acappon/DIY-MiniAirboat/IdeasForOrganization/00_PitchDeck.pptx

MISSION OVERVIEW

•

High-Performance Everglades Workboat

JON-AIR rev8: Built for Everglades Night Hunting

3.5s Hole Shot & Water-Level Eye Line

Low engine placement unlocks visibility under overhanging sawgrass banks where pythons nest.

165 HP ROTAX 850 E-TEC

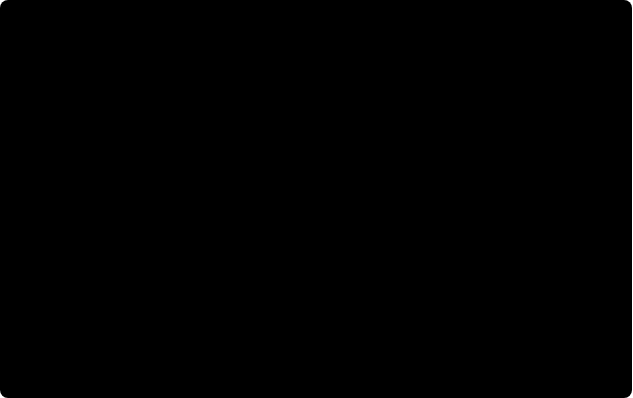
[picture p5: figure]
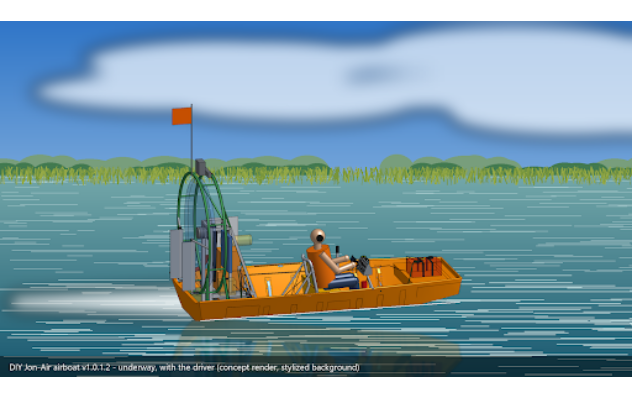
[picture p6: figure]

Full Armor UHMW Plastic Bottom for Zero-Stick Sliding

Ergonomic Helm Control Box

Integrated lanyard kill switch, searchlight joystick, USB charging, and dual temperature/gas gauges.

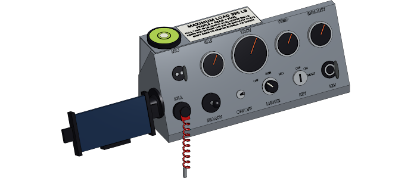
[picture p7: figure]

## Slide 2

The Collaborative Build Model & Economics

By pooling sweat equity and buying materials directly, builders acquire military-grade workboats at half retail cost.

COOPERATIVE MODEL

~$16K

MATERIAL COST / HULL

~200 hrs

DIY BUILD LABOR

GoFundMe

OVERHEAD SUBSIDIES

$35K+

COMMERCIAL VALUE

Equity Through Efficiency

Volunteers and founders combine baseline hardware purchasing with ~200 DIY build hours. No commercial manufacturer markups or corporate margins.

Pooled Overhead Protection

GoFundMe proceeds absorb legal entity formation, D&O governance protection, and workshop Commercial General Liability (CGL) insurance policies.

## Slide 3

Build Origin: Starting with a Used 1448 Jonboat Hull

Baseline Aluminum Shell

Purchased used to keep initial capital low before stripping for stringer and armor integration.

STEP 01 FABRICATION

Target Outcome: rev8 Airboat

Adding 6061 aluminum stringers, Rotax 850 engine stand, stick steering, and UHMW armor bottom.

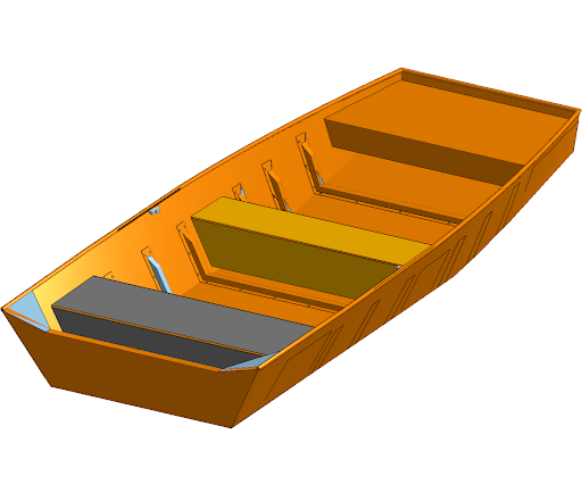
[picture p8: figure]
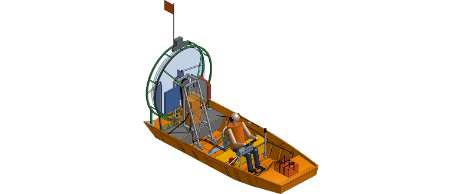
[picture p9: figure]

## Slide 4

Tracking Labor & Money: Guaranteed Returns

Fixed-estimate task valuations guarantee fair title allocation or Batch 2 credit rollover.

MASTER LEDGER SYSTEM

Top-Down Layout Blueprint

Internal stringer grid & tank placement driving task estimates.

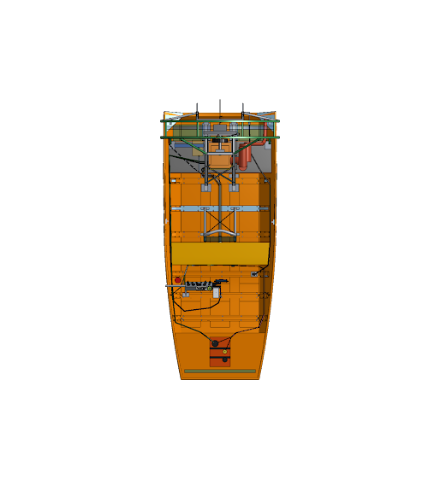
[picture p10: figure]

1. Fixed-Estimate Task Valuation

Build hours are pre-set by task complexity (e.g., 50 hrs for stringer welding). Fast completion is rewarded; slow work yields zero extra credit.

2. Full Vessel Ownership vs. Rollover

Anchor builders (~200 DIY hrs + material deposit) receive refined production hulls (#2, #3, #4). Micro-contributors roll credits into Batch 2 or gear/fleet days.

3. Outsource Option

Participants may satisfy any task module by submitting receipts for approved professional vendor work.

## Slide 5

JOIN THE INITIATIVE

Help Build the Everglades Fleet

Sign the Operating Agreement, claim a shop build slot, or back the GoFundMe campaign to fund baseline hardware.

Join Build Crew

Back GoFundMe

## Slide 6

Questions?

Jon-Air rev8 Enterprise LLC

Everglades Invasive Species Management & Python Hunting Cooperative Build Program
