acappon/DIY-MiniAirboat/IdeasForOrganization/02_PilotOrganizationProspectus.pdf

# JON-AIR (REV8) COST & UTILITY PROSPECTUS

## Investment Analysis, Workboat Performance, and Sweat-Equity Return

## EQUITY THROUGH EFFICIENCY

By shifting from commercial turn-key manufacturing to a self-assembled cooperative build, participants unlock a

high-performance, purpose-built Everglades workboat at direct cost—combining ~200 fixed DIY labor hours with

baseline material funding.

### 1. INDIVIDUAL & SHARED UNIT ECONOMICS

COST / RESOURCE
COMPONENT

PER-BOAT
ESTIMATE

DESCRIPTION & ALLOCATIONS

### Raw Materials & Hardware

~$16,000

1448 aluminum Jonboat hull, Rotax 850 E-TEC powerplant, UHMW bottom plating, rigging, controls, and aluminum stringers.

### DIY Labor Commitment

~200 Hours

Fixed-estimate hours allocated across structural welding, hull plating, engine rigging, and electrical wiring.

### Fixed LLC Overhead

Pooled
Overhead

Shared legal formation, D&O entity protection, shop Commercial General Liability (CGL) insurance, and state filings.

### Turn-Key Market Equivalent

$35,000+

Commercial custom airboats of equal power and plating carry heavy markup and lack python-specific low-CG ergonomics.

### 2. WHAT YOUR INVESTMENT DELIVERS: PERFORMANCE & UTILITY

Low⁻Center⁻of-Gravity Line⁻of-Sight

Mounting the Rotax 850 engine low and utilizing a

straddle bench places the hunter’s eye line near water

level. This delivers unmatched visibility under bank

overhangs and dense sawgrass canopy where pythons

hide.

UHMW Armor & 117° Hard Chine

Continuous plastic bottom plating slides effortlessly

over sawgrass, mud flats, and cypress knees without

sticking. The 117-degree hard chine delivers razor-

sharp tracking through tight marsh tracks.

3.5s Hole Shot & High Speed

The 165 HP-class Rotax 850 E-TEC provides an

immediate ~3.5-second hole shot to get on plane

instantly in shallow water, with top speeds exceeding

30 mph for fast transit between priority search zones.

Silent Drift & Oar Ergonomics

Equipped with integrated heavy-duty oar locks,

allowing hunters to shut down the engine and silently

drift stealth corridors without spooking skittish

wildlife along riverbanks.

### 3. RETURN ON SWEAT EQUITY

Every logged build hour converts into direct equity credit based on pre-established task values. Builders earn

ownership of a military-grade, purpose-built Everglades workboat at roughly half the retail market cost, backed by

a clear cooperative framework.

Jon-Air rev8 — Cost, Utility & Pilot Prospectus | Page 1 of 2

# THE PILOT BATCH & FOUNDER LOGIC

## GoFundMe Defrayment Model, Prototype Allocation, and Intellectual Credit

### 4. THE PILOT PROJECT & GOFUNDME FUNDING STRATEGY

To launch the initial Pilot Batch, the LLC initiates a public GoFundMe drive alongside volunteer recruitment. The

GoFundMe campaign serves a critical financial role for the founding cohort:

Defraying Cohort Material Costs

Crowdfunded capital directly offsets the baseline

~$16K material cost for the pilot cohort, lowering the

out-of-pocket cash threshold required from early

builders and volunteers.

Funding Fixed Overhead & Insurance

GoFundMe proceeds absorb necessary entity setup

costs, legal review expenses, and workshop liability

insurance policies, keeping individual contributions

focused on hardware.

### 5. FOUNDER EQUITY & PROTOTYPE ALLOCATION RULES

The original founder supplies the core intellectual property, vessel design, operational methodology, and fundraising

leadership. The LLC Operating Agreement recognizes these contributions through explicit structural rules:

PARTICIPANT ROLE | CONTRIBUTION FOCUS | VESSEL & CREDIT ALLOCATION TERMS

### Original Founder & Campaign Runner

| Concept, CAD design, LLC
| architecture, GoFundMe
| fundraising effort | Receives credit for IP, organization, and capital raised (even
| | with reduced cash or zero DIY labor hours). Allocated Boat
#1 (The Prototype) upon batch completion.

### Anchor Builders (Pilot Cohort)

| Material funding balance + 200
| DIY task hours per hull | Receive fully refined production hulls (#2, #3, #4) coming
| | off the finalized batch line once all prototype testing gates
| | pass.

### Micro-Contributors

| Partial labor hours or small cash
| donations | Earn Batch 2 queue deposits, gear payouts, or fleet time-
| | share credits (no direct title to pilot hulls).

### 6. THE PROTOTYPE ALLOCATION RATIONALE

## WHY THE FOUNDER TAKES THE PROTOTYPE (BOAT #1)

The first boat built serves as the testbed—enduring stress trials, modifications, bracket tweaks, and initial field

testing. Although it absorbs signficant design iteration (making it the "janky prototype"), the original founder takes

full ownership of Boat #1 upon final batch distribution. This ensures that the volunteer builders who perform the

200 DIY hours receive the fully refined, production-perfect hulls coming off the line afterward.

### 7. SUMMARY OF PILOT RIGHTS & PROTECTIONS

Fairness to Builders

Builders are protected: their labor produces polished,

proven production models while their financial entry

point is subsidized by GoFundMe campaign proceeds.

Fairness to Founder

The founder's vision, legal setup, design IP, and

fundraising drive earn full vessel equity without

requiring equal shop wrenching time.

Jon-Air rev8 — Cost, Utility & Pilot Prospectus | Page 2 of 2
