acappon/DIY-MiniAirboat/rev8_JonAirBoat/renderedImages/Minimal_800R_layout_v1.0.1.3.png

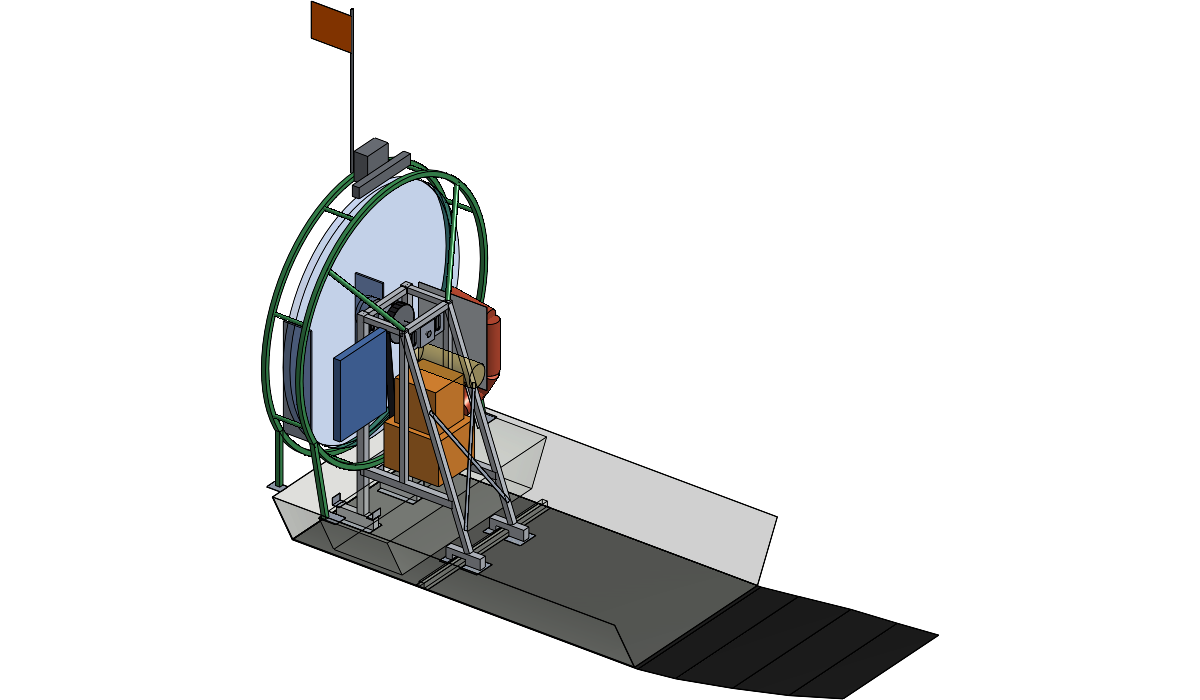
rev8_JonAirBoat/renderedImages/Minimal_800R_layout_v1.0.1.3.png
