acappon/DIY-MiniAirboat/rev8_JonAirBoat/renderedImages/Minimal_cockpit_v1.0.1.3.png

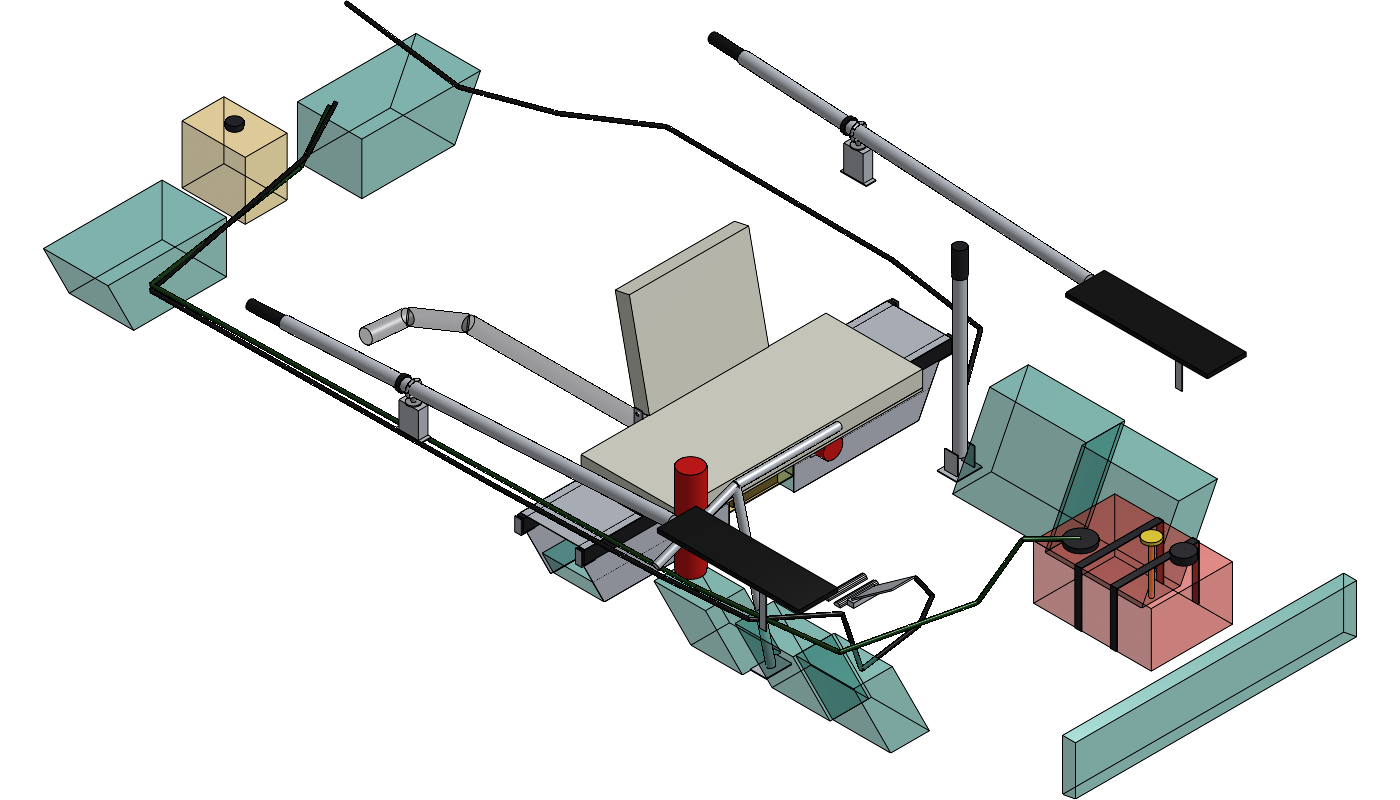
rev8_JonAirBoat/renderedImages/Minimal_cockpit_v1.0.1.3.png
