acappon/DIY-MiniAirboat/rev8_JonAirBoat/renderedImages/scenes/dock_rowing.png

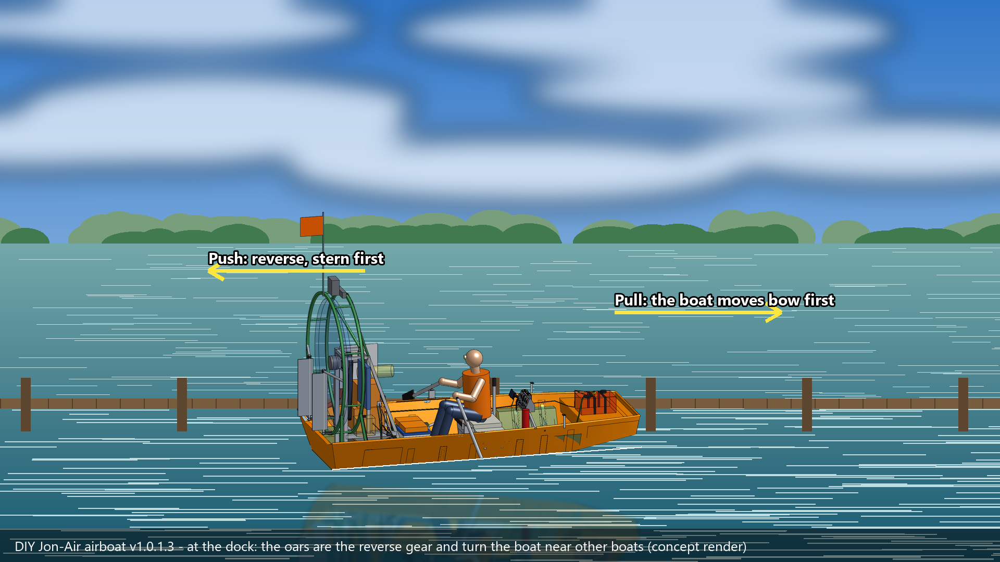
rev8_JonAirBoat/renderedImages/scenes/dock_rowing.png
