acappon/DIY-MiniAirboat/rev8_JonAirBoat/renderedImages/scenes/snake-hunt_rowing.png

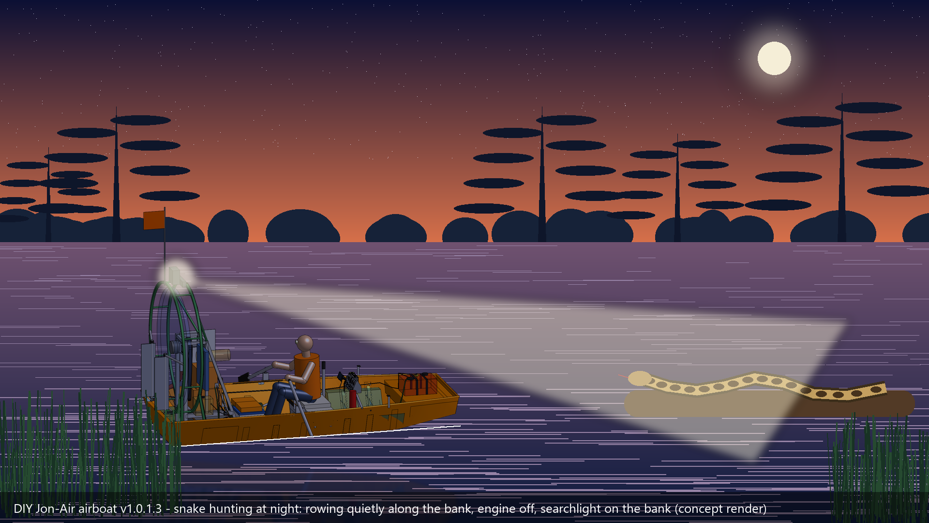
rev8_JonAirBoat/renderedImages/scenes/snake-hunt_rowing.png
