acappon/DIY-MiniAirboat/rev8_JonAirBoat/renderedImages/scenes/top-speed_solo.png

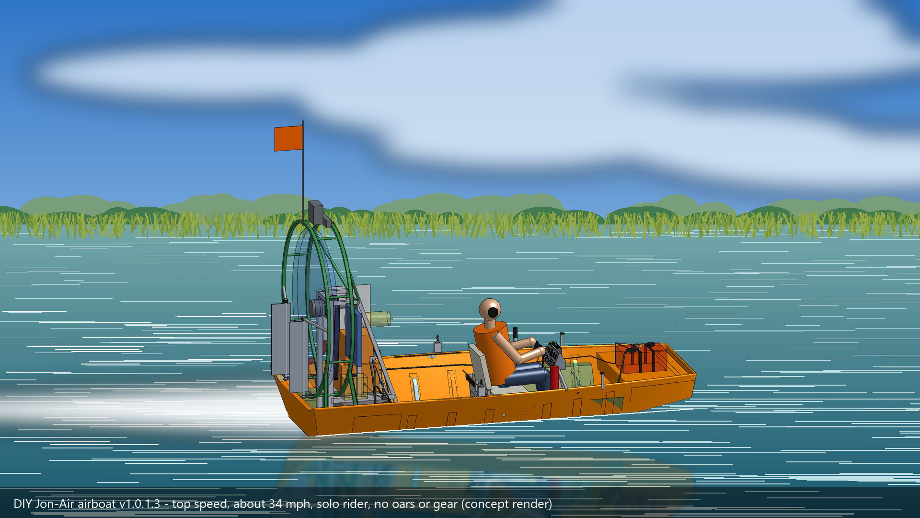
rev8_JonAirBoat/renderedImages/scenes/top-speed_solo.png
