acappon/DIY-MiniAirboat/rev8_JonAirBoat/renderedImages/scenes/underway-25mph_gear.png

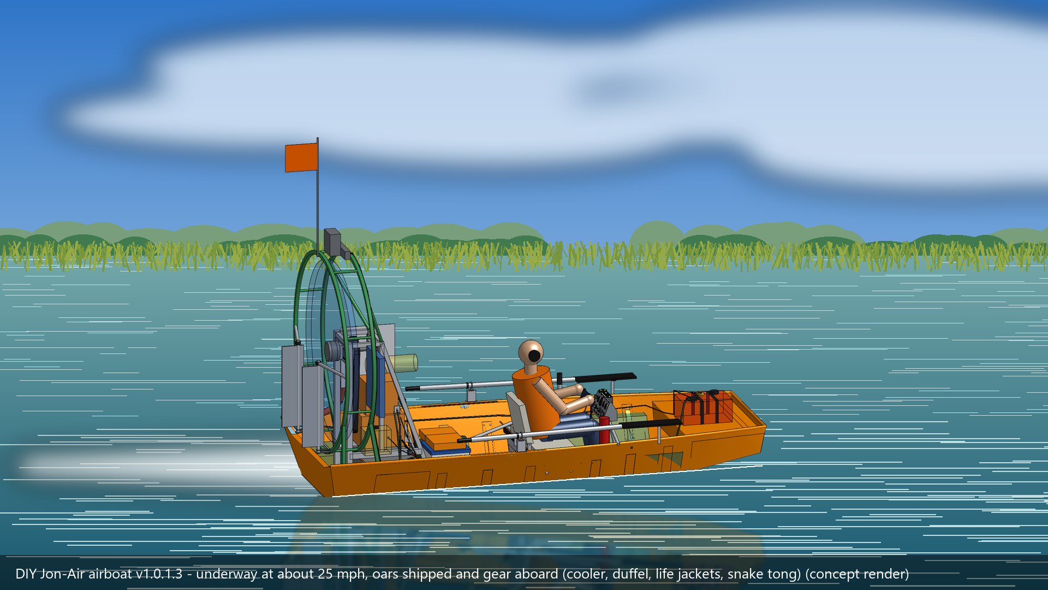
rev8_JonAirBoat/renderedImages/scenes/underway-25mph_gear.png
