acappon/DIY-MiniAirboat/rev8_JonAirBoat/renderedImages/studio/v1_front-starboard-3-4-view_no-crew.png

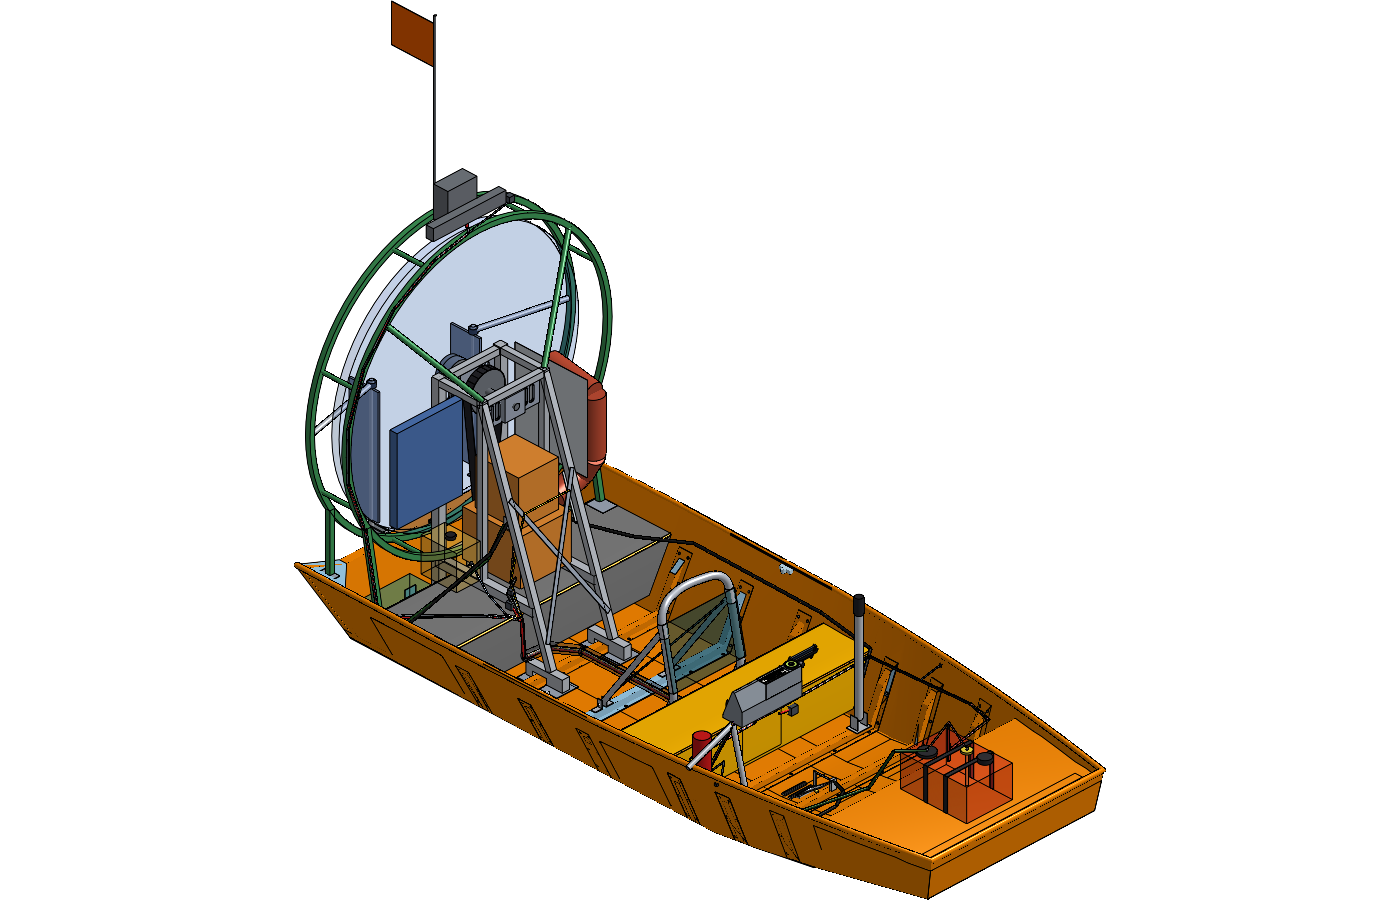
rev8_JonAirBoat/renderedImages/studio/v1_front-starboard-3-4-view_no-crew.png
