acappon/DIY-MiniAirboat/rev8_JonAirBoat/renderedImages/studio/v2_rear-port-3-4-view_no-crew.png

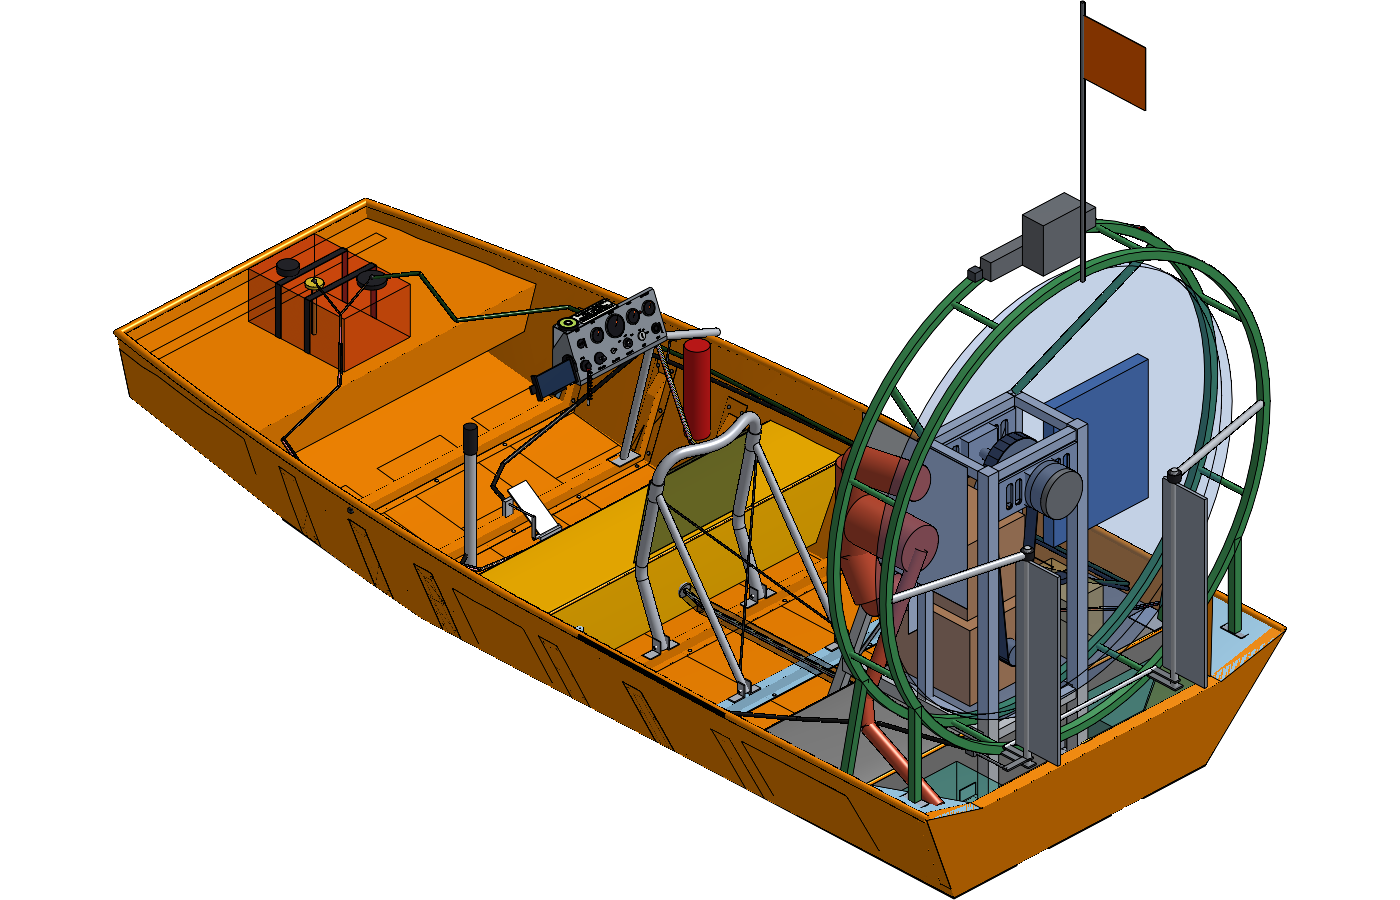
rev8_JonAirBoat/renderedImages/studio/v2_rear-port-3-4-view_no-crew.png
