acappon/DIY-MiniAirboat/rev8_JonAirBoat/renderedImages/studio/v3_starboard-profile_no-crew.png

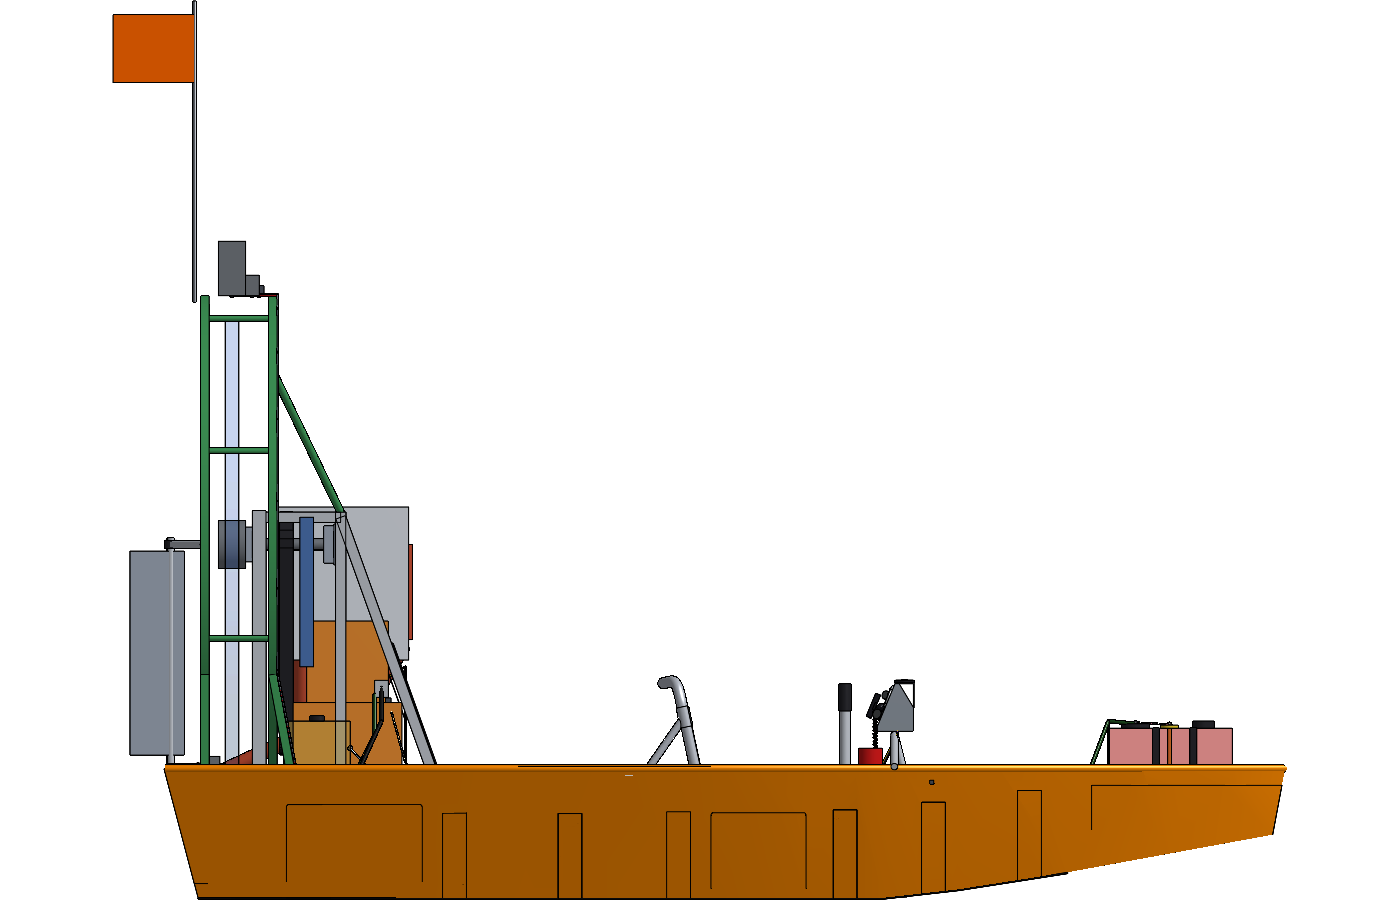
rev8_JonAirBoat/renderedImages/studio/v3_starboard-profile_no-crew.png
