acappon/DIY-MiniAirboat/rev8_JonAirBoat/renderedImages/studio/v4_top-view_no-crew.png

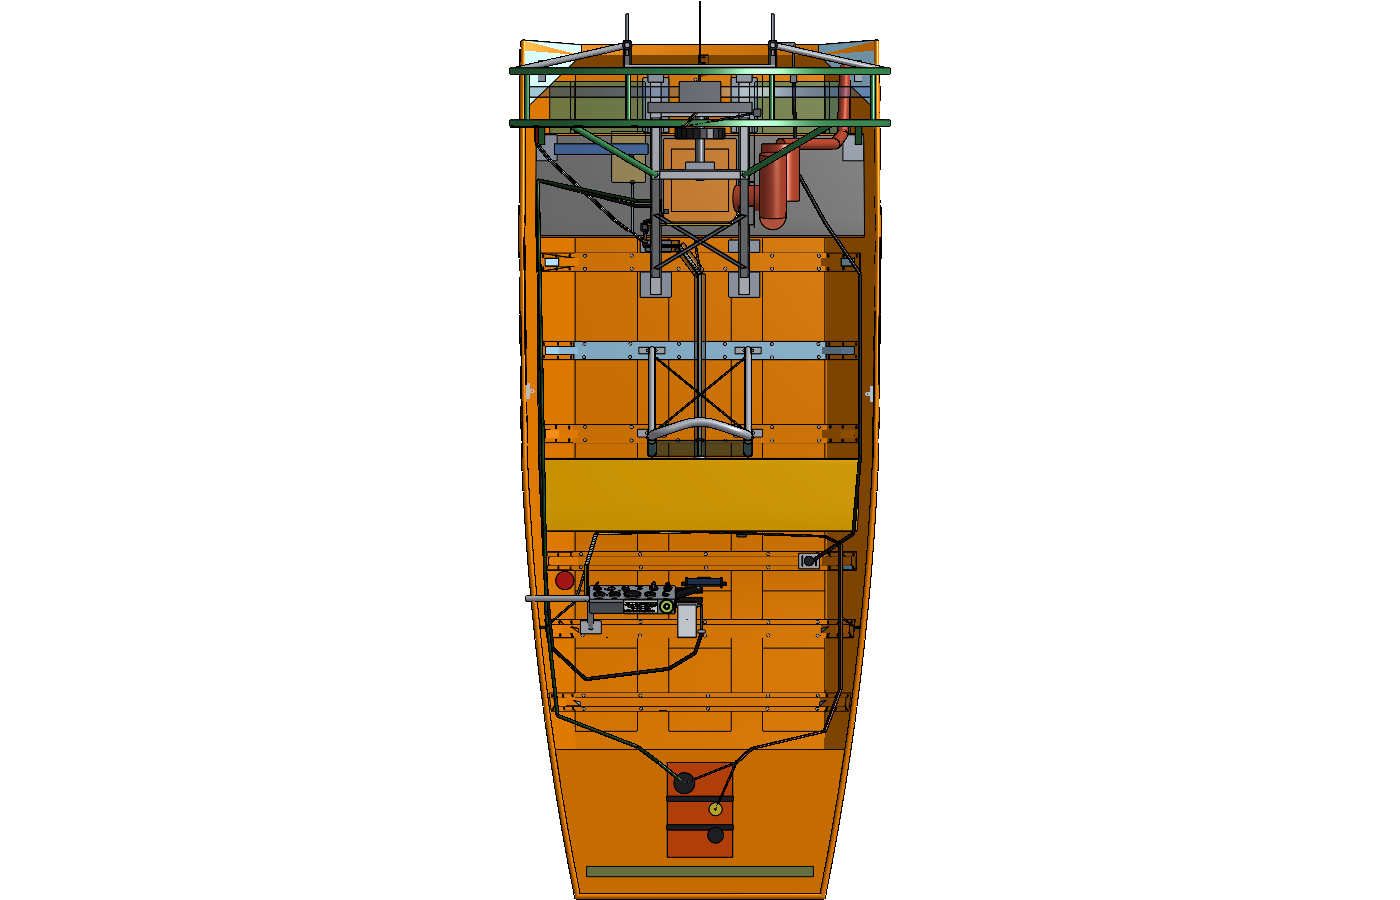
rev8_JonAirBoat/renderedImages/studio/v4_top-view_no-crew.png
