acappon/DIY-MiniAirboat/rev8_JonAirBoat/renderedImages/studio/v5_low-front-starboard-view_no-crew.png

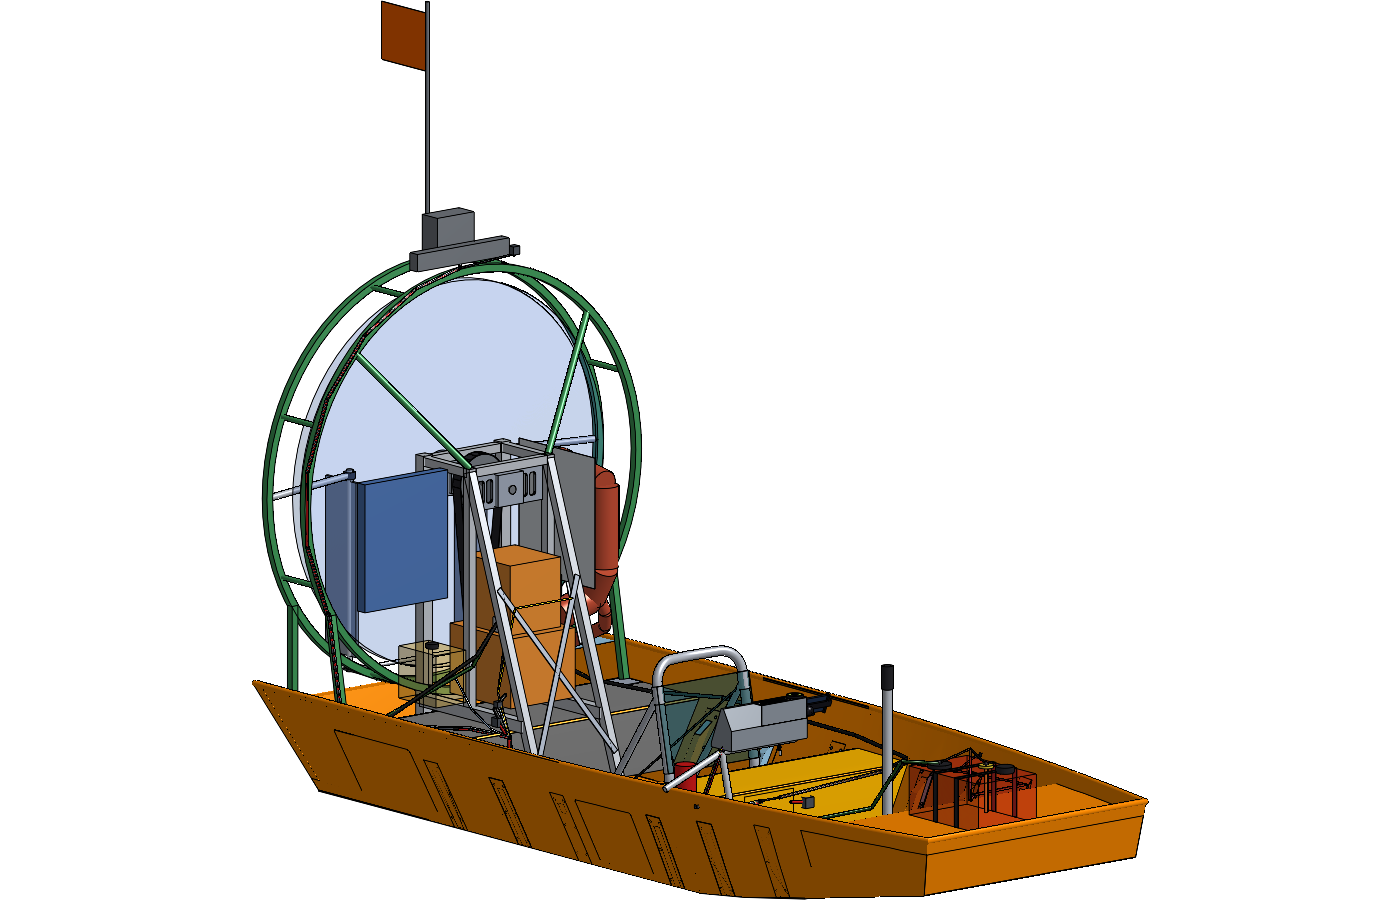
rev8_JonAirBoat/renderedImages/studio/v5_low-front-starboard-view_no-crew.png
