acappon/DIY-MiniAirboat/rev8_JonAirBoat/renderedImages/studio/v8_dash_driver-pov.png

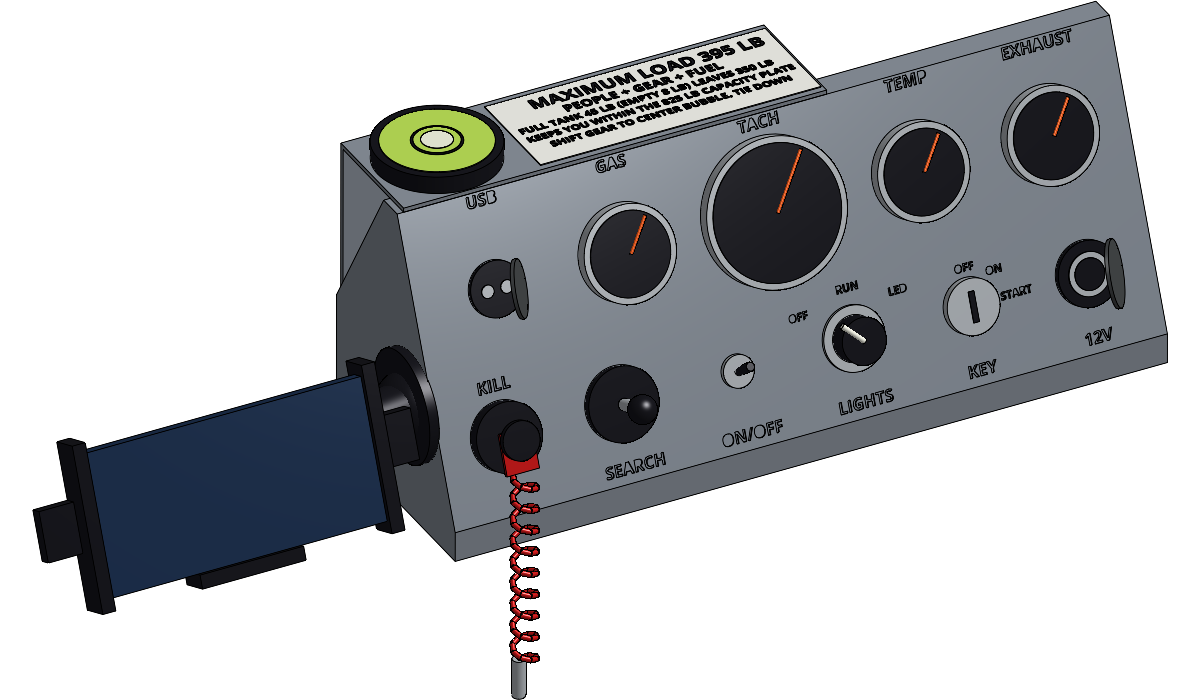
rev8_JonAirBoat/renderedImages/studio/v8_dash_driver-pov.png
