acappon/DIY-MiniAirboat/StraddleDart_rev7/Marketing/img/01.webp

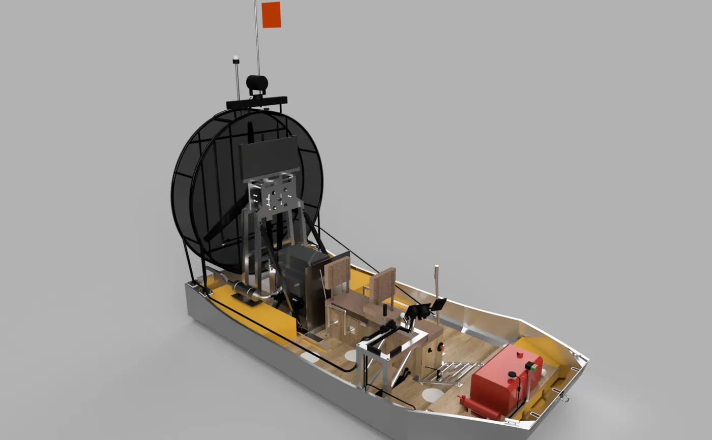
StraddleDart_rev7/Marketing/img/01.webp
