acappon/DIY-MiniAirboat/StraddleDart_rev7/Marketing/img/01_cutout.webp

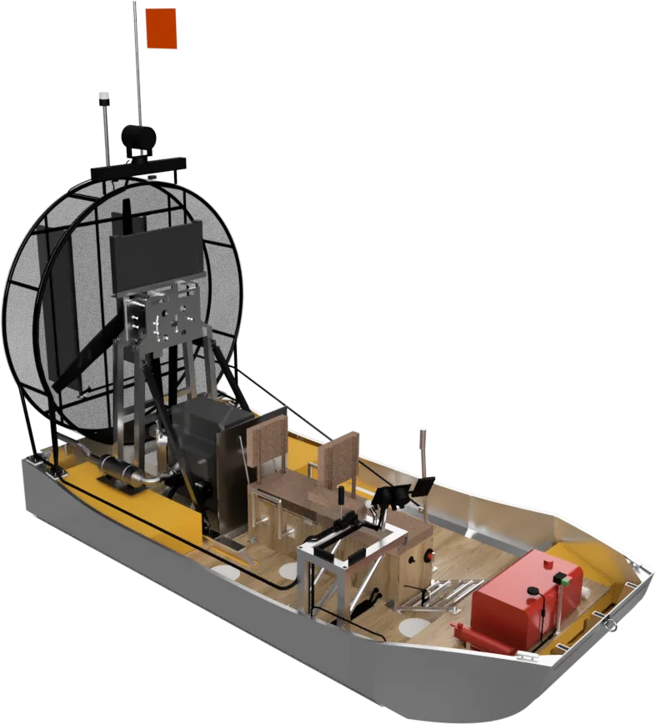
StraddleDart_rev7/Marketing/img/01_cutout.webp
