acappon/DIY-MiniAirboat/StraddleDart_rev7/Marketing/img/02.webp

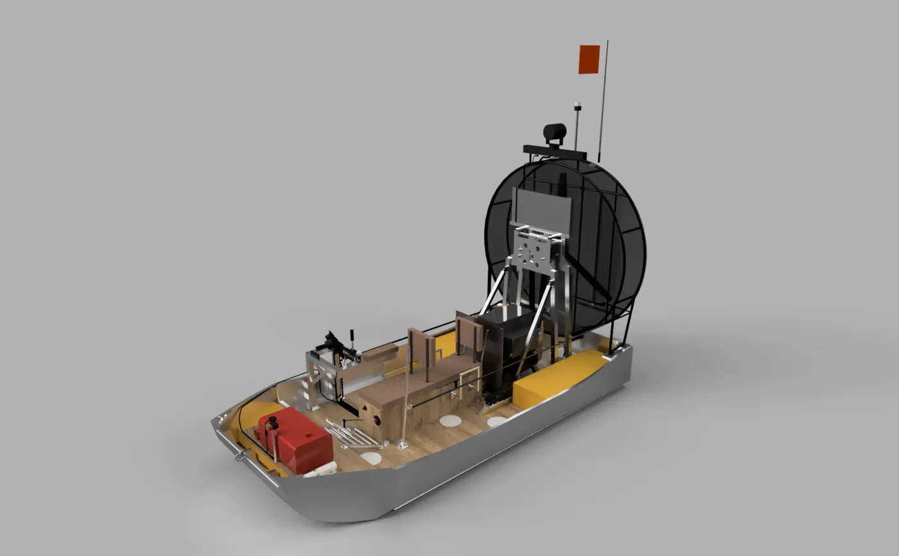
StraddleDart_rev7/Marketing/img/02.webp
