acappon/DIY-MiniAirboat/StraddleDart_rev7/Marketing/img/03.webp

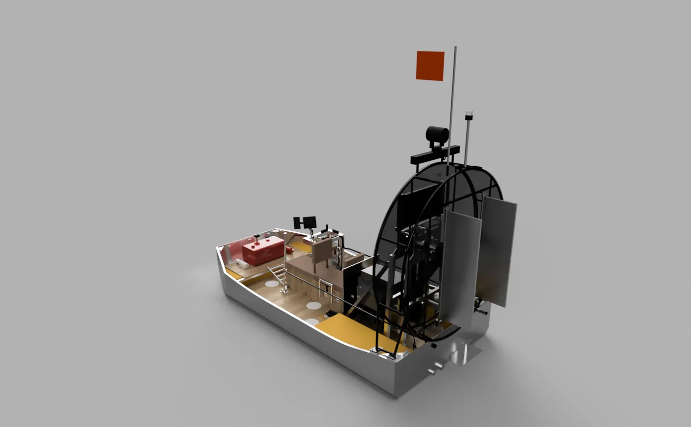
StraddleDart_rev7/Marketing/img/03.webp
