acappon/DIY-MiniAirboat/StraddleDart_rev7/Marketing/img/04.webp

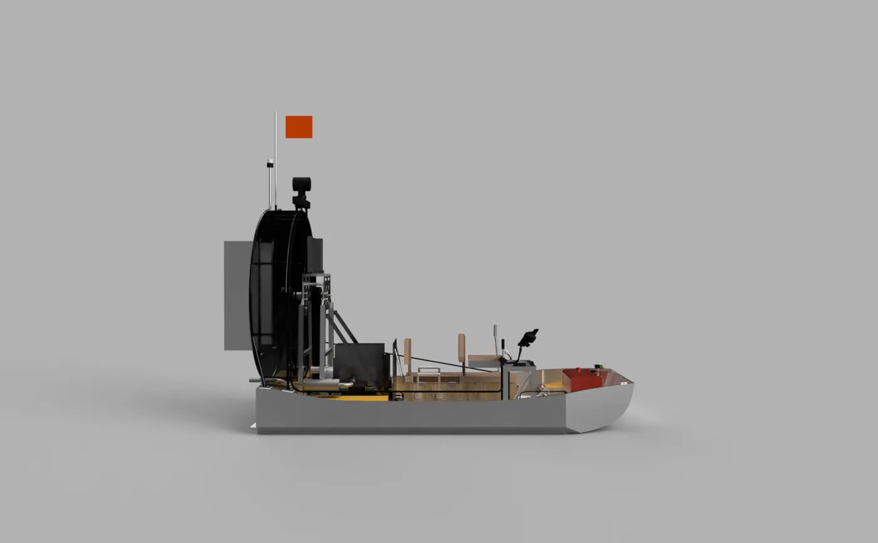
StraddleDart_rev7/Marketing/img/04.webp
