acappon/DIY-MiniAirboat/StraddleDart_rev7/Marketing/img/05.webp

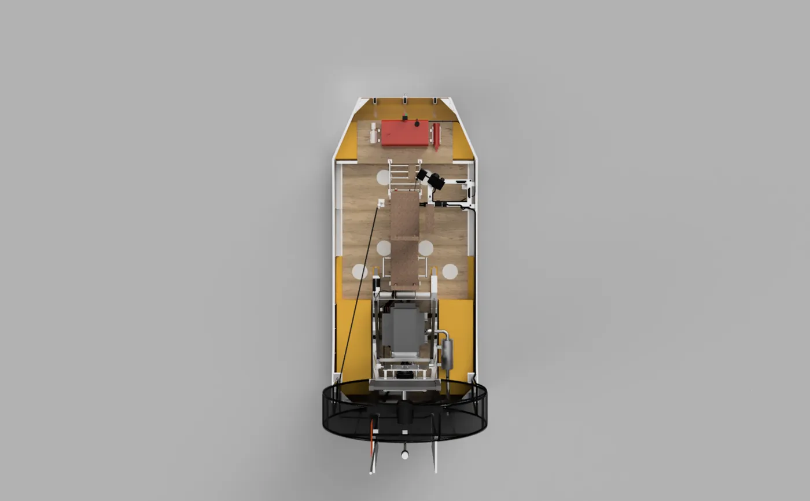
StraddleDart_rev7/Marketing/img/05.webp
