acappon/DIY-MiniAirboat/StraddleDart_rev7/Marketing/img/07.webp

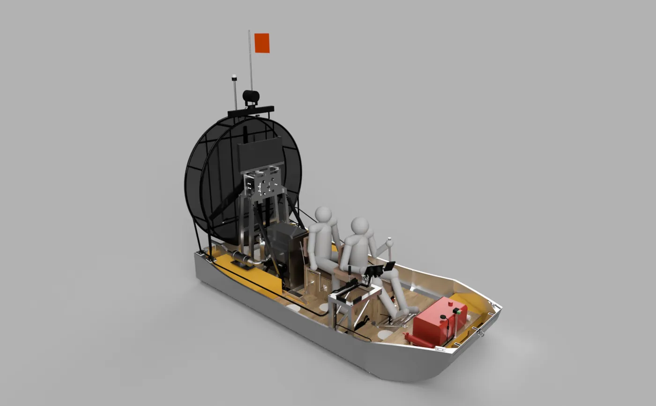
StraddleDart_rev7/Marketing/img/07.webp
