acappon/DIY-MiniAirboat/StraddleDart_rev7/Marketing/img/08.webp

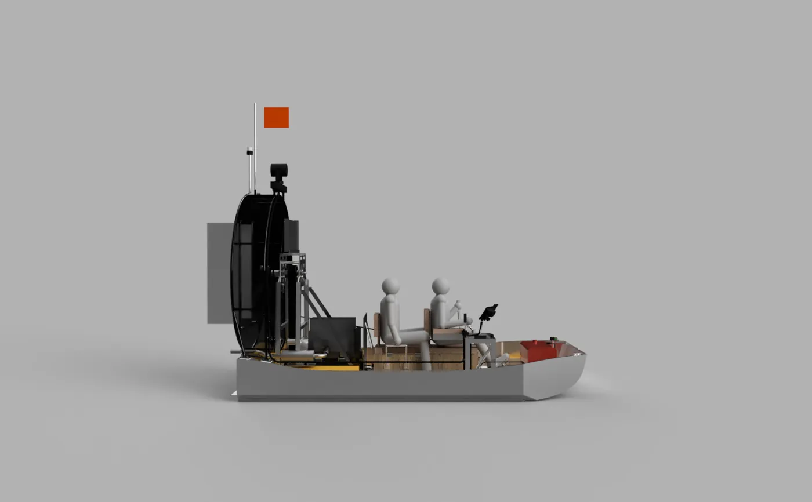
StraddleDart_rev7/Marketing/img/08.webp
