acappon/DIY-MiniAirboat/StraddleDart_rev7/Marketing/img/09.webp

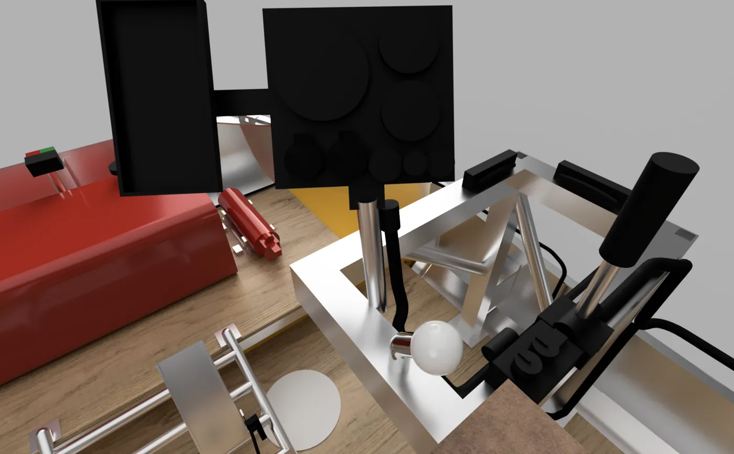
StraddleDart_rev7/Marketing/img/09.webp
