acappon/DIY-MiniAirboat/StraddleDart_rev7/Marketing/img/10.webp

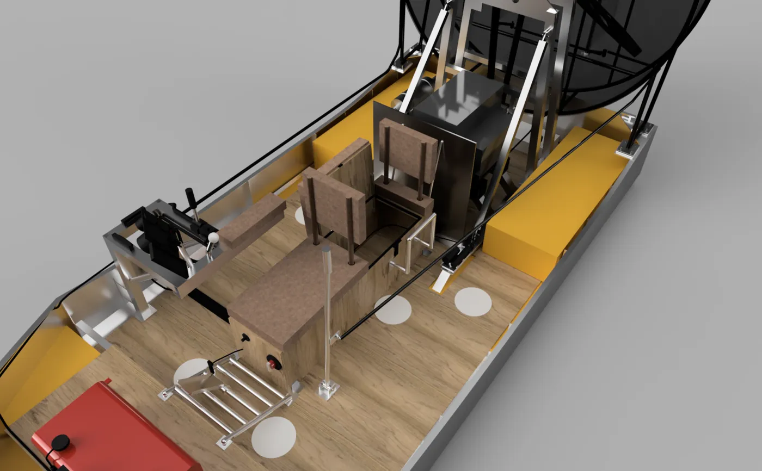
StraddleDart_rev7/Marketing/img/10.webp
