acappon/DIY-MiniAirboat/StraddleDart_rev7/Marketing/img/11.webp

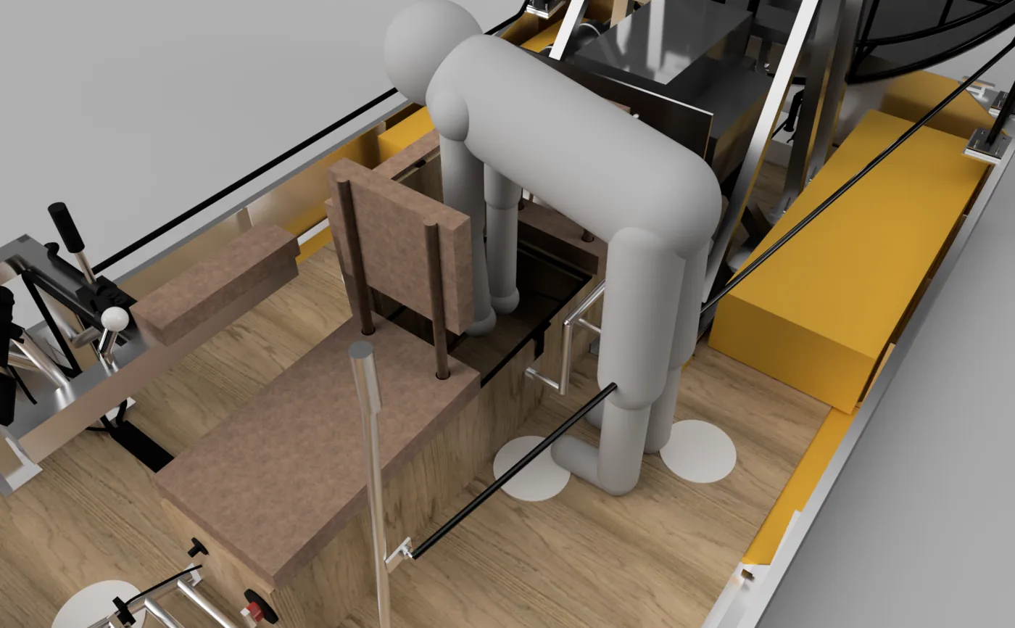
StraddleDart_rev7/Marketing/img/11.webp
