acappon/DIY-MiniAirboat/StraddleDart_rev7/Renders/photo/09_Driver_eye_view_grip_and_dash.png

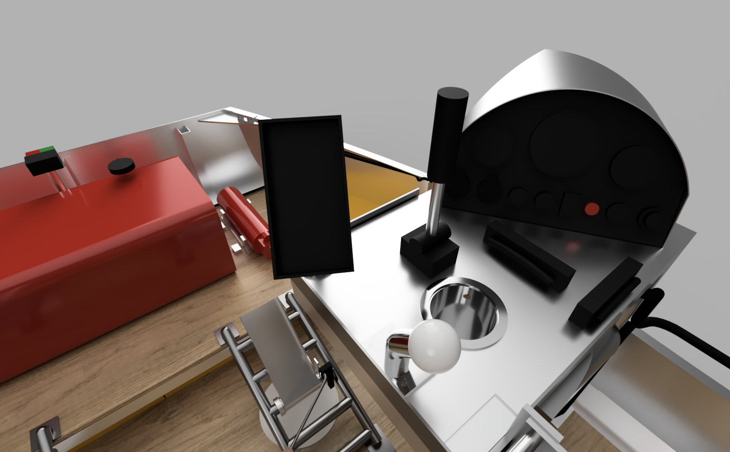
StraddleDart_rev7/Renders/photo/09_Driver_eye_view_grip_and_dash.png
