acappon/DIY-MiniAirboat/StraddleDart_rev7/Renders/photo/11_Cooler_open_reaching_in.png

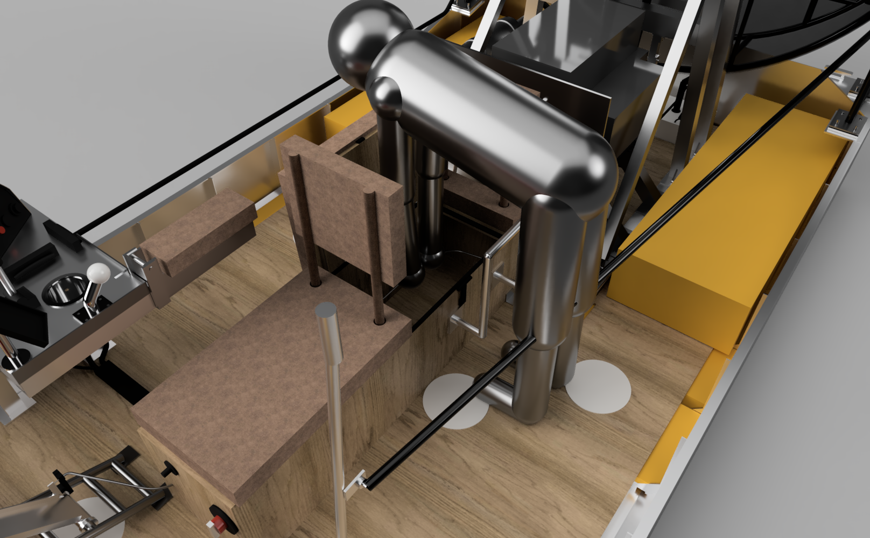
StraddleDart_rev7/Renders/photo/11_Cooler_open_reaching_in.png
