acappon/DIY-MiniAirboat/StraddleDart_rev7/Renders/previews/01_Front_34_starboard.png

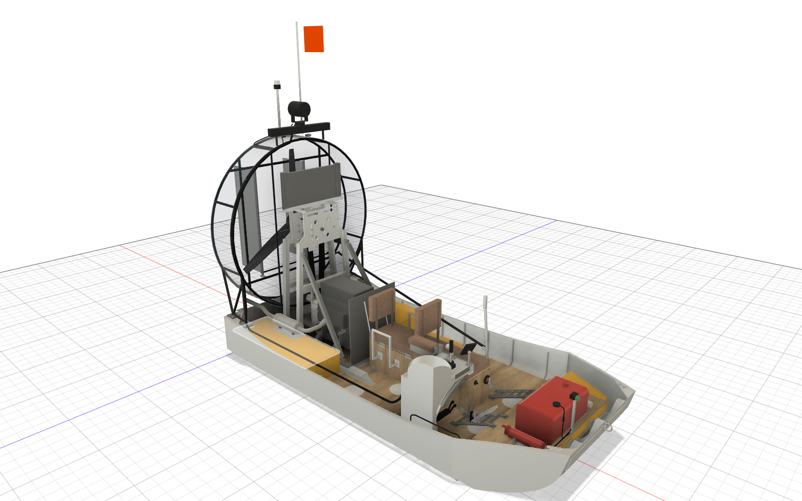
StraddleDart_rev7/Renders/previews/01_Front_34_starboard.png
