acappon/DIY-MiniAirboat/StraddleDart_rev7/Renders/previews/02_Front_34_port.png

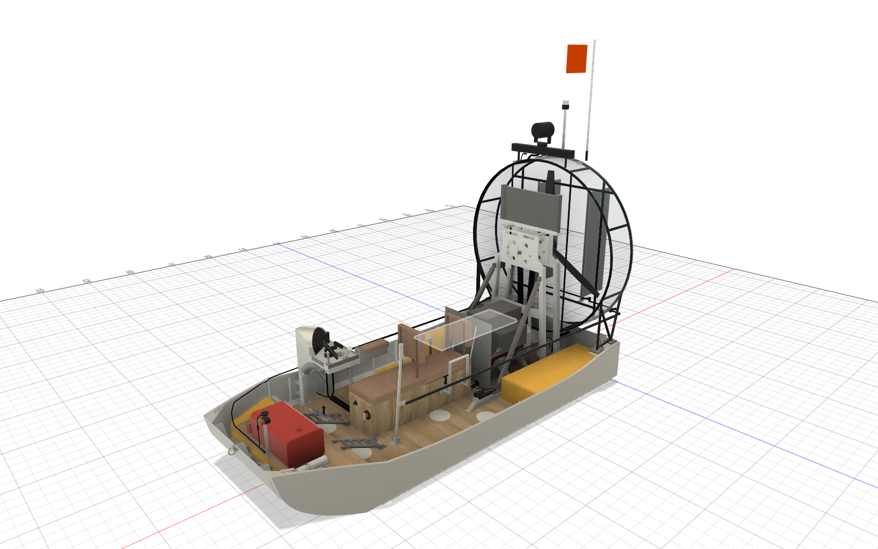
StraddleDart_rev7/Renders/previews/02_Front_34_port.png
