acappon/DIY-MiniAirboat/StraddleDart_rev7/Renders/previews/03_Aft_34_port.png

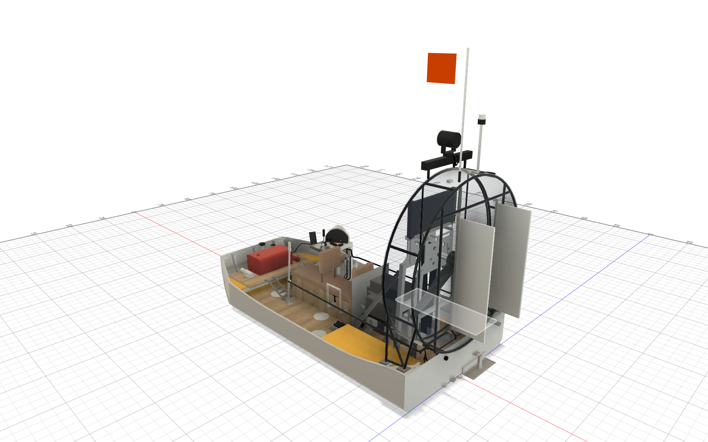
StraddleDart_rev7/Renders/previews/03_Aft_34_port.png
