acappon/DIY-MiniAirboat/StraddleDart_rev7/Renders/previews/04_Starboard_profile.png

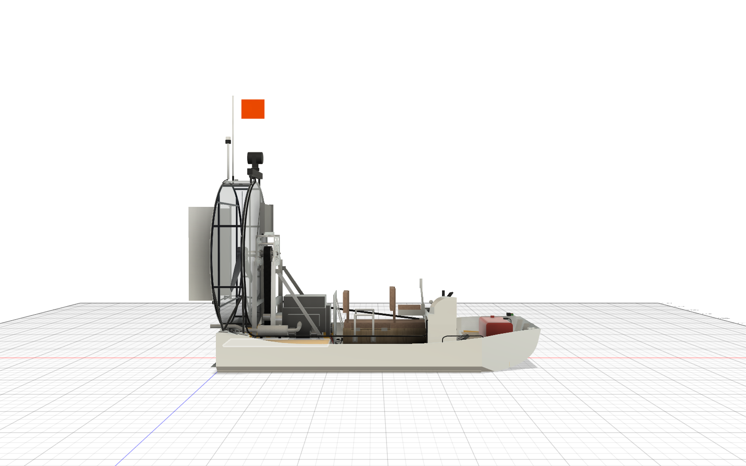
StraddleDart_rev7/Renders/previews/04_Starboard_profile.png
