acappon/DIY-MiniAirboat/StraddleDart_rev7/Renders/previews/05_Top.png

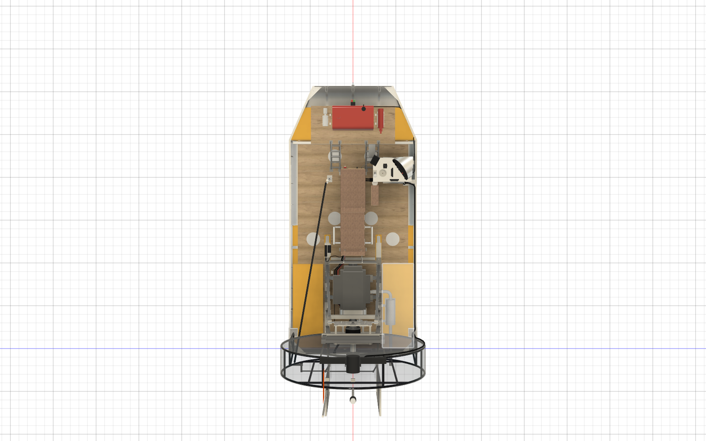
StraddleDart_rev7/Renders/previews/05_Top.png
