acappon/DIY-MiniAirboat/StraddleDart_rev7/Renders/previews/06_Front_34_with_driver.png

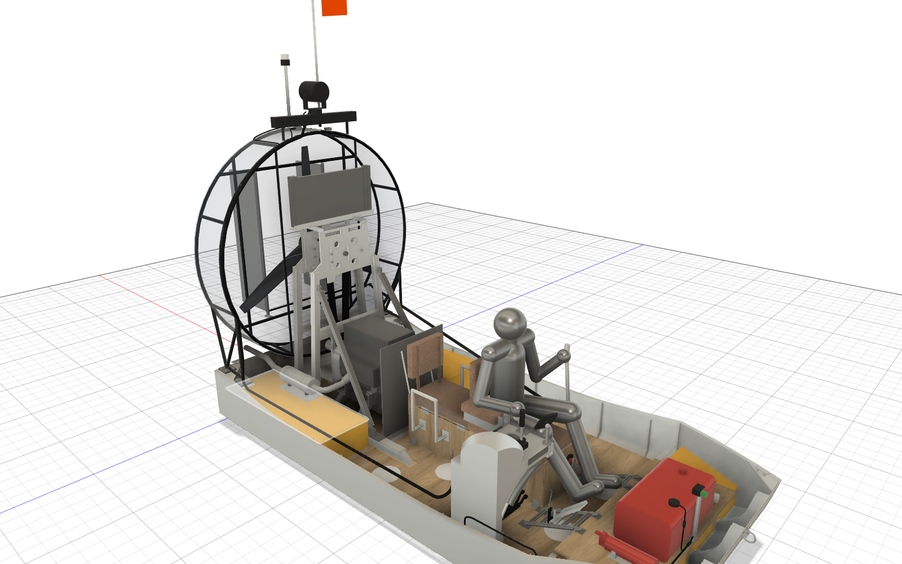
StraddleDart_rev7/Renders/previews/06_Front_34_with_driver.png
