acappon/DIY-MiniAirboat/StraddleDart_rev7/Renders/previews/08_Profile_driver_and_passenger.png

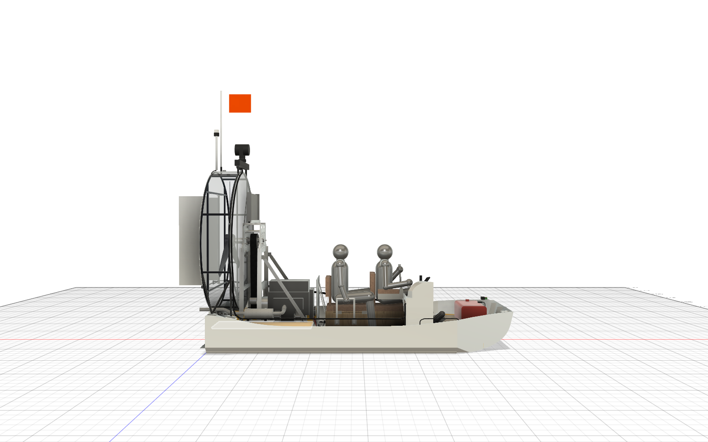
StraddleDart_rev7/Renders/previews/08_Profile_driver_and_passenger.png
