acappon/DIY-MiniAirboat/StraddleDart_rev7/Renders/previews/10_Cooler_open.png

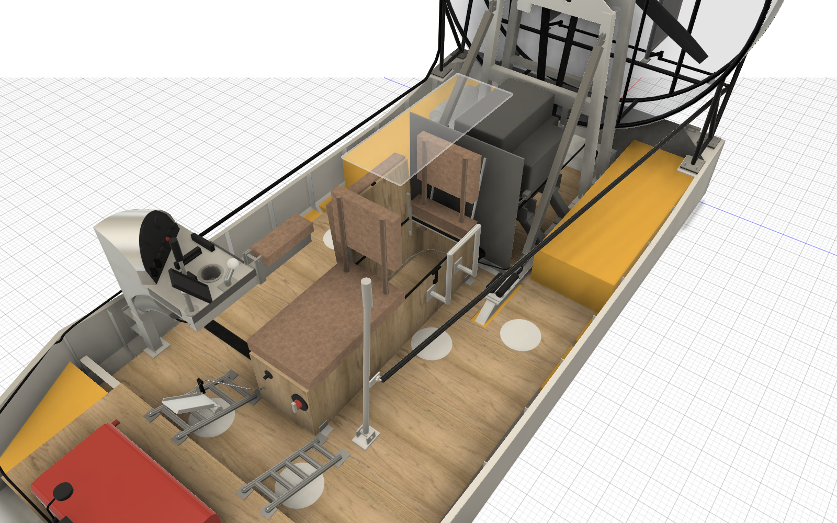
StraddleDart_rev7/Renders/previews/10_Cooler_open.png
