acappon/DIY-MiniAirboat/StraddleDart_rev7/BOM_rev7.xlsx

Sheet: Summary
Straddle Dart — BOM summary, rev 7 (riveted aluminum hull)
Totals pull from the three BOM tabs. Change quantities, prices or weights there; change the contingency in B11.
Group | Est. cost ($) | Weight (lb) | Weight in CAD (lb) | Weight not in CAD (lb)
Hull
Drivetrain
Everything else
Subtotal
Contingency (shipping, tax, mistakes, extras)
Contingency rate | 15% | Assumption: 15% of materials; edit as needed
Estimated materials total
Weight check
Empty boat, CAD model (no fuel or crew) | 1160.0 | lb, rev 7 estimate: rev 6 trim analysis (1,038.8) plus the rev 7 changes in this workbook
BOM weight in CAD (should match)
Difference
Empty boat incl. items not in CAD
Labor and the fab shop shear/brake service are not included here; see DIY-Mini-Airboat_Build-Guide_Aluminum.xlsx.
Supplier links appear only where a supplier was discussed during design.

Sheet: Hull
Straddle Dart — Hull BOM (riveted aluminum) (rev 7)
Costs are 2026 USD estimates. Blue cells are inputs you can change; Est. cost = Qty x Unit cost. Weight is the installed line weight in lb.
Item | Use / spec | Qty | Unit | Unit cost ($) | Est. cost ($) | Weight (lb) | In CAD weight? | Supplier link | Notes
5052-H32 aluminum sheet 0.125 in, 60 x 144 in | Bottom halves with the 3 in chine bent in, bow rocker pieces, bow face | 3 | sheet | $625 |  | 135.6 | Y |  | Was 0.090: ISO 12215-5 check (Structural Checks 8c). Centerline seam over the center stringer; transverse butt seam with doubler at frame 120
5052-H32 aluminum sheet 0.063 in, 48 x 144 in | Side panels | 2 | sheet | $230 |  | 22.0 | Y
5052-H32 aluminum sheet 0.125 in, 24 x 72 in | Transom | 1 | sheet | $180 |  | 14.5 | Y
5052 strip 0.080 and 0.063 in, brake-formed into hat sections | 5 stringers, 2.5 in tall (0.080 for the two engine-bed stringers); 1 in cross-drain slot in each at x 3.5-4.5 | 1 | lot | $350 |  | 39.4 | Y |  | Bend to the rocker before riveting
6061 angle 1-1/2 x 1-1/2 x 1/8 in, 12 ft | 10 frames (x 12, 24, 36, 48, 60, 72, 84, 96, 111.5, 120 in) + transom frame | 7 | stick | $42 |  | 38.9 | Y |  | Frames at 60, 84 and 111.5 in added for the 0.125 bottom (ISO 12215-5). 1 x 3/4 in limber notch at the skin in every bay of every frame; deburr and prime the cut edges
6061 rectangular tube 2 x 3 x 1/8 in, 12 ft | Engine-bed box beams on the bed stringers | 1 | stick | $95 |  | 12.9 | Y
6061 angle 1 x 1 x 1/8 in, 12 ft | Rub rails / sheer clamps | 3 | stick | $25 |  | 6.4 | Y
6061 plate 1/4 in | Quarter knees and frame-12 gussets under the cage plates | 1 | lot | $40 |  | 3.6 | Y
6061 aluminum 1/4 in flat bar and plate | Engine bed plates 48 x 3 in (2), cage mount plates 4 x 4 in (4) | 1 | lot | $130 |  | 8.4 | Y |  | Drill beds 16 x 13/32 in at 3 in spacing
HDPE sheet 1/8 in, 12 x 24 in | Isolator strips under all aluminum plates | 1 | sheet | $25 |  | 1.5 | Y
5052-H32 sheet 1/8 in: two chine guards brake-formed to 135 deg (12.5 ft) + bent nose cap | Chine guard angles opened to 135 deg; bent nose cap | 1 | lot | $90 |  | 15.9 | Y |  | Guards brake-formed at the shop with the chine bends (were 6061 angles opened to 135 deg by hand)
UHMW 1/4 in sheet, 48 x 120 in | 4 bottom strips (splice over a frame) | 3 | sheet | $290 |  | 82.8 | Y |  | 3/16 in saves about 21 lb
Closed-end aluminum blind rivets 3/16 in (5052/5056, aluminum mandrel) | All skin laps and framing; double rows at about 3/4 in | 2400 | ea | $0.15 |  | 4.8 | N |  | Double rows: 3/4 in pitch on the bottom seams and chine laps, 1 in on laps above the waterline. Never open-end or steel-mandrel rivets
Seam sealant (Sikaflex 291 or 3M 4200), 10 oz tubes | Wet in every lap before riveting | 10 | tube | $15 |  | 4.0 | N
SS 1/4 in through-bolts, nylock nuts, sealing washers | UHMW strips through the bottom into the stringers | 200 | set | $0.80 |  | 3.0 | N |  | Bed in sealant; Tef-Gel on threads
Clecos 3/16 in (100) + pliers, drill bits, deburr tools | Tooling | 1 | lot | $150 |  | 0.0 | N
Self-etching primer | Faying surfaces and cut edges only; the hull stays bare 5052 (topcoat optional later) | 1 | lot | $60 |  | 1.0 | N
Rev 6 joint details
Bed plates lengthened to 52 in, new 10-hole pattern; knees/gussets drilled for cage-foot bolts | Net change from the detailed hull model | 1 | lot | $40 |  | 0.7 | Y |  | Hole positions in the fab workbook
Total
Weight included in the CAD model
Weight not in the CAD model (fasteners, paint, wiring)
CAD model weight for this group (reference) |  |  |  |  |  | 330.5 |  |  | From the CAD weight reports (hull r4.2, drivetrain r5, layout r6 + cage r2 + flotation r5)

Sheet: Drivetrain
Straddle Dart — Drivetrain BOM (rev 7)
Costs are 2026 USD estimates. Blue cells are inputs you can change; Est. cost = Qty x Unit cost. Weight is the installed line weight in lb.
Item | Use / spec | Qty | Unit | Unit cost ($) | Est. cost ($) | Weight (lb) | In CAD weight? | Supplier link | Notes
Suzuki G13B 1.3 L DOHC 16-valve engine, dressed | 1989-94 Suzuki Swift GT/GTi (US) or a JDM Cultus GT-i import; with flywheel, starter, alternator, intake, ECU and harness | 1 | ea | $1200 |  | 194.0 | Y | https://www.car-part.com | About 100 hp at 6,500 rpm, about 83 lb-ft. Weight is the CAD placeholder + 15 lb for the twin-cam head: verify weight and head clearances on the engine bought
Engine refresh kit | Gaskets, timing belt + tensioner, water pump, plugs, thermostat, oil and filter | 1 | kit | $320 |  | 0.0 | N
Fuel delivery | Electric pump, filter, fuel line, primer bulb, clamps | 1 | lot | $140 |  | 3.0 | N
Bellhousing adapter | 3/8 in 6061 plate + shroud, machined to the G13-family pattern (G13B), starter boss | 1 | ea | $160 |  | 11.0 | Y |  | Material + DIY machining; pattern from the real block
Flex coupling (jaw or donut type) | Torsional damper, flywheel to jackshaft; rated 150 lb-ft or more | 1 | ea | $130 |  | 1.3 | Y
Jackshaft 1-1/4 in 4140 + 2 bearings + housing | Takes belt pull off the crankshaft | 1 | lot | $170 |  | 4.4 | Y
HTD 8M pulley, 30 teeth, 85 mm, taper-lock + bushing | Drive pulley on jackshaft | 1 | ea | $140 |  | 5.7 | Y
HTD 8M pulley, 75 teeth, 85 mm, aluminum, taper-lock + bushing | Prop pulley between the bearings | 1 | ea | $330 |  | 7.5 | Y
HTD belt 2320-8M-85 (290 teeth) | Gates PowerGrip HTD or equal; 2.5 : 1 | 1 | ea | $190 |  | 3.0 | Y |  | Confirm width with Gates design data for the G13B (83 lb-ft, 6,500 rpm); may need a wider HTD belt or Poly Chain GT Carbon
Backside idler 3.5 in + bearing + pad bracket (optional) | Slack-side idler bolted to adapter | 1 | ea | $70 |  | 3.2 | Y |  | Fit only if ground runs show belt flap
Prop shaft 1-1/2 in 4140 pre-hardened (28-32 HRC), 20 in, keyed | Supported fore and aft | 1 | ea | $140 |  | 9.8 | Y |  | Pre-hardened for gyroscopic bending in hard turns; carry thrust on a shoulder or clamped collar, not set screws alone
Flange bearing 1-1/2 in, 4-bolt | One in each yoke plate | 2 | ea | $55 |  | 9.0 | Y
Prop flange / hub adapter | Machined to the Warp Drive HPL hub pattern | 1 | ea | $140 |  | 3.8 | Y
Tension yoke: 3/8 in 6061 plates + 1 in tie tubes | Carries both bearings; pivots as one piece | 1 | lot | $170 |  | 13.3 | Y
1/2 in grade 8 bolts + lock nuts; 1/2-13 jack screw + block | Pivot (2), arc slot (4), jack screw | 1 | lot | $45 |  | 2.0 | Y
6061 square tube 2 x 2 x 1/8 in | A-frame legs and aft crossbar | 17 | ft | $9.00 |  | 16.1 | Y
6061 plate 3/8 in, 24 x 30 in | Two gusset-shaped peak plates with lightening holes | 1 | ea | $210 |  | 20.0 | Y
6061 plate 1/4 in | A-frame and brace feet (6) | 1 | lot | $40 |  | 2.6 | Y
6061 tube 1-1/2 x 1-1/2 x 1/8 and 1 x 1 in | Diagonal braces (2) and adapter tie struts (2) | 16 | ft | $8.00 |  | 7.1 | Y
Engine mount: steel bracket + polyurethane bushing | Bolted to engine-bed plates at x = 30 and 42 in | 4 | ea | $35 |  | 15.3 | Y
Warp Drive 64R-TX-HPL3 propeller | 64 in, 3 carbon blades, HPL hub, ground-adjustable, R rotation | 1 | ea | $1395 |  | 18.0 | Y | https://warpdriveinc.com/product/3-bld-prop-hpl-hub/ | Price from Warp Drive page; confirm rotation, hub pattern and weight before ordering. G13B: pitch for 6,000-6,300 rpm at full throttle standing still
Leading-edge protection tape (stoneguard) | Blade leading edges | 1 | kit | $60 |  | 0.0 | N |  | Warp Drive's nickel edge is the $390 alternative
Honda Civic radiator (junkyard) + hoses, clamps, coolant, overflow bottle | Above the hub, in front of the prop | 1 | lot | $140 |  | 20.0 | Y |  | Civic radiator suits engines of about 100 hp; watch coolant temperature on a long static run
Radiator cradle rails + straps | On the peak plates | 1 | lot | $35 |  | 0.8 | Y
Exhaust: mandrel bends, flex section, muffler, wrap, heat shields | Low starboard; tailpipe over transom below the prop disk | 1 | lot | $280 |  | 16.0 | Y
Throttle cable + return spring | Pedal to throttle body | 1 | lot | $60 |  | 1.0 | N
Rev 6 joint details
A-frame details: slotted leg tops, 1/8 caps, foot gussets, mitred crossbars | 6061 drops; TIG | 1 | lot | $60 |  | 0.0 | Y |  | Weight included in the A-frame line below
Brace clevises: 1/4 tongues and tab pairs, 3/8 grade 8 bolts + nylocks (4) | Removable braces | 1 | lot | $45 |  | 0.0 | Y
Tie-strut tabs + 5/16 bolts (4) | Adapter to crossbar | 1 | lot | $20 |  | 0.0 | Y
Engine mounts: 6061 cradles (4), steel engine-side brackets (4), DOM sleeves, poly bushings 1.75 OD x 1/2 ID (4), 1/2 grade 8 through-bolts (4) | Engine-side holes to suit the real block | 1 | lot | $160 |  | 0.0 | Y |  | Measure the G13B mount bosses before drilling the engine-side brackets
Radiator: lower angle, 2 rubber grommets, 2 x 3/8 top stays with rubber bushings |  | 1 | lot | $45 |  | 0.0 | Y
Exhaust: flex section, 2 rubber isolators, 2 SS band clamps, 6061 hanger brackets, tailpipe saddle + pad |  | 1 | lot | $95 |  | 0.0 | Y
Bed-plate bolts 3/8 SS + nylocks + Tef-Gel (20) | All feet and pads | 20 | ea | $1.50 |  | 0.0 | Y
Net weight of the rev 6 drivetrain details (CAD) | Reconciles to the detailed drivetrain model | 1 | lot | $0.00 |  | 14.8 | Y
Total
Weight included in the CAD model
Weight not in the CAD model (fasteners, paint, wiring)
CAD model weight for this group (reference) |  |  |  |  |  | 385.4 |  |  | From the CAD weight reports (hull r4.2, drivetrain r5, layout r6 + cage r2 + flotation r5)

Sheet: Everything else
Straddle Dart — Everything else BOM: cage, rudders, steering, seating, controls, flotation, electrical, safety (rev 7)
Costs are 2026 USD estimates. Blue cells are inputs you can change; Est. cost = Qty x Unit cost. Weight is the installed line weight in lb.
Item | Use / spec | Qty | Unit | Unit cost ($) | Est. cost ($) | Weight (lb) | In CAD weight? | Supplier link | Notes
Prop cage
Steel DOM tube 1 in x 0.083 in (yield 50 ksi or better) | Two cage hoops, 72.4 in dia (about 19 ft each) | 40 | ft | $6.00 |  | 30.9 | Y |  | Was 1 x .049: the hoops carry rudder, steering and screen loads in bending (Structural Checks)
Tube rolling service | Roll two 72.4 in DOM hoops | 1 | job | $150 |  | 0.0 | Y |  | Muffler or fab shop
Steel DOM tube 1 in x 0.065 in (yield 50 ksi or better) | Cage legs, base rails, rudder rails, 8 longitudinals, aft screen bars, 2 side-bay diagonals | 46 | ft | $5.00 |  | 29.8 | Y |  | Longitudinals and aft bars were EMT; diagonals added (Structural Checks)
EMT conduit 1/2 in, 10 ft sticks | Front screen bars (2) | 2 | stick | $10 |  | 3.3 | Y |  | Grind off zinc before welding; ventilate
Hardware cloth 1/2 in, 19 ga galvanized, 36 in x 50 ft | Front, aft and side screens | 1 | roll | $120 |  | 17.3 | Y |  | Keep 4.7 in or more from any moving part
Shaft guard sleeve | Fixed sleeve where the shaft passes the front screen | 1 | ea | $15 |  | 0.2 | Y
Welding wire, gas, paint for cage |  | 1 | lot | $120 |  | 0.0 | N
Rudders and steering
Aluminum honeycomb panel 20 mm, 4 x 8 ft | Two rudders 14 x 44 in | 1 | sheet | $380 |  | 11.9 | Y | https://www.chalcoaluminum.com/knowledge/sandwich-panel/#Honeycomb | Price is an estimate; request a quote
Aluminum U-channel 3/4 in, hinge tube 1 in x 0.083 in, horns | Rudder edges and hinges; seal all edges | 1 | lot | $90 |  | 5.6 | Y
Hinge brackets and bushings | On the 1 in rudder rails | 4 | ea | $10 |  | 0.0 | N
Steering linkage: 2 aft horns, tie bar and drive link (5/8 x .065 steel, 4 rod ends), bellcrank (1/4 steel, 3.5 / 4 in arms) on a 3/8 x 1.5 steel bracket welded to the aft hoop, 1 x .065 DOM long rod (8.5 ft) with 2 rod ends, 3/8 SS pins | Rudders to the left-hand steering lever; every link straight and pinned at both ends | 1 | lot | $190 |  | 8.8 | Y |  | Replaces the dog-legged pushrod, which would have bent (Structural Checks, finding 1); notch the aft screen mesh round the bracket
Seating, controls, fuel, battery
Marine plywood 3/8 in, 4x8 | Floor, transom to x = 121 in, 64 in wide | 5 | sheet | $110 |  | 61.7 | Y |  | Bolt-down panels resting on the stringer tops (aft panel included); 6.5 in cutouts for deck plates
Marine plywood 1/2 in, 4x8 | Straddle bench box and bow shelf | 1 | sheet | $150 |  | 33.3 | Y
Bench lids and seals: Al ledge ring + EPDM gasket + 6 SS bolts into clip nuts (battery bay); 2 SS hinges, 2 locking lid stays, rubber T-latch, 1 in drain plug (cooler) | Sealed battery bay forward; gasketed dry storage / cooler aft | 1 | lot | $160 |  | 4.0 | Y |  | Cooler lid hinges on the starboard top corner, opens about 95 deg
Seat foam + marine vinyl | Three cushions: driver (removable, over the battery lid), passenger (on the cooler lid), aft fixed | 1 | lot | $170 |  | 4.0 | Y
Removable backrests | Driver and passenger | 2 | ea | $55 |  | 10.0 | Y
Passenger grab handles | Both sides of the bench; loop 10.5 in off centre, top bar 20 in up (clears the cooler lid) | 2 | ea | $22 |  | 3.0 | Y
Expanded-metal engine guard | Between passenger and engine front | 1 | ea | $60 |  | 5.0 | Y
Footrest, two foot ladders (6061 solid 1 in rod, welded) | Left rails 7.5 and 12.5 in to port, right rails 7.5 and 14.5 in to starboard; 5 rungs each at x 105.5-117.5 in, rising 22.7 deg to the bow shelf; 8 foot plates 3/16 | 1 | ea | $70 |  | 6.5 | Y |  | A landing for each foot like motorcycle pegs; the throttle pedal clamps to any right-ladder rung
Throttle pedal assembly, rung-mounted | Clamps to any rung of the right foot ladder (centred 10.75 in to starboard); cable arm, torsion return spring, rest stop | 1 | ea | $75 |  | 2.2 | Y |  | Rung 3 suits an average adult
Steering lever + pivot | Port side, left hand; 1.5 in outboard of the original position (clear of the left knee) | 1 | ea | $70 |  | 7.0 | Y
Padded grab bar | Starboard, right hand at 42 in | 0 | ea | $55 |  | 0.0 | Y |  | Replaced by the rev 7 driver station (see below)
Portable fuel tank 6.6 gal + fuel line and primer bulb | Strapped on the bow shelf | 1 | lot | $120 |  | 4.5 | Y |  | Fuel itself (40 lb full) not counted
Battery, Group 31 AGM about 100 Ah, dual purpose + tray and strap | Battery bay at the front of the bench, under the driver | 1 | ea | $300 |  | 68.0 | Y |  | Sealed AGM; reserve for the 12 V outlet with the engine off
Adjustable trim tab (DIY aluminum) | 18 x 6 in, starboard half of transom | 1 | ea | $60 |  | 4.0 | Y
Flotation, sump, pump
Two-part pour foam, 2 lb/cu ft closed-cell urethane, about 8 cu ft per kit | 24 removable blocks: thin blocks under the floor aft of x = 72 in (5.1 cu ft) and under the bow shelf (4.4 cu ft), poured in molds or in each bay on a release-lined tray | 2 | kit | $115 |  | 19.0 | Y |  | Urethane only (gasoline resistant); nothing bonded to the aluminum
Coroplast 4 mm 4 x 8 sheets + polyurea or epoxy seal coat | Bottom tray and sealed skin on every block | 1 | lot | $100 |  | 3.7 | Y |  | Sealed skin slows water uptake
HDPE sheet 1/2 in, 12 x 24 in | 54 spacer pads 1.5 x 1.5 in, glued to block bottoms (1/2 in drained channel) | 1 | sheet | $35 |  | 2.1 | Y
Two-part pour foam kit + covers and straps | Removable side blocks (6.4 cu ft), molded to fit; they give the swamped boat its stability | 1 | lot | $215 |  | 12.8 | Y |  | Must be strapped in whenever the boat is used
Screw-out deck plates, 6 in | Inspection ports in the floor (8) | 8 | ea | $14 |  | 3.6 | Y |  | Plastic, gasketed
FRP grating panel, 1 in, made into a raised box | Removable grate box over the open sump (pump is taller than the low floor) | 1 | ea | $60 |  | 2.5 | Y
Automatic bilge pump about 1,100 gph + float switch | In the open transom sump | 1 | ea | $90 |  | 2.5 | Y
Through-hull, discharge hose, clamps | Discharge at 14 in on the transom | 1 | lot | $35 |  | 1.0 | Y
Transom self-bailer with check valve, 1.5 in | Bottom of sump | 1 | ea | $45 |  | 0.5 | Y |  | Must have a working check valve
Transom drain plug, 1 in (plastic or aluminum) | Lowest point of the sump; pull on the trailer after every trip | 1 | ea | $12 |  | 0.2 | Y |  | Not brass (galvanic)
Pump cycle counter or hour meter on the float-switch circuit | Leak early warning | 1 | ea | $25 |  | 0.0 | N
Waterproof bilge switch (auto / off / manual), fused | On the transom top, reachable from the water when the boat is swamped | 1 | ea | $35 |  | 0.0 | N |  | Pump runs from the battery inside the sealed bench
Floor fasteners: SS screws into rivnuts + closed-cell gasket tape | Bolt-down floor panels (hold the blocks down when swamped) | 1 | lot | $60 |  | 0.0 | N
Electrical and safety
Terminals, adhesive heat shrink, cushion clamps, zip ties |  | 1 | lot | $80 |  | 5.0 | N |  | Wire itself is itemised in the rev 7 electrical lines
Dash instruments: electric tach 3-3/8 in, water temp and fuel gauges 2-1/16 in, key switch, red trouble light, lanyard kill switch |  | 1 | lot | $250 |  | 3.3 | Y
Navigation lights (sidelights + all-round white) | Needed for night running | 1 | set | $90 |  | 2.0 | N
Safety gear: 2 PFDs, throwable cushion | Carried gear | 1 | lot | $160 |  | 0.0 | N |  | Not counted in boat weight; extinguisher and horn are listed in rev 7
Registration and title fees |  | 1 | lot | $75 |  | 0.0 | N |  | Estimate; check your state's rules
Rev 6 joint details
Cage feet: 1/4 steel pads drilled, HDPE isolators, 3/8 SS bolts (16) | Bolted through the hull plates and knees | 1 | lot | $70 |  | 0.0 | Y
Rudder pivots: 1/2 bolts (4), tapped plugs (4), UHMW thrust washers (4); 3/8 rod ends (3) + bolts |  | 1 | lot | $85 |  | 0.0 | Y
Backrest sockets 1-1/4 x .065 (4) + straps; handle flanges and backing plates |  | 1 | lot | $60 |  | 0.0 | Y
Bench clips (4), battery tray + strap, steering pivot base + bushings, engine-guard angle + stays (ladder foot plates: see the footrest line) |  | 1 | lot | $120 |  | 0.0 | Y
Bow shelf: aft angle at frame 120, front angle + 3 stringer clips, 4 padeyes + 2 cam straps | Shelf enlarged to x 118.5-140.2 | 1 | lot | $70 |  | 0.0 | Y
Net weight of the rev 6 cage and layout details (CAD) | Reconciles to the detailed models | 1 | lot | $0.00 |  | 10.3 | Y
Rev 7: driver station, lights and searchlight, bench, electrical system, deck hardware, safety gear
Driver side frame weldment, 6061 | 2 x 2 x 3/16 sq tube posts, top rail and cross arms (14 ft); 2 x 3 x 3/16 inner rail (3 ft); 1-1/2 x .188 round tube knee braces (rolled to about 19 in radius) and diagonal (8 ft); 3/8 clips; 1/4 base and backing plates | 1 | lot | $340 |  | 23.1 | Y |  | Bolts to frame x96 and backing plates on the hull side; braces bowed 2.5 in outboard for a large leg; 3/16 walls for the 600 lb hand-hold (Structural Checks)
Console top, skins and dash hood, 5052 | 1/8 in top (13 x 21 in); 0.063 in front and outboard skins; 0.063 in hood (visor, cheeks, arched top) folded and riveted; grommets for the dash loom and bow loom | 1 | lot | $180 |  | 7.0 | Y |  | Hood and top screwed with tamper-proof Torx; gauge and switch backs sealed inside
Console fiddle rail, 6061 flat bar 1/8 x 1-1/2 | Raised 1/2 in edge on the aft, inboard and forward edges of the console top (about 29 in); riveted to the cross arms and inner rail; top edges rounded | 1 | lot | $15 |  | 0.5 | Y |  | Keeps small things from rolling or sliding off, like a galley table
Knee brace pads | 1 in closed-cell foam (minicell) on both braces, UV-treated PU-coated 1000D Cordura or marine vinyl cover, Velcro or laced seam | 2 | ea | $30 |  | 0.3 | Y |  | Replaceable covers; plain nylon Cordura fades in Florida sun
Life-jacket hook, 316 stainless | J-hook riveted inside the outboard skin, 22 in up, 2.4 in reach | 1 | ea | $12 |  | 0.2 | Y |  | Keeps a PFD in the sheltered cabinet, clear of the side diagonal
Swamped-boat warning labels | 6 x 4 in UV-laminated marine vinyl, printed from Labels/Swamped_Warning_Label.svg | 3 | ea | $8 |  | 0.1 | N |  | Helm (console top, by the capacity label) and inside each side of the bench; stability report Finding 1
Cup holder, drop-in, drained | Stainless or nylon, 3.4 in bore, 2.75 in deep (shallow over the thigh) | 1 | ea | $20 |  | 0.3 | Y |  | Just forward of the grip
Armrest, hinged | Aft 13 in of the 2 x 3 inner rail on a 1/2 in 316 pin through 1/4 in lugs and a U-bracket on the aft cross arm; pad 1/2 in ply, 2 in foam, marine vinyl; detent pin for the up position | 1 | lot | $85 |  | 4.5 | Y |  | Swings up and aft 95 deg so the driver can get into the seat; rests on the bracket end plate when down
Grip (hand-hold), Hurst T-handle | 1-1/8 in 316 SS rod, cold-drawn (A276 Condition B), bent, welded to a 3 x 2 x 1/4 in 316 base plate; 4 x 1/4 in 316 bolts through the console top and both rail walls with crush tubes, Tef-Gel and a gasket; Hurst 1530040 universal T-handle, polished cast aluminium (new about $62-68, or used on eBay), bar across the boat, threaded straight onto an M16 x 1.5 stud turned on the stick end (no adapter), 316 M16 x 1.5 nylon-insert lock nut under the neck, 1/4 in 316 cross pin | 1 | ea | $140 |  | 2.0 | Y |  | Stainless cannot be welded to the 6061 rail; stick and plate sized for 600 lbf; the Hurst handle on its pinned M16 stud is rated 450 lb (Structural_Checks); T-handle position from drv_reach. The Hurst handle is a shift knob: the pin stops a hard sideways pull from unscrewing it. Pull-test the finished grip before use
Transom stiffener, 6061 flat bar 3/8 x 2 in | Vertical, riveted to the transom inside face behind the trim-tab bracket, bottom frame angle to rub rail (15.3 in) | 1 | ea | $15 |  | 1.1 | Y |  | Carries the tab adjuster pull (about 270 lb) that the bare 1/8 transom cannot
6061 rectangular tube 2 x 3 x 1/8 in | Forward A-frame crossbar, 3 in deep (24.5 in); bottom on the tie-strut tabs | 1 | ea | $30 |  | 2.8 | Y |  | Replaces the 1-1/2 in crossbar: fatigue margin for the belt-pull pulses through the tie struts
Dash panel | 1/8 in aluminium, 13.5 in wide, arched 8.5 in top; folds up 66 deg from the console top, faces the driver | 1 | ea | $40 |  | 1.0 | Y |  | Tach centre, temp and fuel either side, everything else in the bottom row
12 V socket and USB-A 5 V / 3 A charger, marine | With hinged rubber flaps; dash bottom row | 1 | set | $40 |  | 0.3 | Y |  | Both on the hub 20 A outlet circuit
Phone holder, swivel | Ball stalk at the console front-inboard corner, faces the driver; portrait or landscape (con_phone_rot) | 1 | ea | $45 |  | 0.8 | Y
Dash switches | 2 sealed OFF-LO-MED-HI rotary switches (light bar 2-pole, its second pole lights the gauges; searchlight) + sealed NAV-OFF-ANCHOR rocker; DT12 connector | 1 | set | $95 |  | 0.5 | Y |  | Dash bottom row; the rotaries set the dimmers in the battery bay
Bubble inclinometers | Fore/aft and port/starboard, both on the console top | 2 | ea | $25 |  | 0.6 | Y |  | For trimming loads
LED light bar 30 in, 180 W, marine | On clamp brackets above the front cage hoop | 1 | ea | $170 |  | 10.0 | Y |  | About 13 A
Searchlight 6 in LED + turret, yoke and trunnions | Yaw +-180 deg, pitch +-45 deg; DIY mount | 1 | lot | $200 |  | 9.0 | Y |  | About 4 A
Searchlight remote control | Housing, swing handle (pitch), twist grip (yaw) | 1 | lot | $60 |  | 1.0 | Y |  | On the console top, forward of the cup holder
Push-pull (choke) cables, 20 ft | Yaw and pitch; zip-tied pair along the hull side and front hoop | 2 | ea | $35 |  | 2.0 | Y |  | About 17 ft each installed
Power distribution hub | 12-way sealed blade fuse block with negative bus | 1 | ea | $70 |  | 1.0 | Y |  | 9 circuits used, 3 spare; see the wiring schematic
Main battery switch, 1/0-rated (300 A), sealed panel mount | Bench front between the knees, rubber gasket; studs inside the battery bay | 1 | ea | $45 |  | 0.8 | Y |  | Key for daily use; main switch for battery changes and emergencies
Starter fusible link + MRBF fuses | 4 AWG fusible link at battery +; 60 A MRBF (hub feed) on the switch OUT stud; 10 A MRBF (bilge) at battery + | 1 | lot | $75 |  | 0.4 | Y
Battery cable 1/0 AWG tinned marine | Red 14 ft (battery -> switch -> starter), black 12 ft (battery - -> engine ground); tinned lugs, boots | 1 | lot | $175 |  | 7.0 | Y |  | Through the conduit and the 3-hole guard grommet
Cable 6 AWG tinned marine | Red hub feed, black hub return, 4 ft total with lugs | 1 | lot | $25 |  | 0.5 | Y
Duplex 12 AWG red/black tinned marine | Outlet, EFI, start, light bar, searchlight, nav lights; 100 ft | 1 | roll | $165 |  | 6.0 | Y |  | No chassis-ground returns
Primary 18 AWG tinned marine, 13 colours | Key, kill, gauges, sensors (tach dark gray, temp tan, fuel pink, trouble brown-white, gauge lights blue-yellow), dimmer and relay signals, bilge, pump; 25 ft spools | 13 | spool | $12 |  | 0.4 | Y |  | ABYC E-11 colours
Deutsch DT/DTP connector kit | DT12 x3, DT2 x4, DTP2 x7 with pins, seals and wedges; crimp tool | 1 | kit | $240 |  | 0.8 | Y |  | Every break outside the battery bay
Looms, conduit, glands, grommets | Split loom 5/8 in and 3/8 in; 1-1/2 in sch 40 PVC conduit 3 ft with 3-hole gland caps; 2 PG13 glands; 3-hole guard grommet; aluminium deck cable cover | 1 | lot | $95 |  | 2.5 | Y
Relays and dimmers, sealed | 5 x 12 V 40 A relays (start, EFI main, fuel pump, nav, anchor) + 4 x 1N5408 diodes (2 anchor coil, 2 gauge lights); 2 x IP67 20 A PWM dimmers with 3-wire remote input | 1 | lot | $140 |  | 1.4 | Y |  | Inside the battery bay
Bilge float switch + AUTO-OFF-MAN switch | Float in the sump; sealed toggle on the bench front | 1 | set | $60 |  | 0.7 | Y |  | Always on through its own 10 A fuse
Fuel pump and filter, EFI inline | On a bracket on the port engine-bed plate, outside the guard | 1 | set | $170 |  | 2.5 | Y |  | Delete if the drivetrain list already carries them
Fuel sender, electric 240-33 ohm | In the portable tank, DT2 at the tank front | 1 | ea | $60 |  | 0.4 | Y |  | The tank must accept a sender
Nav lights | Bow red/green combination on a 12 in stanchion; all-round white on an 18 in mast with U-bolt saddle on the aft hoop | 1 | set | $140 |  | 2.5 | Y |  | USCG Rule 23 for power vessels under 12 m
Marine plywood 1/2 in, 4x8 | Bench bottom panel, bay bulkhead, both lids | 1 | sheet | $150 |  | 7.5 | Y |  | Epoxy-coat inside the cooler
Deck hardware | 4 in aluminium cleats (4), 1/4 in bow knees (2), 316 bow-eye strap and 2 in ring | 1 | lot | $110 |  | 4.0 | Y |  | Bow cleats on the knees, stern cleats on the transom corners
Fire extinguisher, USCG B-1 (5-B:C) marine | With quick-release bracket | 1 | ea | $40 |  | 4.5 | Y |  | Bow shelf, starboard of the tank
Air horn, 8 oz can | With bracket | 1 | ea | $25 |  | 0.8 | Y |  | Bow shelf, port of the tank
Flag staff and international-orange flag | 3/4 in 6061 tube removable staff in a 7/8 in socket on a U-bolt saddle on the aft hoop, 12 in port of the stern light; 12 x 10 in nylon flag, bottom edge 122 in above the hull bottom | 1 | lot | $45 |  | 1.0 | Y |  | Florida Statute 327.391: flag at least 10 x 12 in, at least 10 ft above the lowest part of the boat; pull the staff to trailer
Rev 7 fasteners | SS bolts, rivnuts, U-bolts and clamps for the items above | 1 | lot | $60 |  | 2.0 | N
Total
Weight included in the CAD model
Weight not in the CAD model (fasteners, paint, wiring)
CAD model weight for this group (reference) |  |  |  |  |  | 322.9 |  |  | Rev 6 CAD weight reports; rev 7 lines above are model volumes or catalog weights
