acappon/DIY-MiniAirboat/rev0_StitchAndGlue/DIY-Mini-Airboat_BOM_Aluminum.xlsx

Sheet: Summary
DIY Mini-Airboat — BOM summary (riveted aluminum hull)
Totals pull from the three BOM tabs. Change quantities, prices or weights there; change the contingency in B11.
Group | Est. cost ($) | Weight (lb) | Weight in CAD (lb) | Weight not in CAD (lb)
Hull | $5040 | 347.5 | 330.5 | 17.0
Drivetrain | $6038 | 389.4 | 385.4 | 4.0
Everything else | $5154 | 331.9 | 322.9 | 9.0
Subtotal | $16232 | 1068.8 | 1038.8 | 30.0
Contingency (shipping, tax, mistakes, extras) | $2434.8
Contingency rate | 15% | Assumption: 15% of materials; edit as needed
Estimated materials total | $18666.8
Weight check
Empty boat, CAD model (no fuel or crew) | 1038.8 | lb, from the final trim analysis
BOM weight in CAD (should match) | 1038.8
Difference | 0.0
Empty boat incl. items not in CAD | 1068.8
Labor and the fab shop shear/brake service are not included here; see DIY-Mini-Airboat_Build-Guide_Aluminum.xlsx.
Supplier links appear only where a supplier was discussed during design.

Sheet: Hull
DIY Mini-Airboat — Hull BOM (riveted aluminum)
Costs are 2026 USD estimates. Blue cells are inputs you can change; Est. cost = Qty x Unit cost. Weight is the installed line weight in lb.
Item | Use / spec | Qty | Unit | Unit cost ($) | Est. cost ($) | Weight (lb) | In CAD weight? | Supplier link | Notes
5052-H32 aluminum sheet 0.090 in, 60 x 144 in | Bottom halves with the 3 in chine bent in, bow rocker pieces, bow face | 3 | sheet | $450 | $1350 | 97.6 | Y |  | Centerline seam over the center stringer; transverse butt seam with doubler at frame 120
5052-H32 aluminum sheet 0.063 in, 48 x 144 in | Side panels | 2 | sheet | $230 | $460 | 22.0 | Y
5052-H32 aluminum sheet 0.125 in, 24 x 72 in | Transom | 1 | sheet | $180 | $180 | 14.5 | Y
5052 strip 0.080 and 0.063 in, brake-formed into hat sections | 5 stringers, 2.5 in tall (0.080 for the two engine-bed stringers); 1 in cross-drain slot in each at x 3.5-4.5 | 1 | lot | $350 | $350 | 39.4 | Y |  | Bend to the rocker before riveting
6061 angle 1-1/2 x 1-1/2 x 1/8 in, 12 ft | 7 frames + transom frame | 5 | stick | $42 | $210 | 24.8 | Y |  | 1 x 3/4 in limber notch at the skin in every bay of every frame; deburr and prime the cut edges
6061 rectangular tube 2 x 3 x 1/8 in, 12 ft | Engine-bed box beams on the bed stringers | 1 | stick | $95 | $95 | 12.9 | Y
6061 angle 1 x 1 x 1/8 in, 12 ft | Rub rails / sheer clamps | 3 | stick | $25 | $75 | 6.4 | Y
6061 plate 1/4 in | Quarter knees and frame-12 gussets under the cage plates | 1 | lot | $40 | $40 | 3.6 | Y
6061 aluminum 1/4 in flat bar and plate | Engine bed plates 48 x 3 in (2), cage mount plates 4 x 4 in (4) | 1 | lot | $130 | $130 | 8.4 | Y |  | Drill beds 16 x 13/32 in at 3 in spacing
HDPE sheet 1/8 in, 12 x 24 in | Isolator strips under all aluminum plates | 1 | sheet | $25 | $25 | 1.5 | Y
6061 angle 1-1/2 x 1-1/2 x 1/8 in (2) + 5052 sheet 1/8 in for nose cap | Chine guard angles opened to 135 deg; bent nose cap | 1 | lot | $120 | $120 | 15.9 | Y
UHMW 1/4 in sheet, 48 x 120 in | 4 bottom strips (splice over a frame) | 3 | sheet | $290 | $870 | 82.8 | Y |  | 3/16 in saves about 21 lb
Closed-end aluminum blind rivets 3/16 in (5052/5056, aluminum mandrel) | All skin laps and framing; double rows at about 3/4 in | 2500 | ea | $0.15 | $375 | 5.0 | N |  | Never open-end or steel-mandrel rivets
Seam sealant (Sikaflex 291 or 3M 4200), 10 oz tubes | Wet in every lap before riveting | 10 | tube | $15 | $150 | 4.0 | N
SS 1/4 in through-bolts, nylock nuts, sealing washers | UHMW strips through the bottom into the stringers | 200 | set | $0.80 | $160 | 3.0 | N |  | Bed in sealant; Tef-Gel on threads
Clecos 3/16 in (100) + pliers, drill bits, deburr tools | Tooling | 1 | lot | $150 | $150 | 0.0 | N
Self-etching primer + marine topcoat (olive drab) | Inside and out | 1 | lot | $260 | $260 | 5.0 | N
Rev 6 joint details
Bed plates lengthened to 52 in, new 10-hole pattern; knees/gussets drilled for cage-foot bolts | Net change from the detailed hull model | 1 | lot | $40 | $40 | 0.7 | Y |  | Hole positions in the fab workbook
Total |  |  |  |  | $5040 | 347.5
Weight included in the CAD model |  |  |  |  |  | 330.5
Weight not in the CAD model (fasteners, paint, wiring) |  |  |  |  |  | 17.0
CAD model weight for this group (reference) |  |  |  |  |  | 330.5 |  |  | From the CAD weight reports (hull r4.2, drivetrain r5, layout r6 + cage r2 + flotation r5)

Sheet: Drivetrain
DIY Mini-Airboat — Drivetrain BOM
Costs are 2026 USD estimates. Blue cells are inputs you can change; Est. cost = Qty x Unit cost. Weight is the installed line weight in lb.
Item | Use / spec | Qty | Unit | Unit cost ($) | Est. cost ($) | Weight (lb) | In CAD weight? | Supplier link | Notes
Suzuki G13 1.3 L engine (junkyard), dressed | 1995-2001 Geo/Chevy Metro 1.3 or Suzuki Swift; with flywheel, starter, alternator, intake, ECU/harness | 1 | ea | $600 | $600 | 179.0 | Y | https://www.car-part.com | Weight is the CAD placeholder: verify on a scale
Engine refresh kit | Gaskets, timing belt + tensioner, water pump, plugs, thermostat, oil and filter | 1 | kit | $320 | $320 | 0.0 | N
Fuel delivery | Electric pump, filter, fuel line, primer bulb, clamps | 1 | lot | $140 | $140 | 3.0 | N
Bellhousing adapter | 3/8 in 6061 plate + shroud, machined to the G13 pattern, starter boss | 1 | ea | $160 | $160 | 11.0 | Y |  | Material + DIY machining; pattern from the real block
Flex coupling (jaw or donut type) | Torsional damper, flywheel to jackshaft; rated 150 lb-ft or more | 1 | ea | $130 | $130 | 1.3 | Y
Jackshaft 1-1/4 in 4140 + 2 bearings + housing | Takes belt pull off the crankshaft | 1 | lot | $170 | $170 | 4.4 | Y
HTD 8M pulley, 30 teeth, 85 mm, taper-lock + bushing | Drive pulley on jackshaft | 1 | ea | $140 | $140 | 5.7 | Y
HTD 8M pulley, 75 teeth, 85 mm, aluminum, taper-lock + bushing | Prop pulley between the bearings | 1 | ea | $330 | $330 | 7.5 | Y
HTD belt 2320-8M-85 (290 teeth) | Gates PowerGrip HTD or equal; 2.5 : 1 | 1 | ea | $190 | $190 | 3.0 | Y |  | Confirm width with Gates design data for 74 lb-ft
Backside idler 3.5 in + bearing + pad bracket (optional) | Slack-side idler bolted to adapter | 1 | ea | $70 | $70 | 3.2 | Y |  | Fit only if ground runs show belt flap
Prop shaft 1-1/2 in 4140, 20 in, keyed | Supported fore and aft | 1 | ea | $110 | $110 | 9.8 | Y
Flange bearing 1-1/2 in, 4-bolt | One in each yoke plate | 2 | ea | $55 | $110 | 9.0 | Y
Prop flange / hub adapter | Machined to the Warp Drive HPL hub pattern | 1 | ea | $140 | $140 | 3.8 | Y
Tension yoke: 3/8 in 6061 plates + 1 in tie tubes | Carries both bearings; pivots as one piece | 1 | lot | $170 | $170 | 13.3 | Y
1/2 in grade 8 bolts + lock nuts; 1/2-13 jack screw + block | Pivot (2), arc slot (4), jack screw | 1 | lot | $45 | $45 | 2.0 | Y
6061 square tube 2 x 2 x 1/8 in | A-frame legs and crossbars | 30 | ft | $9.00 | $270 | 17.8 | Y
6061 plate 3/8 in, 24 x 30 in | Two gusset-shaped peak plates with lightening holes | 1 | ea | $210 | $210 | 20.0 | Y
6061 plate 1/4 in | A-frame and brace feet (6) | 1 | lot | $40 | $40 | 2.6 | Y
6061 tube 1-1/2 x 1-1/2 x 1/8 and 1 x 1 in | Diagonal braces (2) and adapter tie struts (2) | 16 | ft | $8.00 | $128 | 7.1 | Y
Engine mount: steel bracket + polyurethane bushing | Bolted to engine-bed plates at x = 30 and 42 in | 4 | ea | $35 | $140 | 15.3 | Y
Warp Drive 64R-TX-HPL3 propeller | 64 in, 3 carbon blades, HPL hub, ground-adjustable, R rotation | 1 | ea | $1395 | $1395 | 18.0 | Y | https://warpdriveinc.com/product/3-bld-prop-hpl-hub/ | Price from Warp Drive page; confirm rotation, hub pattern and weight before ordering
Leading-edge protection tape (stoneguard) | Blade leading edges | 1 | kit | $60 | $60 | 0.0 | N |  | Warp Drive's nickel edge is the $390 alternative
Honda Civic radiator (junkyard) + hoses, clamps, coolant, overflow bottle | Above the hub, in front of the prop | 1 | lot | $140 | $140 | 20.0 | Y
Radiator cradle rails + straps | On the peak plates | 1 | lot | $35 | $35 | 0.8 | Y
Exhaust: mandrel bends, flex section, muffler, wrap, heat shields | Low starboard; tailpipe over transom below the prop disk | 1 | lot | $280 | $280 | 16.0 | Y
Throttle cable + return spring | Pedal to throttle body | 1 | lot | $60 | $60 | 1.0 | N
Rev 6 joint details
A-frame details: slotted leg tops, 1/8 caps, foot gussets, mitred crossbars | 6061 drops; TIG | 1 | lot | $60 | $60 | 0.0 | Y |  | Weight included in the A-frame line below
Brace clevises: 1/4 tongues and tab pairs, 3/8 grade 8 bolts + nylocks (4) | Removable braces | 1 | lot | $45 | $45 | 0.0 | Y
Tie-strut tabs + 5/16 bolts (4) | Adapter to crossbar | 1 | lot | $20 | $20 | 0.0 | Y
Engine mounts: 6061 cradles (4), steel engine-side brackets (4), DOM sleeves, poly bushings 1.75 OD x 1/2 ID (4), 1/2 grade 8 through-bolts (4) | Engine-side holes to suit the real block | 1 | lot | $160 | $160 | 0.0 | Y |  | Measure the G13 mount bosses first
Radiator: lower angle, 2 rubber grommets, 2 x 3/8 top stays with rubber bushings |  | 1 | lot | $45 | $45 | 0.0 | Y
Exhaust: flex section, 2 rubber isolators, 2 SS band clamps, 6061 hanger brackets, tailpipe saddle + pad |  | 1 | lot | $95 | $95 | 0.0 | Y
Bed-plate bolts 3/8 SS + nylocks + Tef-Gel (20) | All feet and pads | 20 | ea | $1.50 | $30 | 0.0 | Y
Net weight of the rev 6 drivetrain details (CAD) | Reconciles to the detailed drivetrain model | 1 | lot | $0.00 | $0 | 14.8 | Y
Total |  |  |  |  | $6038 | 389.4
Weight included in the CAD model |  |  |  |  |  | 385.4
Weight not in the CAD model (fasteners, paint, wiring) |  |  |  |  |  | 4.0
CAD model weight for this group (reference) |  |  |  |  |  | 385.4 |  |  | From the CAD weight reports (hull r4.2, drivetrain r5, layout r6 + cage r2 + flotation r5)

Sheet: Everything else
DIY Mini-Airboat — Everything else BOM: cage, rudders, steering, seating, controls, flotation, electrical, safety
Costs are 2026 USD estimates. Blue cells are inputs you can change; Est. cost = Qty x Unit cost. Weight is the installed line weight in lb.
Item | Use / spec | Qty | Unit | Unit cost ($) | Est. cost ($) | Weight (lb) | In CAD weight? | Supplier link | Notes
Prop cage
Steel tube 1 in x 0.049 in | Two cage hoops, 72.4 in dia (about 19 ft each) | 40 | ft | $3.50 | $140 | 18.8 | Y
Tube rolling service | Roll two 72.4 in hoops | 1 | job | $150 | $150 | 0.0 | Y |  | Muffler or fab shop
Steel tube 1 in x 0.065 in | Cage legs, base rails, rudder rails | 24 | ft | $4.00 | $96 | 15.5 | Y
EMT conduit 3/4 in and 1/2 in, 10 ft sticks | Longitudinals (8) and face bars (4) | 5 | stick | $10 | $50 | 10.3 | Y |  | Grind off zinc before welding; ventilate
Hardware cloth 1/2 in, 19 ga galvanized, 36 in x 50 ft | Front, aft and side screens | 1 | roll | $120 | $120 | 17.3 | Y |  | Keep 4.7 in or more from any moving part
Shaft guard sleeve | Fixed sleeve where the shaft passes the front screen | 1 | ea | $15 | $15 | 0.2 | Y
Welding wire, gas, paint for cage |  | 1 | lot | $120 | $120 | 0.0 | N
Rudders and steering
Aluminum honeycomb panel 20 mm, 4 x 8 ft | Two rudders 14 x 44 in | 1 | sheet | $380 | $380 | 11.9 | Y | https://www.chalcoaluminum.com/knowledge/sandwich-panel/#Honeycomb | Price is an estimate; request a quote
Aluminum U-channel 3/4 in, hinge tube 1 in x 0.083 in, horns | Rudder edges and hinges; seal all edges | 1 | lot | $90 | $90 | 5.6 | Y
Hinge brackets and bushings | On the 1 in rudder rails | 4 | ea | $10 | $40 | 0.0 | N
Tie bar, pushrod, 4 rod ends, lever pivot | Horns to the left-hand steering lever | 1 | lot | $130 | $130 | 4.6 | Y
Seating, controls, fuel, battery
Marine plywood 3/8 in, 4x8 | Floor, transom to x = 121 in, 64 in wide | 5 | sheet | $110 | $550 | 61.7 | Y |  | Bolt-down panels resting on the stringer tops (aft panel included); 6.5 in cutouts for deck plates
Marine plywood 1/2 in, 4x8 | Straddle bench box and bow shelf | 1 | sheet | $150 | $150 | 33.3 | Y
Bench lid hinge, gasket, latches | Watertight battery compartment | 1 | lot | $70 | $70 | 0.0 | N
Seat foam + marine vinyl | Bench cushion | 1 | lot | $130 | $130 | 4.0 | Y
Removable backrests | Driver and passenger | 2 | ea | $55 | $110 | 10.0 | Y
Passenger grab handles | Both sides of the bench | 2 | ea | $22 | $44 | 3.0 | Y
Expanded-metal engine guard | Between passenger and engine front | 1 | ea | $60 | $60 | 5.0 | Y
Footrest ladder | 5 rungs, x = 104.5-123 in | 1 | ea | $45 | $45 | 4.0 | Y
Throttle pedal, clamp-on | Moves to any ladder rung | 1 | ea | $45 | $45 | 2.0 | Y
Steering lever + pivot | Port side, left hand | 1 | ea | $70 | $70 | 7.0 | Y
Padded grab bar | Starboard, right hand at 42 in | 1 | ea | $55 | $55 | 4.0 | Y
Portable fuel tank 6.6 gal + fuel line and primer bulb | Strapped on the bow shelf | 1 | lot | $120 | $120 | 4.5 | Y |  | Fuel itself (40 lb full) not counted
Battery, Group 26 + hold-down | Inside the sealed bench | 1 | ea | $150 | $150 | 38.0 | Y |  | Lithium option saves about 25 lb
Adjustable trim tab (DIY aluminum) | 18 x 6 in, starboard half of transom | 1 | ea | $60 | $60 | 4.0 | Y
Flotation, sump, pump
Two-part pour foam, 2 lb/cu ft closed-cell urethane, about 8 cu ft per kit | 24 removable blocks: thin blocks under the floor aft of x = 72 in (5.1 cu ft) and under the bow shelf (4.4 cu ft), poured in molds or in each bay on a release-lined tray | 2 | kit | $115 | $230 | 19.0 | Y |  | Urethane only (gasoline resistant); nothing bonded to the aluminum
Coroplast 4 mm 4 x 8 sheets + polyurea or epoxy seal coat | Bottom tray and sealed skin on every block | 1 | lot | $100 | $100 | 3.7 | Y |  | Sealed skin slows water uptake
HDPE sheet 1/2 in, 12 x 24 in | 54 spacer pads 1.5 x 1.5 in, glued to block bottoms (1/2 in drained channel) | 1 | sheet | $35 | $35 | 2.1 | Y
Two-part pour foam kit + covers and straps | Removable side blocks (6.4 cu ft), molded to fit; they give the swamped boat its stability | 1 | lot | $215 | $215 | 12.8 | Y |  | Must be strapped in whenever the boat is used
Screw-out deck plates, 6 in | Inspection ports in the floor (8) | 8 | ea | $14 | $112 | 3.6 | Y |  | Plastic, gasketed
FRP grating panel, 1 in, made into a raised box | Removable grate box over the open sump (pump is taller than the low floor) | 1 | ea | $60 | $60 | 2.5 | Y
Automatic bilge pump about 1,100 gph + float switch | In the open transom sump | 1 | ea | $90 | $90 | 2.5 | Y
Through-hull, discharge hose, clamps | Discharge at 14 in on the transom | 1 | lot | $35 | $35 | 1.0 | Y
Transom self-bailer with check valve, 1.5 in | Bottom of sump | 1 | ea | $45 | $45 | 0.5 | Y |  | Must have a working check valve
Transom drain plug, 1 in (plastic or aluminum) | Lowest point of the sump; pull on the trailer after every trip | 1 | ea | $12 | $12 | 0.2 | Y |  | Not brass (galvanic)
Pump cycle counter or hour meter on the float-switch circuit | Leak early warning | 1 | ea | $25 | $25 | 0.0 | N
Waterproof bilge switch (auto / off / manual), fused | On the transom top, reachable from the water when the boat is swamped | 1 | ea | $35 | $35 | 0.0 | N |  | Pump runs from the battery inside the sealed bench
Floor fasteners: SS screws into rivnuts + closed-cell gasket tape | Bolt-down floor panels (hold the blocks down when swamped) | 1 | lot | $60 | $60 | 0.0 | N
Electrical and safety
Wire, fuse block, battery switch, kill-switch lanyard, terminals |  | 1 | lot | $180 | $180 | 5.0 | N
Gauges: tach, coolant temp, oil pressure, hour meter |  | 1 | lot | $160 | $160 | 2.0 | N
Navigation lights (sidelights + all-round white) | Needed for night running | 1 | set | $90 | $90 | 2.0 | N
Safety gear: fire extinguisher, 2 PFDs, horn, throwable | Carried gear | 1 | lot | $200 | $200 | 0.0 | N |  | Not counted in boat weight
Registration and title fees |  | 1 | lot | $75 | $75 | 0.0 | N |  | Estimate; check your state's rules
Rev 6 joint details
Cage feet: 1/4 steel pads drilled, HDPE isolators, 3/8 SS bolts (16) | Bolted through the hull plates and knees | 1 | lot | $70 | $70 | 0.0 | Y
Rudder pivots: 1/2 bolts (4), tapped plugs (4), UHMW thrust washers (4); 3/8 rod ends (3) + bolts |  | 1 | lot | $85 | $85 | 0.0 | Y
Backrest sockets 1-1/4 x .065 (4) + straps; handle flanges and backing plates |  | 1 | lot | $60 | $60 | 0.0 | Y
Bench clips (4), battery tray + strap, steering pivot base + bushings, ladder foot plates (4), engine-guard angle + stays |  | 1 | lot | $120 | $120 | 0.0 | Y
Bow shelf: aft angle at frame 120, front angle + 3 stringer clips, 4 padeyes + 2 cam straps | Shelf enlarged to x 118.5-140.2 | 1 | lot | $70 | $70 | 0.0 | Y
Net weight of the rev 6 cage and layout details (CAD) | Reconciles to the detailed models | 1 | lot | $0.00 | $0 | 10.3 | Y
Total |  |  |  |  | $5154 | 331.9
Weight included in the CAD model |  |  |  |  |  | 322.9
Weight not in the CAD model (fasteners, paint, wiring) |  |  |  |  |  | 9.0
CAD model weight for this group (reference) |  |  |  |  |  | 322.9 |  |  | From the CAD weight reports (hull r4.2, drivetrain r5, layout r6 + cage r2 + flotation r5)
