acappon/DIY-MiniAirboat/rev8_JonAirBoat/Airboat Build Tracker v1.0.1.3.xlsx

Sheet: Read Me
Airboat Build Tracker - v1.0.1.3 (in development: seating redesign; not yet built or tested)
Project | DIY airboat built on a used 14 ft x 48 in (1448) aluminum jonboat. Branch main (third beta, v1.0.1.2): a minimal, solo-first build with a Rotax 800R E-TEC snowmobile two-stroke on a belt reduction (reports/archive/Engine_Selection_1448.md, reports/Drivetrain_800R_ETEC.md). CAD: Onshape document "DIY Jon-Air boat" (still the v1.0.0.2 G13 drivetrain).
Design rule | Everything must be buildable with DIY backyard-mechanic skills.
How to use
Yellow cells | Inputs you fill in or edit: quantities, prices, hours, pledges, completions, and the pro labor rate below.
Blue text | Hard-coded estimates (prices, hours). Each one is explained in the row's last column.
Black text | Formulas. Do not overwrite: extended cost, step material cost, pro labor cost and the totals recalculate automatically.
Pledged / paid by | Material: names of people who pledged or paid. Use the BOM tab for one part, or the Build Guide tab for all the materials in a step. Example: "Sam - pledged", "Alex - paid".
Labor pledged / done by | Labor, on the Build Guide tab: names of people who pledged to do the step or pay a pro, or who did it. Example: "Alex - do it", "Sam - pay a pro", "Alex 60%, Sam 40% - done".
Links | Amazon links are search links, not a specific product: pick a listing that matches the spec. Marketplace/Craigslist ads expire.
Assumptions
Pro labor rate ($/hr) | $85
Rate basis | Typical 2026 shop rate for a marine aluminum fabricator / boat shop in Southern California; adjust to a quote you actually get.
Prices | Estimates as of 2026-11-01, before tax and shipping. Freight on full 4x8 plastic sheets can add $100+ per sheet.

Sheet: BOM
Line | Item | Specification | Category | Build step | Qty | Unit | Est. unit cost ($) | Est. cost ($) | Pledged / paid by | Status | Where to find / links / basis for estimate
1 | Used 1448 aluminum jonboat | 14 ft x 48 in bottom riveted aluminum jonboat (Lowe, Tracker, Alumacraft, etc.). Hull must be leak-free or have only a few weeping rivets. | Hull | 1.1 | 1 | ea | $4000.00 |  |  | Searching | https://www.craigslist.org/view/d/thousand-oaks-2006-tracker-1448-fb/3s4MJgxrcb3H5QovNdoBCE Example ad (Craigslist Ventura/Thousand Oaks, seen 2026-11-01): 2006 Tracker 1448 FB, $4,000 OBO, includes trailer and 7.5 hp outboard (motor could be resold). Bare hulls without motor/trailer usually list for much less; also check Facebook Marketplace and OfferUp.
2 | UHMW polyethylene sheet, 1/8 in | 1/8 in x 48 in x 96 in, black, UV-stabilized if available. Whole bottom, transom to bow, 924 in3, about 31 lb of plastic and about 36 lb with fasteners (Build Guide 1.2). Leftover makes spares and rudder pads. | Hull armor | 1.2 | 2 | sheet | $307.00 |  |  | Not ordered | https://www.zoro.com/i/G3680187/ PRICE TO CHECK for 1/8 in: Zoro black UHMW 96x48x1/4 listed ~$307 (Nov 2026); 1/8 in should be less; other listings $235-$640 plus $100-110 freight surcharge per sheet. A local plastics distributor may avoid freight.
3 | Flat head machine screw #10-24 x 1 in | 100 deg flat head, Phillips, 18-8 stainless. About 80 used + spares. | Hardware | 1.2 | 1 | 100-pk | $8.49 |  |  | Not ordered | https://www.zoro.com/zoro-select-10-24-x-1-in-phillips-flat-machine-screw-plain-18-8-stainless-steel-100-pk-u513000190100/i/G1034756 Zoro Select U51300.019.0100, $8.49 / 100 (Nov 2026). This listing is the common 82 deg head: find the 100 deg version, because an 82 deg head is about as deep as the 1/8 in sheet. Also: https://www.amazon.com/s
4 | Nylon-insert lock nut #10-24 | 18-8 stainless nylock. About 80 used + spares. | Hardware | 1.2 | 1 | 100-pk | $12.00 |  |  | Not ordered | https://www.amazon.com/s?k=10-24%20nylon%20insert%20lock%20nut%2018-8%20stainless%20100%20pack Estimate: stainless #10-24 nylocks typically $10-15 per 100 on Amazon.
5 | Fender washer #10 x 1 in OD | 3/16 in ID x 1 in OD, 18-8 stainless. Spreads load on the rib flange inside the hull. | Hardware | 1.2 | 1 | 100-pk | $12.00 |  |  | Not ordered | https://www.amazon.com/s?k=%2310%20fender%20washer%203%2F16%20x%201%20stainless%20100%20pack Estimate: typically $9-15 per 100 on Amazon.
6 | Marine sealant | 3M Marine Adhesive Sealant 4000UV (or butyl tape). Removable later, unlike 5200. Bed every hole through the hull. | Consumable | 1.2 | 2 | 3 oz tube | $22.00 |  |  | Not ordered | https://www.amazon.com/s?k=3M%204000UV%20marine%20adhesive%20sealant%203%20oz Estimate: about $20-25 per 3 oz tube. 80 fasteners use roughly 2 tubes.
7 | 100 deg countersink bit | 1/2 in, 100 deg, single-flute or zero-flute (cuts UHMW cleanly). | Tool | 1.2 | 1 | ea | $15.00 |  |  | Not ordered | https://www.amazon.com/s?k=100%20degree%20countersink%20bit%201%2F2%20zero%20flute Estimate. Make sure it is 100 deg to match the screws, not the more common 82 deg.
8 | Drill bits: 3/16 in and #7 (or 13/64 in) | 3/16 pilot; #7 / 13/64 clearance for #10 screws through UHMW and hull. | Tool | 1.2 | 1 | set | $10.00 |  |  | Not ordered | https://www.amazon.com/s?k=13%2F64%20cobalt%20drill%20bit%203%2F16%20drill%20bit Estimate; cobalt bits last longer in aluminum.
9 | Chine angle, formed aluminum | 5052-H32, 1/8 in thick, 3 in wide x 12 ft strip, brake-formed lengthwise into a 1-1/2 x 1-1/2 in angle opened to 117 deg (matches the hull side flare). One per side; trimmed to ~132 in. | Hull armor | 1.3 | 0 | 12 ft pc | $60.00 |  |  | Not in the minimal build | https://www.onlinemetals.com/en/buy/aluminum/aluminum-sheet-5052-h32 Estimate: ~$35-45 of 1/8 in 5052 strip plus ~$15-25 per piece for shearing and one brake bend at a local metal supplier or sheet-metal shop (ask for a 117 deg bend, not 90). Stock 90 deg 6061 angle is NOT recommended: it is hard to open evenly and cracks when bent.
10 | Bow skin sheet, aluminum | 5052-H32, 0.063 in, 48 x 48 in. Wraps from inside the bow lip, over the gunwale rail, down the bow face and ~27 in aft along the bow rise (3 in past the UHMW front edge). | Hull armor | 1.4 | 0 | sheet | $95.00 |  |  | Not in the minimal build | https://alcobrametals.com/aluminum/sheet-plate/5052-h32-plate/ Alcobra lists .063 5052-H32 at $37-$118 depending on size (Nov 2026); 48x48 estimated ~$95. Developed length of the wrap is ~41 in, so a 48x48 sheet leaves trimming margin.
11 | Truss head machine screw #10-24 x 5/8 in | Phillips truss (low, wide) head, 18-8 stainless. Through chine-angle side legs (~44, every 6 in) and bow skin (~40, every 3-4 in) into the hull. Too thin to countersink, so a low truss head sits on the outside. | Hardware | 1.3, 1.4 | 0 | 100-pk | $12.00 |  |  | Not in the minimal build | https://boltdepot.com/Machine_screws_Phillips_truss_head_Stainless_steel_18-8_10-24 Estimate ~$10-15 per 100. Bolt Depot sells by the piece; 100-packs of other #10-24 x 5/8 18-8 heads list $6.69-$12.19 (Zoro, Nov 2026). Replaces the closed-end rivets.
12 | Nylon-insert lock nut #10-24 (trim) | 18-8 stainless nylock, inside the hull for the chine angles and bow skin. ~84 used + spares. Separate from BOM line 4 (UHMW bolts). | Hardware | 1.3, 1.4 | 0 | 100-pk | $12.00 |  |  | Not in the minimal build | https://www.amazon.com/s?k=10-24%20nylon%20insert%20lock%20nut%2018-8%20stainless%20100%20pack Estimate: stainless #10-24 nylocks typically $10-15 per 100. Replaces the rivet gun line.
13 | Clecos 3/16 in (25 pk with pliers) | Hold the angle / skin in place while drilling. Drill #11 (0.191 in) first for a snug Cleco, then open each hole to #7 (13/64 in) for the #10 screw at final assembly. | Tool | 1.3, 1.4 | 0 | kit | $25.00 |  |  | Not in the minimal build | https://www.amazon.com/s?k=3%2F16%20cleco%20kit%20with%20pliers Estimate: Cleco kits ~$20-30. #7 bit is in BOM line 8; add a #11 bit (~$3).
14 | Marine sealant (trim) | 3M 4000UV, 3 oz. Bead under chine angle side leg and under the bow skin; dab on every rivet. | Consumable | 1.3, 1.4 | 0 | 3 oz tube | $22.00 |  |  | Not in the minimal build | https://www.amazon.com/s?k=3M%204000UV%20marine%20adhesive%20sealant%203%20oz Estimate: about $20-25 per tube. Separate from BOM line 6 (UHMW bolts).
15 | Flat washer #10, stainless | 18-8 stainless, #10 (3/16 in ID, ~7/16 in OD). Under the nylocks inside the hull for chine angles and bow skin. | Hardware | 1.3, 1.4 | 0 | 100-pk | $8.00 |  |  | Not in the minimal build | https://www.amazon.com/s?k=%2310%20flat%20washer%2018-8%20stainless%20100%20pack Estimate: typically $6-10 per 100.
16 | Deck inspection port, 6 in | Screw-out marine inspection/deck plate, 6 in opening. Cut into the front deck to reach the bow-skin nuts and to inspect the bow for leaks later. | Hull | 1.4 | 0 | ea | $18.00 |  |  | Not in the minimal build | https://www.amazon.com/s?k=6%20inch%20marine%20inspection%20port%20deck%20plate Estimate: 6 in screw-out deck plates ~$12-25 each. Needed because bolts (not blind rivets) need a hand on the nut inside the bow.
17 | Stand shoe tube, 2 x 3 x 1/8 in 6061-T6 rectangular | Four shoes standing on the 2 in face: two aft of 10.75 in (X 2-12.75) and two forward of 10 in (X 34-44), notched over the rib. No bed runs under the rear bench. | Drivetrain structure | 2.2 | 1 | 6 ft pc | $54.00 |  |  | Not ordered | Price estimate, about $9/ft. Check with a local metal supplier. About 3.5 ft used; a 6 ft piece is the usual stock length. Weight and load check: CAD/analysis/stand_800r.js. (https://www.google.com/search?q=2x6x1%2F8%206061%20aluminum%20rectangular%20tube%2012%20ft)
18 | Clip angle, 2 x 2 x 1/8 in 6061 | Four clips, 3 in wide: two from the aft shoes to the transom, two to the rear bench aft panel. Open the transom clip to about 105 deg or shim it to match the transom rake. | Drivetrain structure | 2.6 | 1 | 2 ft pc | $14.00 |  |  | Not ordered | Price estimate. See reports/Drivetrain_800R_ETEC.md Section 9b. (https://www.google.com/search)
19 | Gusset plate, 1/4 in 6061 | 12 x 24 in plate for the stand gussets. | Drivetrain structure | 2.3, 2.4 | 1 | plate | $65.00 |  |  | Not ordered | https://www.google.com/search?q=1%2F4%206061%20aluminum%20plate%2012x24 Estimate.
20 | 3/8-16 stainless nuts for welding | Not used: no welded captive nuts in the minimal build. | Hardware | 2.3, 2.4 | 0 | 25-pk | $15.00 |  |  | Not ordered | https://www.amazon.com/s?k=3%2F8-16%20stainless%20hex%20nut%2025%20pack Estimate.
21 | Doublers and cage foot pads, 1/8 in 5052 | 12 x 72 in sheet: bottom doublers under the four shoes (5 x 10.5 in aft, 6 in wide forward, cut around the rib) and the eight cage foot pads and backing plates (4 x 5 in at the bench, 3 x 4 in at the corner caps). | Drivetrain structure | 2.6, 2.7 | 1 | sheet | $70.00 |  |  | Not ordered | https://www.google.com/search?q=1%2F8%205052%20aluminum%20sheet%2012x72 Estimate.
22 | Cage support post angle, 2 x 2 x 1/4 in 6061 | Not used: the cage legs stand on the bench top and the transom corner caps. | Drivetrain structure | 2.4 | 0 | 8 ft pc | $75.00 |  |  | Not ordered | https://www.google.com/search?q=2x2x1%2F4%206061%20aluminum%20angle%208%20ft Estimate.
23 | 1/4-20 stainless bolts, nylocks, washers and crush sleeves | 56 sets: 24 through the shoes and the bottom, truss head outside, with a crush sleeve in the tube; 16 at the clips; 16 at the cage feet. | Hardware | 2.6, 2.7 | 1 | 60 sets | $60.00 |  |  | Not ordered | https://www.amazon.com/s?k=1%2F4-20%20stainless%20truss%20head%20bolt Estimate for bolts, nylocks, washers and sleeves.
24 | 3/8-16 grade 8 bolts and washers | A-frame, brace and cage feet into captive nuts. ~30. | Hardware | 2.7, 2.10 | 1 | 30 sets | $35.00 |  |  | Not ordered | https://www.amazon.com/s?k=3%2F8-16%20x%201-1%2F2%20grade%208%20bolts Estimate.
25 | Rubber edge trim (U-channel) | Edges of the bench leg holes. | Drivetrain structure | 2.5 | 1 | 10 ft | $20.00 |  |  | Not ordered | https://www.amazon.com/s?k=rubber%20edge%20trim%20u%20channel%2010%20ft Estimate.
26 | Closed-cell pour foam kit, 2 lb density | Replaces flotation removed from the rear bench. | Hull | 2.5 | 1 | kit | $60.00 |  |  | Not ordered | https://www.amazon.com/s?k=2%20lb%20closed%20cell%20pour%20foam%20marine%20flotation Estimate.
27 | Engine hoist rental (2-ton) | Trial lift and lowering the module. | Tool | 2.9, 2.10 | 1 | day | $50.00 |  |  | Not ordered | https://www.google.com/search?q=engine%20hoist%20rental Estimate; purchase is ~$250.
28 | Lifting slings and shackles | Rated for at least 2x module weight. | Tool | 2.9, 2.10 | 1 | set | $45.00 |  |  | Not ordered | https://www.amazon.com/s?k=lifting%20sling%20shackle%20set%202%20ton Estimate.
29 | 3/4 in plywood sheet | Footprint boards (2.1) and the 64 in prop template (2.12). | Tool | 2.1, 2.12 | 1 | sheet | $60.00 |  |  | Not ordered | https://www.google.com/search?q=3%2F4%20plywood%204x8%20price Estimate.
30 | Engine: Rotax 800R E-TEC snowmobile two-stroke, used, running, with ECU, harness, DESS key, oil pump and tank, tuned pipe and silencer | Complete take-out engine, or a whole running sled (resell the rest). 799.5 cc twin, 7,900 rpm maximum; run at about 7,600 rpm, about 120 hp at the prop. About 79 lb bare (unverified: weigh it). Prefer electric or SHOT start. Get a run video and the hours. See reports/Drivetrain_800R_ETEC.md. | Drivetrain | 2.8 | 1 | ea | $2000.00 |  |  | Not ordered | https://www.ebay.com/shop/skidoo-800-etec-engine?_nkw=skidoo+800+etec+engine Asking prices (Nov 2026): complete used 800R E-TEC engines about $1,100-2,500; a running 2013 MXZ TNT 800R about $2,900 (Snowmobile Trader). (https://www.ebay.com/sch/i.html?_nkw=gsxr+1000+engine+complete)
31 | Belt reduction: crank PTO to prop shaft (8MGT belt and pulleys, PTO taper hub, 1-1/2 in 4140 shaft, bearings, collars, bearing plates) | One stage, 2.94:1: 8MGT 32T on the crank PTO (hub machined to the PTO taper, stock bolt) to 94T on the prop shaft; belt Poly Chain GT Carbon 8MGT-2000-36, 36 mm wide, 29.28 in centers; both pulleys flanged and dynamically balanced. Confirm the rating in Gates DesignFlex. Bearing plates CNC or waterjet cut with petal cutouts, about $160 of this line: 3/8 in 6061 aft, 1/2 in forward. 1-1/2 in 4140 pre-hardened prop shaft; forward thrust bearing: 4-bolt tapered-roller flange unit, 1-1/2 in bore (Dodge F4B-E-108R class); aft: UCF208-24 ball flange unit; two heavy-duty two-piece clamp collars; 1/2 in 6061 bearing plates with vertical slots and jack bolts. Open item: an outboard bearing for the PTO pulley (about $60) if the crank side load is not confirmed. See reports/Drivetrain_800R_ETEC.md. | Drivetrain | 2.8 | 1 | ea | $1160.00 |  |  | Not ordered | https://www.google.com/search?q=8MGT+Poly+Chain+GT+Carbon+pulley PLACEHOLDER ESTIMATE: belt and pulleys about $300, PTO taper hub machining about $150, thrust bearing about $300, aft bearing $40, collars $50, shaft and plates about $150. (https://www.google.com/search?q=Dodge+F4B-E-108R)
32 | Propeller: Warp Drive 3-blade airboat prop with HP blades, cut to 66 in, SAE #2 face plate and bolts, keyed steel prop flange | Ground-adjustable carbon blades; runs at about 2,600 rpm. Maker limits: 3,200 prop rpm, 160 hp, 62 to 72 in. BEFORE ORDERING: get Warp Drive to approve the 800R and belt combination (it is not on their list), confirm the SAE #2 bolt circle and the rotation (one belt stage: the prop turns the same way as the crank; turn the engine by hand). The standard-blade version is only for engines under 120 hp; this engine sits at that line, so use the HP blades. Flange machined to suit the 1-1/2 in prop shaft. Alternative: Whirlwind CarbonMax 68 (max 3,150 rpm published). See reports/Drivetrain_800R_ETEC.md, Section 5. | Drivetrain | 2.15 | 1 | ea | $1625.00 |  |  | Not ordered | https://warpdriveprops.com/warpdrivepropsairboats/ Price: $1,275 for the 3-blade with HP blades (up to 72 in), without face plate and bolts (Warp Drive airboat page). PLACEHOLDER ESTIMATE: about $100 face plate and bolts, about $250 flange.
33 | Radiator and hoses for continuous full load | A sled cools through tunnel heat exchangers, so the boat needs a radiator. 18 x 22 x 2 in aluminum, 16.5 lb with hoses and coolant, on the starboard side just ahead of the prop (X 15-17). Engine thermostat and sled hoses. Estimated at about 81 kW underway; check on the static test. | Drivetrain | 2.8, 2.11 | 1 | set | $180.00 |  |  | Not ordered | https://www.google.com/search?q=aluminum+radiator+atv+utv+universal PLACEHOLDER ESTIMATE.
34 | Exhaust: tailpipe, flex joint, springs and isolators, heat shields and pipe guard for the stock tuned pipe and silencer | The pipe and silencer come with the engine (BOM line 30): keep them stock. Tailpipe (about 1-3/4 in, about 4-6 ft) from the silencer down the side of the stand and out over an aft transom corner, pointing aft and slightly outboard, never into the prop; outlet at the transom top or higher. Flex joint between engine-mounted and stand-mounted parts; sheet-aluminum shields between the pipe and the belt and bearings; a guard where people could touch it. About 5 lb. Second muffler only if the static-test sound readings need it. See reports/Drivetrain_800R_ETEC.md, Section 6a. | Drivetrain | 2.8 | 1 | set | $150.00 |  |  | Not ordered | https://www.google.com/search?q=snowmobile+exhaust+springs+flex+joint+1.75+stainless+tubing PLACEHOLDER ESTIMATE: tubing and bends about $50, flex joint $30, springs and isolators $30, shields and guard $40. (https://www.google.com/search?q=gsxr+1000+header+muffler)
35 | Fuel system: 6 gal tank, line, filter, the sled fuel pump module (or one of the same pressure), clamps | Fit the sled in-tank pump module in the boat tank. Tank strapped to the front deck step, X 134-152. Burn estimate about 10.8 gal/h at full power, 5.4 gal/h at a 60 hp cruise. | Drivetrain | 2.11 | 1 | set | $200.00 |  |  | Not ordered | https://www.google.com/search?q=inline+EFI+fuel+pump+43+psi+motorcycle PLACEHOLDER ESTIMATE.
36 | Battery: small lithium (motorcycle size) | 12 V lithium starting battery, at least 300 CCA and about 12 Ah, with a built-in BMS. About 4.5 lb, in the dry box. Confirm against the 800R starter draw. Cables are in lines 65 and 66. | Drivetrain | 2.11 | 1 | set | $150.00 |  |  | Not ordered | https://www.google.com/search?q=lithium+motorcycle+battery+high+CCA PLACEHOLDER ESTIMATE.
37 | Key switch and lanyard kill switch | On the dash, bottom row. A lanyard switch with a coiled lanyard, and a three-position key switch (off at 12 o'clock, on at 1:30, start at 3:00, spring back to on). Check how the sled DESS key and ECU connect. | Drivetrain | 2.11 | 1 | set | $40.00 |  |  | Not ordered | https://www.amazon.com/s?k=lanyard%20kill%20switch%20marine Estimate.
38 | Throttle pedal and push-pull cable | Hinged 3/16 in foot pedal at Y -2.5 with a crank between the driver's feet, return spring, and about 16 ft of push-pull cable: ahead of the toes, along the starboard side, to the sled throttle. Adapt the cable end to the throttle body. The rib at X 108 is the full-throttle stop. | Drivetrain | 2.11 | 1 | set | $120.00 |  |  | Not ordered | https://www.amazon.com/s?k=universal%20throttle%20cable%20lever%20kit Estimate.
39 | Fire extinguisher, marine, USCG B-I / UL 5-B (for example Kidde Mariner 5), with bracket | About 3-4 lb with bracket. Mounted near the fuel tank but within reach of the driver, not directly over the tank, so a fuel fire does not block it. Also needed for the static test. | Safety | 2.11, 3.1 | 1 | ea | $35.00 |  |  | Not ordered | https://www.amazon.com/s?k=marine%20fire%20extinguisher%205-B%3AC Estimate.
40 | Static test instruments: digital crane scale (1,000 lb), optical tachometer, IR thermometer, sound level meter | Thrust, prop RPM, temperatures, and sound at 50 ft and at the driver seat (decides the second muffler). | Tool | 3.1 | 1 | set | $140.00 |  |  | Not ordered | https://www.amazon.com/s?k=digital%20crane%20scale%201000%20lb Estimate. Sound level meter (A-weighted) about $30.
41 | Test restraint: rated strap/chain and anchor, >= 2,000 lb | Ties the boat/trailer to a fixed anchor through the crane scale. | Tool | 3.1 | 1 | set | $60.00 |  |  | Not ordered | https://www.amazon.com/s?k=2000%20lb%20tie%20down%20chain%20ratchet Estimate.
42 | PPE: ear plugs + muffs, safety glasses / face shields (4 people) | See the static test plan safety section. | Safety | 3.1 | 1 | set | $80.00 |  |  | Not ordered | https://www.amazon.com/s?k=ear%20muffs%20NRR%2030%20safety%20glasses%20kit Estimate.
43 | Prop cage: thin-wall aluminum tube and mesh guard | Two 36 in radius hoops at X 1 and X 11, four legs and eight stringers, with mesh on the front and rim only, none in the prop wake. Bolted to the hull at the leg pads and to the top of the stand by the cage struts (BOM line 56). Provisional design, see reports/Drivetrain_800R_ETEC.md Section 9a; mesh not yet chosen. | Drivetrain structure | 2.12 | 1 | set | $600.00 |  |  | Not ordered | https://www.google.com/search?q=6061+aluminum+tube+1.25+x+0.065+airboat+cage+mesh PLACEHOLDER ESTIMATE.
44 | Twin rudders, horns, hinges and stick linkage | Rudders 8 x 30 in, aluminum honeycomb blades (0.020 in 5052 skins bonded over 1/2 in aluminum hex core, closed edges, solid hard points at the shaft and horn bolts; about 2.8 lb the pair), on 1 x 0.125 in 6061 shafts, hinged at 25% chord. Lower brackets and upper 1 x 0.065 in arms to the aft hoop, horns, tie bar, and about 14 ft of push-pull cable from the stick (rated for at least 30 lbf, 2 in travel or more). Stick forward turns left. | Drivetrain structure | 2.13 | 1 | set | $330.00 |  |  | Not ordered | https://www.google.com/search?q=aluminum+honeycomb+panel+1%2F2+inch Estimate: was $250 with sheet-and-rib blades; honeycomb panel about $80 more.
45 | Raised driver seat and seat frame | Not used: replaced by the seat module (BOM lines 84-87, step 2.17). | Hull | 2.11 | 0 | set | $150.00 |  |  | Not ordered | https://www.google.com/search?q=marine+boat+seat+low+back PLACEHOLDER ESTIMATE.
46 | Navigation lights: Attwood LightArmor NV4012SSR-7 (port), NV4012SSG-7 (starboard), and an all-round white LED | Sidelights on the hull sides at X 108, about 3 ft from the tank and fuel fittings (E-11 ignition protection, no bow light). The hull side leans out about 27 degrees, so fit a wedge to hold each light vertical. Check the USCG certificate for these part numbers. All-round white on the cage. | Safety | 2.11 | 1 | set | $210.00 |  |  | Not ordered | https://www.google.com/search?q=LED+boat+navigation+lights+portable PLACEHOLDER ESTIMATE.
47 | Clutch lever on the steering stick, with parking lock and clutch switch; long clutch cable (about 5-6 ft) | Not needed: the 800R E-TEC drives the belt straight off the crank (no gearbox or clutch). Motorcycle or ATV clutch lever clamped to the stick grip; the lock holds the clutch in for starting and idling with the prop stopped; the switch keeps the bike start interlock. Custom-length cable from the stick to the engine clutch arm, with a slack loop at the stick pivot. | Drivetrain | 2.11 | 0 | set | $90.00 |  |  | Not in the 800R build | https://www.google.com/search?q=ATV+clutch+lever+parking+lock+switch+custom+clutch+cable PLACEHOLDER ESTIMATE: lever about $30-50, custom cable about $40-60.
48 | LED light bar, 20 in single row, marine | About 100 W, 7.2 A at 13.8 V, about 5 lb; mounted on top of the prop cage with a bracket (about 6 lb total). Aim it forward, clear of the cage mesh and prop. Check the engine charging output (see release notes). | Lights | 2.11 | 1 | ea | $180.00 |  |  | Not ordered | https://blackoakled.com/products/30-inch-marine-series PLACEHOLDER ESTIMATE: 30 in marine bars list about $200-450; Black Oak Pro 3.0 single row 30 in: 150 W, 10.3 A, 8.6 lb.
49 | Motorized remote searchlight (Golight Stryker LED class) with remote | LED, about 3.7 A at 13.8 V, about 6-7 lb; mounted on top of the prop cage (about 8 lb with mount). Remote at the dash or on the stick. | Lights | 2.11 | 1 | ea | $450.00 |  |  | Not ordered | https://nomadicsupply.com/golight-stryker-black-led-search-spot-light-w-wireless-remote-30515st/ PLACEHOLDER ESTIMATE: Golight Stryker LED with wireless remote; 3.7 A; listed weights 6-7 lb.
50 | Florida airboat flag: 10 x 12 in international orange, on a 10 ft fiberglass whip, with a fold-down mount | Florida requires the flag at least 10 ft above the lowest part of the boat (Fla. Stat. 327.391; check the current FWC rule). Mount it on the aft side of the prop cage so the prop blast blows it away from the blades, never forward of the prop. Fold-down mount for trailering, bridges and power lines. About 2 lb. | Safety | 2.11 | 1 | set | $75.00 |  |  | Not ordered | https://www.google.com/search?q=airboat+safety+flag+whip+10+ft+orange PLACEHOLDER ESTIMATE: whip, flag and mount about $50-100.
51 | Compact can air horn in a clip | Mounted at the driver (on the stick or the dash) within easy reach. USCG sound-producing device. About 0.5 lb. Keep a spare can. | Safety | 2.11 | 1 | ea | $20.00 |  |  | Not ordered | https://www.google.com/search?q=marine+air+horn+with+bracket PLACEHOLDER ESTIMATE: canned marine air horn and bracket; a 12 V electric horn is about $60.
52 | Inflatable life jackets (PFDs), USCG approved, 2 | One per person aboard. About 1.5 lb each. Inflatables count only when worn: wear them, and check the rating and the age limit on the label. | Safety | 2.11 | 2 | ea | $120.00 |  |  | Not ordered | https://www.google.com/search?q=USCG+approved+type+III+life+jacket PLACEHOLDER ESTIMATE.
53 | Stand tube, 2 x 2 x 1/8 in 6061-T6 square | Aft posts (2 x 54 in) and engine rails (2 x 27 in), about 162 in. Bolted, with 1/4 in gussets from BOM line 19. | Drivetrain structure | 2.8 | 16 | ft | $7.00 |  |  | Not ordered | Price estimate. Check with a local metal supplier.
54 | Stand tube, 1-1/2 x 1-1/2 x 1/8 in 6061-T6 square | Forward posts (2 x 43 in), diagonals (2 x 56 in), top rails (2 x 12 in), three ties (15 in), about 267 in. | Drivetrain structure | 2.8 | 24 | ft | $5.50 |  |  | Not ordered | Price estimate. Check with a local metal supplier.
55 | Stand cross-strap, 1 x 1/8 in 6061 flat bar | Two straps of about 35 in, an X on the forward face of the diagonals below the cylinders. Tension only. | Drivetrain structure | 2.8 | 6 | ft | $2.50 |  |  | Not ordered | Price estimate. See reports/Drivetrain_800R_ETEC.md Section 9a.
56 | Cage strut, 1 x 0.065 in 6061 round tube | Two struts of about 29 in from the forward hoop to the top of the stand, with end brackets. Add rubber isolators if vibration calls for them. | Drivetrain structure | 2.12 | 5 | ft | $4.00 |  |  | Not ordered | Price estimate. See reports/Drivetrain_800R_ETEC.md Section 9a.
57 | Electrical dry box, 0.063 in 5052, 8 x 10 x 7-1/4 in, with 0.080 in lid | Hung between the two seat struts (X 77.5-85.5, Y +/-5, Z 3.75-11): riveted, sealed corners, 3/4 in angle flange around the top with eight #10-24 rivnuts, closed-cell neoprene gasket, battery pad and strap, fuse block bracket over the battery so the fuses face the lid. Cable glands are in line 73. About 3.9 lb. Replaces the waterproof case set into the middle bench. | Hull | 2.17 | 1 | ea | $85.00 |  |  | Not ordered | Estimate: sheet and angle about $40, gasket, rivnuts and bolts about $45.
58 | Power hub: 12-way marine fuse block with negative bus | In the dry box. Fuses F1 to F6 and F8; F7 is inline at the battery (line 71). See electrical/Minimal_1448_Electrical_Schematic.pdf. | Electrical | 2.11 | 1 | ea | $60.00 |  |  | Not ordered | Estimate.
59 | Fuel gauge sender and gauge | Isolated two-wire top-mount sender in the plastic tank (match its ohm range to the gauge and the tank depth, about 8 in), 2 in gauge on the dash. | Drivetrain | 2.11 | 1 | set | $70.00 |  |  | Not ordered | Estimate.
60 | Console frame and dash pod | 1 x 0.095 in 6061 tube post and arm, on a foot on the rib at X 108 and a bracket on the starboard gunwale; 0.063 in sheet pod. Underside at Z 24. | Hull | 2.11 | 1 | set | $75.00 |  |  | Not ordered | Estimate. Reports/Drivetrain_800R_ETEC.md Section 9c.
61 | Steering stick and heel rests | 1-1/2 x 0.120 in 6061 stick with pivot cheeks on the rib at X 95, a stop on the cheeks, and a grip; two 1 in half-rounds, 6 in long, held by the UHMW screws. | Hull | 2.11 | 1 | set | $65.00 |  |  | Not ordered | Estimate.
62 | Analog tachometer, temperature gauge and exhaust temperature gauge | 3-3/8 in tach, 2-1/16 in coolant temperature gauge, and 2-1/16 in exhaust gas temperature gauge with its probe in the tuned pipe, top row of the dash. Match them to the 800R signals. The gas gauge is in line 59. | Electrical | 2.11 | 1 | set | $180.00 |  |  | Not ordered | Estimate.
63 | Dash switches and power ports | USB charging port and 12 V / 20 A outlet, each with a rubber weather flap, searchlight on/off switch, three-position rotary lights switch (off, running, LED bar). The searchlight joystick comes with line 49 or is added to it. | Electrical | 2.11 | 1 | set | $90.00 |  |  | Not ordered | Estimate.
64 | Adjustable marine phone or tablet holder | Light ball-and-arm mount with a sliding clamp cradle that takes a phone or a small tablet, through-bolted to the left side of the dash pod. About 0.8 lb without the device. | Hull | 2.11 | 1 | ea | $60.00 |  |  | Not ordered | Estimate. Reports/Drivetrain_800R_ETEC.md Section 9e.
65 | Battery cable, 2 AWG marine, red and black | W01, W02 and W57, about 16 ft in all, with ring terminals. | Electrical | 2.11 | 16 | ft | $4.00 |  |  | Not ordered | Estimate. See electrical/Wire_List.csv.
66 | Main feed, 6 AWG marine, red and black, with a 6 AWG fusible link for W57 | W03, W04 and the link at the battery, on W57. | Electrical | 2.11 | 1 | set | $25.00 |  |  | Not ordered | Estimate. See electrical/Wire_List.csv.
67 | Marine primary wire, 12 AWG tinned, red, black and brown | W05 to W08, W20, W21, W53, W55. | Electrical | 2.11 | 65 | ft | $1.00 |  |  | Not ordered | Estimate. See electrical/Wire_List.csv.
68 | Marine primary wire, 16 AWG tinned, all colors (18 AWG for W47 to W49) | Red, black, orange, purple, dark gray, brown, tan, pink, and striped yellow/red, brown/white, gray/blue, gray/red, white/blue. 18 AWG white and striped white to match the sled DESS harness. Colors follow ABYC E-11; see reports/ABYC_E11_Review_v1.0.0.5.md. | Electrical | 2.11 | 315 | ft | $0.60 |  |  | Not ordered | Estimate. See electrical/Wire_List.csv.
69 | Type K thermocouple extension and exhaust probe | W46, about 13 ft, and the probe in the tuned pipe. In place of the probe in line 62 if that gauge has none. | Electrical | 2.11 | 1 | set | $40.00 |  |  | Not ordered | Estimate. See electrical/Wire_List.csv.
70 | Relays, 12 V 30 A sealed, 5 | K1 to K5, in the dry box. | Electrical | 2.11 | 5 | ea | $8.00 |  |  | Not ordered | Estimate. See electrical/Wire_List.csv.
71 | Main fuse: MRBF holder and 60 A fuse; F7 inline fuse holder and 10 A fuse | MF1, on the battery switch output stud. F7, sealed inline holder within 7 in of the battery, for the bilge pump. | Electrical | 2.11 | 1 | set | $50.00 |  |  | Not ordered | Estimate. See electrical/Wire_List.csv.
72 | Connectors and terminals | Deutsch DT 2-pin sets, DT 12-pin for engine J1, sealed ring and spade terminals, adhesive heat shrink. | Electrical | 2.11 | 1 | set | $120.00 |  |  | Not ordered | Estimate. See electrical/Wire_List.csv.
73 | Dash bus strips, cable glands, loom and clips | TB1: 6-screw bar. TB2: 8-screw positive and negative bars. One ring terminal on each screw (E-11 limit: 4 on a stud). Three dry box glands, two sealed hull side glands for the sidelights. 2 in corrugated self-draining conduit, UL 94 V-2, about 5 ft for the floor run, on rib standoffs. Split V-2 loom on the side runs. The harness leaves the dry box through a gland in its aft wall (no bench sleeve). Clips every 18 in, lined metal clamps near the engine, belt and prop and along the cage. | Electrical | 2.11 | 1 | set | $105.00 |  |  | Not ordered | Estimate. See electrical/Wire_List.csv.
74 | Two-wire coolant temperature sender | Separate from the ECM sensor, for the dash gauge. | Electrical | 2.11 | 1 | ea | $25.00 |  |  | Not ordered | Estimate. See electrical/Wire_List.csv.
75 | Automatic bilge pump | About 2 A, near the transom. Fuse F7 is 5 A; use the maker's value if lower. It was in the weight model but had no BOM line. | Electrical | 2.11 | 1 | ea | $45.00 |  |  | Not ordered | Estimate. See electrical/Wire_List.csv.
76 | Battery switch, on/off, marine | On a 1/8 in 6061 plate bolted to the forward seat strut, port of the dry box, knob forward: it works without unbolting the seat. At least 300 A continuous and 600 A intermittent; confirm against the 800R starter. About 0.5 lb. | Electrical | 2.11 | 1 | ea | $45.00 |  |  | Not ordered | Estimate. See electrical/Wire_List.csv.
77 | Starter solenoid, Cole Hersee 24059-08-BP, UL listed | In place of the sled solenoid, for E-11 ignition protection. 12 V, 65 A continuous; 750 A make, 100 A break, 10 s on, 30 min off. Insulated, 5/16-24 power studs. Check the ignition-protected mark on the part, the starter draw, and whether the sled starter has its own solenoid. About 0.6 lb. | Electrical | 2.11 | 1 | ea | $50.00 |  |  | Not ordered | Estimate. Listings show about $37 to $60.
78 | Low oil indicator: red 12 V panel LED, about 1/4 in, sealed, with built-in resistor | On the dash between the temperature and exhaust gauges, driven by the stock sled oil level sensor (part 515176508 on 2008-2014 800R models; buy it if the tank comes without one). Wires W60 to W62. Confirm the sensor closes on low oil. | Electrical | 2.11 | 1 | ea | $10.00 |  |  | Not ordered | Estimate. See electrical/Wire_List.csv.
79 | Small trim tab and turnbuckle | Aluminum tab on the transom, to starboard, with a stainless turnbuckle to set it. Fasten through the transom with sealed bolts and a backing plate. About 3 lb, already in the weight model. | Hardware | 2.13 | 1 | set | $60.00 |  |  | Not ordered | Estimate.
80 | Flotation foam, closed-cell, 2 lb/ft3, about 4.4 ft3, with straps | Bow wedge, two aft corner blocks, two footwell side blocks (6 in thick, X 98-128) and the floors of the two seat storage compartments, added to the foam in the rear bench. About 9.4 lb. Polyethylene, or XPS with a fuel-proof skin. Includes the 0.040 in shield above the port block. The closed-cell seat pad (line 86) counts as flotation too. | Hardware | 2.16 | 1 | set | $170.00 |  |  | Not ordered | Estimate: about $35 per ft3 of polyethylene plank, straps and shield $15.
81 | Round bubble level, 2-3/4 in, and maximum load label | Two-axis bullseye level on a 0.063 in sheet shelf on top of the dash pod, reading to about 5 deg at the rim, UV-resistant. Printed outdoor vinyl label beside it, 6-1/2 x 2-1/2 in. Text in step 2.11. | Hardware | 2.11 | 1 | set | $45.00 |  |  | Not ordered | Estimate: level $30, label $15. Rieker C0007-A is one 2-3/4 in round level; check its range before buying.
82 | Bow backing bars for the UHMW, 2 | 1 x 1/8 in 6061 flat bar, about 44 in long, trimmed to fit. Inside the hull at about X 140 and X 155, where there is no rib. | Hardware | 1.2 | 1 | set | $20.00 |  |  | Not ordered | Estimate.
83 | Closed-end (sealed) aluminum rivets 3/16 in, and a temporary gunwale spreader | About 50 closed-end aluminum rivets to seal the holes the middle bench leaves in the hull sides (set in marine sealant, BOM line 6), plus a padded 2x4 spreader cut to the measured beam, kept in until the new struts are bolted in. | Hull | 2.5 | 1 | set | $25.00 |  |  | Not ordered | https://www.google.com/search?q=3%2F16+closed+end+aluminum+pop+rivets+sealed Estimate: rivets about $15, lumber about $10.
84 | Seat struts: 1 x 2 x 1/8 in roll-wrapped carbon rectangular tube, fiberglass cloth and epoxy, 6061 crush sleeves, G10 shims, 2 x 2 x 1/8 in 6061 angle end clips, 1/4-20 stainless bolts, Tef-Gel | Two struts, about 58.8 in, hull side to hull side at the old bench-top level (Z 9-11, X 76.5 and 85.5): the new thwart, and the support for the seat and the dry box. Carbon, isolated from every aluminum part by one ply of glass over the tube, G10 shims and sleeved stainless bolts in Tef-Gel (carbon touching aluminum corrodes the aluminum). Every fastener through the carbon has a crush sleeve. About 5.6 lb (6061 was 8.7). | Hull | 2.17 | 1 | set | $260.00 |  |  | Not ordered | https://www.google.com/search?q=carbon+fiber+rectangular+tube+1x2 Estimate: 10 ft of carbon tube about $220, glass and epoxy $15, sleeves, shims and Tef-Gel $25 (clips and bolts as before).
85 | Storage compartments: 0.032 and 0.063 in 5052 sheet, piano hinges, latches, gasket, rivets | Four 0.032 in walls under the struts, stopped 1-1/2 in above the floor, and two 0.063 in lids outboard of the seat, hinged on the aft edge, two latches each. About 4.6 lb. | Hull | 2.17 | 1 | set | $110.00 |  |  | Not ordered | https://www.google.com/search?q=stainless+piano+hinge+boat+compression+latch Estimate: sheet $45, hinges $25, latches $30, gasket and rivets $10.
86 | Seat: 3/8 in fiberglass/foam sandwich base (5/16 in PVC foam core, E-glass skins), 2-1/2 in closed-cell polyethylene foam, marine vinyl, adhesive, bolts | 15 x 38 in seat across all three boxes (room for a passenger beside the driver), bolted to the struts over the dry box lid through potted inserts. Strong enough for someone standing on the front edge. About 5.2 lb (with 3/8 plywood it was 7.2). The foam is flotation: closed-cell only. | Hull | 2.17 | 1 | set | $175.00 |  |  | Not ordered | https://www.google.com/search?q=divinycell+H80+5%2F16+foam+core+sheet Estimate: PVC foam core $45, glass cloth and epoxy $45, pad foam $45, vinyl and adhesive $40.
87 | Folding seatback: 1/4 in marine plywood, 1-1/2 and 1/2 in closed-cell foam, marine vinyl, 1/8 in 6061 brackets, 3/8 in stainless pivot and stop | 18 x 15 in, hinged just above the seat foam on two brackets bolted to the aft strut, 12 deg recline against a stop, folds flat forward; padded on its back for sitting facing aft. About 3 lb. | Hull | 2.17 | 1 | set | $70.00 |  |  | Not ordered | https://www.google.com/search?q=boat+seat+back+hinge+bracket+stainless Estimate.
88 | Oars, 7 ft, pair: aluminum shaft, plastic blade, rubber oar stops | For rowing facing aft on the folded seatback (engine off). 24 in inboard of the pin: set the rubber stops there. About 7.2 lb the pair. Operator gear, not boat equipment: bring them or leave them ashore; when aboard they count against the people and gear load on the label. Carbon oars (about 4.5 lb the pair) are the operator's choice. Shipped in the locks along inside each rail, blades forward, strapped to the rests (line 89). | Hull | 2.18 | 1 | pair | $110.00 |  |  | Not ordered | https://www.google.com/search?q=7+ft+aluminum+boat+oars+pair Estimate.
89 | Oarlocks: closed-ring oarlocks and top-mount sockets, 4 in 6061 risers, 1/8 in doublers, 5/16-18 bolts, two oar rests with rubber straps | Risers 1-1/2 x 3 x 4 in 6061, pocketed, on the rails at X 66 (10-1/2 in aft of the seat edge), each with two 5/16-18 stainless through bolts and a 1/8 x 1-1/2 x 4 in doubler under the rail. Closed rings hold the oars when shipped. Rests: 1/8 in 6061 clip on the rail at X 118 with a padded cradle and rubber strap. About 4 lb. | Hull | 2.18 | 1 | set | $95.00 |  |  | Not ordered | https://www.google.com/search?q=closed+ring+oarlock+top+mount+socket Estimate: oarlocks and sockets $40, 6061 bar $25, doublers and bolts $10, rests and straps $20.
 | TOTAL (estimated)

Sheet: Build Guide
Step | Description | Depends on | Can run in parallel with | Detailed instructions | Skills required | MATERIAL: est. cost ($) | MATERIAL: pledged / paid by | LABOR: DIY hours (est.) | LABOR: pro hours (est.) | LABOR: pro cost ($) | LABOR: pledged / done by | Links / basis for estimates | Render image (link)
SECTION 1 - HULL ARMOR
1.1 | Buy a used 1448 jonboat | - | - | 1. Raise the purchase money (see BOM line 1 for the current price estimate). 2. Search Facebook Marketplace, Craigslist (Orange County, LA, Inland Empire, Ventura) and OfferUp for "1448", "14 ft jon boat", "jonboat". Set a saved search / alert. 3. Target: 14 ft long, 48 in bottom width, riveted or welded aluminum, flat bottom with ribs inside. Lowe, Tracker, Alumacraft, Crestliner, Polar Kraft are all fine. A trailer is a big plus. 4. Before visiting, ask for: photos of the bottom and transom, title / registration (CA "pink slip") in the seller's name, and the HIN (hull ID number) on the transom. 5. Inspect in person: look for cracks around the transom and ribs, corrosion (white powder, pitting), dents with creases, and rivets with a dark halo (weeping). Ask to put a few inches of water in the hull (or look at it on the water) and check underneath for drips. 6. Negotiate. If the boat comes with a motor you don't need, factor in its resale value. 7. Pay, get the signed title and a bill of sale, and transfer registration at the DMV within 10 days. 8. Tow it home (check that trailer lights and tires work) or arrange transport. | Fundraising; Use of online 'for sale' forums |  |  | 10 | 0 |  |  | Example ad: https://www.craigslist.org/view/d/thousand-oaks-2006-tracker-1448-fb/3s4MJgxrcb3H5QovNdoBCE DIY hours: ~6 h searching/messaging, ~4 h visiting, inspecting and towing. Pro hours 0: buying is not a hired-out task. | Lowe 1448 hull as purchased (3/4 view from above): renderedImages/buildSteps/step01_used_1448_jonboat.png
1.2 | Add UHMW sheet to the bottom of the hull | 1.1 | 2.1, 2.8 (shop work) | MINIMAL BUILD: 1/8 in UHMW over the whole bottom from the transom to the bow, about 36 lb with fasteners and backing bars. Two 4 x 8 sheets end to end, joined on the rib at X 95.25. The 48 in sheet leaves about 0.4 in of bare hull along each chine, and the bottom narrows forward of about X 112, so trim to fit there. 1/8 in is thin: it wears through sooner than 3/16 in, so look it over each season and replace a worn piece. Cut list: aft piece, one full sheet, cut to length. Forward piece, about 48 x 62 in, from the second sheet. Cut it 2 in long and trim it to the bow on the hull. Windows: 3 x 12 in, one under each of the four shoes (X 2 to 13 and X 34 to 45, centered on Y +/-8.5), so the shoe bolt heads in step 2.6 seat on the hull and the sheet can still slide. 1. Flip the hull upside down onto sawhorses or old tires with a helper (about 150 lb). Never work under a hull that is not blocked securely. 2. Clean the bottom: pressure wash, scrape off growth, degrease with acetone. Leak-test first and fix any weeping rivets now; the UHMW will hide them. 3. From inside the hull, measure each rib's distance from the transom and mark it on the outside (approx. 37.9, 54.75, 70.75, 95.25, 108.25 and 122.25 in on the reference hull). Add three rows where there is no rib: X 3, X 140 and X 155. Snap a centerline. Mark eight screws across each row, about 6 in apart, at least 1 in clear of the windows. 4. Check you can reach the X 140 and X 155 rows from inside, under the front shelf, bef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 | Measuring & layout; Power drill; Circular saw (straight cuts); Countersinking; Applying marine sealant; Basic hand tools (wrench, screwdriver); Safe lifting/flipping with a helper |  |  | 18 | 9 |  |  | Sheet outline: Onshape "Minimal 800R layout" part studio (DIY Jon-Air boat document). Screw rows are as listed in this step. Forum practice (bolts + lock nuts + sealant preferred over rivets for UHMW): https://www.southernairboat.com/community/threads/poly-install-screws-rivets-or-bolts.67806/ ; https://www.southernairboat.com/community/threads/how-to-install-uhmw-poly.68961/ Hours: DIY ~2 h flip/clean/layout, ~3 h cutting, ~10 h drilling/countersinking/fastening about 80 bolts with a helper, ~1 h water test, plus contingency. Pro ~half (experienced, better tools). Pro rate on Read Me sheet. | renderedImages/buildSteps/step1.2_uhmw_sheet.png
1.3 | NOT IN THE MINIMAL BUILD - Install chine angles | 1.2 | 2.2-2.5, 2.8 | Not part of this build. The step number is kept so the BOM lines marked "Not in the minimal build" still point here. |  |  |  | 0 | 0
1.4 | NOT IN THE MINIMAL BUILD - Install aluminum bow skin | 1.2, 1.3 | 2.2-2.5, 2.8 | Not part of this build. The step number is kept so the BOM lines marked "Not in the minimal build" still point here. |  |  |  | 0 | 0
SECTION 2 - INSTALL DRIVETRAIN AND PROP CAGE |  |  |  | MINIMAL BUILD: a Rotax 800R E-TEC snowmobile two-stroke driving the prop through one 8MGT belt, on a bolted aluminum stand, with a smaller aluminum cage. The rear bench stays. The middle bench is replaced by the seat module (2.17): two struts across the boat, an electrical dry box, dry storage each side, a closed-cell foam seat for two and a folding seatback. Design details are in reports/Drivetrain_800R_ETEC.md; wiring is in electrical/Minimal_1448_Electrical_Schematic.pdf and electrical/Wire_List.csv. Dimensions use the CAD frame: X forward from the transom, Y + to port, Z up from the hull bottom, all in inches. They come from a reference model of a Lowe 1448. Check them on your own hull, and stop if anything differs by more than 1/2 in. Approach: build the stand and drivetrain as a module off the boat and lower it onto waiting shoes. Then connect the systems, build the cage around the real prop position, and fit the prop last. Step 2.16 can be done any time after 2.13. Step 2.17 is listed last but is done right after 2.5: its struts replace the bench as the thwart, and the electrical work in 2.11 needs its dry box. Step 2.18 (oarlocks) can be done any time after 2.17. Finish all three before the sign-off in 2.14.
2.0 | Choose your prop (standard 3-blade, or the quieter 4-blade) | - | 1.1, 1.2 | Decide this before building the belt reduction (step 2.8): the prop sets the large pulley size. STANDARD (this guide and the BOM): Warp Drive 3-blade airboat prop with HP blades, cut to 66 in (BOM line 32, $1,275 plus face plate and flange). Belt 8MGT 32T / 94T. Prop about 2,590 rpm at 7,600 engine rpm, tip speed about 745 ft/s. QUIETER OPTION: Warp Drive 4-blade with HP blades, cut to 66 in ($1,680, about $405 more, plus about $30 for a larger pulley). It turns about 10% slower for the same power: about 2,340 rpm, tip speed about 675 ft/s. Thrust and top speed are about the same; it runs smoother and is noticeably quieter for the operator and from shore: about 3-4 dBA less prop noise at 50 ft (estimate). The total gain depends on the exhaust: with a loud exhaust it is only about 1-1.5 dBA, so fit a good muffler either way. Neither version is expected to meet the California shoreline limit (75 dB(A), SAE J1970): estimates are about 82-84 dBA (3-blade) and 79-82 dBA (4-blade) at 50 ft. Florida's airboat law (s. 327.391) requires a muffler but gives no decibel figure in the statute. The stock silencer is the muffler here. IF YOU CHOOSE THE 4-BLADE, change these when you build: 1. BOM line 32: order the 4-blade (Warp Drive HP blades, 4-blade, up to 74 in, $1,680), cut to 66 in, with the same SAE #2 face plate and flange. 2. BOM line 31: order the large (prop shaft) pulley as 8MGT 104T instead of 94T. The small (crank PTO) pulley stays 32T. 3. Belt length: with the 52T pulley t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 | Reading a spec sheet; comparing options |  |  | 1 | 0 |  |  | https://warpdriveprops.com/warpdrivepropsairboats/ Prices: Warp Drive airboat page (HP blades). Noise: estimate from the Hamilton Standard empirical prop-noise method; see reports/Drivetrain_800R_ETEC.md, Sections 5 and 6.
2.1 | Verify the layout on your boat and make templates | 1.1 | 1.2 (if not yet done) | Goal: confirm the design fits your hull before cutting anything. 1. Measure from the transom and centerline: rib positions, rear bench (about X 13-33, top about Z 13.7), middle bench (about X 75.5-89.5, top about Z 12.5), gunwale height, transom height. 2. Check what the design depends on: - Bench panels: their gauge, how they fasten to the hull, and whether they stop at about Z 2.4. - Corner caps: whether they are aluminum and strong enough to carry a cage leg. - Rear bench: confirm it is full of sound foam, because the capsize flotation in step 2.16 relies on it, and that the access pocket is practical. - Middle bench: it comes out in 2.5. Note how it is fastened to the hull sides, ribs and floor, and measure the beam across the gunwales at the bench. - Rib height at Y +/-8.5, and the hull bottom gauge. - Transom condition around Z 4.5, where the clips bolt on. - Front deck: strength under 45 lb of fuel, and how to fasten the straps. - Rib height where the stick base and console foot land. 3. Weigh and measure the engine, tuned pipe, silencer, oil tank and radiator. Update the layout if they differ from the CAD envelopes, and choose the engine roll angle so the stock pipe fits. The engine sits about X 14-30. 4. Cut 1/4 in plywood templates for the four shoes, four cage foot pads, and the dry box, battery switch and harness sleeve once the seating redesign sets their places. 5. Lay them out in the boat and write the measured numbers on them. Photograph everything. If anyth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 | Measuring and layout; Reading the CAD model; Basic woodworking (templates) |  |  | 8 | 4 |  |  | reports/Drivetrain_800R_ETEC.md Sections 9b and 9c list these hull checks. | renderedImages/buildSteps/step2.1_layout_top_view.png
2.2 | Fabricate the shoes, doublers and clips (shop) | 2.1 | 2.3, 2.4, 2.5, 2.8 | Goal: four separate shoes, not continuous beds, so the rear bench and its flotation stay uncut. 1. Aft shoes (2): 2 x 3 x 1/8 in 6061 tube, X 2-12.75, at Y +/-8.5. 2. Forward shoes (2): the same tube, X 34-44, notched over the rib at X 36-39.5. Leave about 0.08 in over the rib top, so a hard landing bears on the rib. 3. Doublers, 1/8 in 5052: 5 x 10.5 in under each aft shoe. Under each forward shoe, two 6 in wide pieces, cut around the rib. 4. Clips: 2 x 2 x 1/8 in angle, 3 in wide. One at each end of each aft shoe, to the transom and to the rear bench's aft panel. 5. Drill for six 1/4-20 bolts per shoe. Cut a crush sleeve for each bolt, so the bolts can be tightened without collapsing the tube. 6. Deburr everything. Round all corners. | Cutting aluminum; Drilling; Layout from templates |  |  | 6 | 3 |  |  | Sizes from reports/Drivetrain_800R_ETEC.md Section 9b and CAD/analysis/stand_800r.js. | renderedImages/buildSteps/step2.2_shoes_and_clips.png
2.3 | Cut and drill the stand side frames (shop) | 2.1 | 2.2, 2.4, 2.5, 2.8 | Goal: all stand parts cut and drilled, ready to bolt together in 2.8. No welding is needed. Side frames at Y +/-8.5, 6061, 1/8 in wall: 1. Aft posts: 2 x 2 in, X 9, from the shoe to Z 57. 2. Rails: 2 x 2 in, Z 14.9, from X 9 to about X 36. They clear the bench top by only 0.2 in; add a rubber strip if they touch under load. 3. Forward posts: 1-1/2 x 1-1/2 in, X 21, from the rail to Z 56.75. 4. Top rails: 1-1/2 x 1-1/2 in, Z 56, X 9-21. 5. Diagonals: 1-1/2 x 1-1/2 in, from the top of the forward post down to the forward shoe at X 40. 6. Ties across the boat: 1-1/2 x 1-1/2 in, at X 9 Z 14.9, X 9 Z 56 and X 21 Z 56. 7. Cross-straps: two 1 x 1/8 in flats in an X on the forward face of the diagonals, below the cylinders. 8. Gussets: 1/4 in 6061 at the joints, with four 5/16 in bolts on each side of each joint. Drill them as templates so both side frames match. The rail is the most heavily loaded member, with a load factor of about 1.4 assuming engine mounts at X 17 and X 27. If your real mounts differ, recheck it with CAD/analysis/stand_800r.js. | Cutting aluminum; Accurate drilling; Layout; Reading drawings |  |  | 8 | 4 |  |  | Stand is bolted, not welded. Frame sizes from CAD/analysis/stand_800r.js and CAD/FeatureScript/Minimal_layout.fs. | renderedImages/buildSteps/step2.3_stand_frames.png
2.4 | Fabricate cage foot pads and backing plates (shop) | 2.1 | 2.2, 2.3, 2.5, 2.8 | 1. Aft pads (2): 1/8 in 6061, 4 x 3 in, for the transom corner caps, at about X -1 to 3 and Y +/-29.75 to 32.75. 2. Forward pads (2): 1/8 in 6061, 5 x 4 in, for the rear bench top, at about X 13.25-18.25 and Y +/-27.5 to 31.5. 3. A matching backing plate for each pad. 4. Drill four 1/4-20 holes through each pad and backing plate as a pair, and mark them so they stay matched. 5. Round the corners and deburr. | Cutting aluminum; Drilling; Layout |  |  | 3 | 1.5 |  |  | reports/Drivetrain_800R_ETEC.md Section 9b. | renderedImages/buildSteps/step2.4_cage_pads.png
2.5 | Remove the middle bench; open the rear bench access pocket (boat) | 2.1 | 2.2, 2.3, 2.4, 2.8 | Goal: the middle bench out of the boat, every hole it leaves sealed, and the hull held to its measured beam until the new struts go in. The new seat, electrical dry box and storage compartments replace it (seating redesign, v1.0.1.3). Middle bench (about X 75.5-89.5, top about Z 12.5): 1. Before anything else, measure and photograph: the beam across the gunwales at the bench, and every rivet and bracket that holds the bench to the hull sides, ribs and floor. The new gunwale struts and dry box use the same locations. 2. Clamp a temporary spreader across the gunwales at the bench (a 2x4 cut to the measured inside beam, padded at the ends). The bench is the boat's main thwart: leave the spreader in until the new struts are bolted in, and do not lift, trailer or launch the boat without it. 3. Drill out the rivets that hold the bench: use a bit the size of the rivet shank, only through the head, then punch the shank out. Do not enlarge the holes in the hull skin. 4. Lift the bench out whole, with its foam. Record the foam volume (about 14 x 61 x 11 in of bench, less the panels): the capsize flotation relied on it, and the seating redesign restores it. 5. Seal every empty hole: the bench ends sit low on the hull sides, near or below the waterline. Fill each with a 3/16 in closed-end (sealed) aluminum rivet set in marine sealant, unless the new struts will reuse it; tape the ones to be reused. 6. Clean the old sealant and any corrosion from the bench footprint. Do not cut or drill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 | Drilling out rivets; Riveting; Measuring; Foam work; Marine sealant |  |  | 5 | 2.5 |  |  | Middle bench removed for the seating redesign (reports/Release_Notes_v1.0.1.3.md). Rear bench stays uncut except for the access pocket. Flotation must be preserved. E-11 review items 5 and 7: reports/ABYC_E11_Review_v1.0.0.5.md.
2.6 | Install the shoes and doublers (boat) | 2.2, 2.5 | 2.4, 2.8 | Goal: four shoes tied to the bottom, the rib, the transom and the bench panel. 1. Dry-fit all four shoes on their doublers. Check they are parallel, at Y +/-8.5, and level across the boat. 2. Drill through shoe, doubler and bottom from inside. Fit the crush sleeves. 3. Bolt with six 1/4-20 stainless bolts per shoe and sealant in every hole. Use truss heads outside. The bolts pass through the window cut in the UHMW sheet in step 1.2, so the heads seat on the hull. 4. Aft shoes: fit the clips to the transom (about Z 4.5) and to the rear bench's aft panel. These carry the uplift: about 394 lbf per side at full power, so don't skip them. 5. Forward shoes: check the rib notch. The shoe should nearly touch the rib top, with about 0.08 in of clearance. 6. Water-test the bottom and fix any weeps before going on. | Drilling aluminum; Measuring and leveling; Bolting with a helper; Marine sealant |  |  | 8 | 4 |  |  | Bottom bolts at Y +/-8.5 fall in the windows in the UHMW sheet. | renderedImages/buildSteps/step2.6_shoes_installed.png
2.7 | Install the cage foot pads (boat) | 2.4, 2.5 | 2.6, 2.8, 2.9 | 1. Aft pads: bolt to the transom corner caps with backing plates and four 1/4-20 bolts each, at about Z 17.9. 2. Forward pads: bolt to the rear bench top next to the hull side, with backing plates reached through the access pocket from 2.5. 3. Check that the pads are level across the boat and at the right height for the cage legs. 4. Refill and seal the access pockets. 5. Water-test. | Drilling aluminum; Measuring and leveling; Bolting with a helper; Marine sealant |  |  | 4 | 2 |  |  | Tailpipe passes about 0.85 in from the port aft pad: shield it if the pad runs hot. | renderedImages/buildSteps/step2.7_cage_pads_installed.png
2.8 | Build the stand and drivetrain module (shop) | 2.1, 2.3 | 2.2, 2.4-2.7 (biggest parallel task) | Goal: the whole drivetrain built and checked on the floor as one liftable unit. Stand: 1. Use a plywood jig with the shoe spacing. Bolt up both side frames, ties, gussets and cross-straps. Bearing plates (BOM line 31, cut by a waterjet or CNC shop): 2. Aft plate 3/8 in 6061 at X 8, forward plate 1/2 in 6061 at X 20. Each has two petals either side of the bearing, a 1/2 in rib, a 1 in border, and solid ends with the tensioning slots. 3. Round and polish every cut edge. Tool marks are where fatigue cracks start. Anodize if you want the finish. 4. Bolt the plates between the side frames, with jack bolts for belt tension. Prop shaft: 5. 1-1/2 in 4140 shaft on a tapered-roller flange bearing forward (carries the thrust) and a UCF208-24 ball bearing aft. Fit two clamp collars either side of the forward bearing's inner ring. The set screws only locate it. 6. Fit the 94T pulley (104T for the 4-blade) at about X 13. Both pulleys must be flanged and dynamically balanced. Engine: 7. Confirm the PTO taper and side load from the service manual before machining the 32T hub. If the manual can't confirm the side load, add an outboard support bearing. 8. Mount the engine on the sled rubber mounts, crank along X, PTO aft, crank at Z 22.72, 0.72 in higher than the original layout. That gives 29.28 in centers for the 8MGT-2000-36 belt. 9. Fit the belt. Align the pulleys with a straightedge and keep the shafts parallel. Tension a new belt with the jack bolts to 457 to 499 lb static, or 33 to 36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 | Mechanical assembly; Engine mechanics; Torque wrench use; Reading drawings; Belt tensioning |  |  | 28 | 14 |  |  | reports/Drivetrain_800R_ETEC.md Sections 3-6a; CAD/analysis/bearing_plate.js; CAD/analysis/radiator_800r.js. Run FEA on the forward bearing plate before ordering it. | renderedImages/buildSteps/step2.8_drivetrain_module.png
2.9 | Rig the lift and do a trial lift (shop) | 2.8 | 2.7 | 1. Set up an engine hoist or gantry rated for at least twice the module weight, with rated slings and shackles. 2. Lift 2 in off the floor and hold for 5 minutes. Check balance, that the stand does not rack, and that nothing touches the slings. 3. Plan the path into the boat: boat on its trailer, chocked, tongue on a stand, area clear. Never put any part of your body under a suspended load. | Rigging and safe lifting; Engine hoist operation |  |  | 3 | 1.5 |  |  | Module about 150-170 lb plus stand; use your measured weight.
2.10 | Lower the module into the boat and bolt it down (boat, 3 people) | 2.6, 2.9 | - | 1. Lift and move slowly over the boat, with one person on the hoist and two guiding. 2. Lower the rails over the rear bench. They clear the bench top by only 0.2 in, so go slowly. 3. Land the aft posts on the aft shoes and the diagonals on the forward shoes. Line up the holes with drift pins. 4. Bolt down with threadlocker. Torque and stripe. 5. Check that nothing touches the benches, hull or ribs, and that the engine mounts aren't bottomed. 6. Check the module against the hull: engine to stand about 0.75 in, and the pipe's 4-6 in from the belt and bearings. | Rigging; Teamwork (3 people); Torque wrench use |  |  | 4 | 2 |  |  | Render shows the module in place (no crew). | renderedImages/buildSteps/step2.10_module_installed.png
2.11 | Connect electrical, fuel, oil, cooling, exhaust and controls (boat) | 2.10, 2.17 | 2.12, 2.13 | Do the wiring with the battery disconnected. Work from the schematic and wire list; each wire has a number, so label both ends. Cockpit: 1. Dry box (built in 2.17): battery strapped on its pad, fuse block on its bracket over the battery with the fuses facing the lid, relays K1-K5 on their strip. 2. Battery switch on its plate on the forward seat strut, port of the box, knob forward; its cables enter the box through the forward gland. 3. Console: foot plate on the rib at X 108, post, and arm to the gunwale. Mount the pod, gauges, switches and phone holder. Drill the low oil LED between the temperature and exhaust gauges. 4. Fuel tank on the front deck step, X 134-152, strapped down, with the sled pump module and gauge sender. 5. Fire extinguisher upright on the starboard footwell foam block, by the driver's right knee, about X 99.5, Y -25, in a bracket strapped to the block and the hull side. Air horn in its clip. Wiring: 6. Main power: W57 from the battery, with the 6 AWG fusible link, to the switch; W01 from the switch to the starter solenoid; W03 from the switch through MF1 to the hub; W02 and W04 for the negative side. 7. F7 and the bilge pump feed are inline at the battery, ahead of the switch, so the automatic pump always has power. 8. Harness forward: out through the gland in the dry box forward wall (Y 3.8, Z 8), under the forward strut, at Z 10 or lower under the seat base, and up to the hull side only outboard of the seat edge. Harness aft: through the gland in the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 | Marine wiring and crimping; Fuel system basics; Cooling system; Cable routing; Working from a schematic |  |  | 48 | 24 |  |  | electrical/Minimal_1448_Electrical_Schematic.pdf; electrical/Wire_List.csv; reports/ABYC_E11_Review_v1.0.0.5.md. Hours up from 10: 62 wires, the dash, the cockpit and five engine systems. | renderedImages/buildSteps/step2.11_systems_connected.png
2.12 | Build the prop cage around the prop position (boat) | 2.7, 2.10 | 2.11, 2.13 | Goal: a cage built to the real prop position, with a way to fit the prop last. 1. Make a prop template: a 3/4 in plywood disc, 66 in diameter, bolted to the hub in place of the prop. Turn it by hand. 2. Build two hoops, 36 in radius, at X 1 and X 11, four legs at Y +/-30.5 on the pads from 2.7, and eight stringers. 3. Fit the two 1 x 0.065 in struts from the forward hoop to the top of the stand at X 21. Use rigid struts, never wires: a failed wire ahead of the disc can be drawn into the prop. Add rubber isolators at the strut ends if vibration calls for them. 4. Check clearance with the template: at least 2 in all round, and at least 2 in to the stand and bearing plates. The aft bearing corners and the aft hoop are tight, so check them against the real hub. 5. Make one section removable with bolts, big enough to pass the prop through. Label it. 6. Fit the mesh guard on the front and rim only, never in the prop wake: mesh there costs about 220 lbf of thrust. The cage is not a step. Remove the template. 7. Cage top: 20 in LED bar, searchlight and all-round white light. Connect their wires. 8. Flag: orange 10 x 12 in flag on the fold-down fiberglass whip, on the aft side of the cage, at least 10 ft above the bottom. Check the current FWC rule. | Mechanical assembly; Measuring; Tube bending or a bending shop; Bolting |  |  | 16 | 8 |  |  | reports/Drivetrain_800R_ETEC.md Sections 9a and 9b. The mesh is not yet chosen and the cage is a provisional design: check the tube size before ordering. | renderedImages/buildSteps/step2.12_prop_cage.png
2.13 | Install the stick, rudders and steering linkage | 2.12 | 2.11 | 1. Stick: base plate on the rib at X 95.25, Y 21, with the pivot cheeks. Steering stick, 1-1/2 x 0.120 in, and grip. Fit a stop on the cheeks that takes a hard pull before the rudder cable does. 2. Rudders: 8 x 30 in aluminum honeycomb blades (0.020 in skins over 1/2 in hex core; buy panel and cut it, close the edges with bonded aluminum channel, and pot solid hard points where the shaft and horn bolt through), hinged at 25% chord, on 1 x 0.125 in 6061 shafts. A 3/4 in shaft fails the load check, so don't downsize. Lower bracket on the aft hoop, upper arm out to the hoop. 3. Linkage: horn on each shaft, tie bar at X 0, and the 4.3 in outboard arm on the port shaft. 4. Cable: about 14 ft, along the port side, across the top of the rear bench to Y 18, under the hoops, to a clamp on the aft hoop. 5. Direction: stick forward turns left. Swap the cable to the other side of the rudder shaft to reverse it, and pick the habit before first running. 6. Set rudder stops at about 25 degrees each way, with equal travel and no binding. Check the tie bar at full rudder: it clears the hoop by only about 0.13 in at center. 7. Cotter pins or safety wire on every pivot. 8. Trim tab: fit the small tab and turnbuckle on the transom, to starboard (BOM line 79), with sealed bolts and a backing plate. Start it neutral. 9. Weigh before fitting: the two rudders with shafts, arms, brackets, horns and tie bar (allowance 8.5 lb, itemized about 7.8 lb), and the stick, pedal, cables and heel rests (allow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 | Mechanical assembly; Linkage adjustment |  |  | 8 | 4 |  |  | reports/Drivetrain_800R_ETEC.md Section 9d; CAD/analysis/controls_800r.js. | renderedImages/buildSteps/step2.13_rudders_steering.png
2.14 | Pre-test inspection and sign-off | 2.11, 2.12, 2.13, 2.16, 2.17, 2.18 | - | 1. Work through Part A of reports/Static_Test_Protocol_Drivetrain.md. 2. Re-torque all structural bolts and check every torque stripe. 3. Nothing loose inside the cage or the boat. Flotation foam strapped. Seat bolted down, storage lids latched, seatback stop in. Oars shipped and strapped. Fluids full, no leaks. Belt tension checked. 4. Oil line bled, coolant bled, low oil light tested. 5. Connect the starter. Turn the engine by hand first to confirm the prop's rotation. 6. Two people sign the checklist. | Inspection; Torque wrench use |  |  | 2 | 1 |  |  | reports/Static_Test_Protocol_Drivetrain.md (Part A)
2.15 | Install the propeller (last step before testing) | 2.14 | - | 1. Lock out: key out, lanyard off, battery switch off. 2. Remove the cage section from 2.12. 3. Inspect the prop for damage. Check static balance and blade track, within 1/16 in. 4. Mount it with the face plate and the maker's bolts. Warp Drive HP: 3/8 in mounting bolts to 30 ft-lb in 5 ft-lb steps; 1/4 in blade clamping bolts to 10 ft-lb in 2 ft-lb steps, torqued at the nuts. Star pattern. Torque stripe or safety wire. 5. Turn it by hand. Check at least 2 in of tip clearance all round, and that nothing touches. 6. Reinstall the cage section. 7. Set the blade pitch on a tied-down run so the engine reaches 7,400 to 7,500 rpm at full throttle, never over 7,900 engine rpm or 3,200 prop rpm. The maker recommends static rpm 400 to 500 under the engine maximum. Adjust in 1 degree steps, within 6 to 18 degrees. 8. Re-torque the prop bolts after the first run, then check them at 5 hours, at 50 hours, and at least yearly. Limit full throttle tied to the dock to about 1 minute at a time, and watch the temperature. | Mechanical assembly; Torque wrench use; Prop balancing and tracking |  |  | 3 | 1.5 |  |  | Follow the prop maker's installation and torque instructions; they override this guide. Get the maximum rpm at 66 in from Warp Drive before ordering. | renderedImages/buildSteps/step2.15_propeller.png
2.16 | Fit the flotation foam | 2.13 | - | Foam so the boat floats level upside down. Analysis: CAD/analysis/flotation_inverted.js (v1.0.1.3). It relies on the rear bench being full of sound foam: check it first. The middle bench is gone; its flotation is replaced by the seat compartment floors and the closed-cell seat pad (both fitted in 2.17) and the two footwell side blocks below. 1. Rear bench foam: keep it intact. Cut only what steps 2.5 and 2.6 need, and seal the cut faces. 2. Foam: closed-cell, 2 lb/ft3, fuel resistant: polyethylene, or XPS sealed in a fuel-proof skin. Not beadboard. 3. Bow wedge: 2 x 43.6 in, about 7.5 to 7.9 in deep, at the forward end of the space under the front shelf (X 154-156). Cut it to fit the hull bottom. 4. Aft corner blocks, two the same: 10 in long (X 3-13), from Y 10.5 out to the hull side, Z 2 to 10. About 14.4 in wide at the bottom and 18.4 in at the top. Cut them to fit the hull side. 5. Port block: put a 0.040 in aluminum shield between it and the tailpipe above, or trim it to keep 9 in from the pipe. 6. Footwell side blocks: 6 in thick against each hull side, Z 1.5 to 13, from X 98 to X 128, forward of the stick base. Leave a gap in the starboard block at X 106-110 for the console foot. Cut each to the hull side. The fire extinguisher stands on top of the starboard block. 7. Strap all the blocks in place with stainless or aluminum hardware. Keep them clear of the bilge pump and hose, and leave a drain path under them. 8. When the boat is finished, roll it in shallow water w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 | Measuring; Foam cutting; Mechanical assembly |  |  | 4 | 1.5 |  |  | reports/Flotation_Inverted_v1.0.1.2.md; CAD/analysis/flotation_inverted.js. | reports/Flotation_Inverted_Layout.png
2.17 | Build and install the seat module: struts, electrical dry box, storage compartments, seat and seatback (boat) | 2.5 | 2.2, 2.3, 2.4, 2.8 | Goal: the seat module where the middle bench was. Do it right after 2.5: keep the gunwale spreader in until the struts are bolted, and 2.11 needs the dry box. CAD: CAD/FeatureScript/Minimal_cockpit.fs (seat module). Struts (the new thwart): 1. Two 1 x 2 x 1/8 in roll-wrapped carbon tubes, top at Z 11 (the old bench-top level), at X 76.5-77.5 and X 85.5-86.5. Cut each to the measured inside width less about 3/4 in (about 58.8 in) with a diamond blade, cutting wet or with a vacuum at the blade (P100 respirator). Seal the cut ends with epoxy. Wrap each tube in one ply of fiberglass cloth and epoxy: it keeps the carbon off the aluminum. Drill every hole with a carbide bit and a backing block, and bond a 6061 crush sleeve into each one. 2. End clips: 2 x 2 x 1/8 in angle, 1 in wide, opened to the side flare. Bolt each to the hull side with two 1/4-20 stainless bolts, fender washers inside and sealant (reuse the bench holes where they line up), and to the strut through its crush sleeves, with a G10 shim between clip and strut and Tef-Gel on the stainless bolts: no bare carbon may touch aluminum. Take the spreader out only when all four clips are tight. Electrical dry box: 3. Fold 0.063 in 5052 to 8 x 10 x 7-1/4 in outside (X 77.5-85.5, Y +/-5, Z 3.75-11). Rivet and seal the corners. Rivet a 3/4 in angle flange around the top with eight #10-24 rivnuts. Bolt the box flange to both struts with eight #10 stainless bolts in sleeves, with a G10 shim and Tef-Gel (no aluminum rivets into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 | Measuring; Cutting and bending sheet aluminum; Riveting; Rivnuts; Drilling; Cutting and drilling carbon; Fiberglass layup and epoxy potting; Foam cutting; Upholstery |  |  | 19 | 9.5 |  |  | reports/Release_Notes_v1.0.1.3.md (seating redesign); CAD/FeatureScript/Minimal_cockpit.fs; CAD/analysis/structural_check.js (Seat rows); CAD/analysis/flotation_inverted.js. | renderedImages/buildSteps/step2.17_seat_module.png
2.18 | Fit the oarlocks and oar rests; set up and ship the oars (boat) | 2.17 | 2.16 | Goal: row facing aft on the folded seatback with 7 ft oars, and carry the oars in their locks along inside each rail. Clearances: CAD/analysis/oars.js. CAD: CAD/FeatureScript/Minimal_cockpit.fs (oars). 1. Risers: 1-1/2 x 3 x 4 in 6061, pocketed to about 1/8 in walls, drilled for the oarlock socket. Centre each on the rail at X 66 (10-1/2 in aft of the seat's aft edge). Check the spot first: rudder cable to port, throttle cable and fuel line to starboard run about 4 in below the rail. 2. Bolt each riser through the rail with two 5/16-18 stainless bolts 2-1/4 in apart, a 1/8 x 1-1/2 x 4 in doubler under the rail lip, and sealant. Top-mount socket on the riser; the pin ends up about 9 in above the folded seatback. 3. Closed-ring oarlocks in the sockets. Fit each oar through its ring and set the rubber stop 24 in from the handle end. 4. Oar rests: a 1/8 in 6061 clip on each rail at X 118, with a padded cradle at the height of the ring (about Z 25) and a rubber strap. 5. Ship: swing each oar blade forward in its ring, lay it in the rest and strap it. The starboard oar passes about 4 in above the console arm where it meets the gunwale; the port oar about 10 in outboard of the stick. Neither touches the storage lids opened, the dash, the extinguisher or the sidelights. The handles end at about X 42, clear of the stand. 6. Check on the water, engine off: sit facing aft on the folded seatback, feet braced aft; the hands pass beside the knees, and the elbows clear the stick (about 5 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 | Measuring; Drilling; Machining aluminum (pockets); Bolting |  |  | 3 | 1.5 |  |  | reports/Release_Notes_v1.0.1.3.md (oars); CAD/analysis/oars.js; CAD/analysis/structural_check.js (Oarlock rows). | renderedImages/buildSteps/step2.18_oarlocks_rowing.png
SECTION 3 - STATIC TEST
3.1 | Static test of the installed drivetrain | 2.15 | - | Follow reports/Static_Test_Protocol_Drivetrain.md step by step, with the crew roles and PPE from reports/Static_Test_Plan_Drivetrain.md. Record data on the protocol data sheets, then fill in reports/Static_Test_Performance_Report.md. Do not run the boat on the water until the static test has passed and the report is signed. | Following a test procedure; Engine operation; Data recording; Safety officer role (crew of 4) |  |  | 6 | 4 |  |  | reports/Static_Test_Plan_Drivetrain.md; reports/Static_Test_Protocol_Drivetrain.md; reports/Static_Test_Performance_Report.md
 | TOTAL (estimated)
