acappon/DIY-MiniAirboat/rev0_StitchAndGlue/DIY-Mini-Airboat_Fabrication_r6.xlsx

Sheet: Read me
DIY Mini-Airboat — fabrication workbook (rev 6, detailed joints)
• Sizes come from the detailed CAD (oriented bounding box of each part): L = longest, W = next, T = thinnest, inches.
• Tubes: L is the overall length tip to tip after end cuts and copes; cut 1/2 in long and fit to the actual weldment.
• Plates: 1:1 DXF flat patterns (inches) are in the DXF zip; file names are in the Plates tab. L-brackets and the knee/gusset are shown as their largest face.
• Material: 6061-T6 aluminum unless noted (TIG); cage parts steel (MIG, grind zinc off EMT, ventilate).
• Every steel-to-aluminum contact gets an HDPE isolator and Tef-Gel on the fasteners.
• Engine-side mount brackets and the bellhousing adapter must be drilled to the real G13 block; measure before cutting.
• Placeholders (engine, starter, prop, radiator) are approximate; check clearances on the real parts before welding brackets in place.

Sheet: Cut list (tubes, bars)
Part | Qty | Material / profile | Length (in) | Process / notes
A_frame_leg_2x2x1-8 | 4 | 6061-T6 square tube 2 x 2 x 1/8 | 43.3 | Both ends cut horizontal (3.9 deg off square, parallel); slot 3/8 wide x 2.5 deep on the in/outboard walls at the top
A_frame_crossbar_1-5 | 2 | 6061-T6 square tube 1-1/2 x 1-1/2 x 1/8 | 24.7 | Ends mitred 3.9 deg to fit the leg faces; weld all around
brace_1-5 | 2 | 6061-T6 square tube 1-1/2 x 1-1/2 x 1/8 | 42.5 | Square ends; 1/4 slot each end for the tongue
adapter_tie_1x1x1-8 | 2 | 6061-T6 square tube 1 x 1 x 1/8 | 4.7 | 11/32 cross holes 0.55 in from each end
radiator_cradle_rails | 2 | 6061-T6 square tube 1 x 1 x 1/8 | 9.4 | Between the A-frame peak plates
radiator_lower_angle_1-5x1-5x3-16 | 1 | 6061-T6 angle 1-1/2 x 1-1/2 x 3/16 | 31 | Welded across both cradle rails; 2 grommet holes
radiator_top_stays_3-8_rod | 2 | Steel rod 3/8, eyes both ends | 16.7 | Rubber-bushed at the radiator tank
cage_hoop_aft | 1 | Steel tube 1 x .049 rolled to 72.4 in centerline dia | 73.4 | Have rolled; butt-weld with internal sleeve
cage_hoop_fwd | 1 | Steel tube 1 x .049 rolled to 72.4 in centerline dia | 73.4 | Have rolled; butt-weld with internal sleeve
cage_longitudinals_EMT34 | 8 | 3/4 EMT | 13.2 | Cope both ends to 1 in hoop; grind zinc off before welding
cage_front_bars_EMT12 | 2 | 1/2 EMT | 65.2 | Cope ends to 1 in hoop (aft bars also to the rudder rails)
rudder_rails | 1 | Steel DOM/ERW 1 x .065 | 53.3 | Cope ends to the aft hoop
rudder_rails | 1 | Steel DOM/ERW 1 x .065 | 52.4 | Cope ends to the aft hoop
cage_aft_bars_EMT12 | 2 | 1/2 EMT | 3.8 | Cope ends to 1 in hoop (aft bars also to the rudder rails)
cage_aft_bars_EMT12 | 2 | 1/2 EMT | 48.8 | Cope ends to 1 in hoop (aft bars also to the rudder rails)
cage_aft_bars_EMT12 | 2 | 1/2 EMT | 4.3 | Cope ends to 1 in hoop (aft bars also to the rudder rails)
cage_legs | 2 | Steel DOM/ERW 1 x .065 | 20.1 | Cope to the pad and to the hoop / longitudinal node (1 in and 3/4 in saddles)
cage_legs | 2 | Steel DOM/ERW 1 x .065 | 20.7 | Cope to the pad and to the hoop / longitudinal node (1 in and 3/4 in saddles)
cage_base_rails | 2 | Steel DOM/ERW 1 x .065 | 8.8 | Cope both ends to the legs; lower edge on the pads
rudder_edge_channels | 2 | 6061 channel 3/4 (rudder edges) | 45.5 | Seal all edges
rudder_hinge_tube | 2 | 6061-T6 round tube 1 x .083 | 47.7 | Tapped steel plugs welded/pressed in both ends
rudder_horn | 2 | 6061-T6 round tube 3/4 x .065 + 3/4 block | 4.4 | Coped to hinge tube; 3/8 hole in block for the rod ends
rudder_tie_bar | 1 | Steel tube 5/8 x .065, 3/8 rod ends | 24.5 | Threaded inserts both ends
steering_pushrod | 1 | Steel tube 5/8 x .065, 3/8 rod ends | 103.1 | Threaded inserts both ends
bench_clips_angle | 4 | 6061 angle 1-1/2 x 1-1/2 x 1/8, 2 in long | 2 | 4 clips
footrest_ladder_rails | 2 | 6061 round tube 1 x .065 | 16.8 | Ends cut flat to sit on the foot plates
footrest_ladder_rungs | 5 | 6061 round tube 1 x .065 | 15 | Cope both ends to the rails
bow_shelf_aft_angle_1-5 | 1 | 6061 angle 1-1/2 x 1-1/2 x 1/8 | 68.8 | Ends bolted to the frame-120 webs
bow_shelf_front_angle_1x1 | 1 | 6061 angle 1 x 1 x 1/8 | 32 | Riveted to clips on the three bow stringers

Sheet: Plates (DXF)
Part | Qty | Material / profile | L (in) | W (in) | T (in) | Holes | DXF file | Process / notes
A_frame_peak_plate_3-8 | 2 | 6061-T6 plate 3/8 | 26.1 | 16.7 | 0.38 | 34 | A_frame_peak_plate_3-8.dxf | Pivot hole, +-16 deg arc slot, lightening holes; DXF
A_frame_leg_cap_1-8 | 4 | 6061-T6 plate 1/8 | 2 | 2 | 0.12 | 0 | A_frame_leg_cap_1-8.dxf | Slotted 3/8 for the peak plate; weld to leg top
A_frame_foot_1-4 | 4 | 6061-T6 plate 1/4 | 6.5 | 3 | 0.25 | 2 | A_frame_foot_1-4.dxf | 2 x 13/32 holes at +-2.25 from the leg
A_frame_foot_gussets_1-4 | 8 | 6061-T6 plate 1/4 | 1.8 | 0.8 | 0.25 | 0 | A_frame_foot_gussets_1-4.dxf | Triangular gussets, 2 per foot
brace_tongues_1-4 | 4 | 6061-T6 plate 1/4 | 3.5 | 1.5 | 0.25 | 1 | brace_tongues_1-4.dxf | Tongue with 25/64 hole; welded into the brace end slot
brace_top_tabs_1-4 | 4 | 6061-T6 plate 1/4 | 2 | 1.8 | 0.25 | 1 | brace_top_tabs_1-4.dxf | Clevis tab pair, 25/64 hole; weld to leg face / brace foot
brace_foot_1-4 | 2 | 6061-T6 plate 1/4 | 8 | 3 | 0.25 | 2 | brace_foot_1-4.dxf | 2 x 13/32 holes at 6 in spacing
brace_foot_tabs_1-4 | 4 | 6061-T6 plate 1/4 | 2.5 | 2 | 0.25 | 1 | brace_foot_tabs_1-4.dxf | Clevis tab pair, 25/64 hole; weld to leg face / brace foot
adapter_tie_tabs_1-4 | 2 | 6061-T6 plate 1/4 | 1.4 | 1 | 0.25 | 1 | adapter_tie_tabs_1-4.dxf | Tabs welded under crossbar and on adapter flange, 11/32 hole
adapter_tie_tabs_1-4 | 2 | 6061-T6 plate 1/4 | 3.1 | 1.1 | 0.26 | 1 | adapter_tie_tabs_1-4_v2.dxf | Tabs welded under crossbar and on adapter flange, 11/32 hole
exhaust_hanger_brackets_1-4 | 2 | 6061-T6 plate 1/4 (L-brackets) | 5.9 | 2.1 | 2 | 0 | exhaust_hanger_brackets_1-4.dxf | Bolted to the bed box side, isolator on top
tailpipe_transom_saddle | 1 | 6061-T6 plate 1/4 | 3.5 | 2 | 1.5 | 0 | tailpipe_transom_saddle.dxf | Riveted to transom inner face
cage_foot_pads_1-4_steel | 4 | Steel plate 1/4 (4 x 4) | 4 | 4 | 0.25 | 4 | cage_foot_pads_1-4_steel.dxf | 4 x 13/32 holes on 2.5 in square
cage_foot_isolators_HDPE_1-8 | 4 | HDPE 1/8 (4 x 4) | 4 | 4 | 0.12 | 4 | cage_foot_isolators_HDPE_1-8.dxf | 4 x 13/32 holes on 2.5 in square
rudder_hinge_brackets_1-4 | 4 | Steel plate 1/4 | 2.6 | 1.5 | 0.26 | 1 | rudder_hinge_brackets_1-4.dxf | 17/32 pivot hole; saddle-cut to the rail
footrest_ladder_foot_plates | 2 | 6061 plate 3/16 | 3 | 2 | 0.19 | 0 | footrest_ladder_foot_plates.dxf | Bolted to floor rivnuts / shelf
footrest_ladder_foot_plates | 2 | 6061 plate 3/16 | 2 | 1.9 | 0.19 | 0 | footrest_ladder_foot_plates_v2.dxf | Bolted to floor rivnuts / shelf
MOUNT_engine_bed_plate | 2 | 6061-T6 plate 1/4 x 3 x 52 | 52 | 3 | 0.25 | 10 | MOUNT_engine_bed_plate.dxf | 10 x 13/32 holes at x = 11.25, 15.75, 20.25, 24.75, 28.75, 33.25, 39.75, 44.25, 46.5, 52.5
hdpe_engine_bed | 2 | HDPE 1/8 x 3 x 52 | 52 | 3 | 0.12 | 10 | hdpe_engine_bed.dxf | Holes to match the bed plate
MOUNT_cage_transom_plate | 2 | 6061-T6 plate 1/4 (4 x 4) | 4 | 4 | 0.25 | 4 | MOUNT_cage_transom_plate.dxf | 4 x 13/32 holes
MOUNT_cage_frame12_plate | 2 | 6061-T6 plate 1/4 (4 x 4) | 4 | 4 | 0.25 | 4 | MOUNT_cage_frame12_plate.dxf | 4 x 13/32 holes
quarter_knee | 2 | 6061-T6 plate 1/4 | 14.2 | 7.1 | 0.55 | 4 | quarter_knee.dxf | Drilled for the cage-foot bolts
frame12_gusset | 2 | 6061-T6 plate 1/4 | 6.8 | 6.7 | 0.28 | 4 | frame12_gusset.dxf | Drilled for the cage-foot bolts

Sheet: Weldments
Part | Qty | Material / profile | Envelope L x W x H (in) | Process / notes
engine_bracket | 4 | Steel 3/8 plate + DOM sleeve 2.0 OD x 1.75 ID x 3 | 5.5 x 2.8 x 0.38 | Engine side; block-side holes to be drilled to the real G13 mount bosses
engine_bracket | 4 | Steel 3/8 plate + DOM sleeve 2.0 OD x 1.75 ID x 3 | 3.0 x 2.0 x 2.0 | Engine side; block-side holes to be drilled to the real G13 mount bosses
engine_mount | 4 | 6061-T6: 3/8 ears + web, 2x2x3/16 sq tube arm, 1/4 pad | 12.7 x 6.5 x 5.24 | Bed-side cradle; ears 17/32 hole for the 1/2 through-bolt; pad 2 x 13/32 holes
bolt_1-2_engine_mount | 4 | 6061-T6: 3/8 ears + web, 2x2x3/16 sq tube arm, 1/4 pad | 4.2 x 0.5 x 0.5 | Bed-side cradle; ears 17/32 hole for the 1/2 through-bolt; pad 2 x 13/32 holes
backrest_sockets_1-25_al | 4 | 6061 tube 1-1/4 x .065 + 1/4 straps | 4.0 x 1.2 x 1.25 | Strapped to the bench wall with backing plates
backrest_sockets_1-25_al | 4 | 6061 tube 1-1/4 x .065 + 1/4 straps | 3.0 x 1.5 x 0.88 | Strapped to the bench wall with backing plates
battery_tray_and_strap | 1 | 6061 sheet 1/8 tray + 1 in strap | 8.9 x 7.5 x 1.0
battery_tray_and_strap | 1 | 6061 sheet 1/8 tray + 1 in strap | 7.2 x 7.0 x 1.0
engine_guard_frame | 1 | 6061 angle + 1/2 rod stays | 25.6 x 1.5 x 1.5 | Guard mesh riveted to the angle
engine_guard_frame | 2 | 6061 angle + 1/2 rod stays | 15.7 x 0.5 x 0.5 | Guard mesh riveted to the angle
steering_pivot_base | 1 | 6061 3/8 base + 1/4 ears | 4.0 x 3.0 x 2.12 | 17/32 pivot holes

Sheet: Hardware
Item | Where | Qty
3/8-16 grade 8 bolt x 1-3/4, nylock, 2 washers | Brace clevises (top and foot) | 4
5/16-18 bolt x 1-3/4, nylock | Adapter tie struts | 4
1/2-13 grade 8 bolt x 4-1/2, nylock | Engine mount through-bolts | 4
Poly bushing 1.75 OD x 0.5 ID x 3 L | Engine mount sleeves | 4
M10 bolts to suit the G13 block mount bosses | Engine-side brackets | 16
3/8-16 stainless bolt x 1-1/2, nylock, Tef-Gel | A-frame feet, brace feet, engine cradle pads to bed plates | 20
3/8-16 stainless bolt x 2, nylock, Tef-Gel | Cage feet through pads, isolators, hull plates and knees | 16
1/2-13 bolt x 1-1/2 into tapped hinge plugs | Rudder pivots | 4
UHMW thrust washer 1-1/4 OD x 1/2 ID x 1/4 | Rudder pivots | 4
3/8 rod end (female) + 3/8 bolt, nylock | Tie bar and pushrod | 4
Rubber grommet (Civic radiator style) | Radiator lower mounts | 2
Rubber bushing for 3/8 stay | Radiator top stays | 2
Exhaust flex section 1-3/4 | Downpipe | 1
Rubber exhaust isolator 1-1/4 dia | Muffler hangers | 2
Stainless band clamp for 5 in muffler | Muffler hangers | 2
1/4-20 stainless bolt + backing plate | Handle flanges, socket straps, bench clips | 24
1/4-20 rivnuts | Floor panels, bench clips, ladder feet | 60
Stainless padeye + 1 in cam strap | Fuel tank on the bow shelf | 4
1/2 bolt x 3, nylock + UHMW bushings | Steering lever pivot | 1
3/16 closed-end aluminum rivets | Shelf angles, stringer clips, guard angle, saddle | 80

Sheet: Joint notes
Joint | Where | Detail
J01 | A-frame leg tops | Slot each leg 3/8 x 2.5 on the in/outboard walls; slide the peak plate in; weld plate to both walls, then the slotted 1/8 cap.
J02/J05 | Brace clevises | Tab pairs (1/4) welded to the fwd leg face and the brace foot; tongues welded into slotted brace ends; 3/8 grade 8 bolt in double shear.
J03 | Crossbars | Mitre ends 3.9 deg to the leg faces, weld all around.
J04 | Leg feet | Leg ends cut horizontal; weld to the 1/4 foot; 2 gussets per foot; 2 bolts at +-2.25 in beside the leg (new bed-plate holes).
J06 | Engine mounts | 6061 cradle (3/8 ears + web, 2x2x3/16 arm, 1/4 pad) on the bed; steel bracket with DOM sleeve and poly bushing on the block; 1/2 through-bolt.
J07 | Tie struts | 1/4 tabs under the crossbar and on the adapter flange; 5/16 bolts.
J08/J09 | Cage feet | Legs and base rail coped to each other and to a 1/4 steel pad; pad over 1/8 HDPE; 4 x 3/8 SS bolts through the hull plate and knee.
J10/J11 | Cage nodes | Cope legs, longitudinals, bars and rudder rails to the hoops (and to each other at shared nodes); weld.
J12 | Rudder pivots | Hinge tube on 1/2 bolts into tapped plugs, UHMW thrust washers on 1/4 brackets saddled to the rails; horn coped to the hinge tube; rod ends.
J13 | Radiator | Lower angle across the cradle rails with 2 rubber grommets; radiator raised 0.75 in; 2 x 3/8 stays to the aft peak plate.
J14 | Exhaust | Flex section; band clamps on rubber isolators atop 1/4 L-brackets bolted to the starboard bed box; tailpipe saddle on the transom.
J15 | Bench | Backrest sockets strapped inside the bench; holes in lid and cushion; handles on flanges standing 1.5 in off the bench side.
J16 | Bow shelf | Shelf x 118.5-140.2; aft edge on an angle bolted to the frame-120 webs; front edge on an angle riveted to clips on the bow stringers; padeyes for the tank straps.
J17 | Transom corner | Rub rail notched around the knee and trimmed to the skin; knee and gusset drilled for the cage-foot bolts.
J18 | Nose cap | UHMW trimmed to the inside of the cap; cap laps over the strip ends, through-bolted.
