acappon/DIY-MiniAirboat/StraddleDart_rev7/Team/Build_Ledger_rev7.xlsx

Sheet: Read me
Straddle Dart build-team ledger: pledges, work done, contributions and ownership
First draft for planning. The rules below are proposals for the team to settle before the first build starts.
How credit works
Every build step is worth the pro labor cost the build guide gives for it (sheet Steps; edit the values there).
A member earns that value either by doing the step or by paying a pro to do it. Fast or slow, the credit is the same.
Several members can share a step: give each one a share (the shares for a step on a boat should add up to 100%).
Credit only counts once another member has checked the work and signed it off (column "Verified by" in the Work log).
If a pro charges more than the step value, the difference can count as a cash contribution (Settings).
Cash, materials, tools and shop space count at their agreed value once another member approves them (Contributions).
A member who withdraws before the build is finished keeps only part of their credit (Settings), which supports the rule
that everyone commits to building every boat, not just up to their own.
Ownership % on the Ownership sheet is each member's counted credit over everyone's. It assumes the team LLC owns all the boats
and members hold shares in it, which also suits a later decision to build fewer boats and share them.
Sheets
Settings: team name, number of boats, and the rules above.
Members: up to 12 people. Names typed here feed the drop-downs on the other sheets.
Steps: the 58 build steps, their DIY hours and their value. Values are per boat.
Pledges: who promised to do or fund which step on which boat, and what share.
Work log: what was actually done, by whom, how (did it, or paid a pro), and who checked it.
Contributions: cash, materials, tools and shop space.
Progress: every step against every boat: share pledged, share done and checked.
Ownership: credit per member, pledges kept, and the resulting ownership split.
Usage log: after the build, who took a boat out, engine hours and fuel. Splits running costs by use.
Using it
Blue cells are typed in; black cells are calculated. Rows with "(example)" in the name are samples: delete them before use.
Keep one copy as the team's official record (a shared drive), and make the sign-off a habit at every work session.
Booking boats among owners (after the build)
Use a shared resource calendar (Teamup, Skedda, or a shared Google calendar with one calendar per boat).
Suggested rules: bookings in proportion to ownership; weekends and holidays rotate; a cap on how many future bookings
one person may hold; log engine hours and fuel in the Usage log on every trip; pre- and post-trip checklist on each booking.
This workbook is a planning tool, not a legal agreement. The team's operating agreement, reviewed by a lawyer, governs.

Sheet: Settings
Settings
The rules the team agrees before the build. Blue cells are editable.
Setting | Value | Notes
Team / LLC name | Example Straddle Dart Build LLC | As registered
Number of boats in this build | 1 | 1 for the prototype; up to 8
Materials budget per boat ($) | $24452 | From BOM_rev7.xlsx; for the funding target only, not credit
Credit kept by a member who withdraws before the build is finished | 50% | Fraction of their credit that still counts
Pro cost above the step value counts as a cash contribution | Yes | Yes or No
Sign-off must be by a different member | Yes | Yes or No

Sheet: Members
Members
One row per person. Status: Active, Withdrawn or Finished.
No. | Name | Contact | Joined | Status | Left on | Notes
1 | Alex (example) |  |  | Active
2 | Bea (example) |  |  | Active
3 | Cruz (example) |  |  | Active
4 | Dana (example) |  |  | Active
5
6
7
8
9
10
11
12

Sheet: Steps
Build steps and their value
From Build_Guide_rev7.xlsx. Value = pro labor cost per boat; edit it if the team agrees a different value.
Step | Section | Step (first line of the guide) | DIY hours | Value per boat ($)
1 | Hull (riveted aluminum) | Export flat patterns of every skin panel, frame and stringer from the CAD in OnShape; print full-size templates | 6 | $450
2 | Hull (riveted aluminum) | Build a level strongback (two straight rails on stands) and stand the frames on it as the station molds, braced square and to the CAD spacing; they stay in the hull, so no separate molds are needed | 6 | $420
3 | Hull (riveted aluminum) | Order 5052-H32 sheet (0.125 in bottom, chine and bow face; 0.063 in sides; 0.125 in transom); have a fab shop shear the blanks and brake the 45 deg chine bends and transom flanges, and brake the two 1/8 in chine-guard strips to 135 deg in the same session | 4 | $650
4 | Hull (riveted aluminum) | Cut and form stringers (hat or angle sections) to the rocker curve; cut the ten frames from angle (x 12, 24, 36, 48, 60, 72, 84, 96, 111.5 and 120 in; 60 and 84 are copies of 72, 111.5 a copy of 96); notch a 1 x 3/4 in limber in every bay of every frame and a cross-drain slot in every stringer at x 3.5-4.5 | 23 | $1800
5 | Hull (riveted aluminum) | Cleco frames and stringers together on the jig; check square and diagonals; rivet the framing | 15 | $1180
6 | Hull (riveted aluminum) | Fit the bottom sheets: flat to x = 120 in, then the conic roll-up tangent into the 15 deg raked bow plate; centerline seam over a doubled center stringer; cleco and trim | 12 | $950
7 | Hull (riveted aluminum) | Fit chine/side panels, bow face and transom; cleco every lap (1 in minimum); check symmetry and chine angle | 12 | $900
8 | Hull (riveted aluminum) | Drill all rivet holes to final size (3/16 in) and deburr both sides: double rows at 3/4 in on the bottom centreline seam, the transverse butt seam and the chine laps; double rows at 1 in on the side, transom and bow laps above the waterline | 11.5 | $870
9 | Hull (riveted aluminum) | Take laps apart, clean, prime faying surfaces and every cut edge with self-etching primer, butter with sealant (Sikaflex 291 or 3M 4200), rivet with closed-end aluminum blind rivets | 20.5 | $1580
10 | Hull (riveted aluminum) | Install engine beds (doubled aluminum stringers + plates on HDPE), cage mount plates, aluminum rub rail at the sheer | 8 | $600
11 | Hull (riveted aluminum) | Leak test: hull on stands, fill with 4 in of water, check the outside (before UHMW) for 24 h; mark and fix leakers. Repeat with UHMW on, watching the strip edges | 8 | $600
12 | Hull (riveted aluminum) | Fit UHMW strips; through-bolt into the stringers with sealant, slotted toward the ends; fit the brake-formed chine guards over the strip edges and the nose cap | 9 | $680
13 | Hull (riveted aluminum) | Finish: the hull stays bare 5052 (primer only on faying surfaces and cut edges, step 9); touch up any scratch through to bare metal at a cut edge; a topcoat can be added later | 2 | $150
14 | Drivetrain | Find a G13B (1989-94 Suzuki Swift GT/GTi, or a JDM Cultus GT-i import with its ECU and harness); compression-test it; replace timing belt, water pump, gaskets, plugs | 18 | $1250
15 | Drivetrain | Measure the bellhousing pattern (the G13B shares the G13-family pattern: confirm on the block); machine the adapter plate and jackshaft housing; fit the flex coupling | 12 | $1000
16 | Drivetrain | Build engine mounts with polyurethane bushings; set the engine low on the bed plates | 8 | $650
17 | Drivetrain | Fabricate and TIG-weld A-frames, gusset peak plates, feet, diagonal braces, tie struts; the forward crossbar is 2 x 3 x 1/8, 3 in deep, its bottom on the tie-strut tabs | 30 | $2500
18 | Drivetrain | Build the tension yoke; machine the prop shaft (4140 pre-hardened, 28-32 HRC) and flange; mount the flange bearings; carry the thrust on a shaft shoulder or clamped collar | 14 | $1150
19 | Drivetrain | Install pulleys, belt and optional idler; align pulleys with a straightedge or laser; set tension with the jack screw | 6 | $450
20 | Drivetrain | Mount the prop; set pitch so full throttle standing still reaches 6,000-6,300 rpm (the G13B peaks at 6,500); track the blades; static thrust test on a scale (expect about 430 lb) | 5 | $420
21 | Drivetrain | Mount the radiator on the cradle; plumb hoses; fill and bleed coolant | 6 | $450
22 | Drivetrain | Build the exhaust: raised muffler on hangers from the starboard engine-bed plate, above the aft foam, with a heat shield; flex section after the manifold; tailpipe over the transom | 14 | $1150
23 | Drivetrain | Fuel system and throttle cable | 6 | $450
24 | Prop cage, rudders and steering | Have the two 72.4 in DOM hoops rolled (1 x .083); cut and fit legs, rails, longitudinals and aft bars (all 1 x .065 DOM), a diagonal in each side bay (aft foot to the forward leg 3 in below the hoop), 1/2 EMT front bars; weld the cage | 20 | $1700
25 | Prop cage, rudders and steering | Fit 1/2 in hardware cloth front, aft and sides; install the shaft sleeve; paint | 10 | $750
26 | Prop cage, rudders and steering | Make the honeycomb rudders: cut, edge channels, seal edges, hinge tubes | 12 | $950
27 | Prop cage, rudders and steering | Steering: weld the new horns (3.5 in aft, 2 in outboard) to the rudder hinge tubes; weld the 3/8 x 1.5 bellcrank bracket to the aft hoop at the lower-rail end and notch the aft screen mesh round it; fit the bellcrank, the tie bar and drive link behind the aft screen (rod ends below the horns, bolts in from below), and the straight 1 x .065 long rod outside the cage to the lever; set rudders parallel | 10 | $800
28 | Floor, seating, controls and flotation | Open sump: install pump, float switch with cycle counter, outside-reachable auto/off/manual switch, bailer, 1 in drain plug, through-hull and raised FRP grate box; pour a bucket in each bay and check it reaches the sump | 7 | $560
29 | Floor, seating, controls and flotation | Make the 24 foam blocks (20 thin blocks aft of x = 72 in, 4 bow blocks): pour urethane foam per bay onto release-lined Coroplast trays (or into molds), trim to fit with 1/16 in clearance, seal-coat, glue on HDPE pads | 12 | $950
30 | Floor, seating, controls and flotation | Make bolt-down floor panels resting on the stringer tops, and the bow shelf (sealed 3/8 in plywood or 0.063 in aluminum), on rivnuts and gasket tape; cut and fit 8 deck plates | 12 | $950
31 | Floor, seating, controls and flotation | Build the bench: 1/2 in ply box with a sealed bottom panel and bulkhead at x = 87 in; battery bay forward with an Al ledge ring, EPDM gasket and a flush lid bolted into clip nuts; dry storage / cooler aft with a flush padded lid hinged on the starboard top corner, locking stays at both ends, rubber T-latch and a 1 in drain plug | 22 | $1700
32 | Floor, seating, controls and flotation | Backrests, grab handles (loop 10.5 in off centre), engine guard, two foot ladders (left rails 7.5 and 12.5 in to port, right 7.5 and 14.5 in to starboard, solid 1 in rod, foot plates bolted to floor rivnuts and the bow shelf), rung-mounted throttle pedal on the right ladder (arm, torsion spring, rest stop), padded cushions | 14 | $1100
33 | Floor, seating, controls and flotation | Mold or cut the strap-in foam side blocks (taller with the low floor); fit straps | 6 | $450
34 | Joint details, rev 6 (added work only; base fabrication is in the sections above) | Cut plates from the DXF flat patterns (plasma or waterjet, or send out); deburr, drill to final size | 4 | $300
35 | Joint details, rev 6 (added work only; base fabrication is in the sections above) | Cut tubes per the cut list: mitre leg ends, slot leg tops 3/8 x 2.5, cope cage tubes (hole saw or notcher) | 4 | $300
36 | Joint details, rev 6 (added work only; base fabrication is in the sections above) | Weld the A-frame weldments in a jig: legs into peak plate, caps, crossbar, feet, gussets, clevis tabs | 3 | $250
37 | Joint details, rev 6 (added work only; base fabrication is in the sections above) | Build the engine-mount cradles and engine-side brackets; fit poly bushings and through-bolts | 4 | $350
38 | Joint details, rev 6 (added work only; base fabrication is in the sections above) | Fit braces with clevis bolts, tie struts, radiator mounts and stays, exhaust hangers and saddle | 3 | $250
39 | Joint details, rev 6 (added work only; base fabrication is in the sections above) | Cage: weld coped nodes, drill and bolt the steel pads over HDPE isolators; fit rudder pivots, rod ends, tie bar | 3 | $250
40 | Joint details, rev 6 (added work only; base fabrication is in the sections above) | Bench sockets, handle flanges, clips, battery tray, steering pivot, ladder feet, bow-shelf angles and padeyes | 4 | $300
41 | Electrical, finish and testing | Battery bay power: Group 31 AGM; 4 AWG fusible link and 1/0 red to the sealed main switch on the bench front (rubber gasket, studs inside the bay); 60 A MRBF and 6 AWG red to the 12-way hub, 6 AWG black return; 10 A MRBF at battery + for the bilge; 4 relays on the port wall, 2 dimmers on the starboard wall (see the wiring schematic) | 10 | $800
42 | Electrical, finish and testing | Build and fit the adjustable trim tab; rivet a 3/8 x 2 in 6061 flat bar inside the transom behind the tab bracket, from the bottom frame angle to the rub rail, and bolt the bracket through it | 4 | $300
43 | Electrical, finish and testing | Ground runs: tach sweep, belt tension and flap, cooling, vibration; re-torque all bolts | 8 | $650
44 | Electrical, finish and testing | Dock tests: float level, bilge pump, optional swamp test | 4 | $300
45 | Electrical, finish and testing | Water trials: trim tab and prop pitch setup, steering, planing two-up | 8 | $650
46 | Electrical, finish and testing | Registration, numbering, safety gear check | 2 | $150
47 | Rev 7 additions: driver station, lights, searchlight, power, deck hardware, safety, electrical | Driver side frame: cut and TIG-weld the two 2 x 2 posts, top rail, cross arms, 2 x 3 inner rail (posts, arms and rail all 3/16 wall), bowed 1-1/2 x .188 knee braces (roll to about 19 in radius), the inner rail stopping at the aft cross arm, the hinged armrest (aft 13 in of rail, lugs, U-bracket, 1/2 in pin, detent), diagonal and hull-side clips; bolt the base plates through the floor and the clips through backing plates (aft pair also through frame x96) | 14 | $1100
48 | Rev 7 additions: driver station, lights, searchlight, power, deck hardware, safety, electrical | Armrest pad and grip: bend the 1-1/8 in 316 stick and weld it to its 316 base plate; bolt the plate through the console top and the inner rail (4 x 1/4 316, crush tubes, Tef-Gel and a gasket; never weld stainless to the aluminium rail); turn an M16 x 1.5 stud with a square shoulder on the stick end, run a 316 M16 x 1.5 nylon-insert lock nut onto it, thread on the Hurst T-handle (no adapter) across the boat and tighten the lock nut up hard under its neck, then cross-pin handle and stud with a 1/4 in 316 pin 0.4 in above the shoulder; set the armrest height (drv_armrest_h) and reach (drv_reach) to the driver | 4 | $300
49 | Rev 7 additions: driver station, lights, searchlight, power, deck hardware, safety, electrical | Console and dash: rivet the front and outboard skins to the frame (slots for the clips, grommet for the bow loom); fit the 1/8 in top; cut the arched panel and fold it up 66 deg on the fold line; fit tach (centre), temp and fuel either side, and the bottom row: kill lanyard, key, trouble light, NAV-OFF-ANCHOR rocker, two rotaries, USB, 12 V; fold and rivet the hood, screw it and the top down with tamper-proof Torx | 14 | $1100
50 | Rev 7 additions: driver station, lights, searchlight, power, deck hardware, safety, electrical | On the console top: drop-in cup holder by the grip, phone holder stalk at the front-inboard corner, both inclinometers (zero them with the boat level on calm water); rivet the life-jacket hook inside the outboard skin; pad both knee braces with 1 in closed-cell foam and the Cordura covers; rivet the 1/2 in fiddle rail (1/8 x 1-1/2 flat bar, top edges rounded) along the aft, inboard and forward edges of the console top | 4 | $300
51 | Rev 7 additions: driver station, lights, searchlight, power, deck hardware, safety, electrical | Cage light bar and searchlight: clamp the brackets over the front hoop, fit the turret and yoke, mount the remote control on the console top forward of the cup holder, run the two push-pull cables along the hull side, cage leg and front hoop; adjust so the handle and grip track the light | 8 | $650
52 | Rev 7 additions: driver station, lights, searchlight, power, deck hardware, safety, electrical | Throttle cable: run from the pedal anchor through glands in the bench walls and bulkhead, through the engine-guard grommet to the throttle body; leave a 6 in service loop in the bench | 3 | $250
53 | Rev 7 additions: driver station, lights, searchlight, power, deck hardware, safety, electrical | Deck hardware: weld the bow knees, bolt the four cleats (bow on the knees, stern on the transom corners), weld the bow-eye strap and fit the ring | 4 | $300
54 | Rev 7 additions: driver station, lights, searchlight, power, deck hardware, safety, electrical | Safety gear: B-1 extinguisher bracket (starboard) and air-horn bracket (port) on the bow shelf; apply the three swamped-boat warning labels (console top by the capacity label, inside each side of the bench) on clean, degreased aluminium | 1.5 | $100
55 | Rev 7 additions: driver station, lights, searchlight, power, deck hardware, safety, electrical | Engine harness: 1-1/2 in PVC conduit along the cooler bottom port corner (sealed through the bulkhead and aft wall); 1/0 red to the starter B+ and 1/0 black to the block ground stud, booted; 5/8 in engine loom (EFI, start, pump, tach, temp, trouble, bilge) to the DT12 + DTP2 engine connector; 3-hole guard grommet; bilge and float-switch branches with DT2s; fuel pump and filter on the port bed plate | 10 | $800
56 | Rev 7 additions: driver station, lights, searchlight, power, deck hardware, safety, electrical | Dash and lights harness: two PG13 glands in the bay starboard wall; dash loom and lights-power loom along the deck cable cover and up the aft post; dash loom under the console top and up through its grommet into the closed hood (dash and switch-row connectors); lights loom to the light bar, searchlight and stern light; DT/DTP connectors at every device | 10 | $800
57 | Rev 7 additions: driver station, lights, searchlight, power, deck hardware, safety, electrical | Nav lights, flag staff and fuel sender: bow combination light on its stanchion at the bow shelf front, all-round white on the 18 in mast on the aft hoop, bow loom under the starboard gunwale flange; flag-staff saddle and socket on the aft hoop 12 in port of the light, removable staff with the 12 x 10 in orange flag; electric sender in the tank with a DT2 at the tank front | 5 | $375
58 | Rev 7 additions: driver station, lights, searchlight, power, deck hardware, safety, electrical | Sound check: measure dBA at 50 ft at idle, cruise and full throttle before using noise-limited waters | 2 | $150
 |  | Total per boat

Sheet: Pledges
Pledges
Who promised which step on which boat. A pledge can be to do the work or to pay a pro for it.
Boat | Step | Step | Member | Share | Target date | Notes | Pledged value ($)
1 | 1 |  | Alex (example) | 100%
1 | 2 |  | Bea (example) | 50%
1 | 2 |  | Cruz (example) | 50%
1 | 17 |  | Dana (example) | 100%
1 | 9 |  | Cruz (example) | 100%

Sheet: Work log
Work log
One row per member per step finished. Credit counts once a different member signs it off.
Date done | Boat | Step | Step | Member | Share | How | Pro invoice ($) | Verified by | Verified on | Step value ($) | Credit ($) | Pro overrun as cash ($) | Check
2027-01-09 | 1 | 1 |  | Alex (example) | 100% | Did it myself |  | Bea (example)
2027-01-16 | 1 | 2 |  | Bea (example) | 50% | Did it myself |  | Alex (example)
2027-01-16 | 1 | 2 |  | Cruz (example) | 50% | Did it myself |  | Cruz (example)
2027-02-20 | 1 | 17 |  | Dana (example) | 100% | Paid a pro | $2900 | Alex (example)

Sheet: Contributions
Contributions
Cash, materials, tools and shop space at their agreed value. Counts once a different member approves it.
Date | Member | Type | Description | Agreed value ($) | Approved by | Credit ($)
2027-01-05 | Alex (example) | Cash | Prototype fund | $1000 | Bea (example)
2027-01-09 | Cruz (example) | Tools or equipment | Rivet gun and cleco set, kept by the team | $300 | Alex (example)

Sheet: Progress
Progress by step and boat
Share of each step done and signed off, and (right) share pledged. Columns past the boat count stay blank.
Step | Step | Value ($) | Boat 1 done | Boat 2 done | Boat 3 done | Boat 4 done | Boat 5 done | Boat 6 done | Boat 7 done | Boat 8 done | Boat 1 pledged | Boat 2 pledged | Boat 3 pledged | Boat 4 pledged | Boat 5 pledged | Boat 6 pledged | Boat 7 pledged | Boat 8 pledged
 | Value done and signed off ($)
 | Share of the build done

Sheet: Ownership
Credit and ownership
Counted credit = (work + pro overrun + contributions) x the share kept. Ownership = counted credit / total.
Member | Status | Pledged ($) | Work credit ($) | Pro overrun as cash ($) | Contributions ($) | Total credit ($) | Share kept | Counted credit ($) | Ownership | Pledged work done
Total
Build summary
Boats in this build
Labor value of the whole build ($)
Labor value done and signed off ($)
Labor value pledged ($)
Labor not yet pledged ($)
Materials budget for the build ($)
Cash and materials contributed so far ($)

Sheet: Usage log
Usage log (after the build)
One row per trip. Engine hours and fuel split running costs by use; compare with ownership on the right.
Out | Back | Boat | Member | Engine hours out | Engine hours back | Hours | Fuel added (gal) | Fuel cost ($) | Checklist done | Problems found | Member | Engine hours | Share of use | Ownership
