acappon/DIY-MiniAirboat/StraddleDart_rev7/CAD/StraddleDart_rev7_complete.step

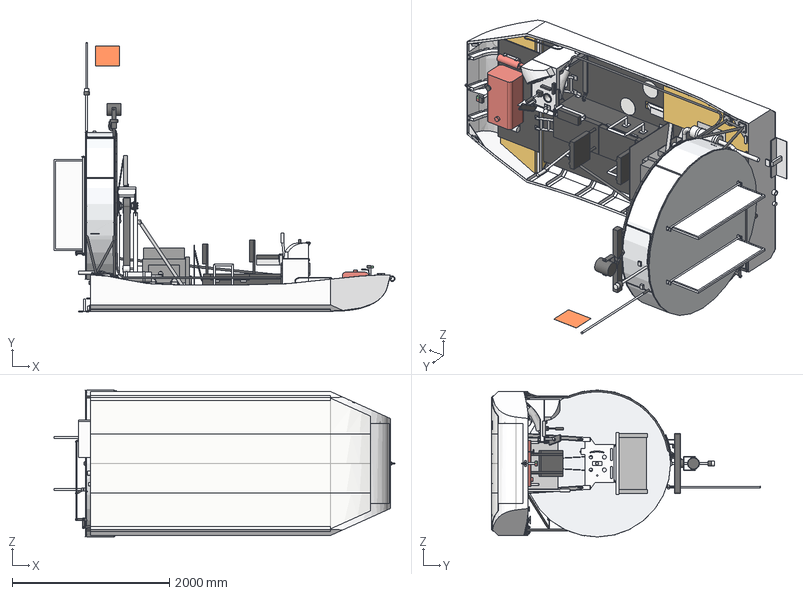
[picture p52: CAD file, 2026-11-01]
StraddleDart_rev7/CAD/StraddleDart_rev7_complete.step
4333.9 x 3423.2 x 1868.2 mm
