acappon/DIY-MiniAirboat/rev0_StitchAndGlue/CAD/DIY-Mini-Airboat_COMPLETE_assembly_r6.step

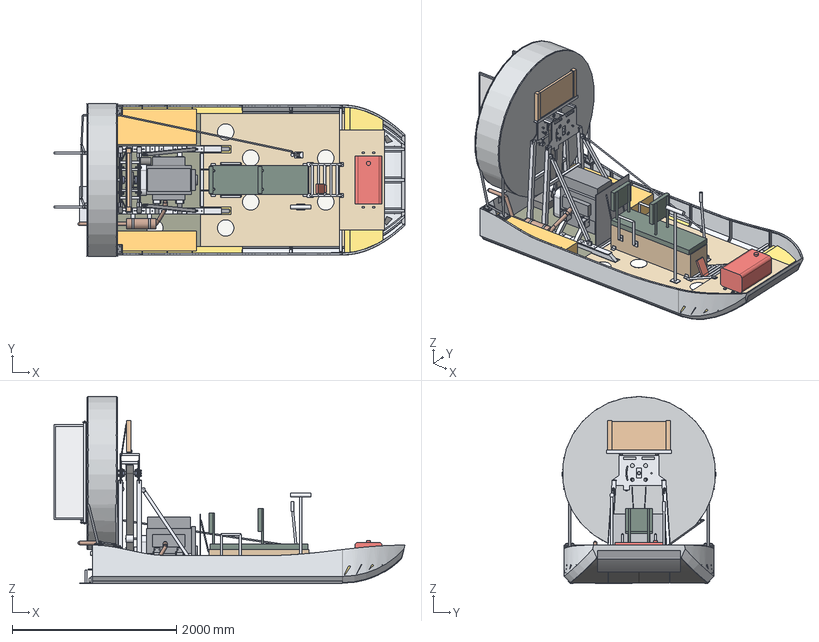
[picture p53: CAD file, 2026-10-30]
rev0_StitchAndGlue/CAD/DIY-Mini-Airboat_COMPLETE_assembly_r6.step
4276.1 x 1868.7 x 2279.1 mm
hull_skin_aluminum
uhmw_strip_1
uhmw_strip_2
uhmw_strip_3
uhmw_strip_4
hat_stringer_S_outer
hat_stringer_S_bed
hat_stringer_center
hat_stringer_P_bed
hat_stringer_P_outer
frame_angle_x12
frame_angle_x24
frame_angle_x36
frame_angle_x48
frame_angle_x72
frame_angle_x96
frame_angle_x120
frame_angle_transom
engine_bed_box_S
engine_bed_box_P
MOUNT_engine_bed_plate_S
hdpe_engine_bed_S
MOUNT_engine_bed_plate_P
hdpe_engine_bed_P
MOUNT_cage_transom_P_plate
hdpe_cage_transom_P
MOUNT_cage_frame12_P_plate
hdpe_cage_frame12_P
MOUNT_cage_transom_S_plate
hdpe_cage_transom_S
MOUNT_cage_frame12_S_plate
hdpe_cage_frame12_S
quarter_knee_P
frame12_gusset_P
quarter_knee_S
frame12_gusset_S
rub_rail_P
rub_rail_S
chine_guard_angle_P
chine_guard_angle_S
nose_cap
ENGINE_G13_placeholder
starter_placeholder
flywheel
bellhousing_adapter_GENERIC
flex_coupling_rubber
jackshaft_bearing_housing
jackshaft_1_25
pulley_HTD8M_30T
pulley_HTD8M_75T
belt_HTD8M_85mm
A_frame_aft_peak_plate_3-8
A_frame_aft_leg_P_2x2x1-8
A_frame_aft_leg_cap_P_1-8
A_frame_aft_foot_P_1-4
A_frame_aft_foot_gussets_P_1-4
A_frame_aft_leg_S_2x2x1-8
A_frame_aft_leg_cap_S_1-8
A_frame_aft_foot_S_1-4
A_frame_aft_foot_gussets_S_1-4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
