acappon/DIY-MiniAirboat/rev8_JonAirBoat/CAD/Airboat_v1.0.1.3_Assembly.step

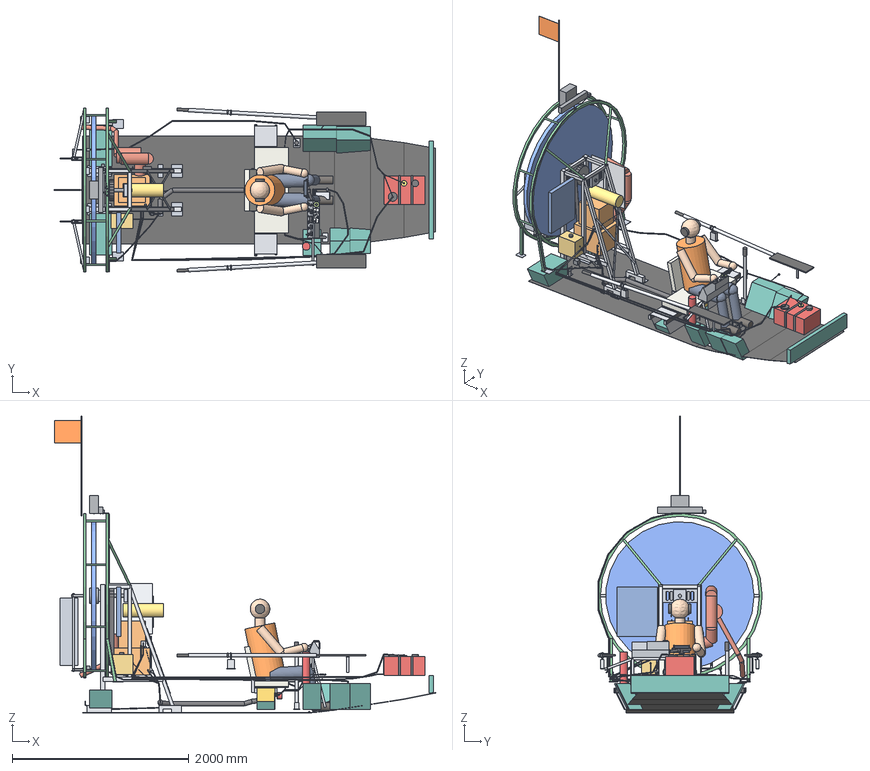
[picture p54: CAD file, 2026-11-11]
rev8_JonAirBoat/CAD/Airboat_v1.0.1.3_Assembly.step
4305.3 x 1858.2 x 3356.0 mm
Oarlock, closed ring - starboard x 8
Round bubble level, vial
Searchlight joystick knob
Maximum load label text x 131
Console arm 1 x 0.095 6061, to the gunwale x 2
USB connector, 1/4 in female spade, sealed
Throttle cable bracket at the engine
Seat pad 38 x 15 x 2-1/2 closed-cell polyethylene, marine vinyl cover
Harness conduit, 2 in corrugated self-draining, UL 94 V-2 x 5
Oarlock socket, top mount - port
NAVS connector, Deutsch DT
W57 Battery positive to battery switch 2 AWG red x 10
All-round stern light
Pedal hinge base
Cage strut 1x0.065 6061 - Stbd
W36 Key START to solenoid 16 AWG yellow/red
Prop shaft 1-1/2 4140
Tachometer, analog 3-3/8 needle
Envelope - radiator 18 x 22 x 2
W50 Searchlight remote cable 18 AWG gray
W48 DESS post to ECM, wire 2 18 AWG white/blue
Pedal crank 1/8 6061
Throttle push-pull cable x 11
Throttle cable stop on the rib
Driver mannequin - shoe x 2
Fuel gauge sender tube
Driver mannequin - pelvis
Heel rest half-round, aft
CTS connector, Deutsch DT
Envelope - 800R cylinders
LED connector, Deutsch DT
Oarlock, closed ring - port x 8
Deck - Front
W30 Tach return 16 AWG black
W19 Bilge pump return 16 AWG black
W42 Temperature sender signal 16 AWG tan
Envelope - remote searchlight
Lower rudder bracket 1/4 6061, clamped to the aft hoop - Port
GAS connector, Ring terminal, sealed
W02 Battery negative to engine ground 2 AWG black
Fuel line x 7
W29 Accessory bus to tach 16 AWG purple
Tank filler cap
Tank tie-down strap x 2
Handle - Starboard
Stand tie 1-1/2x1-1/2x1/8 6061 - 2
W23 Switch bus to lights switch 16 AWG orange
W05 F1 to 12 V outlet 12 AWG red
TB1 connector, Ring terminal, sealed
BILGE connector, Deutsch DT
Driver mannequin - arm x 8
W17 Dash accessory return 16 AWG black
Heat shield - forward post
Cage stringer 2
W33 Accessory bus to exhaust gauge 16 AWG purple
Cage leg at X 11 x 2
Flotation foam - seat compartment bottom port, closed-cell polyethyle ne, the storage floor
USB charging port
Bottom doubler 1/8 5052 - forward A Stbd
W38 Lights switch LED to K3 coil 16 AWG gray/blue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
