acappon/DIY-MiniAirboat/rev0_StitchAndGlue/CAD/DIY-Mini-Airboat_flotation_r5_aft72.step

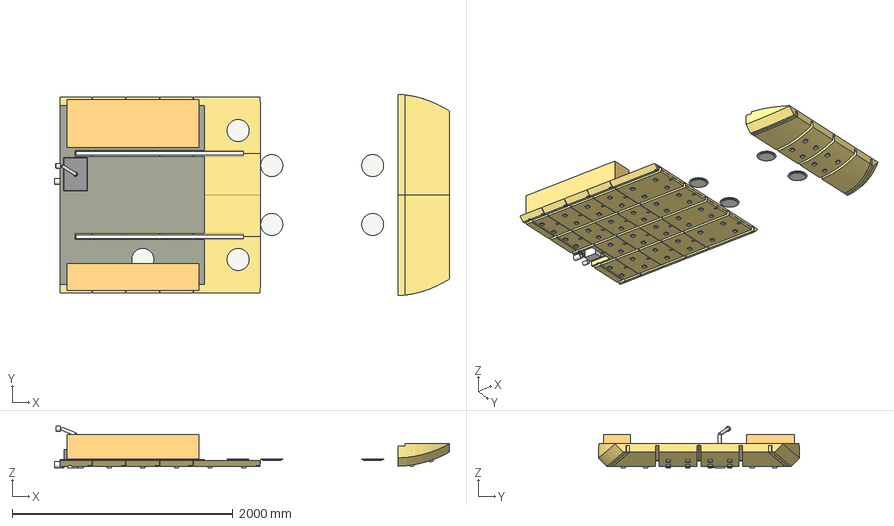
[picture p55: CAD file, 2026-10-30]
rev0_StitchAndGlue/CAD/DIY-Mini-Airboat_flotation_r5_aft72.step
3578.9 x 1824.8 x 376.2 mm
FOAM_block_01
FOAM_block_02
FOAM_block_03
FOAM_block_04
FOAM_block_05
FOAM_block_06
FOAM_block_07
FOAM_block_08
FOAM_block_09
FOAM_block_10
FOAM_block_11
FOAM_block_12
FOAM_block_13
FOAM_block_14
FOAM_block_15
FOAM_block_16
FOAM_block_17
FOAM_block_18
FOAM_block_19
FOAM_block_20
FOAM_bow_block_1
FOAM_bow_block_2
FOAM_bow_block_3
FOAM_bow_block_4
HDPE_spacer_pads
floor_aft_3-8_ply_boltdown
sump_grate_FRP
deck_plate_6in_1
deck_plate_6in_2
deck_plate_6in_3
deck_plate_6in_4
deck_plate_6in_5
deck_plate_6in_6
deck_plate_6in_7
deck_plate_6in_8
BILGE_PUMP_approx_1100gph
SELF_BAILER_transom_1.5in
TRANSOM_DRAIN_PLUG_1in
pump_discharge_hose_and_thru-hull
FOAM_side_block_P_removable
FOAM_side_block_S_removable
