acappon/DIY-MiniAirboat/rev0_StitchAndGlue/DIY-Mini-Airboat_DXF_cut_flat_parts_on_cnc/hdpe_engine_bed.dxf

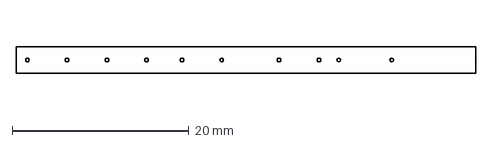
[picture p56: CAD file, 2026-10-30]
rev0_StitchAndGlue/DIY-Mini-Airboat_DXF_cut_flat_parts_on_cnc/hdpe_engine_bed.dxf
52.0 x 3.00 mm
