acappon/DIY-MiniAirboat/rev8_JonAirBoat/CAD/Airboat_v1.0.1.3_Wiring.step

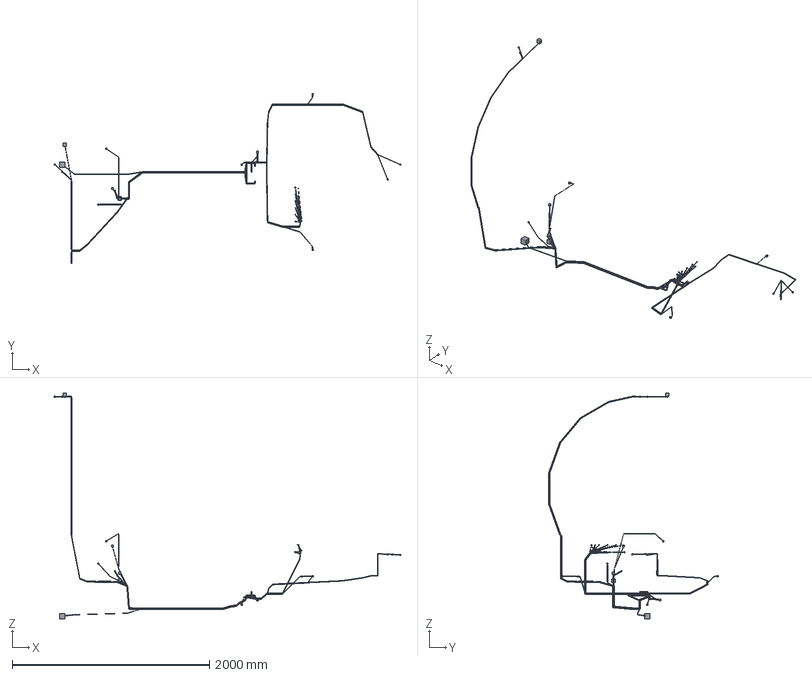
[picture p57: CAD file, 2026-11-11]
rev8_JonAirBoat/CAD/Airboat_v1.0.1.3_Wiring.step
3521.3 x 1721.5 x 2288.5 mm
