acappon/DIY-MiniAirboat/rev0_StitchAndGlue/CAD/DIY-Mini-Airboat_cage_rudders_r2.step

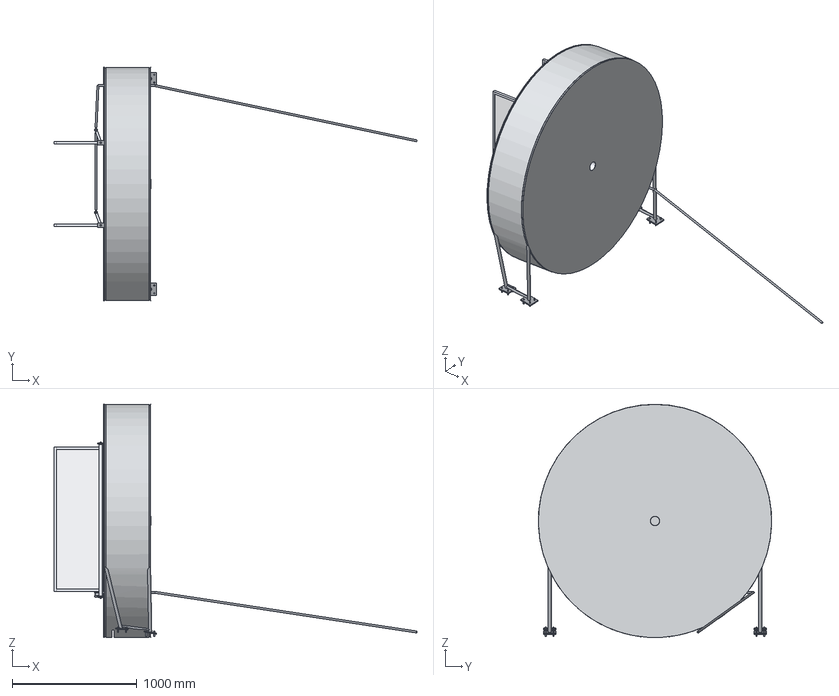
[picture p58: CAD file, 2026-10-30]
rev0_StitchAndGlue/CAD/DIY-Mini-Airboat_cage_rudders_r2.step
2906.5 x 1867.4 x 1868.9 mm
cage_hoop_aft
cage_hoop_fwd
cage_longitudinals_EMT34
cage_front_bars_EMT12
rudder_rails
cage_aft_bars_EMT12
cage_legs
cage_base_rails
cage_foot_pads_1-4_steel
cage_foot_isolators_HDPE_1-8
bolts_3-8_SS_cage_feet
MESH_front_screen
MESH_aft_screen
shaft_guard_sleeve_fixed
MESH_drum_wrap
RUDDER_P_honeycomb_20mm
rudder_P_edge_channels
rudder_P_hinge_brackets_1-4
rudder_P_hinge_tube
rudder_P_pivot_plugs_tapped
rudder_P_UHMW_thrust_washers
rudder_P_horn
RUDDER_S_honeycomb_20mm
rudder_S_edge_channels
rudder_S_hinge_brackets_1-4
rudder_S_hinge_tube
rudder_S_pivot_plugs_tapped
rudder_S_UHMW_thrust_washers
rudder_S_horn
rudder_tie_bar
steering_pushrod
rod_ends_3-8
bolts_rudder_pivots_and_rod_ends
