acappon/DIY-MiniAirboat/rev0_StitchAndGlue/DIY-Mini-Airboat_DXF_cut_flat_parts_on_cnc/brace_tongues_1-4.dxf

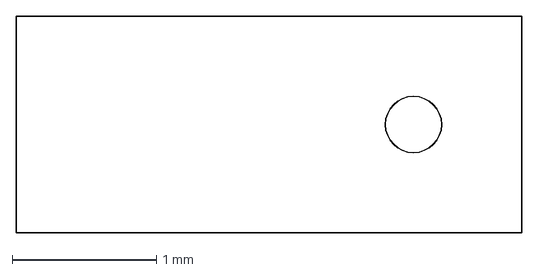
[picture p59: CAD file, 2026-10-30]
rev0_StitchAndGlue/DIY-Mini-Airboat_DXF_cut_flat_parts_on_cnc/brace_tongues_1-4.dxf
3.50 x 1.50 mm
