acappon/DIY-MiniAirboat/rev8_JonAirBoat/CAD/Airboat_v1.0.1.3_Controls.step

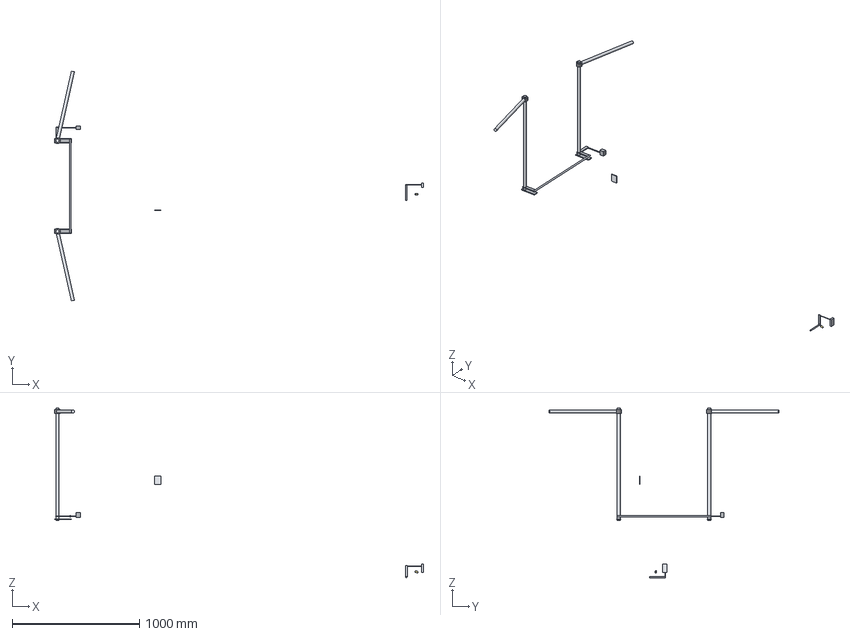
[picture p60: CAD file, 2026-11-11]
rev8_JonAirBoat/CAD/Airboat_v1.0.1.3_Controls.step
2895.6 x 1803.9 x 1330.7 mm
