acappon/DIY-MiniAirboat/StraddleDart_rev7/CAD/hull.step

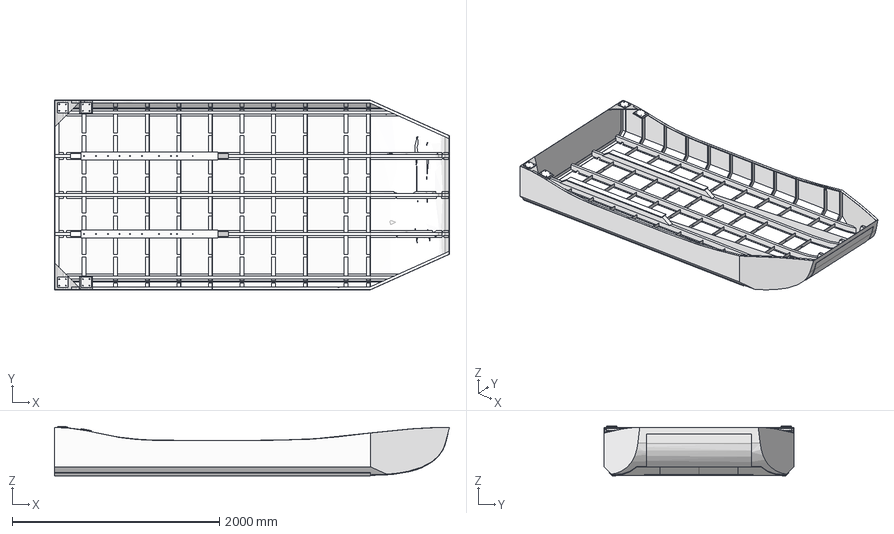
[picture p61: CAD file, 2026-10-31]
StraddleDart_rev7/CAD/hull.step
3810.0 x 1828.8 x 477.8 mm
