acappon/DIY-MiniAirboat/rev8_JonAirBoat/CAD/Airboat_v1.0.1.3_Dash.step

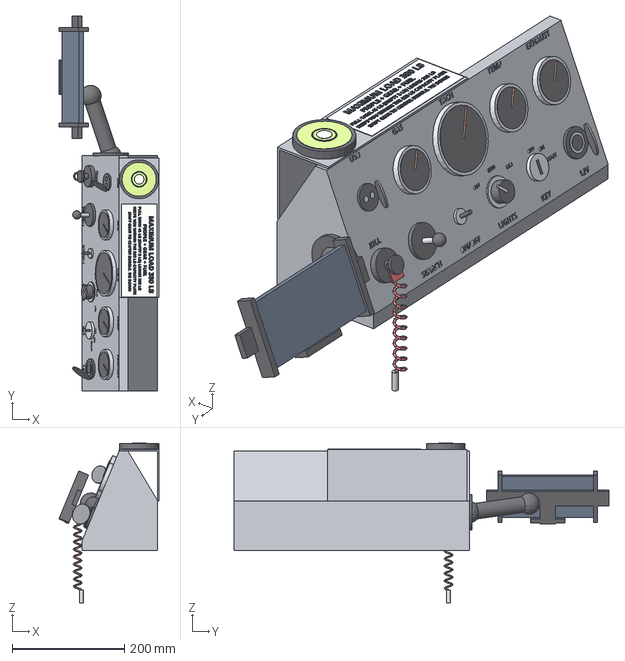
[picture p63: CAD file, 2026-11-11]
rev8_JonAirBoat/CAD/Airboat_v1.0.1.3_Dash.step
178.6 x 668.0 x 285.0 mm
