acappon/DIY-MiniAirboat/rev0_StitchAndGlue/DIY-Mini-Airboat_DXF_cut_flat_parts_on_cnc/MOUNT_engine_bed_plate.dxf

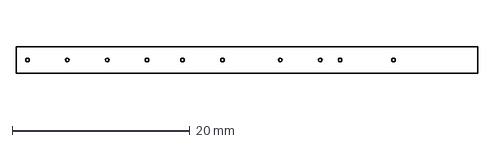
[picture p64: CAD file, 2026-10-30]
rev0_StitchAndGlue/DIY-Mini-Airboat_DXF_cut_flat_parts_on_cnc/MOUNT_engine_bed_plate.dxf
52.0 x 3.00 mm
