acappon/DIY-MiniAirboat/rev8_JonAirBoat/CAD/Airboat_v1.0.1.3_Stand_engine_cage.step

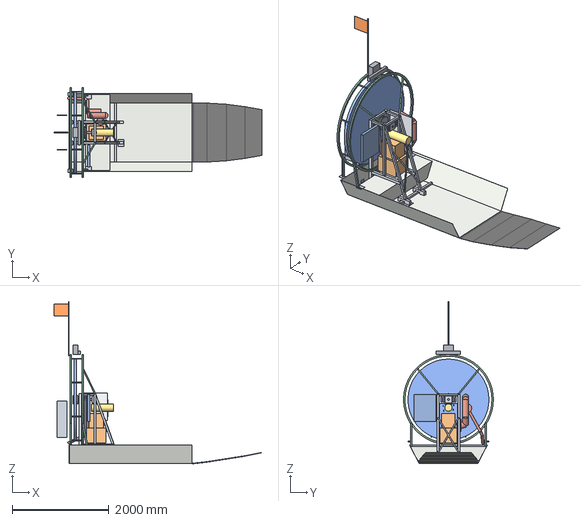
[picture p65: CAD file, 2026-11-11]
rev8_JonAirBoat/CAD/Airboat_v1.0.1.3_Stand_engine_cage.step
4305.3 x 1858.8 x 3356.0 mm
