acappon/DIY-MiniAirboat/StraddleDart_rev7/CAD/layout.step

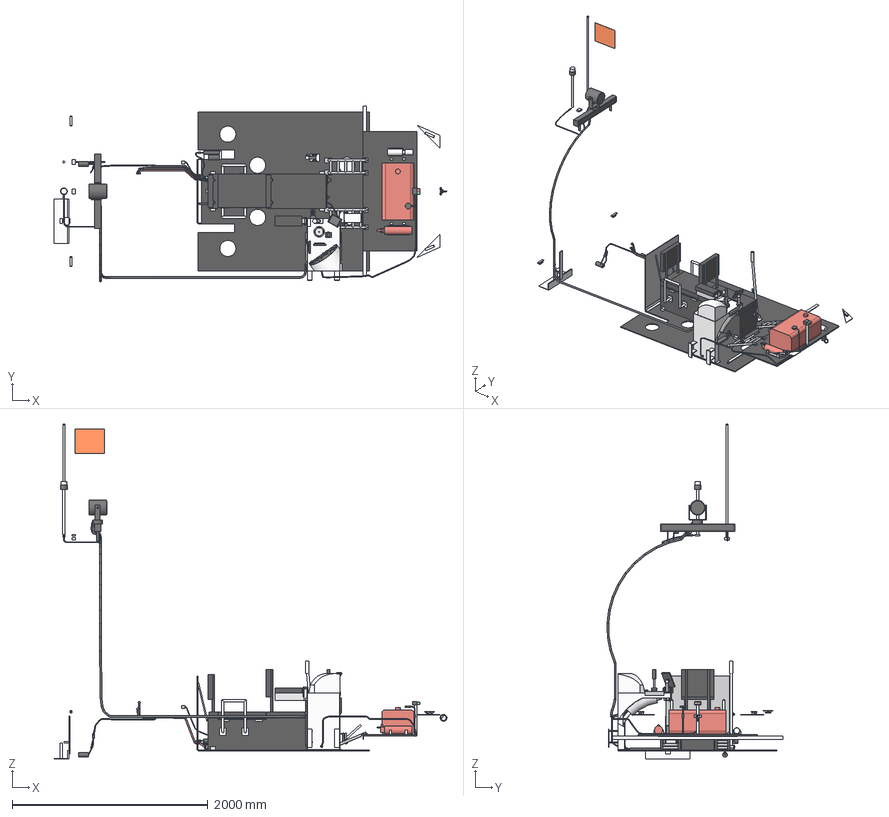
[picture p66: CAD file, 2026-10-31]
StraddleDart_rev7/CAD/layout.step
4020.2 x 1801.5 x 3423.2 mm
