acappon/DIY-MiniAirboat/rev0_StitchAndGlue/CAD/DIY-Mini-Airboat_layout_r6.step

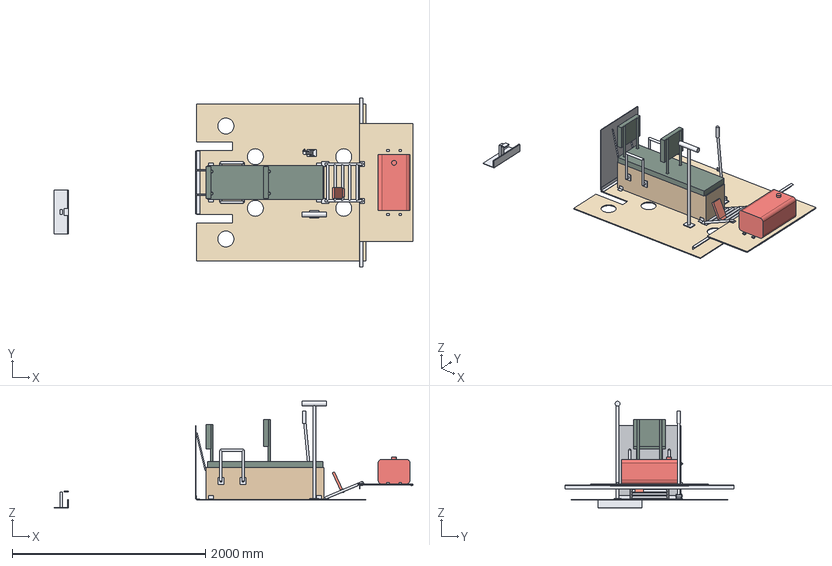
[picture p67: CAD file, 2026-10-30]
rev0_StitchAndGlue/CAD/DIY-Mini-Airboat_layout_r6.step
3713.5 x 1746.9 x 1103.4 mm
floor_3-8_ply
bench_box_1-2_ply
bench_cushion
BATTERY_group26_approx
driver_backrest_removable
passenger_backrest_removable
backrest_sockets_1-25_al
passenger_handle_P
passenger_handle_S
bench_clips_angle
battery_tray_and_strap
engine_front_guard_mesh
engine_guard_frame
footrest_ladder_rails
footrest_ladder_rungs
footrest_ladder_foot_plates
throttle_pedal_movable
steering_lever_port
steering_pivot_base
steering_hardware
padded_bar_stbd
bow_shelf_1-2_ply
bow_shelf_aft_angle_1-5
bow_shelf_front_angle_1x1
tank_padeyes
FUEL_TANK_6-6gal_portable
trim_tab_adjustable
