acappon/DIY-MiniAirboat/rev0_StitchAndGlue/DIY-Mini-Airboat_DXF_cut_flat_parts_on_cnc/footrest_ladder_foot_plates_v2.dxf

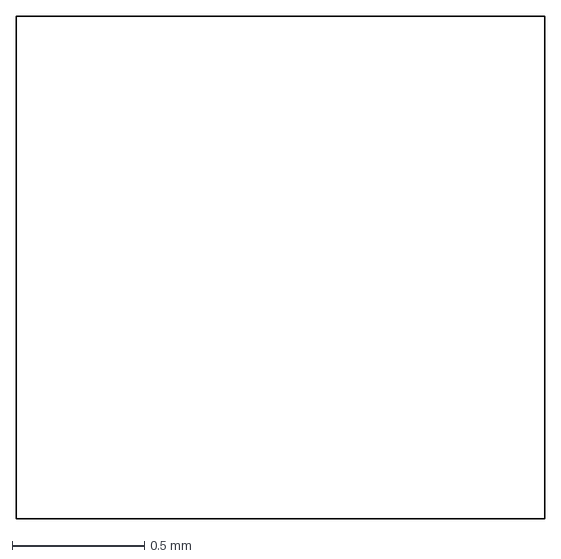
[picture p68: CAD file, 2026-10-30]
rev0_StitchAndGlue/DIY-Mini-Airboat_DXF_cut_flat_parts_on_cnc/footrest_ladder_foot_plates_v2.dxf
2.00 x 1.90 mm
