acappon/DIY-MiniAirboat/rev8_JonAirBoat/CAD/Airboat_v1.0.1.3_Cockpit.step

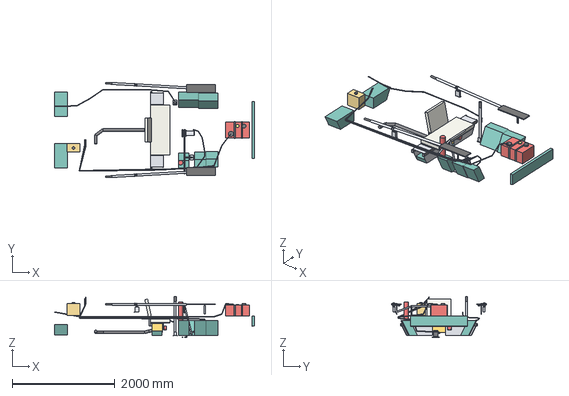
[picture p69: CAD file, 2026-11-11]
rev8_JonAirBoat/CAD/Airboat_v1.0.1.3_Cockpit.step
3887.1 x 1855.9 x 797.6 mm
