acappon/DIY-MiniAirboat/StraddleDart_rev7/CAD/cage.step

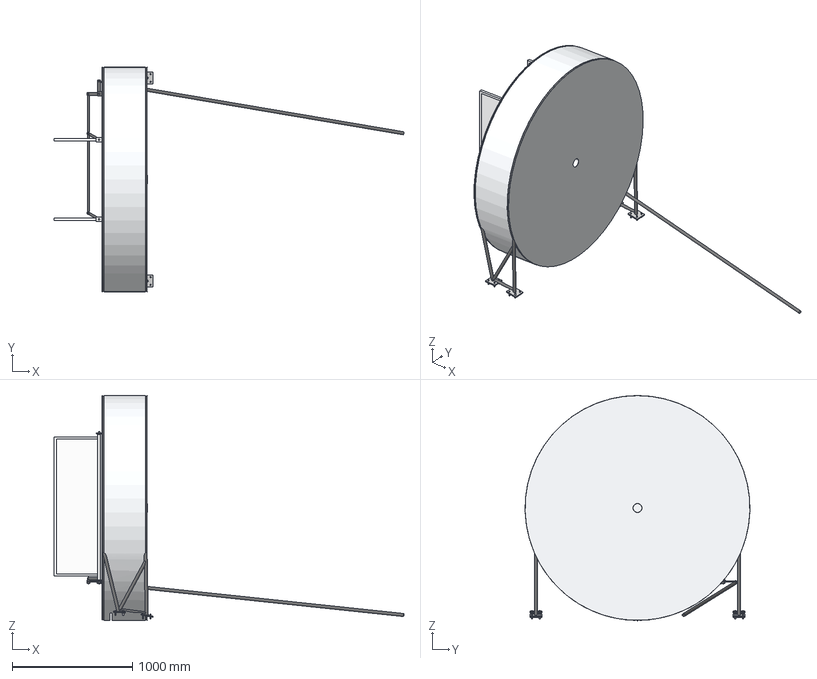
[picture p70: CAD file, 2026-10-31]
StraddleDart_rev7/CAD/cage.step
2907.0 x 1867.4 x 1868.9 mm
