acappon/DIY-MiniAirboat/rev0_StitchAndGlue/CAD/DIY-Mini-Airboat_drivetrain_r5_G13.step

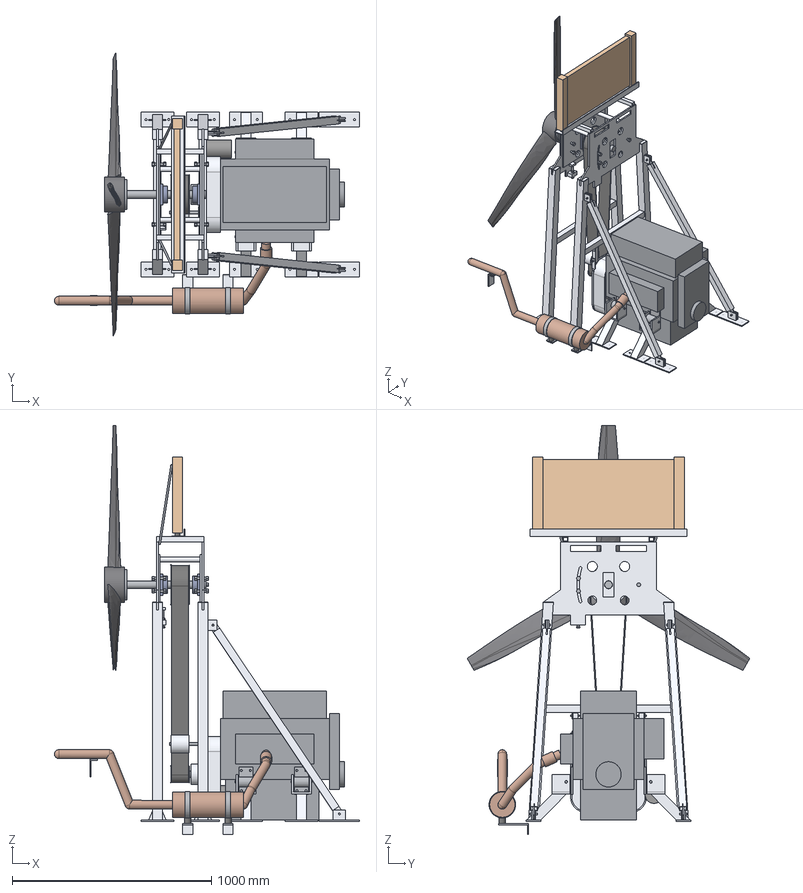
[picture p71: CAD file, 2026-10-30]
rev0_StitchAndGlue/CAD/DIY-Mini-Airboat_drivetrain_r5_G13.step
1533.4 x 1420.7 x 2054.9 mm
ENGINE_G13_placeholder
starter_placeholder
flywheel
bellhousing_adapter_GENERIC
flex_coupling_rubber
jackshaft_bearing_housing
jackshaft_1_25
pulley_HTD8M_30T
pulley_HTD8M_75T
belt_HTD8M_85mm
A_frame_aft_peak_plate_3-8
A_frame_aft_leg_P_2x2x1-8
A_frame_aft_leg_cap_P_1-8
A_frame_aft_foot_P_1-4
A_frame_aft_foot_gussets_P_1-4
A_frame_aft_leg_S_2x2x1-8
A_frame_aft_leg_cap_S_1-8
A_frame_aft_foot_S_1-4
A_frame_aft_foot_gussets_S_1-4
A_frame_aft_crossbar_1-5
A_frame_fwd_peak_plate_3-8
A_frame_fwd_leg_P_2x2x1-8
A_frame_fwd_leg_cap_P_1-8
A_frame_fwd_foot_P_1-4
A_frame_fwd_foot_gussets_P_1-4
A_frame_fwd_leg_S_2x2x1-8
A_frame_fwd_leg_cap_S_1-8
A_frame_fwd_foot_S_1-4
A_frame_fwd_foot_gussets_S_1-4
A_frame_fwd_crossbar_1-5
brace_P_1-5
brace_P_tongues_1-4
brace_P_top_tabs_1-4
brace_foot_P_1-4
brace_foot_P_tabs_1-4
brace_S_1-5
brace_S_tongues_1-4
brace_S_top_tabs_1-4
brace_foot_S_1-4
brace_foot_S_tabs_1-4
bolts_3-8_grade8_brace_clevis
adapter_tie_P_1x1x1-8
adapter_tie_P_tabs_1-4
bolts_5-16_tie_P
adapter_tie_S_1x1x1-8
adapter_tie_S_tabs_1-4
bolts_5-16_tie_S
engine_bracket_x31_P
poly_bushing_x31_P
engine_mount_x31_P
bolt_1-2_engine_mount_x31_P
engine_bracket_x31_S
poly_bushing_x31_S
engine_mount_x31_S
bolt_1-2_engine_mount_x31_S
engine_bracket_x42_P
poly_bushing_x42_P
engine_mount_x42_P
bolt_1-2_engine_mount_x42_P
engine_bracket_x42_S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
