acappon/DIY-MiniAirboat/rev0_StitchAndGlue/DIY-Mini-Airboat_DXF_cut_flat_parts_on_cnc/exhaust_hanger_brackets_1-4.dxf

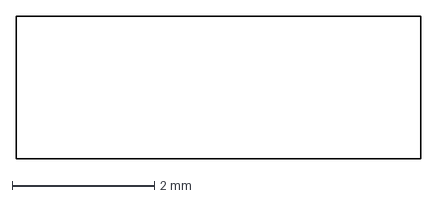
[picture p72: CAD file, 2026-10-30]
rev0_StitchAndGlue/DIY-Mini-Airboat_DXF_cut_flat_parts_on_cnc/exhaust_hanger_brackets_1-4.dxf
5.69 x 2.00 mm
