acappon/DIY-MiniAirboat/StraddleDart_rev7/CAD/drivetrain.step

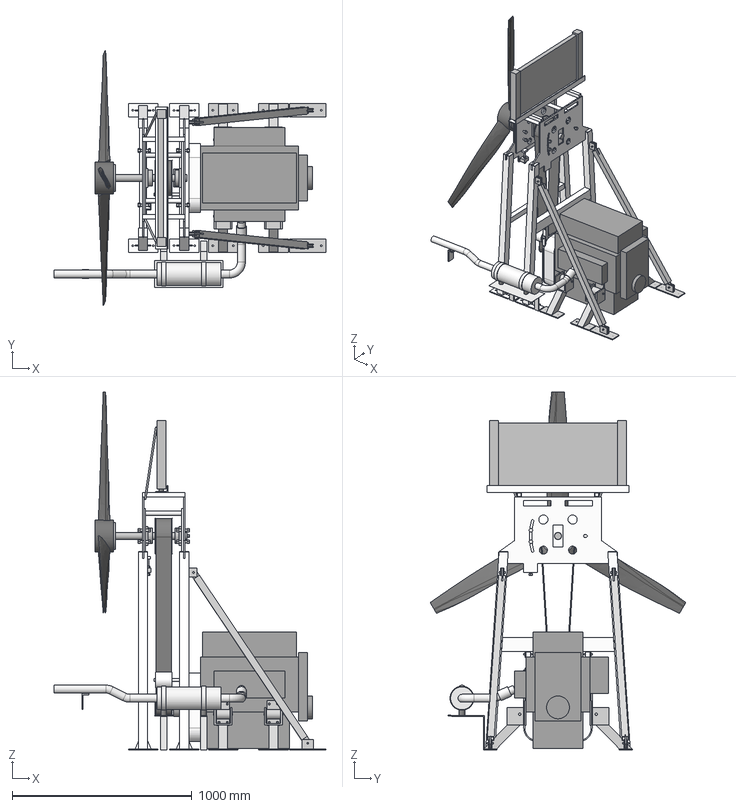
[picture p73: CAD file, 2026-10-31]
StraddleDart_rev7/CAD/drivetrain.step
1511.3 x 1420.7 x 1989.5 mm
