acappon/DIY-MiniAirboat/rev0_StitchAndGlue/DIY-Mini-Airboat_DXF_cut_flat_parts_on_cnc/adapter_tie_tabs_1-4_v2.dxf

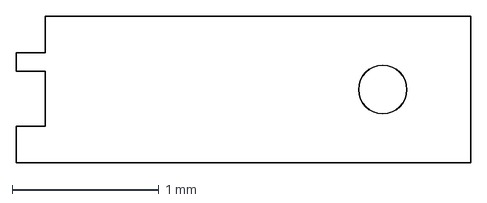
[picture p74: CAD file, 2026-10-30]
rev0_StitchAndGlue/DIY-Mini-Airboat_DXF_cut_flat_parts_on_cnc/adapter_tie_tabs_1-4_v2.dxf
3.10 x 1.00 mm
