acappon/DIY-MiniAirboat/rev0_StitchAndGlue/DIY-Mini-Airboat_DXF_cut_flat_parts_on_cnc/adapter_tie_tabs_1-4.dxf

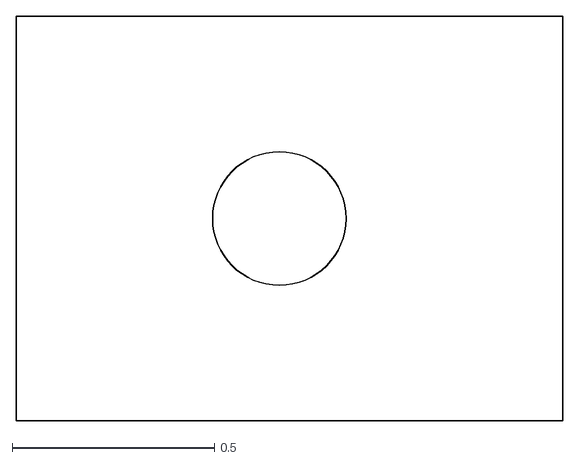
[picture p75: CAD file, 2026-10-30]
rev0_StitchAndGlue/DIY-Mini-Airboat_DXF_cut_flat_parts_on_cnc/adapter_tie_tabs_1-4.dxf
1.35 x 1.00
