acappon/DIY-MiniAirboat/rev0_StitchAndGlue/DIY-Mini-Airboat_DXF_cut_flat_parts_on_cnc/A_frame_peak_plate_3-8.dxf

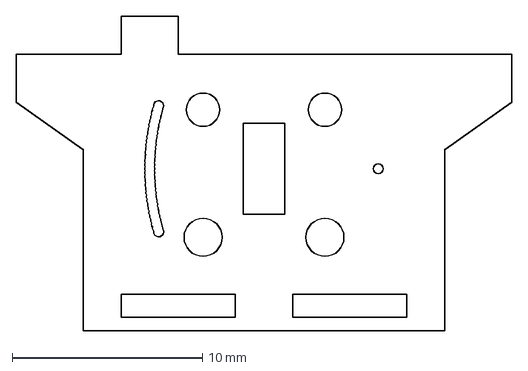
[picture p76: CAD file, 2026-10-30]
rev0_StitchAndGlue/DIY-Mini-Airboat_DXF_cut_flat_parts_on_cnc/A_frame_peak_plate_3-8.dxf
26.0 x 16.5 mm
