acappon/DIY-MiniAirboat/rev0_StitchAndGlue/DIY-Mini-Airboat_DXF_cut_flat_parts_on_cnc/rudder_hinge_brackets_1-4.dxf

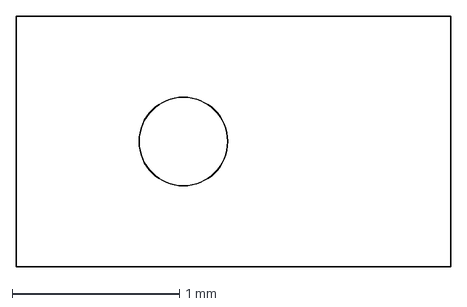
[picture p77: CAD file, 2026-10-30]
rev0_StitchAndGlue/DIY-Mini-Airboat_DXF_cut_flat_parts_on_cnc/rudder_hinge_brackets_1-4.dxf
2.60 x 1.50 mm
