acappon/DIY-MiniAirboat/rev0_StitchAndGlue/DIY-Mini-Airboat_DXF_cut_flat_parts_on_cnc/tailpipe_transom_saddle.dxf

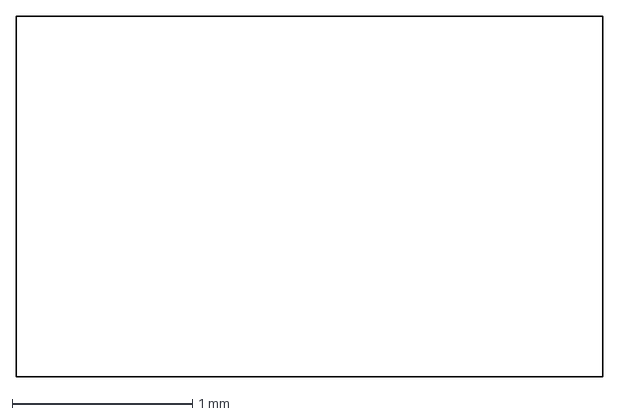
[picture p78: CAD file, 2026-10-30]
rev0_StitchAndGlue/DIY-Mini-Airboat_DXF_cut_flat_parts_on_cnc/tailpipe_transom_saddle.dxf
3.25 x 2.00 mm
