acappon/DIY-MiniAirboat/rev0_StitchAndGlue/DIY-Mini-Airboat_DXF_cut_flat_parts_on_cnc/MOUNT_cage_transom_plate.dxf

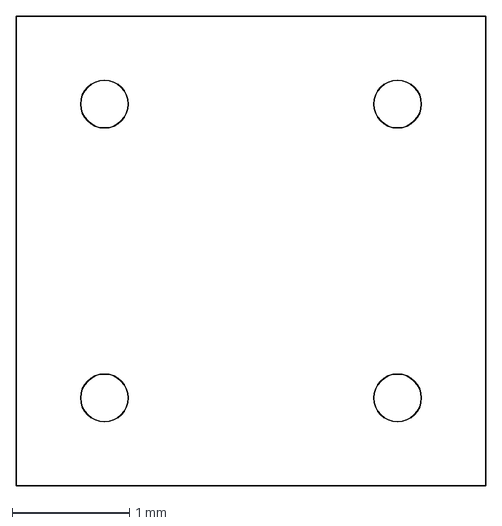
[picture p79: CAD file, 2026-10-30]
rev0_StitchAndGlue/DIY-Mini-Airboat_DXF_cut_flat_parts_on_cnc/MOUNT_cage_transom_plate.dxf
4.00 x 4.00 mm
