acappon/DIY-MiniAirboat/rev0_StitchAndGlue/DIY-Mini-Airboat_DXF_cut_flat_parts_on_cnc/brace_top_tabs_1-4.dxf

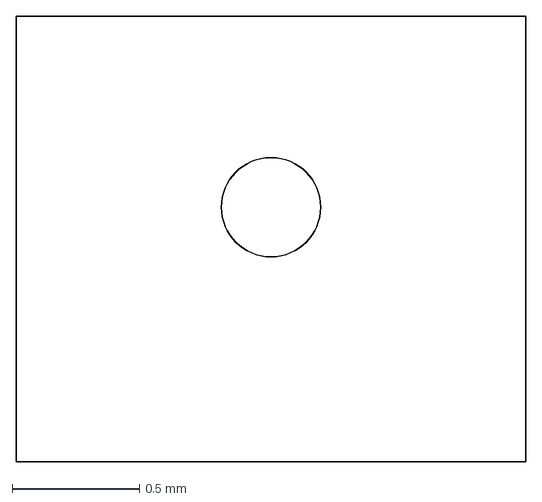
[picture p80: CAD file, 2026-10-30]
rev0_StitchAndGlue/DIY-Mini-Airboat_DXF_cut_flat_parts_on_cnc/brace_top_tabs_1-4.dxf
2.00 x 1.75 mm
