acappon/DIY-MiniAirboat/rev8_JonAirBoat/CAD/Airboat_v1.0.0.2_Hull_and_armor.step

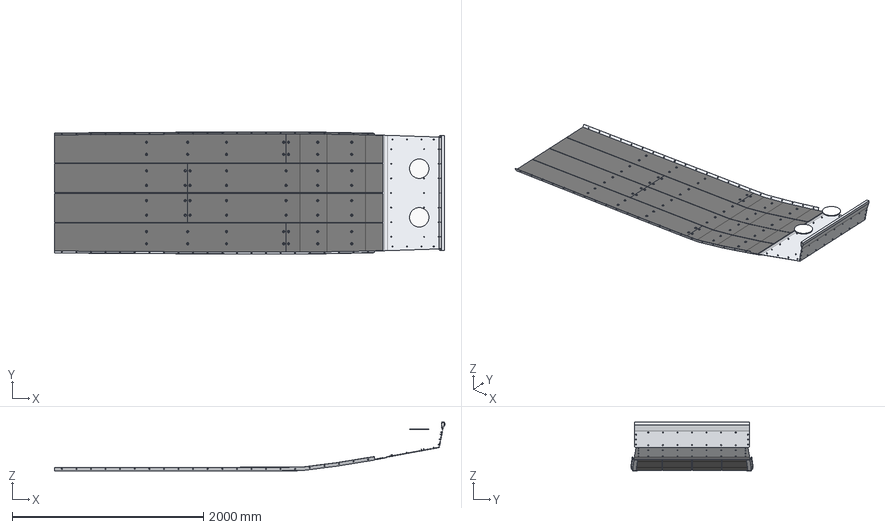
[picture p85: CAD file, 2026-11-02]
rev8_JonAirBoat/CAD/Airboat_v1.0.0.2_Hull_and_armor.step
4074.0 x 1276.3 x 507.7 mm
