acappon/DIY-MiniAirboat/rev0_StitchAndGlue/DIY-Mini-Airboat_DXF_cut_flat_parts_on_cnc/A_frame_leg_cap_1-8.dxf

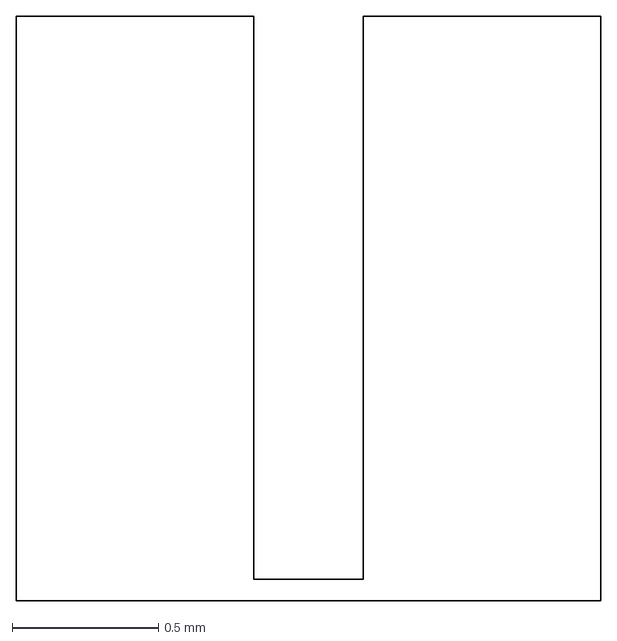
[picture p86: CAD file, 2026-10-30]
rev0_StitchAndGlue/DIY-Mini-Airboat_DXF_cut_flat_parts_on_cnc/A_frame_leg_cap_1-8.dxf
2.00 x 2.00 mm
