acappon/DIY-MiniAirboat/rev8_JonAirBoat/CAD/Airboat_v1.0.0.2_Drivetrain_mounts.step

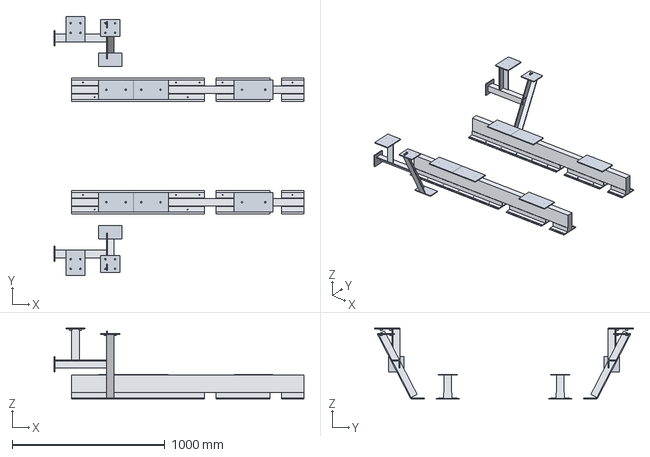
[picture p87: CAD file, 2026-11-02]
rev8_JonAirBoat/CAD/Airboat_v1.0.0.2_Drivetrain_mounts.step
1638.3 x 1695.3 x 464.8 mm
