acappon/DIY-MiniAirboat/rev0_StitchAndGlue/DIY-Mini-Airboat_DXF_cut_flat_parts_on_cnc/footrest_ladder_foot_plates.dxf

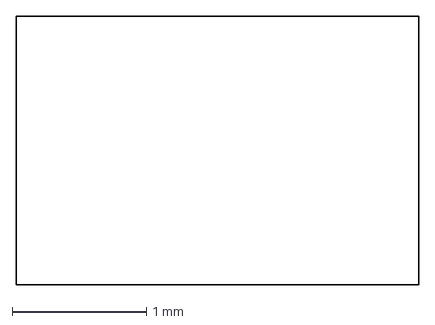
[picture p89: CAD file, 2026-10-30]
rev0_StitchAndGlue/DIY-Mini-Airboat_DXF_cut_flat_parts_on_cnc/footrest_ladder_foot_plates.dxf
3.00 x 2.00 mm
