acappon/DIY-MiniAirboat/rev0_StitchAndGlue/DIY-Mini-Airboat_DXF_cut_flat_parts_on_cnc/cage_foot_pads_1-4_steel.dxf

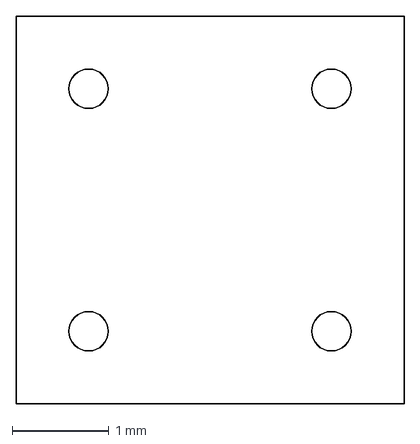
[picture p91: CAD file, 2026-10-30]
rev0_StitchAndGlue/DIY-Mini-Airboat_DXF_cut_flat_parts_on_cnc/cage_foot_pads_1-4_steel.dxf
4.00 x 4.00 mm
