acappon/DIY-MiniAirboat/rev0_StitchAndGlue/DIY-Mini-Airboat_DXF_cut_flat_parts_on_cnc/A_frame_foot_gussets_1-4.dxf

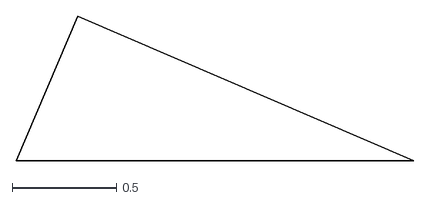
[picture p92: CAD file, 2026-10-30]
rev0_StitchAndGlue/DIY-Mini-Airboat_DXF_cut_flat_parts_on_cnc/A_frame_foot_gussets_1-4.dxf
1.90 x 0.689
