acappon/DIY-MiniAirboat/(list of files, cad)

Other CAD files:
rev0_StitchAndGlue/CAD/DIY-Mini-Airboat_hull_r4-2_aluminum.step
StraddleDart_rev7/CAD/flotation.step
rev8_JonAirBoat/CAD/Airboat_v1.0.0.2_Cage_and_rudders.step
StraddleDart_rev7/CAD/StraddleDart_rev7_Cage_and_rudders.f3d
StraddleDart_rev7/CAD/StraddleDart_rev7_Drivetrain.f3d
StraddleDart_rev7/CAD/StraddleDart_rev7_Flotation.f3d
StraddleDart_rev7/CAD/StraddleDart_rev7_Hull.f3d
StraddleDart_rev7/CAD/StraddleDart_rev7_Layout.f3d
StraddleDart_rev7/CAD/StraddleDart_rev7_Render_people.f3d
archive/StraddleDart_rev7/CAD/StraddleDart_rev7_Cage_and_rudders.f3d
archive/StraddleDart_rev7/CAD/StraddleDart_rev7_Drivetrain.f3d
archive/StraddleDart_rev7/CAD/StraddleDart_rev7_Flotation.f3d
archive/StraddleDart_rev7/CAD/StraddleDart_rev7_Hull.f3d
archive/StraddleDart_rev7/CAD/StraddleDart_rev7_Layout.f3d
archive/StraddleDart_rev7/CAD/StraddleDart_rev7_Render_people.f3d
archive/StraddleDart_rev7/CAD/flotation.step
archive/rev0_StitchAndGlue/CAD/DIY-Mini-Airboat_hull_r4-2_aluminum.step
rev8_JonAirBoat/CAD/Airboat_v1.0.0.1_Hull_and_armor.step
rev8_JonAirBoat/CAD/Airboat_v1.0.0.2_Assembly.step
rev8_JonAirBoat/CAD/Airboat_v1.0.0.4_Assembly.step
rev8_JonAirBoat/CAD/Airboat_v1.0.0.4_Cockpit.step
rev8_JonAirBoat/CAD/Airboat_v1.0.0.4_Controls.step
rev8_JonAirBoat/CAD/Airboat_v1.0.0.4_Dash.step
rev8_JonAirBoat/CAD/Airboat_v1.0.0.4_Stand_engine_cage.step
rev8_JonAirBoat/CAD/Airboat_v1.0.0.4_Wiring.step
rev8_JonAirBoat/CAD/Airboat_v1.0.1.0_Wiring.step
rev8_JonAirBoat/CAD/Airboat_v1.0.1.2_Controls.step
rev8_JonAirBoat/CAD/Airboat_v1.0.1.2_Stand_engine_cage.step
