acappon/DIY-MiniAirboat/StraddleDart_rev7/Electrical/Wiring_Schematic.html

Straddle Dart, rev 7, 12 V system

# Airboat Wiring Schematic

Every circuit from the Group 31 battery to its load, with wire gauge, insulation colour, fuse and route. The same table names the parts in the Fusion model, so the CAD looms carry exactly these wires.

- FUSES18 AWG is fused 10 A at most; a 20 A fuse only on 12 AWG.
- RETURNSLights and the 12 V outlet run red/black pairs end to end. No chassis-ground returns.
- MAIN SWITCHEverything is after the main switch except the automatic bilge pump (ABYC H-22).
- OUTSIDE THE BAYTinned marine wire, split loom, sealed Deutsch DT/DTP connectors.

## One-line diagram

red + black - (drawn light in dark mode) purple, key and gauge feed yellow-red, start brown, bilge sealed connector fuse

## Control and signal wiring

Every 18 AWG control, sensor and switch wire: key and kill switch, relay coils, gauges and their senders, the light switches and the bilge switch. Each line is one wire from where it starts to where it ends, with its insulation colour. The heavy power wiring is on the one-line diagram above.

## Power distribution hub

A 12-way sealed blade-fuse block with a negative bus, on the port wall of the battery bay. It is fed from the main switch through a 60 A MRBF fuse on 6 AWG red.

# | Circuit | Fuse | Wire | Colours (+ / -) | Load | Run

1 | 12 V outlet + USB-A charger | 20 A | 12 AWG | red / black | dash sockets | dash loom
2 | key switch supply | 10 A | 18 AWG | purple | key BATT | dash loom
3 | EFI main relay (ECU, coil, injectors) | 20 A | 12 AWG | red / black | engine connector | engine trunk
4 | start relay -> solenoid S | 20 A | 12 AWG | yellow-red | starter solenoid | engine trunk
5 | fuel pump (pump relay, ECU-switched) | 10 A | 18 AWG | red / black | fuel pump | engine trunk
6 | spare (gauges are fed from key IGN, 2026-11-01) | - | - | - | - | -
7 | LED light bar (dimmer, OFF-LO-MED-HI) | 20 A | 12 AWG | red / black | light bar | lights loom
8 | searchlight (dimmer, OFF-LO-MED-HI) | 10 A | 12 AWG | red / black | searchlight | lights loom
9 | nav lights (two relays, dash NAV-OFF-ANCHOR rocker) | 5 A | 12 AWG | red / black | bow combination (nav relay) + stern all-round (anchor relay) | bow loom, lights loom
10 | spare | - | - | - | - | -
11 | spare | - | - | - | - | -
12 | spare | - | - | - | - | -

## Battery, starter and feed cables

| From | To | Cable | Protection | Note
S1 | battery + | main switch IN | 1/0 AWG red | fusible link (4 AWG, at battery +) | cranking and everything else
S2 | main switch OUT | starter solenoid B+ | 1/0 AWG red | fusible link (S1) | alternator charges back through this cable
S3 | engine block ground stud | battery - | 1/0 AWG black | -
S4 | main switch OUT | hub + bus | 6 AWG red | 60 A MRBF on the switch OUT stud | the whole hub is after the main switch
S5 | hub - bus | battery - | 6 AWG black | -
S6 | battery + | bilge switch | 18 AWG red | 10 A MRBF at battery + | ABYC H-22: automatic bilge pump not killed by the main switch
S7 | alternator B+ | starter B+ stud | 6 AWG red | - | engine-side harness (G13 alternator 55 A)

## Wire list

Lengths come from the CAD routes plus 15% for service loops and terminations.

Circuit | Wire | Colour | Fuse | From | To | Run | Length
Cranking | 1/0 AWG | red | fusible link 4 AWG | battery + | main switch IN | battery bay | 0.4 m (2 ft)
Cranking | 1/0 AWG | red | fusible link | main switch OUT | starter solenoid B+ | conduit, guard grommet | 2.9 m (10 ft)
Engine ground | 1/0 AWG | black | - | battery - | engine block stud | conduit, guard grommet | 2.5 m (9 ft)
Hub feed | 6 AWG | red | 60 A MRBF | main switch OUT | hub + bus | battery bay | 0.1 m (1 ft)
Hub return | 6 AWG | black | - | hub - bus | battery - | battery bay | 0.2 m (1 ft)
Bilge pump (auto) | 18 AWG | red | 10 A MRBF | battery + | bilge switch | battery bay | 0.4 m (2 ft)
Bilge pump | 18 AWG | brown, brown-red, black | (10 A) | bilge switch | pump, float switch | engine loom, bilge branch | 3.5 m (12 ft)
12 V outlet + USB | 12 AWG | red / black | 20 A | hub 1 | dash sockets | dash loom | 2.5 m (9 ft)
Key supply | 18 AWG | purple | 10 A | hub 2 | key BATT | dash loom | 2.5 m (9 ft)
Key IGN / kill | 18 AWG | purple, purple-white | (10 A) | key IGN, kill switch | EFI main relay coil | dash loom | 2.8 m (10 ft)
Key START | 18 AWG | yellow-red | (10 A) | key START | start relay coil | dash loom | 2.8 m (10 ft)
EFI main | 12 AWG | red | 20 A | hub 3, EFI main relay | engine connector | engine loom | 2.3 m (8 ft)
Start | 12 AWG | yellow-red | 20 A | hub 4, start relay | solenoid S (engine connector) | engine loom | 2.3 m (8 ft)
Fuel pump | 18 AWG | red / black | 10 A | hub 5, pump relay | fuel pump | engine loom, pump branch | 1.8 m (7 ft)
Pump relay signal | 18 AWG | green-white | - | ECU | pump relay coil | engine loom | 2.3 m (8 ft)
Gauges | 18 AWG | purple / black | (10 A, hub 2) | key IGN; black to the - bus | tach, temp, fuel gauge, trouble light | dash, dash loom | 2.5 m (9 ft)
Tachometer | 18 AWG | dark gray | - | ECU tach out | tachometer | engine loom, dash loom | 4.7 m (16 ft)
Engine temperature | 18 AWG | tan | - | coolant temp sender | water temp gauge | engine loom, dash loom | 4.7 m (16 ft)
Trouble light | 18 AWG | brown-white | - | ECU MIL out | red trouble light | engine loom, dash loom | 4.7 m (16 ft)
Fuel level | 18 AWG | pink / black | - | tank sender | fuel gauge | bow loom, dash loom | 4.5 m (15 ft)
LED light bar | 12 AWG | red / black | 20 A | hub 7, dimmer | light bar | lights-power loom, lights loom | 6.6 m (22 ft)
Light bar level | 18 AWG | dark blue, blue-white, black | - | rotary switch | light bar dimmer | dash loom | 2.1 m (7 ft)
Searchlight | 12 AWG | red / black | 10 A | hub 8, dimmer | searchlight | lights-power loom, lights loom | 6.8 m (23 ft)
Searchlight level | 18 AWG | dark blue, blue-green, black | - | rotary switch | searchlight dimmer | dash loom | 2.1 m (7 ft)
Nav lights, bow | 12 AWG | red / black | 5 A | hub 9, nav relay | bow combination light | dash loom, bow loom | 3.6 m (12 ft)
Nav lights, stern | 12 AWG | red / black | 5 A | hub 9, anchor relay | stern all-round light | lights-power loom, lights loom | 7.1 m (24 ft)
Nav rocker NAV | 18 AWG | dark gray | - | dash NAV-OFF-ANCHOR rocker, NAV | nav relay coil + anchor relay coil (diode) | dash loom | 2.1 m (7 ft)
Nav rocker ANCHOR | 18 AWG | gray-white | - | dash NAV-OFF-ANCHOR rocker, ANCHOR | anchor relay coil (diode) | dash loom | 2.1 m (7 ft)
Gauge lights | 18 AWG | blue-yellow | (10 A, hub 2) | rocker NAV, light bar rotary pole 2 (a 1N5408 diode from each) | tach, temp and fuel gauge lamps | inside the dash | 0.6 m (2 ft)

## Signal colours

Signal | Colour | From | To | Run
key IGN | purple | key IGN | kill switch -> EFI main relay coil, gauges | dash loom
kill switch return | purple-white | kill switch | EFI main relay coil | dash loom
key START | yellow-red | key START | start relay coil | dash loom
tachometer | dark gray | ECU tach out | tachometer | engine trunk, dash loom
engine temperature | tan | coolant temp sender | water temp gauge | engine trunk, dash loom
fuel level | pink | tank sender (240-33 ohm) | fuel gauge | bow loom, dash loom
fuel sender ground | black | tank sender | hub - bus | bow loom, dash loom
trouble light | brown-white | ECU MIL out | red trouble light | engine trunk, dash loom
fuel pump relay | green-white | ECU pump out | pump relay coil | engine trunk
light bar level | dark blue / blue-white / black | rotary switch | light bar dimmer | dash loom
searchlight level | dark blue / blue-green / black | rotary switch | searchlight dimmer | dash loom
nav rocker NAV | dark gray | dash rocker NAV | nav relay coil, and anchor relay coil through a diode | dash loom
nav rocker ANCHOR | gray-white | dash rocker ANCHOR | anchor relay coil through a diode | dash loom
gauge lights | blue-yellow | rocker NAV and light bar rotary pole 2, each through a diode | tach, temp and fuel gauge lamps; lamp - to the gauge grounds | inside the dash
bilge AUTO | brown | bilge switch AUTO | float switch -> pump | engine trunk
bilge MAN | brown-red | bilge switch MAN | pump | engine trunk
bilge ground | black | pump, float switch | hub - bus | engine trunk

## Sealed connectors

Where | Connector | Location
engine harness | Deutsch DT 12-pin + DTP 2-pin | trunk end, port side of the block
starter B+ / ground | tinned 1/0 lugs, adhesive heat-shrink + boots | starter and block studs
bilge pump | Deutsch DT 2-pin | sump
float switch | Deutsch DT 2-pin | sump
fuel pump | Deutsch DT 2-pin | port engine bed
dash | Deutsch DT 12-pin + DTP 2-pin | inside the closed dash hood
switch row | Deutsch DT 12-pin | inside the closed dash hood
light bar | Deutsch DTP 2-pin | front hoop top
searchlight | Deutsch DTP 2-pin | turret base
stern light | Deutsch DTP 2-pin | mast base
bow light | Deutsch DTP 2-pin | stanchion base
fuel sender | Deutsch DT 2-pin | tank front (tank stays removable)

## Inside the battery bay

Part | Type | Mounted
start relay | 12 V 40 A sealed relay | port wall
EFI main relay | 12 V 40 A sealed relay | port wall
fuel pump relay | 12 V 40 A sealed relay | port wall
nav light relay | 12 V 40 A sealed relay | port wall
anchor light relay | 12 V 40 A sealed relay, two 1N5408 diodes on its coil | starboard wall
light bar dimmer | IP67 PWM dimmer, 20 A, 3-wire remote input | starboard wall
searchlight dimmer | IP67 PWM dimmer, 20 A, 3-wire remote input | starboard wall
gauge light diodes | two 1N5408, heat-shrunk in the dash harness | behind the dash panel

## Notes

1. Turn the boat on and off with the key. Use the main switch to change the battery or in an emergency. Don't open it with the engine running: the alternator charges through the 1/0 cable and would lose its load.
2. The kill-switch lanyard opens the key IGN line to the EFI main relay coil, so pulling it stops ignition, injectors and fuel pump.
3. The key carries only relay-coil, gauge and gauge-light current (under 3 A), so its 18 AWG on 10 A is protected. Hub fuse 6 is a spare: the gauges take their power from key IGN. The starter solenoid and EFI loads are switched by relays fed on 12 AWG.
4. The bilge pump runs from its own 10 A fuse at the battery, so the float switch still works with the main switch off.
5. The portable tank needs an electric fuel sender (US standard 240-33 ohm). Its DT2 connector lets the tank come out.
6. The light bar and searchlight dimmers take a 3-wire remote input. Check the chosen rotary switch matches the dimmer's input type.
7. The gauge lights come on with the running lights (rocker on NAV) or the light bar in any setting, key on or off. Two diodes join the two feeds so neither switch back-feeds the other. The light bar rotary needs a second pole, closed in LO, MED and HI, fed from the nav rocker supply.
