acappon/DIY-MiniAirboat/StraddleDart_rev7/Electrical/Wiring_Control_and_Signals.pdf

# Straddle Dart rev 7 — 12 V control and signal wiring (18 AWG)

DASH AND SWITCH ROW (closed hood) | BATTERY BAY (dry) | ENGINE, SUMP AND TANK

KEY, KILL SWITCH AND START

key switch BATT | hub fuse 2, 10 A
after the main switch

18 AWG purple

dash DT12
key switch IGN | kill switch (lanyard) normally closed
kill switch | EFI main relay coil 86 coil 85 to the - bus

18 AWG purple-white

dash DT12
key switch START | start relay coil 86 coil 85 to the - bus

18 AWG yellow-red

dash DT12

### EFI main relay 87

fuse 3, 20 A

### ECU, coil, injectors +

factory G13B harness

12 AWG red (power, see one-line)

engine DT12

### start relay 87

fuse 4, 20 A

### starter solenoid S

12 AWG yellow-red (power)

engine DT12

GAUGES AND ENGINE SIGNALS

key switch IGN | gauges + trouble light + tach, temp, fuel

### gauge grounds

tach, temp, fuel, light

### hub - bus

18 AWG black

dash DT12
tachometer signal | ECU tach output factory harness

18 AWG dark gray

dash DT12 | engine DT12
water temp gauge S | coolant temp sender gauge sender, head

18 AWG tan

dash DT12 | engine DT12
red trouble light - | ECU check-engine (MIL) output switches to ground

18 AWG brown-white

dash DT12 | engine DT12

### pump relay coil 85

coil 86 from EFI relay 87

### ECU fuel pump output

switches to ground

18 AWG green-white

engine DT12

FUEL LEVEL

fuel gauge S | tank sender, 240-33 ohm DT2 at the tank front

18 AWG pink

dash DT12 | tank DT2
hub - bus | tank sender ground 18 AWG black
| tank DT2

LIGHTS: SWITCHES TO RELAYS AND DIMMERS

### nav rocker supply

key BATT: works key-off

### NAV-OFF-ANCHOR rocker

rocker NAV | nav relay coil 86 + anchor coil via diode

18 AWG dark gray

dash DT12
rocker ANCHOR | anchor relay coil 86 via diode; coils 85 to - bus

18 AWG gray-white

dash DT12

### light bar rotary

OFF-LO-MED-HI

### light bar dimmer remote

3-wire input

18 AWG blue, blue-white, black

dash DT12

### searchlight rotary

OFF-LO-MED-HI

### searchlight dimmer remote

3-wire input

18 AWG blue, blue-green, black

dash DT12

### rocker NAV

running lights on

### light bar rotary pole 2

closed LO-MED-HI

### gauge lamps +

tach, temp, fuel
- to gauge grounds

1N5408

1N5408

18 AWG blue-yellow, all inside the dash. Pole 2 common takes key BATT from the nav rocker supply.

BILGE PUMP (always live, own 10 A fuse at battery +)

### bilge switch AUTO

bench front

### float switch -> pump +

sump

18 AWG brown

sump DT2
bilge switch MAN | bilge pump + bypasses the float

18 AWG brown-red

sump DT2
hub - bus | pump and float grounds

18 AWG black

sump DT2

Alternator: G13B factory charging connections (IG sense, L lamp) stay in the engine harness; B+ joins the starter stud (one-line diagram). Striped wires (x-white, x-red, x-green, x-yellow) are drawn as a solid base colour with a dashed stripe.
