acappon/DIY-MiniAirboat/StraddleDart_rev7/Build_Guide_rev7.xlsx

Straddle Dart — step-by-step build guide (riveted aluminum hull) (rev 7)
DIY hours assume a skilled backyard mechanic with a pneumatic rivet gun, who can TIG-weld aluminum and has a small shop. Pro cost is labor only (materials are in the BOM workbook), at roughly $90-100/hr shop rates.
Step | DIY time (hours) | Pro cost, labor only ($) | Key checks
Hull (riveted aluminum) Option: a local CNC router or waterjet shop can cut the skins and flat parts straight from the CAD flat patterns (DXF), with 1/8 in pilot holes at every rivet position. That replaces most of the full-size templates in step 1 and the hole layout in step 8, about 10-14 h less, for roughly $200-500 of cutting (get quotes); the chine bends still go to the brake. The steps below assume hand layout.
1. Export flat patterns of every skin panel, frame and stringer from the CAD in OnShape; print full-size templates | 6 | $450 | Check bottom blank 60 x 150 in incl. rocker
2. Build a level strongback (two straight rails on stands) and stand the frames on it as the station molds, braced square and to the CAD spacing; they stay in the hull, so no separate molds are needed | 6 | $420 | Twist-free to 1/16 in end to end
3. Order 5052-H32 sheet (0.125 in bottom, chine and bow face; 0.063 in sides; 0.125 in transom); have a fab shop shear the blanks and brake the 45 deg chine bends and transom flanges, and brake the two 1/8 in chine-guard strips to 135 deg in the same session | 4 | $650 | Pro cost here = shear and brake service
4. Cut and form stringers (hat or angle sections) to the rocker curve; cut the ten frames from angle (x 12, 24, 36, 48, 60, 72, 84, 96, 111.5 and 120 in; 60 and 84 are copies of 72, 111.5 a copy of 96); notch a 1 x 3/4 in limber in every bay of every frame and a cross-drain slot in every stringer at x 3.5-4.5 | 23 | $1800 | Stringers line up under the UHMW strip edges; deburr and prime every notch
5. Cleco frames and stringers together on the jig; check square and diagonals; rivet the framing | 15 | $1180
6. Fit the bottom sheets: flat to x = 120 in, then the conic roll-up tangent into the 15 deg raked bow plate; centerline seam over a doubled center stringer; cleco and trim | 12 | $950 | Sides angle in to the 45 in bow plate; only one long bottom seam
7. Fit chine/side panels, bow face and transom; cleco every lap (1 in minimum); check symmetry and chine angle | 12 | $900
8. Drill all rivet holes to final size (3/16 in) and deburr both sides: double rows at 3/4 in on the bottom centreline seam, the transverse butt seam and the chine laps; double rows at 1 in on the side, transom and bow laps above the waterline | 11.5 | $870 | About 1,850 holes
9. Take laps apart, clean, prime faying surfaces and every cut edge with self-etching primer, butter with sealant (Sikaflex 291 or 3M 4200), rivet with closed-end aluminum blind rivets | 20.5 | $1580 | Wet sealant squeeze-out along every seam
10. Install engine beds (doubled aluminum stringers + plates on HDPE), cage mount plates, aluminum rub rail at the sheer | 8 | $600 | Bed plates level side to side within 1/16 in
11. Leak test: hull on stands, fill with 4 in of water, check the outside (before UHMW) for 24 h; mark and fix leakers. Repeat with UHMW on, watching the strip edges | 8 | $600 | Drill out and replace any weeping rivet; Gluvit on weeping laps
12. Fit UHMW strips; through-bolt into the stringers with sealant, slotted toward the ends; fit the brake-formed chine guards over the strip edges and the nose cap | 9 | $680 | Fix strips at mid-length only
13. Finish: the hull stays bare 5052 (primer only on faying surfaces and cut edges, step 9); touch up any scratch through to bare metal at a cut edge; a topcoat can be added later | 2 | $150 | No unprimed cut edges
Drivetrain
14. Find a G13B (1989-94 Suzuki Swift GT/GTi, or a JDM Cultus GT-i import with its ECU and harness); compression-test it; replace timing belt, water pump, gaskets, plugs | 18 | $1250 | Compression even across cylinders; check the twin-cam head clears the A-frame legs, radiator hoses and exhaust in the CAD envelope
15. Measure the bellhousing pattern (the G13B shares the G13-family pattern: confirm on the block); machine the adapter plate and jackshaft housing; fit the flex coupling | 12 | $1000 | Jackshaft runout under 0.003 in
16. Build engine mounts with polyurethane bushings; set the engine low on the bed plates | 8 | $650 | Crank 15 in above the hull bottom
17. Fabricate and TIG-weld A-frames, gusset peak plates, feet, diagonal braces, tie struts; the forward crossbar is 2 x 3 x 1/8, 3 in deep, its bottom on the tie-strut tabs | 30 | $2500 | Peak plates parallel and the shaft bores in line; tie-strut bolts tight before every run (they carry the belt pull)
18. Build the tension yoke; machine the prop shaft (4140 pre-hardened, 28-32 HRC) and flange; mount the flange bearings; carry the thrust on a shaft shoulder or clamped collar | 14 | $1150 | Shaft cannot creep fore or aft with the set screws loose
19. Install pulleys, belt and optional idler; align pulleys with a straightedge or laser; set tension with the jack screw | 6 | $450 | Tighten slot bolts first, pivot bolts last
20. Mount the prop; set pitch so full throttle standing still reaches 6,000-6,300 rpm (the G13B peaks at 6,500); track the blades; static thrust test on a scale (expect about 430 lb) | 5 | $420 | Blade tips track within 1/8 in; never set the pitch so coarse the engine bogs below 6,000 rpm
21. Mount the radiator on the cradle; plumb hoses; fill and bleed coolant | 6 | $450
22. Build the exhaust: raised muffler on hangers from the starboard engine-bed plate, above the aft foam, with a heat shield; flex section after the manifold; tailpipe over the transom | 14 | $1150 | Muffler clear of the foam and the belt; tailpipe below the prop disk
23. Fuel system and throttle cable | 6 | $450
Prop cage, rudders and steering
24. Have the two 72.4 in DOM hoops rolled (1 x .083); cut and fit legs, rails, longitudinals and aft bars (all 1 x .065 DOM), a diagonal in each side bay (aft foot to the forward leg 3 in below the hoop), 1/2 EMT front bars; weld the cage | 20 | $1700 | DOM yield 50 ksi or better on the mill cert; grind zinc off the EMT before welding; ventilate
25. Fit 1/2 in hardware cloth front, aft and sides; install the shaft sleeve; paint | 10 | $750 | At least 4.7 in from mesh to any blade
26. Make the honeycomb rudders: cut, edge channels, seal edges, hinge tubes | 12 | $950 | No open cells anywhere
27. Steering: weld the new horns (3.5 in aft, 2 in outboard) to the rudder hinge tubes; weld the 3/8 x 1.5 bellcrank bracket to the aft hoop at the lower-rail end and notch the aft screen mesh round it; fit the bellcrank, the tie bar and drive link behind the aft screen (rod ends below the horns, bolts in from below), and the straight 1 x .065 long rod outside the cage to the lever; set rudders parallel | 10 | $800 | Full lock both ways with nothing touching; lever about +-10 deg for +-33 deg rudder; no free play at any rod end
Floor, seating, controls and flotation
28. Open sump: install pump, float switch with cycle counter, outside-reachable auto/off/manual switch, bailer, 1 in drain plug, through-hull and raised FRP grate box; pour a bucket in each bay and check it reaches the sump | 7 | $560 | Bailer check valve works; every bay drains; pump switch reachable from the water
29. Make the 24 foam blocks (20 thin blocks aft of x = 72 in, 4 bow blocks): pour urethane foam per bay onto release-lined Coroplast trays (or into molds), trim to fit with 1/16 in clearance, seal-coat, glue on HDPE pads | 12 | $950 | Urethane only; nothing bonded to the hull; blocks lift out
30. Make bolt-down floor panels resting on the stringer tops, and the bow shelf (sealed 3/8 in plywood or 0.063 in aluminum), on rivnuts and gasket tape; cut and fit 8 deck plates | 12 | $950 | Panels hold the blocks down if swamped; floor drains aft to the sump
31. Build the bench: 1/2 in ply box with a sealed bottom panel and bulkhead at x = 87 in; battery bay forward with an Al ledge ring, EPDM gasket and a flush lid bolted into clip nuts; dry storage / cooler aft with a flush padded lid hinged on the starboard top corner, locking stays at both ends, rubber T-latch and a 1 in drain plug | 22 | $1700 | Hose-test both lids; the cooler lid stops at 95 deg and rests open
32. Backrests, grab handles (loop 10.5 in off centre), engine guard, two foot ladders (left rails 7.5 and 12.5 in to port, right 7.5 and 14.5 in to starboard, solid 1 in rod, foot plates bolted to floor rivnuts and the bow shelf), rung-mounted throttle pedal on the right ladder (arm, torsion spring, rest stop), padded cushions | 14 | $1100 | Pedal clears the next rung fully pressed on every rung
33. Mold or cut the strap-in foam side blocks (taller with the low floor); fit straps | 6 | $450 | They provide the swamped stability: always strapped in
Joint details, rev 6 (added work only; base fabrication is in the sections above)
34. Cut plates from the DXF flat patterns (plasma or waterjet, or send out); deburr, drill to final size | 4 | $300 | Check hole positions against the fab workbook
35. Cut tubes per the cut list: mitre leg ends, slot leg tops 3/8 x 2.5, cope cage tubes (hole saw or notcher) | 4 | $300 | Dry-fit every joint before welding
36. Weld the A-frame weldments in a jig: legs into peak plate, caps, crossbar, feet, gussets, clevis tabs | 3 | $250 | Peak plates parallel, shaft bores in line; weld alternately to limit distortion
37. Build the engine-mount cradles and engine-side brackets; fit poly bushings and through-bolts | 4 | $350 | Drill brackets to the real block's mount bosses
38. Fit braces with clevis bolts, tie struts, radiator mounts and stays, exhaust hangers and saddle | 3 | $250 | Everything removable unbolts without cutting
39. Cage: weld coped nodes, drill and bolt the steel pads over HDPE isolators; fit rudder pivots, rod ends, tie bar | 3 | $250 | Rudders swing freely lock to lock
40. Bench sockets, handle flanges, clips, battery tray, steering pivot, ladder feet, bow-shelf angles and padeyes | 4 | $300 | Backrests drop in and pin; shelf solid underfoot
Electrical, finish and testing
41. Battery bay power: Group 31 AGM; 4 AWG fusible link and 1/0 red to the sealed main switch on the bench front (rubber gasket, studs inside the bay); 60 A MRBF and 6 AWG red to the 12-way hub, 6 AWG black return; 10 A MRBF at battery + for the bilge; 4 relays on the port wall, 2 dimmers on the starboard wall (see the wiring schematic) | 10 | $800 | Every circuit fused at its source: 10 A max on 18 AWG, 20 A only on 12 AWG
42. Build and fit the adjustable trim tab; rivet a 3/8 x 2 in 6061 flat bar inside the transom behind the tab bracket, from the bottom frame angle to the rub rail, and bolt the bracket through it | 4 | $300 | Bracket bolts through the flat bar, not the bare 1/8 transom
43. Ground runs: tach sweep, belt tension and flap, cooling, vibration; re-torque all bolts | 8 | $650 | Listen for rough rpm bands
44. Dock tests: float level, bilge pump, optional swamp test | 4 | $300
45. Water trials: trim tab and prop pitch setup, steering, planing two-up | 8 | $650
46. Registration, numbering, safety gear check | 2 | $150
Rev 7 additions: driver station, lights, searchlight, power, deck hardware, safety, electrical
47. Driver side frame: cut and TIG-weld the two 2 x 2 posts, top rail, cross arms, 2 x 3 inner rail (posts, arms and rail all 3/16 wall), bowed 1-1/2 x .188 knee braces (roll to about 19 in radius), the inner rail stopping at the aft cross arm, the hinged armrest (aft 13 in of rail, lugs, U-bracket, 1/2 in pin, detent), diagonal and hull-side clips; bolt the base plates through the floor and the clips through backing plates (aft pair also through frame x96) | 14 | $1100 | Braces bow 2.5 in outboard; frame rock-solid under a hard pull
48. Armrest pad and grip: bend the 1-1/8 in 316 stick and weld it to its 316 base plate; bolt the plate through the console top and the inner rail (4 x 1/4 316, crush tubes, Tef-Gel and a gasket; never weld stainless to the aluminium rail); turn an M16 x 1.5 stud with a square shoulder on the stick end, run a 316 M16 x 1.5 nylon-insert lock nut onto it, thread on the Hurst T-handle (no adapter) across the boat and tighten the lock nut up hard under its neck, then cross-pin handle and stud with a 1/4 in 316 pin 0.4 in above the shoulder; set the armrest height (drv_armrest_h) and reach (drv_reach) to the driver | 4 | $300 | Hand lands on the T-handle seated against the backrest, forearm on the pad
49. Console and dash: rivet the front and outboard skins to the frame (slots for the clips, grommet for the bow loom); fit the 1/8 in top; cut the arched panel and fold it up 66 deg on the fold line; fit tach (centre), temp and fuel either side, and the bottom row: kill lanyard, key, trouble light, NAV-OFF-ANCHOR rocker, two rotaries, USB, 12 V; fold and rivet the hood, screw it and the top down with tamper-proof Torx | 14 | $1100 | No wire to the key reachable from outside; flaps seal; hose-test the hood
50. On the console top: drop-in cup holder by the grip, phone holder stalk at the front-inboard corner, both inclinometers (zero them with the boat level on calm water); rivet the life-jacket hook inside the outboard skin; pad both knee braces with 1 in closed-cell foam and the Cordura covers; rivet the 1/2 in fiddle rail (1/8 x 1-1/2 flat bar, top edges rounded) along the aft, inboard and forward edges of the console top | 4 | $300 | Both bubbles readable from the seat; the grip clears a full cup
51. Cage light bar and searchlight: clamp the brackets over the front hoop, fit the turret and yoke, mount the remote control on the console top forward of the cup holder, run the two push-pull cables along the hull side, cage leg and front hoop; adjust so the handle and grip track the light | 8 | $650 | Full yaw and pitch with no binding; cables clear of the prop
52. Throttle cable: run from the pedal anchor through glands in the bench walls and bulkhead, through the engine-guard grommet to the throttle body; leave a 6 in service loop in the bench | 3 | $250 | Full throttle at full pedal; snaps back to idle
53. Deck hardware: weld the bow knees, bolt the four cleats (bow on the knees, stern on the transom corners), weld the bow-eye strap and fit the ring | 4 | $300 | Cleats through-bolted with backing
54. Safety gear: B-1 extinguisher bracket (starboard) and air-horn bracket (port) on the bow shelf; apply the three swamped-boat warning labels (console top by the capacity label, inside each side of the bench) on clean, degreased aluminium | 1.5 | $100 | Extinguisher charged; reachable; labels readable from the seat and from the water at each side
55. Engine harness: 1-1/2 in PVC conduit along the cooler bottom port corner (sealed through the bulkhead and aft wall); 1/0 red to the starter B+ and 1/0 black to the block ground stud, booted; 5/8 in engine loom (EFI, start, pump, tach, temp, trouble, bilge) to the DT12 + DTP2 engine connector; 3-hole guard grommet; bilge and float-switch branches with DT2s; fuel pump and filter on the port bed plate | 10 | $800 | Cables clamped every 12 in, clear of the belt, brace and exhaust; start relay clicks on START
56. Dash and lights harness: two PG13 glands in the bay starboard wall; dash loom and lights-power loom along the deck cable cover and up the aft post; dash loom under the console top and up through its grommet into the closed hood (dash and switch-row connectors); lights loom to the light bar, searchlight and stern light; DT/DTP connectors at every device | 10 | $800 | Each rotary steps the light through LO-MED-HI; kill lanyard stops the engine
57. Nav lights, flag staff and fuel sender: bow combination light on its stanchion at the bow shelf front, all-round white on the 18 in mast on the aft hoop, bow loom under the starboard gunwale flange; flag-staff saddle and socket on the aft hoop 12 in port of the light, removable staff with the 12 x 10 in orange flag; electric sender in the tank with a DT2 at the tank front | 5 | $375 | Sidelights and all-round light visible from every bearing; flag bottom at least 120 in above the hull bottom and clear of the prop; fuel gauge reads full and empty
58. Sound check: measure dBA at 50 ft at idle, cruise and full throttle before using noise-limited waters | 2 | $150 | Record the numbers for lake officials
Total
DIY weekends at 16 hours each
Blue numbers are estimates you can edit; section rows and totals recalculate.
Comparison: stitch-and-glue hull version
Hull section only | 204 | $15850
Whole boat | 480 | $37850
Saved with the riveted aluminum hull (whole boat)
Values above come from the stitch-and-glue build guide (DIY-Mini-Airboat_Build-Guide.xlsx).
