acappon/DIY-MiniAirboat/rev0_StitchAndGlue/DIY-Mini-Airboat_Build-Guide_Aluminum.xlsx

DIY Mini-Airboat — step-by-step build guide (riveted aluminum hull)
DIY hours assume a skilled backyard mechanic with a pneumatic rivet gun, who can TIG-weld aluminum and has a small shop. Pro cost is labor only (materials are in the BOM workbook), at roughly $90-100/hr shop rates.
Step | DIY time (hours) | Pro cost, labor only ($) | Key checks
Hull (riveted aluminum) | 149 | $11780
1. Export flat patterns of every skin panel, frame and stringer from the CAD in OnShape; print full-size templates | 6 | $450 | Check bottom blank 60 x 150 in incl. rocker
2. Build a level strongback with station molds at each frame position | 10 | $700 | Twist-free to 1/16 in end to end
3. Order 5052-H32 sheet; have a fab shop shear the blanks and brake the 45 deg chine bends and transom flanges | 4 | $600 | Pro cost here = shear and brake service
4. Cut and form stringers (hat or angle sections) to the rocker curve; cut ribs and frames from angle; notch a 1 x 3/4 in limber in every bay of every frame and a cross-drain slot in every stringer at x 3.5-4.5 | 19 | $1480 | Stringers line up under the UHMW strip edges; deburr and prime every notch
5. Cleco frames and stringers together on the jig; check square and diagonals; rivet the framing | 14 | $1100
6. Fit the bottom sheets over the frame and bend them into the bow rocker; centerline seam over a doubled center stringer; cleco and trim | 12 | $950 | Only one long bottom seam
7. Fit chine/side panels, bow face and transom; cleco every lap (1 in minimum); check symmetry and chine angle | 12 | $900
8. Drill all rivet holes to final size (3/16 in, double rows at about 3/4 in spacing); deburr both sides | 12 | $900 | About 2,000 holes
9. Take laps apart, clean, prime faying surfaces, butter with sealant (Sikaflex 291 or 3M 4200), rivet with closed-end aluminum blind rivets | 22 | $1700 | Wet sealant squeeze-out along every seam
10. Install engine beds (doubled aluminum stringers + plates on HDPE), cage mount plates, aluminum rub rail at the sheer | 8 | $600 | Bed plates level side to side within 1/16 in
11. Leak test: hull on stands, fill with 4 in of water, check the outside (before UHMW) for 24 h; mark and fix leakers. Repeat with UHMW on, watching the strip edges | 8 | $600 | Drill out and replace any weeping rivet; Gluvit on weeping laps
12. Fit UHMW strips; through-bolt into the stringers with sealant, slotted toward the ends; fit the nose cap | 12 | $900 | Fix strips at mid-length only
13. Self-etching primer and topcoat | 10 | $900
Drivetrain | 116 | $9250
14. Find a G13 (Metro 1.3 or Swift), compression-test it; replace timing belt, water pump, gaskets, plugs | 16 | $1100 | Compression even across cylinders
15. Measure the bellhousing pattern; machine the adapter plate and jackshaft housing; fit the flex coupling | 12 | $1000 | Jackshaft runout under 0.003 in
16. Build engine mounts with polyurethane bushings; set the engine low on the bed plates | 8 | $650 | Crank 15 in above the hull bottom
17. Fabricate and TIG-weld A-frames, gusset peak plates, feet, diagonal braces, tie struts | 30 | $2500 | Peak plates parallel and the shaft bores in line
18. Build the tension yoke; machine the prop shaft and flange; mount the flange bearings | 14 | $1150
19. Install pulleys, belt and optional idler; align pulleys with a straightedge or laser; set tension with the jack screw | 6 | $450 | Tighten slot bolts first, pivot bolts last
20. Mount the prop; set pitch with the protractor; track the blades | 4 | $350 | Blade tips track within 1/8 in
21. Mount the radiator on the cradle; plumb hoses; fill and bleed coolant | 6 | $450
22. Build exhaust and muffler; fit heat shields away from wood, epoxy and UHMW | 14 | $1150 | Tailpipe stays below the prop disk
23. Fuel system and throttle cable | 6 | $450
Prop cage, rudders and steering | 52 | $4200
24. Have the two 72.4 in hoops rolled; cut and fit legs, rails, EMT; weld the cage | 20 | $1700 | Grind zinc off EMT before welding; ventilate
25. Fit 1/2 in hardware cloth front, aft and sides; install the shaft sleeve; paint | 10 | $750 | At least 4.7 in from mesh to any blade
26. Make the honeycomb rudders: cut, edge channels, seal edges, hinge tubes | 12 | $950 | No open cells anywhere
27. Steering: horns, tie bar, pushrod, rod ends, lever pivot; set rudders parallel | 10 | $800 | Full lock both ways without touching the cage
Floor, seating, controls and flotation | 67 | $5260
28. Open sump: install pump, float switch with cycle counter, outside-reachable auto/off/manual switch, bailer, 1 in drain plug, through-hull and raised FRP grate box; pour a bucket in each bay and check it reaches the sump | 7 | $560 | Bailer check valve works; every bay drains; pump switch reachable from the water
29. Make the 24 foam blocks (20 thin blocks aft of x = 72 in, 4 bow blocks): pour urethane foam per bay onto release-lined Coroplast trays (or into molds), trim to fit with 1/16 in clearance, seal-coat, glue on HDPE pads | 12 | $950 | Urethane only; nothing bonded to the hull; blocks lift out
30. Make bolt-down floor panels resting on the stringer tops, and the bow shelf (sealed 3/8 in plywood or 0.063 in aluminum), on rivnuts and gasket tape; cut and fit 8 deck plates | 12 | $950 | Panels hold the blocks down if swamped; floor drains aft to the sump
31. Build the watertight bench with gasketed lid; battery hold-down; cushion | 16 | $1250 | Hose-test the lid seal
32. Backrests, grab handles, engine guard, footrest ladder, throttle pedal, padded bar | 14 | $1100
33. Mold or cut the strap-in foam side blocks (taller with the low floor); fit straps | 6 | $450 | They provide the swamped stability: always strapped in
Joint details, rev 6 (added work only; base fabrication is in the sections above) | 25 | $2000
34. Cut plates from the DXF flat patterns (plasma or waterjet, or send out); deburr, drill to final size | 4 | $300 | Check hole positions against the fab workbook
35. Cut tubes per the cut list: mitre leg ends, slot leg tops 3/8 x 2.5, cope cage tubes (hole saw or notcher) | 4 | $300 | Dry-fit every joint before welding
36. Weld the A-frame weldments in a jig: legs into peak plate, caps, crossbar, feet, gussets, clevis tabs | 3 | $250 | Peak plates parallel, shaft bores in line; weld alternately to limit distortion
37. Build the engine-mount cradles and engine-side brackets; fit poly bushings and through-bolts | 4 | $350 | Drill brackets to the real block's mount bosses
38. Fit braces with clevis bolts, tie struts, radiator mounts and stays, exhaust hangers and saddle | 3 | $250 | Everything removable unbolts without cutting
39. Cage: weld coped nodes, drill and bolt the steel pads over HDPE isolators; fit rudder pivots, rod ends, tie bar | 3 | $250 | Rudders swing freely lock to lock
40. Bench sockets, handle flanges, clips, battery tray, steering pivot, ladder feet, bow-shelf angles and padeyes | 4 | $300 | Backrests drop in and pin; shelf solid underfoot
Electrical, finish and testing | 40 | $3200
41. Wire battery, kill switch, ignition, gauges, bilge pump and navigation lights | 14 | $1150 | Fuse every circuit
42. Build and fit the adjustable trim tab | 4 | $300
43. Ground runs: tach sweep, belt tension and flap, cooling, vibration; re-torque all bolts | 8 | $650 | Listen for rough rpm bands
44. Dock tests: float level, bilge pump, optional swamp test | 4 | $300
45. Water trials: trim tab and prop pitch setup, steering, planing two-up | 8 | $650
46. Registration, numbering, safety gear check | 2 | $150
Total | 449 | $35690
DIY weekends at 16 hours each | 28.0625
Blue numbers are estimates you can edit; section rows and totals recalculate.
Comparison: stitch-and-glue hull version
Hull section only | 204 | $15850
Whole boat | 480 | $37850
Saved with the riveted aluminum hull (whole boat) | 31 | $2160
Values above come from the stitch-and-glue build guide (DIY-Mini-Airboat_Build-Guide.xlsx).
