acappon/DIY-MiniAirboat/rev8_JonAirBoat/renderedImages/buildSteps/step1.2_uhmw_sheet.png

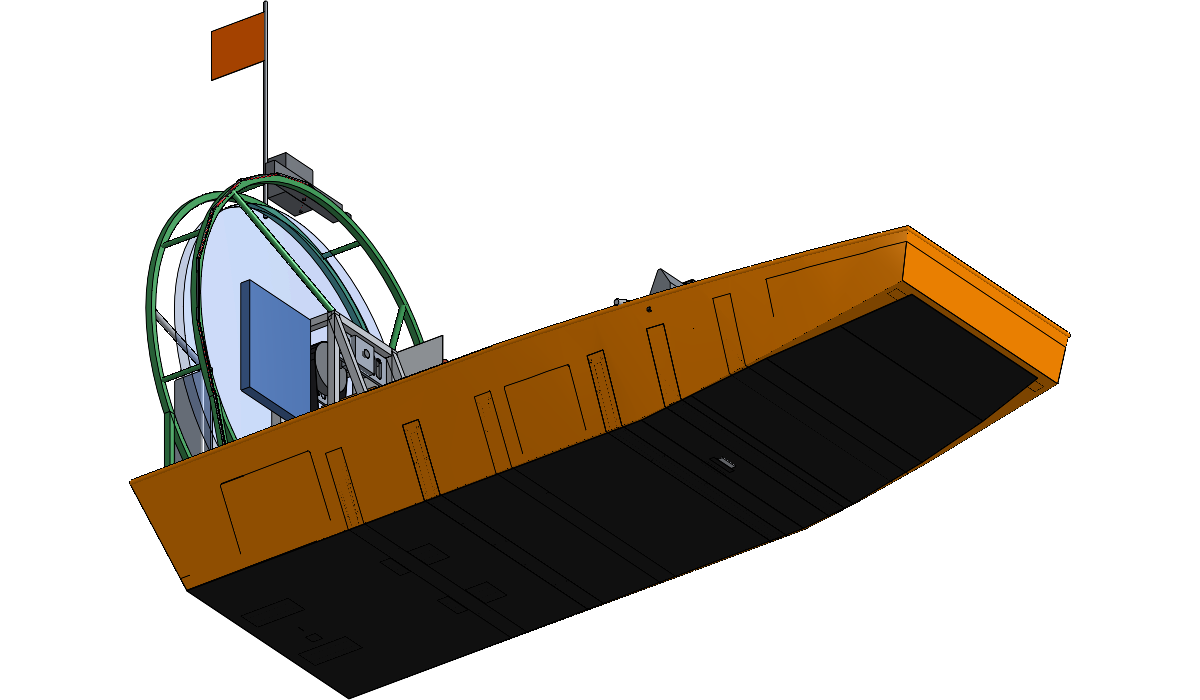
rev8_JonAirBoat/renderedImages/buildSteps/step1.2_uhmw_sheet.png
