acappon/DIY-MiniAirboat/rev8_JonAirBoat/renderedImages/buildSteps/step01_used_1448_jonboat.png

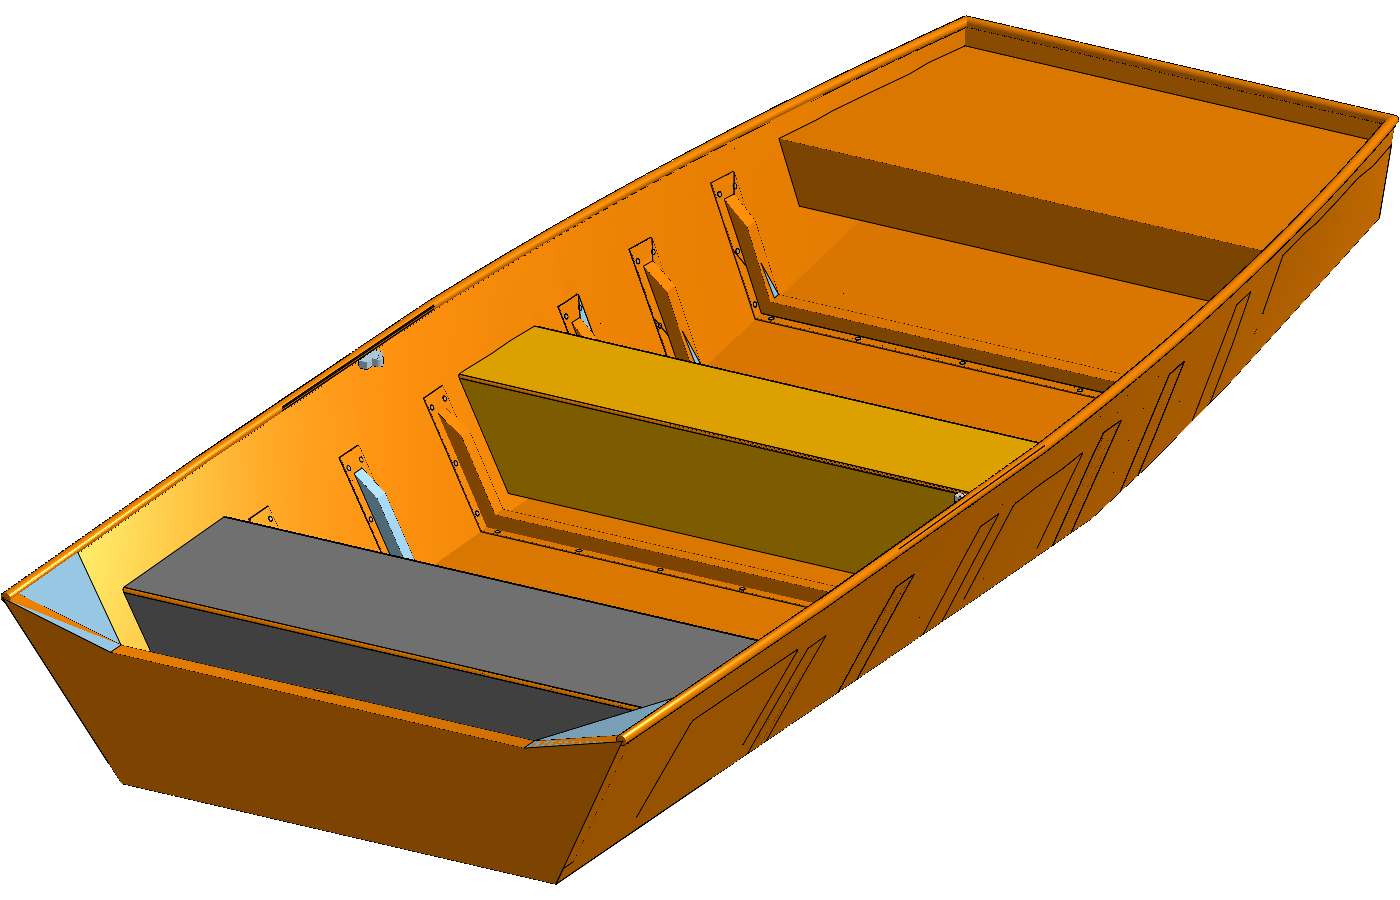
rev8_JonAirBoat/renderedImages/buildSteps/step01_used_1448_jonboat.png
