acappon/DIY-MiniAirboat/rev8_JonAirBoat/renderedImages/buildSteps/step2.3_stand_frames.png

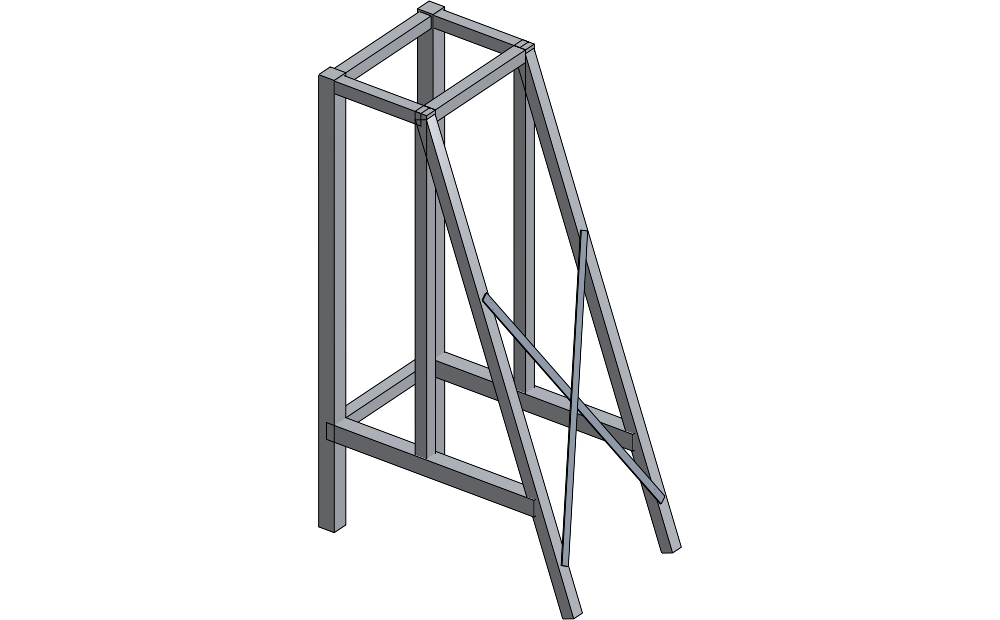
rev8_JonAirBoat/renderedImages/buildSteps/step2.3_stand_frames.png
