acappon/DIY-MiniAirboat/rev8_JonAirBoat/renderedImages/buildSteps/step2.6_shoes_installed.png

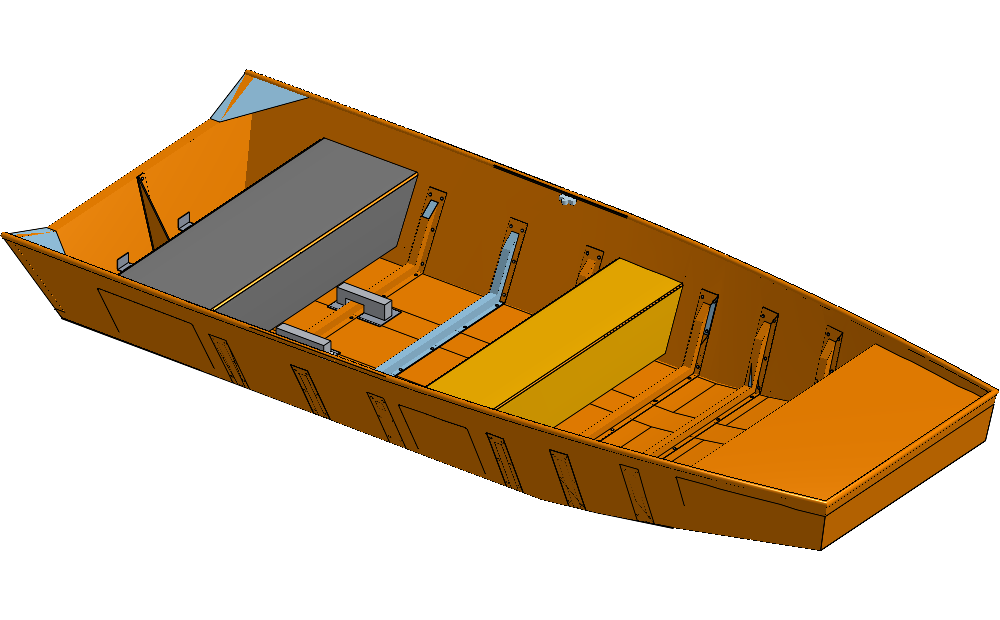
rev8_JonAirBoat/renderedImages/buildSteps/step2.6_shoes_installed.png
