acappon/DIY-MiniAirboat/rev8_JonAirBoat/renderedImages/buildSteps/step2.8_drivetrain_module.png

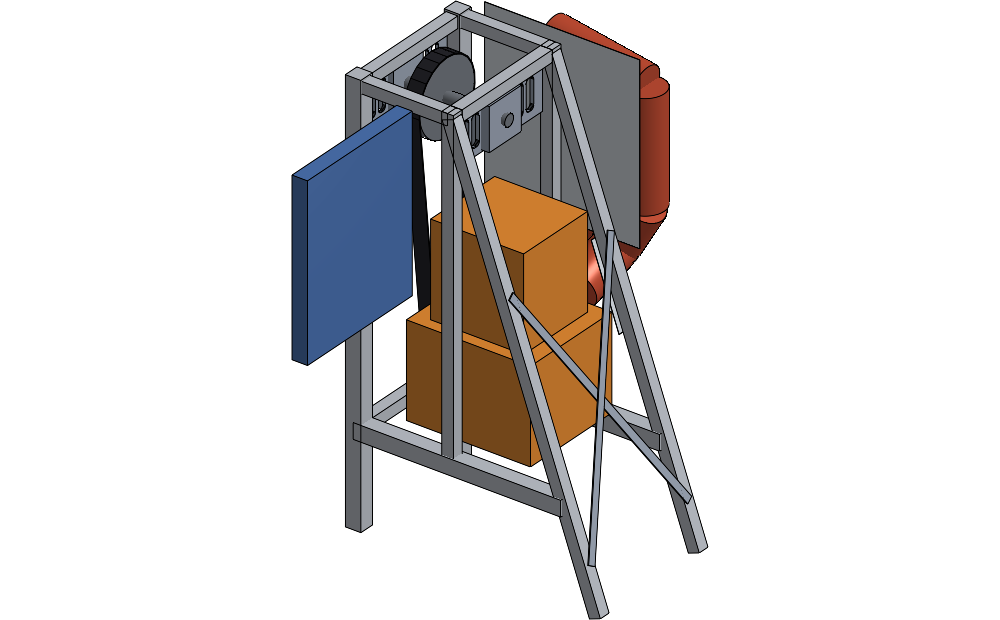
rev8_JonAirBoat/renderedImages/buildSteps/step2.8_drivetrain_module.png
