acappon/DIY-MiniAirboat/rev8_JonAirBoat/renderedImages/buildSteps/step2.11_systems_connected.png

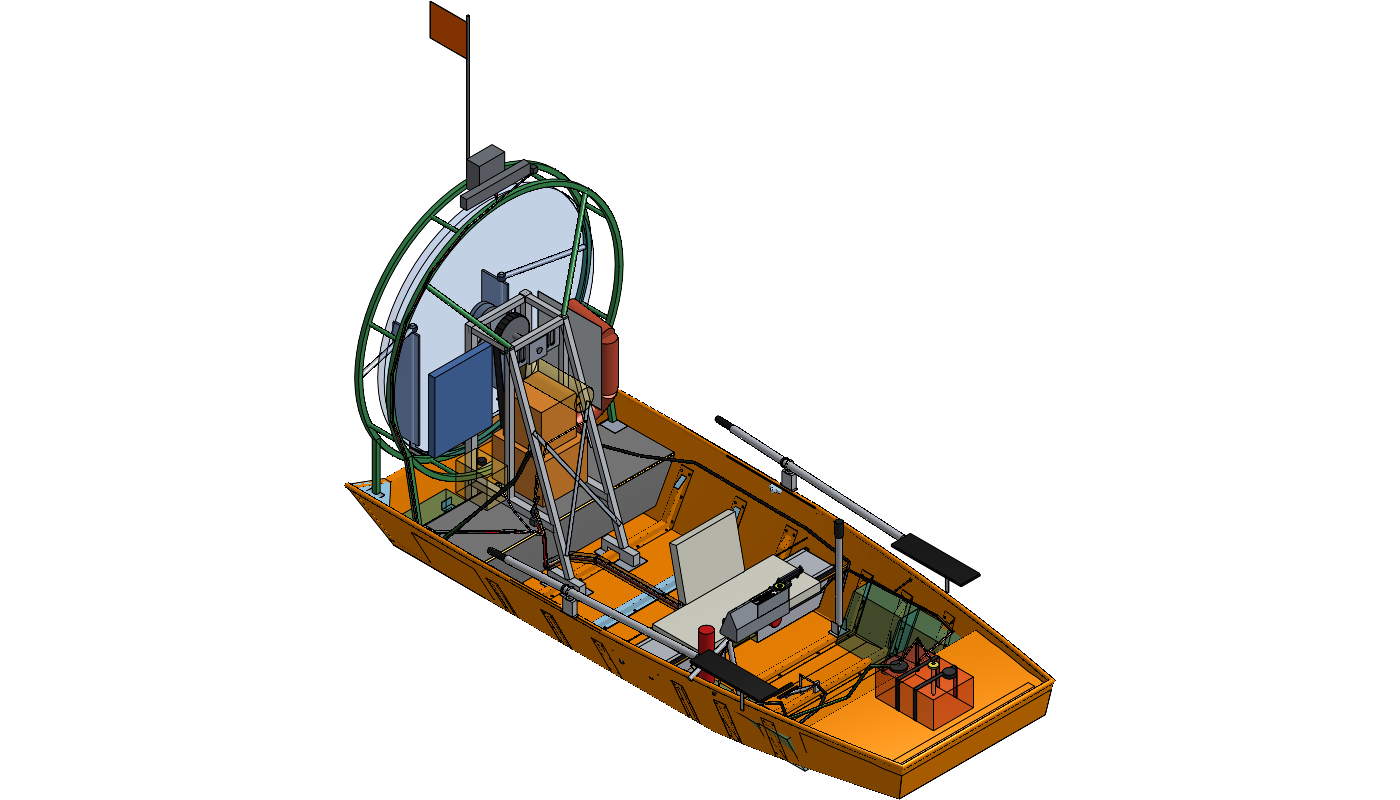
rev8_JonAirBoat/renderedImages/buildSteps/step2.11_systems_connected.png
