acappon/DIY-MiniAirboat/rev8_JonAirBoat/renderedImages/buildSteps/step2.12_prop_cage.png

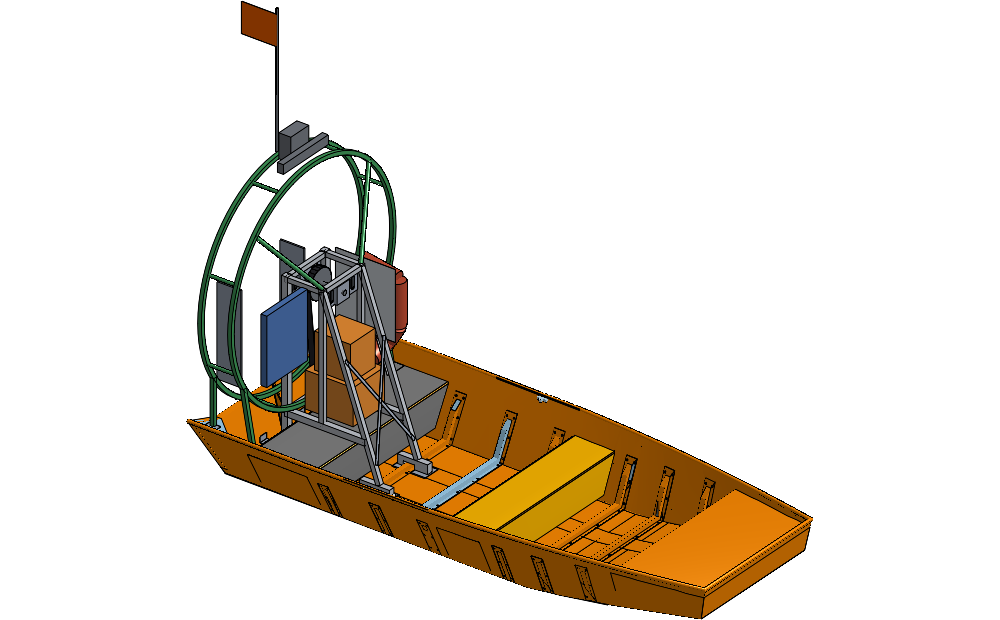
rev8_JonAirBoat/renderedImages/buildSteps/step2.12_prop_cage.png
