acappon/DIY-MiniAirboat/rev8_JonAirBoat/renderedImages/buildSteps/step2.13_rudders_steering.png

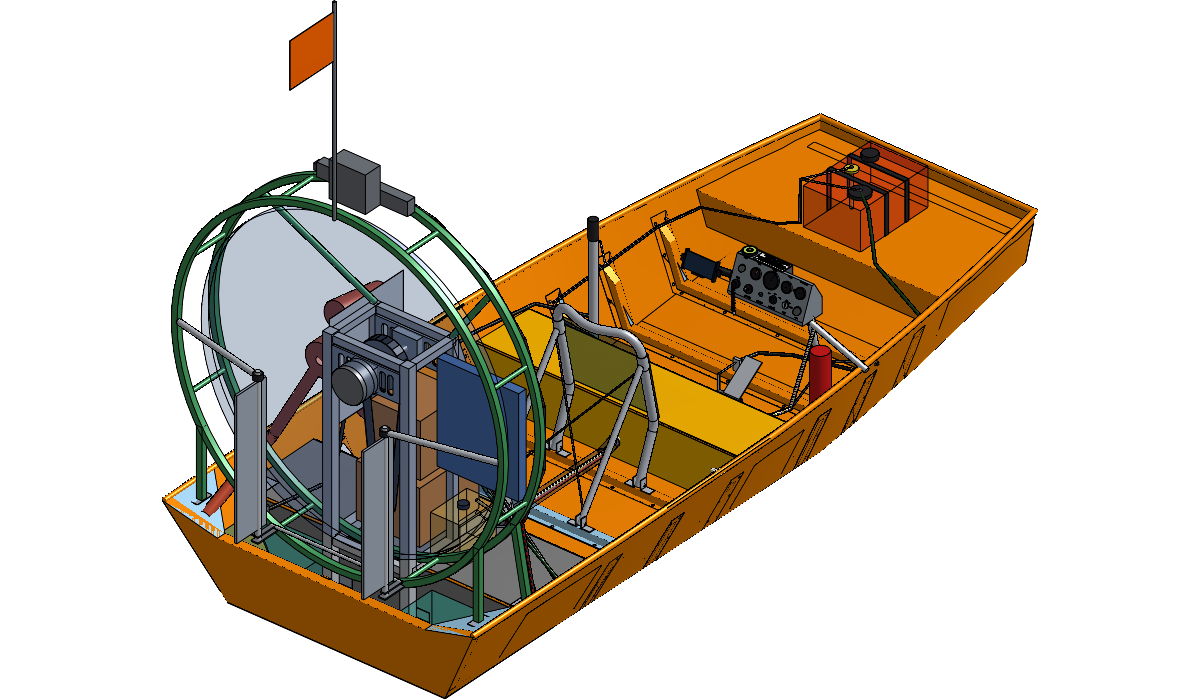
rev8_JonAirBoat/renderedImages/buildSteps/step2.13_rudders_steering.png
