acappon/DIY-MiniAirboat/rev8_JonAirBoat/reports/Static_Test_Performance_Report.md

# Static Test Performance Report: Installed Drivetrain

> **STATUS: TEMPLATE — THE STATIC TEST HAS NOT BEEN RUN YET.**
> Every result field below is blank on purpose. Fill it in from the completed protocol data sheets after the test. The "Planning estimate" column contains rules of thumb for comparison only; they are not measured results.

**Project:** DIY Jon-Air airboat **Design version tested:** ________ (e.g. v1.0.1.2 + changes)
**Test date:** ________ **Location:** ________________ **Weather / temp / wind:** ________________
**Test lead:** ________ **Operator:** ________ **Data recorder:** ________ **Safety officer:** ________
**Engine:** ________ **Belt ratio:** ________ **Prop (make / diameter / pitch / blades / max RPM):** ________________

---

## 1. Summary of what was learned

*(Write 3–6 plain-language bullets after the test. For example: did the mounts hold; how much thrust; did it run cool; what needs fixing before the water test.)*

- 
- 
- 

**Overall result:** ☐ PASS ☐ FAIL ☐ ABORTED (Part/step ____ , reason ____________)
**Cleared for first water test:** ☐ Yes ☐ No — conditions: ____________________

---

## 2. Results against pass/fail criteria

| # | Criterion (from the test plan) | Result | Pass / Fail | Evidence (photo, data sheet ref.) |
|---|---|---|---|---|
| 1 | No cracks, deformation or fastener movement at the stand, shoes, clips, gussets, bearing plates, cage pads or struts; no cracks at petal edges; torque stripes unbroken | | | |
| 2 | No fuel, injection oil or coolant leaks; no exhaust leaks near crew or fuel system | | | |
| 3 | Coolant stabilizes below 210 °F during 10 min at 75% | Max: ____ °F | | |
| 4 | Exhaust temperature under the service manual limit; low oil light works; oil tank level fell | Max: ____ °F | | |
| 5 | Prop tip clearance ≥ 2 in after the test; no witness marks | Min: ____ in | | |
| 6 | No contact between moving parts and wiring/hoses/structure | | | |
| 7 | Kill switch stops the engine within 2 s (idle and 50%) | ____ s / ____ s | | |
| 8 | Throttle returns to idle by itself | | | |
| 9 | Engine never above 7,900 RPM; prop never above 3,200 RPM | Max seen: ____ / ____ RPM | | |
| 10 | No belt flutter touching the guard; belt tracks centered | | | |

---

## 3. Performance data

### 3.1 Thrust and RPM (Part D)

| Throttle | Engine RPM | Prop RPM | Static thrust, steady (lbf) | Peak (lbf) | Planning estimate (lbf) |
|---|---|---|---|---|---|
| Idle | | | | | — |
| 25% | | | | | — |
| 50% | | | | | — |
| 75% | | | | | — |
| 100% | | | | | About 480, at about 7,450 engine RPM and 2,530 prop RPM (model estimate) |

**Final blade pitch:** ______ **Thrust per prop horsepower (if engine power is known):** ______ lbf/hp
**Prop tip speed at max RPM:** π × diameter (ft) × RPM ÷ 60 = ______ ft/s (Mach ______; tip speeds above about Mach 0.85 get much louder and less efficient).

### 3.2 Cooling and temperatures (Part F)

| Time (min) | Coolant °F | Radiator in / out °F | Exhaust °F | Notes |
|---|---|---|---|---|
| 0 | | | | |
| 2 | | | | |
| 4 | | | | |
| 6 | | | | |
| 8 | | | | |
| 10 | | | | |

Prop-shaft bearing housings after shutdown: aft ______ °F, forward ______ °F. Exhaust near fuel line (IR): ______ °F. Oil tank level drop: ______ .

**Cooling against the estimate:** heat shed at the dock was estimated at about 61 kW, and full throttle at about 1 minute. Measured rate of climb at full throttle: ______ °F per minute.

### 3.3 Vibration and structure

| Item | Observation | Action needed |
|---|---|---|
| Vibration at each throttle step (none / light / heavy, where) | | |
| Stand tap test (Part A1), and RPM band to pass through | ____ Hz, ____ RPM | |
| Belt flutter at any RPM (Part D video) | | |
| Mount reference marks (Part G3) | | |
| Torque check results (Part G2) | | |
| Gussets, shoes, clips, ribs, petal edges, hull bottom (Part G4) | | |
| Belt condition and tracking (Part G6) | | |
| Cage and mesh (Part G5) | | |

### 3.4 Rudder authority (Part E)

| Observation | Result |
|---|---|
| Yaw tendency / restraint-line angle with full left and full right rudder | |
| Rudder buzz or flutter | |
| Prop spin-down time after kill switch | ____ s |

### 3.5 Noise (Part D, 75% and 100%)

| Position | 75% dBA | 100% dBA | Notes |
|---|---|---|---|
| Operator seat | | | |
| 25 ft to the side | | | |
| 50 ft | | | Estimate 82–84 dBA |

**Second muffler needed?** ☐ No ☐ Yes (8–12 lb; check the margin first)

---

## 4. Issues found and actions

| # | Issue | Severity (safety / function / cosmetic) | Owner | Fix | Done (date) |
|---|---|---|---|---|---|
| 1 | | | | | |
| 2 | | | | | |
| 3 | | | | | |

---

## 5. Safety observations

*(Near misses, PPE problems, FOD found, restraint behavior, anything to change in the plan or protocol next time.)*

- 
- 

---

## 6. Recommendations before the water test

- 
- 

---

**Signatures:** Test lead ____________________ Safety officer ____________________ Date ________

**Attachments:** protocol data sheets (photos), setup and inspection photos, video files: ____________________
