acappon/DIY-MiniAirboat/rev8_JonAirBoat/reports/Release_Notes_v1.0.1.3.md

# DIY Jon-Air Airboat — Release Notes v1.0.1.3

> **Released 2026-11-10.** Branch `main` (Lowe 1448 hull).

**Release date:** 2026-11-10
**CAD source:** Onshape document "DIY Jon-Air boat", version **v1.0.1.3**

## What changed since v1.0.1.2

### Seating redesign (in progress)
The middle bench and the grab rail give way to a purpose-built seat over three boxes: a small sealed electrical dry box on the centerline, tied to the gunwales by two aluminum struts along its fore and aft edges, with a dry storage compartment on each side. A high-density foam pad runs across all three (room for a passenger beside the driver on short trips), and a seatback hinged just above the foam folds flat and is lightly padded on its back for sitting facing aft.

1. **Grab rail and sling backrest removed** (done). Gone from the CAD (`Minimal_cockpit.fs`), the weight model and the structural check; `CAD/analysis/grab_rail.js` and the step image are deleted. Tracker: BOM line 79 deleted (later lines renumbered: trim tab is now line 79, flotation foam line 80, bubble level line 81, UHMW backing bars line 82), Build Guide step 2.16 deleted (flotation foam is now step 2.16). Its four rib mounts at X 54.75 and X 70.65 go with it, so nothing is fastened to those ribs any more.
   - Equipment about **465.1 lb** (was 471.9), payload about **359.9 lb** against the 350 lb needed, **+9.9 lb of margin** (was +3.1).
   - BOM total about **$15,280** (was $15,755).
2. **Middle bench removed** (done in the tracker and in Onshape). Build Guide step 2.5 is now "Remove the middle bench": measure the bench fastenings and the beam first, keep a temporary spreader across the gunwales until the new struts are in (the bench is the boat's main thwart), drill out the rivets, lift the bench out whole with its foam, and seal every empty hole with closed-end rivets in sealant (the bench ends sit near or below the waterline). Step 2.1 no longer relies on the middle bench foam. New BOM line 83: closed-end rivets and the spreader, about $25. The dry box, battery switch and harness sleeve (BOM lines 57, 73, 76; step 2.11) are left as they are until step 3. BOM total about **$15,305**.
   - In Onshape the bench is the composite part "Bench - Middle" in the "Lowe 1448 Boat (reference mesh)" Part Studio; it will be removed with a Delete part feature. Two thin bench-top lip strips are part of the imported "Hull" composite and stay in the reference.
3. **Seat module** (done in CAD source, analysis, tracker and Onshape Main workspace). `CAD/FeatureScript/Minimal_cockpit.fs`, new Build Guide step **2.17** (done right after 2.5), BOM lines 84–87.
   - **Struts:** two 1 x 2 x 1/8 in 6061 tubes hull side to hull side at the old bench-top level (Z 9–11, X 76.5 and 85.5), bolted to the hull sides with angle clips: the new thwart and the seat support.
   - **Electrical dry box:** 0.063 in 5052, 8 x 10 x 7-1/4 in, hung between the struts, gasketed 0.080 in lid bolted into rivnuts. Battery at the forward end, fuse block on a bracket over it with the fuses facing the lid, relays K1–K5 at the aft end. Harness leaves through a gland in the aft wall (the bench sleeve is gone).
   - **Battery switch:** on a plate on the forward strut, port of the box, knob forward: usable without unbolting the seat.
   - **Dry storage each side:** 0.032 in walls under the struts, stopped 1-1/2 in above the floor for bilge drainage; closed-cell foam floor (flotation); 0.063 in lid outboard of the seat, hinged on the aft edge.
4. **Seat and seatback** (as 3).
   - **Seat:** 15 x 38 in across all three boxes (room for a passenger beside the driver), 3/8 in marine plywood base bolted to the struts over the dry box lid, 2-1/2 in closed-cell polyethylene pad (also flotation), marine vinyl. Seat top at about Z 14.1 (the bench was Z 12.5); the driver mannequin's hip point is now X 83.5, Z 14 (was X 82, Z 12.5), so the back meets the seatback, and the stick and pedal are 1-1/2 in closer. 6 mm plywood was too weak for someone standing on the front edge.
   - **Seatback:** 18 x 15 in, padded front and back, hinged just above the foam on two brackets bolted to the aft strut, 12° recline against a stop, folds flat forward. Facing aft on it is for engine-off use.
5. **Flotation restored.** The middle bench foam (about 4.8 ft³) was most of the capsized boat's forward flotation; without it the boat sank stern first. Now: seat pad, compartment floors and **two 6 in footwell side blocks** (X 98–128, Z 1.5–13; the starboard one has a gap for the console foot). Capsized: level (list −0.3°, pitch −0.4°), hull bottom about **3.0 in** clear (was 4.0), **169 lb** reserve (was 258). The fire extinguisher moves to the top of the starboard block (about X 99.5), and the throttle cable climbs over it.
6. **Totals.** Equipment **496.0 lb** (v1.0.1.2: 471.9), payload **329 lb**, **21 lb short** of the 350 lb for a 200 lb driver and 150 lb of gear: the driver can carry about 129 lb of gear. The dash load label now reads **MAXIMUM LOAD 370 LB** ... **LEAVES 325 LB** (was 395 and 350). Upright stability barely changes (GM 43.3 in, prop-torque heel 3.9°, dock trim 0.63°); top speed about 34.75 mph. New structural checks: struts factor 1.5 at 4 g with two people, end clips 3.5–4.8, seat base 2.5, seatback brackets 1.5. BOM total about **$15,745**.

7. **Oars and oarlocks** (new Build Guide step **2.18**, BOM lines 88–89, `CAD/analysis/oars.js`). For rowing facing aft on the folded seatback with the engine off, and carrying the oars in their locks.
   - **Oarlocks:** closed-ring oarlocks in top-mount sockets on **4 in 6061 risers** bolted through each rail at **X 66**, 10-1/2 in aft of the seat's aft edge. The pins sit about 9 in above the folded seatback. 7 ft oars with 24 in inboard leave the handle ends 30 in apart at the finish, and the hands pass about 3-1/2 in beside the knees. The shaft dips about 24° to the water, and the blades stay far outboard of the cage.
   - **Rowing clearances:** at the finish, the rower's port elbow clears the stick grip by about 5 in with the stick at neutral (tie it there while rowing), and the starboard elbow clears the dash by about 9-1/2 in.
   - **Shipping: yes, it works.** Each oar swings blade forward in its ring and lies just inside the rail on a padded rest with a rubber strap at X 118, from the handle at X 42 to the blade tip at X 126. Without the risers, the starboard oar would lie on the console arm where it meets the gunwale; with them it passes **about 4 in above** it. Clearances to the other parts:
     - extinguisher: 5 in
     - dash: 10 in
     - the stick: 10 in
     - the driver's elbow on the stick: about 8 in
     - opened storage lids: 4 in
     - sidelights: 7 in
     - fuel line: 8 in
     - stand: 6 in
   - **Structural:** a 100 lbf pull on the handle puts about 150 lbf on the pin, giving these factors:
     - riser: 31
     - bolts: 5.0
     - rail bearing with the doubler: 4.3
   - **Weight:** the oarlock hardware (rings, sockets, risers, doublers, rests) is boat equipment, **4.0 lb**. The oars (about 7.2 lb the pair) are **operator gear**: bring them or leave them ashore, and when aboard they come out of the people-and-gear load like any other gear. (First booked as equipment; corrected.)
   - **Cost and hours:** BOM total about **$15,950**. Build Guide about 212 DIY h and 101 pro h.

8. **Weight pass: carbon seat struts and a fiberglass/foam seat base** (BOM lines 84 and 86, step 2.17).
   - **Struts:** now 1 x 2 x 1/8 in roll-wrapped carbon tube, the same section, so about the same stiffness (sag 0.27 in with two people, was about 0.2). They go from 8.7 lb to **5.6 lb**. Factor at 4 g is **2.1**, up from 1.5.
   - **Galvanic isolation:** carbon touching aluminum corrodes the aluminum. Each strut gets one ply of glass. Every fastener through the carbon gets a 6061 crush sleeve, a G10 shim at the aluminum, and stainless bolts in Tef-Gel. That covers the end clips, dry box, compartment walls, switch plate, seatback brackets and seat base. The dry box and compartment walls are now bolted to the struts, not riveted.
   - **Seat base:** now a 3/8 in sandwich (5/16 in PVC foam core, 0.020 in E-glass skins, potted bolt inserts), down from 4.3 lb of plywood to **2.3 lb**. With 200 lb on the front edge: skins factor 3.0, core shear 3.5 (the plywood was 2.5).
   - **Weight:** **5.1 lb saved.**
   - **Cost and hours:** about **+$240** (BOM total about **$16,190**) and +3 DIY h (step 2.17 now 19 h).
9. **Honeycomb rudder blades; rudder and controls allowances cut** (BOM line 44, step 2.13, `CAD/analysis/controls_800r.js`).
   - **Rudder blades:** aluminum honeycomb, 0.020 in 5052 skins over 1/2 in hex core, with closed edges and potted hard points at the shaft and horn bolts. About 2.8 lb the pair, down from 4.4 lb for 0.040 skins over ribs. About +$80 (BOM total about **$16,270**).
   - **Allowances:** both cut to **8.5 lb** (5 lb off in all), keeping a margin over the itemized parts.
     - Rudders and linkage: 12 → 8.5 lb, against about 7.8 lb itemized.
     - Stick, pedal and cables: 10 → 8.5 lb, against 6.1 lb itemized.
   - **Weighing:** step 2.13 now weighs both sets before fitting. If either set comes in over its allowance, the load label comes down.
10. **Totals now** (oars as gear, carbon struts, sandwich seat base, honeycomb rudders, allowances cut): equipment **489.9 lb**, payload **335 lb**, which **meets the new design load** (below) with 0.1 lb to spare: a 200 lb driver and **135 lb of gear**, oars included if they come along.
    - Dash load label now **MAXIMUM LOAD 380 LB** ... **LEAVES 335 LB**.
    - Capsized flotation **3.9 in** clear, **190 lb** reserve, now counting the folding seatback's closed-cell foam as the float it is (0.35 ft³; it had been booked as nearly neutral). GM 43.6 in, dock trim 0.6°.
11. **Design load changed** (user, 2026-11-10): **200 lb operator + 135 lb of gear = 335 lb** (was 200 + 150 = 350). Payload is **335.1 lb**, so the requirement is met with only **0.1 lb of margin**: any part that weighs in heavy at build takes the label down. `minimal_1448.js` and `stability_upright.js` now use 135 lb of gear (top speed 34.25 mph and hump margin 259 lbf with the design load; GM 39.8 in tied down, 3.9° list with the loose gear slid to one side). The capsize check keeps its heavier 200 lb of strapped gear as a conservative case.
12. **Wiring pass for the seat-module dry box** (`electrical/wire_list.py`, `CAD/FeatureScript/Minimal_wiring.fs`, `reports/Electrical_Compliance_v1.0.1.3.md`, Build Guide step 2.11).
    - **Terminals:** the battery, fuse block, relays and switch now sit where the seat module puts them. The battery switch is on its plate on the forward strut.
    - **Forward runs:** they leave through a new gland in the box forward wall (Y 3.8, Z 8), pass under the forward strut, stay at Z 10 or lower under the seat base, and climb to the hull side only outboard of the seat edge. The old routes passed through the seat base.
    - **Aft runs:** they leave through the aft gland into the floor conduit. The bench sleeve is gone.
    - **Checks:** a script finds no wire crossing the seat base, struts, battery, fuse block, relays or switch body. Voltage drops all pass (largest 3.7%, searchlight, limit 10%).
    - **Weight:** wire 8.7 lb (was 8.3); harness 12.4 lb (was 12.2), net of the bench sleeve.
    - **Totals:** equipment **490.1 lb**, payload **334.9 lb**, **0.1 lb under** the 335 lb design load. By the rounding rule the dash label drops to **MAXIMUM LOAD 375 LB** ... **LEAVES 330 LB**.
    - **CAD:** in Onshape, W57 (battery to switch, 2 AWG) shows as 10 separate segments, because its short bends in the box fail the CAD union. Wiring feature unions are now tolerant of that, instead of failing the whole feature.
14. **Dock lines are operator gear** (user, 2026-11-10), like the oars: the PFD line in the weight model drops from 6 to 4 lb. Equipment **488.1 lb**, payload **336.9 lb**, **1.9 lb over** the 335 lb design load. Dash label back to **MAXIMUM LOAD 380 LB** ... **LEAVES 335 LB**. Flotation and stability unchanged (3.9 in clear, 190 lb reserve; GM 39.7 in tied down).
13. **Reports for v1.0.1.3:** `Stability_Analysis_v1.0.1.3.md`, `Flotation_Inverted_v1.0.1.3.md`, `Structural_Analysis_v1.0.1.3.md` and `Electrical_Compliance_v1.0.1.3.md` supersede the v1.0.1.2 reports (kept as the record).

## Known issues and open items
- **No passenger handhold:** it went with the grab rail and is no longer a requirement (user, 2026-11-10). A passenger holds the seat edge or the console arm.
- **Payload is 1.9 lb over** the 335 lb design load (200 lb operator + 135 lb gear, oars and dock lines included when aboard). The label reads 380 / 335. The rudder and controls allowances (8.5 lb each) and the brackets allowance (5 lb) are the only cushion: weigh in step 2.13 and at the end of the build.
- Never row, or unstrap the oars, with the engine running; the rower faces the prop cage.
- Capsized float height is about 3.9 in (v1.0.1.2: 4.0 in), with the seatback foam counted. It depends on the seatback being closed-cell foam and staying attached.
- `reports/Drivetrain_800R_ETEC.md` still describes the grab rail and the middle bench in places; the v1.0.1.3 reports supersede it on those points.

## Onshape (Main workspace)
- "Minimal cockpit (FeatureScript)" uploaded; the "Minimal cockpit" Part Studio regenerates with 87 parts.
- "Lowe 1448 Boat (reference mesh)": new feature "Remove middle bench (v1.0.1.3 seat module)" deletes the "Bench - Middle" composite. (The Main assembly uses only the gunwale rail and handles from this studio.)
- "Crew mannequins": hip point X 83.5, Z 14.
- "Main assembly": the whole cockpit Part Studio re-inserted and the 71 old cockpit instances deleted (18 of them were left dangling by the removed grab rail, bench sleeve and dry box case). No mates were affected.
- "Minimal cockpit (FeatureScript)" uploaded again with the oarlocks, rests and shipped oars; the Part Studio regenerates with 123 parts. Preview: `renderedImages/wip_oars_shipped.png`.
- **Group-1 close-out (2026-11-10):**
  - **Uploads:** cockpit (123 parts: carbon strut and sandwich seat base names), dash (load label 380 / 335 after the dock-lines change, 179 parts) and wiring (the v1.0.1.3 routes, 113 bodies).
  - **Main assembly:** the cockpit, wiring and dash studios re-inserted whole, and the 370 old instances deleted. 2 of them were dangling load-label text, and the oars, oarlocks and extra W57 segments had never been added. 543 instances, none dangling, no mates affected.
  - **Build steps assembly:** 20 dangling instances deleted (grab rail, old dry box case, bench sleeve, 2 label text bodies). It does not yet show the seat module, oars or oarlocks; that comes with the build-step re-render.
  - **Render stages assembly:** no dangling instances. It holds only the reference mesh and the 800R layout, so the cockpit has to be added for the new scenes.
  - **Label text and assemblies:** every load-label text change regenerates the label glyph parts, which leaves a few dangling instances in assemblies that insert the dash part by part. After the 380 / 335 upload the dash was re-inserted whole in the Main assembly. The Build steps assembly will have 4 dangling label-glyph instances until the build-step re-render.
  - **Not uploaded:** "Minimal 800R layout" (only the rudder envelope name changed, to honeycomb). Upload it with the release.

## Release outputs

**Onshape version v1.0.1.3:** created 2026-11-10.

**STEP files:** in `CAD/`:
- `Airboat_v1.0.1.3_Assembly.step`
- `Airboat_v1.0.1.3_Cockpit.step`
- `Airboat_v1.0.1.3_Controls.step`
- `Airboat_v1.0.1.3_Dash.step`
- `Airboat_v1.0.1.3_Stand_engine_cage.step`
- `Airboat_v1.0.1.3_Wiring.step`

**Concept scenes:** in `renderedImages/scenes/`. They replace the six v1.0.1.2 scenes.
- `underway-25mph_gear.png`: oars shipped, with cooler, duffel, life jackets and snake tong aboard.
- `underway-25mph_solo.png`: no oars or gear.
- `top-speed_solo.png`: solo rider at about 34 mph.
- `snake-hunt_rowing.png`: at night, rowing facing aft along the bank with the searchlight on the bank.
- `dock_rowing.png`: the oars as reverse gear and for turning at the dock.

How the scenes were made:
- **Composited** by `renderedImages/make_scenes.py` from three Main-assembly renders.
- **Props:** a new Onshape tab "Scene props" (master `CAD/FeatureScript/Scene_props.fs`) holds the rower facing aft, the folded seatback, the oars out and the gear. It was inserted into the Main assembly for the renders, with sets switched off per scene, and removed again afterwards.

**Images:**
- `renderedImages/Minimal_cockpit_v1.0.1.3.png`, `Minimal_dash_v1.0.1.3.png` and `Minimal_wiring_v1.0.1.3.png` re-rendered; the other studio images renamed.
- Build Guide step images: new for 2.17 (seat module) and 2.18 (oarlocks, rowing); 2.11 (systems connected) re-rendered.
- `step2.5_bench_openings.png` retired.

**PDFs and files:**
- `Airboat Build Guide v1.0.1.3.pdf` and `electrical/Minimal_1448_Electrical_Schematic.pdf` regenerated.
- v1.0.1.2 tracker, guide, STEP files and reports retired: the reports moved to `reports/archive/`.
- `ABYC_E11_Review` and `Supplier_Questions` renamed to v1.0.1.3.

## Known limits of this release

- **Build Guide step images 2.10, 2.12, 2.13 and 2.15** still come from the v1.0.1.2 build-stage renders, so they show the old middle bench and grab rail. The Build steps assembly has no staging to re-render them from: it holds the finished boat, and 4 load-label glyph instances in it are dangling.
- **Rudder envelope name:** in Onshape, "Minimal 800R layout" still calls the rudder envelope by its old name. The repo master has the honeycomb name; only the name differs.
- **`reports/make_build_guide.py`:**
  - It now reads shared strings (the tracker as saved by exceljs) and embeds its images, because Edge can't read the mapped Z: drive.
  - On this machine its own Edge call still printed nothing, so the v1.0.1.3 PDF was printed with Edge run directly on the same page.
  - Edge has to run outside the Claude Code sandbox.
