acappon/DIY-MiniAirboat/rev8_JonAirBoat/reports/Release_Notes_v1.0.0.4.md

# DIY Jon-Air Airboat — Release Notes v1.0.0.4

Released from branch `main` (Lowe 1448 hull). The minimal 1448 work was started on `study/minimal-1448` and merged into `main` on 2026-11-03.

**Release date:** 2026-11-03
**CAD source:** Onshape document "DIY Jon-Air boat", version **v1.0.0.4**

## Package contents
- **Tracker:** `Airboat Build Tracker v1.0.0.4.xlsx` (BOM total about **$14,460**).
- **CAD:** `CAD/Airboat_v1.0.0.4_*.step` (Assembly, Stand_engine_cage, Cockpit, Controls, Dash, Wiring), FeatureScript masters in `CAD/FeatureScript/`, and the weight, trim and load calcs in `CAD/analysis/`.
- **Electrical:** `electrical/Minimal_1448_Electrical_Schematic.pdf`, `electrical/Wire_List.csv` and the generator `electrical/wire_list.py`.
- **Renders:** `renderedImages/buildSteps/` (build steps), `renderedImages/scenes/` (dock, underway and snake hunt, with and without crew, and two with a passenger; stylized backgrounds), `renderedImages/studio/` (including the driver's-eye dash) and `renderedImages/transparent/`.
- **Status at release:** equipment about **469.5 lb**, payload about **355.5 lb**, about **+5.5 lb of margin** with driver + 150 lb of gear; solo dock trim about 0.93°; about 34.5 mph (estimates).

## What changed since v1.0.0.2
- `VERSION` file added (1.0.0.4): the next release from `main` carries that number. (Versions 1.0.0.3 and the 1652/1860 work live on the `rev8/1652-hull` and `rev8/1860-hull` branches.)
- **Repo tidy (2026-11-03):** the earlier designs (`rev0_StitchAndGlue`, `StraddleDart_rev7`) and the superseded v1.0.0.2 build tracker moved to `archive/` (see `archive/README.md`). The v1.0.0.2 CAD, renders and release notes stay in `rev8_JonAirBoat/` as the baseline this release builds on.
- **Engine (decided 2026-11-03): Rotax 800R E-TEC snowmobile two-stroke** on a one-stage 8MGT belt off the crank PTO (32T/94T, 2.94:1), about 120 hp at the prop, about 168 lb installed (`reports/Engine_Selection_1448.md`, `reports/Drivetrain_800R_ETEC.md`, calc `CAD/analysis/etec_reduction.js`). It replaces the GSX-R1000, which left driver + passenger 62 lb over the 825 lb plate. No gearbox or clutch: BOM line 47 (clutch lever) set to qty 0. The prop shaft, thrust bearing, bearing plates and Warp Drive 66 in prop carry over; all their loads are lower. Model: about **35 mph** with driver + 150 lb of gear and **34.75 mph** with driver + passenger, more than 250 lbf of thrust to spare at the hump, dock trim 0.5–2°.
- **Outfit trim:** UHMW is now 3/16 in over the wear zones only (three 12 in strips: centerline and both chines; 45 → 35 lb; BOM line 2, Build Guide 1.2), so payload is **402 lb** and both load cases fit under the plate.
- **Tracker:** BOM lines 30 (engine), 31 (reduction, about $1,000), 32 (prop notes), 33 (radiator), 34 (exhaust mounts, about $60), 35 (fuel: the sled pump module), 38 (throttle) and 47 rewritten for the 800R; BOM total about **$12,170**. Build Guide 2.0 (Choose your prop) updated for the new belt: the 4-blade option now uses a 104T pulley.
- **Exhaust layout (`reports/Drivetrain_800R_ETEC.md`, Section 6a):** stock tuned pipe and silencer, kept unmodified, above and beside the engine near the prop hub; space reserved for a second, low-restriction muffler, fitted only if static-test sound readings call for it; heat shields between the pipe and the belt and bearings; tailpipe over an aft transom corner (the center has only about 4 in under the prop tips), pointing aft, never into the prop. The sled airbox stays. BOM line 34 now about $150 (tailpipe, flex joint, shields, guard); a sound level meter joins the static test instruments (line 40). BOM total about **$12,290**.
- **Weight allowances and cage-top lights (2026-11-03):** the model now carries about 23 lb for items the concept study left out (minimal dash and gauges, wiring, belt guard, radiator brackets, loose brackets and fasteners, bilge pump, passenger cushion and grab handle) and about 20 lb for an LED light bar and a motorized remote searchlight on top of the prop cage, with their wiring. New BOM lines 48 (light bar, about $250) and 49 (searchlight, about $450); BOM total about **$12,990**. Equipment is now about 471 lb and payload about **354 lb**.
- **Safety and regulatory gear itemized (2026-11-03):** PFDs and lines 8 lb, a USCG B-I / UL 5-B extinguisher near the fuel tank but within the driver's reach 4 lb, an air horn at the driver 2 lb, and the Florida airboat flag (10 x 12 in orange, at least 10 ft above the bottom; Fla. Stat. 327.391, check the current FWC rule) on the aft side of the cage 3 lb: +2 lb net. BOM line 39 (extinguisher) updated; new lines 50 (flag, about $75), 51 (air horn, about $40), 52 (two PFDs, about $80); BOM total about **$13,185**. Payload is now about **352 lb**.
- **First 800R layout in CAD (2026-11-03):** Onshape workspace `Minimal 1448`, branched from v1.0.0.2, part studio "Minimal 800R layout" (master `CAD/FeatureScript/Minimal_layout.fs`, render `renderedImages/Minimal_800R_layout_v1.0.0.4.png`). It places the engine, belt, shaft, bearings, prop, stand, exhaust, second-muffler space, radiator, three 3/16 in UHMW strips, and a proposed cage, rudders, lights and flag. The old Hull armor feature is suppressed there. `Minimal 1448` was merged into the Onshape Main workspace on 2026-11-03, so Main now carries this layout and later CAD work happens there; to see the old layout, open version v1.0.0.2. See `reports/Drivetrain_800R_ETEC.md` Section 9a.
- **Archived:** the GSX-R1000 stand and reduction note and its calc moved to `archive/rev8_JonAirBoat/`.
- *History:* the minimal build first used a 1000 cc sport-bike engine (GSX-R1000 K5–K8) with its gearbox and a belt reduction.
- **Build tracker v1.0.0.4** (from v1.0.0.2): BOM line 30 bike engine ($2,000), 31 belt reduction ($600), 32 3-blade prop, 33 radiator, 34 exhaust, 35 fuel system with an inline EFI pump, 36 small lithium battery; lines 9–16 (chine angles, bow skin, their hardware, deck ports) set to qty 0; new lines 43–46 (cage, rudders and linkage, raised seat, navigation lights). BOM total about $11,100. Build Guide 1.3 and 1.4 marked not in the minimal build; the Section 2 header explains that steps 2.1–2.15 still describe the G13 module.
- *History:* **engine stand and belt reduction for the bike engine** (archived: `archive/rev8_JonAirBoat/Bike_Engine_Stand_and_Reduction.md` and `bike_reduction.js`): gearbox locked in 4th, 14MGT belt 30T/47T, 1-1/2 in 4140 prop shaft, 66 in 3-blade prop at about 2,600 rpm (tip Mach 0.67), prop axis Z 52, bolted 6061 stand. Engine system and stand about 262 lb, so the minimal build now has about **338 lb** of payload (was 375 lb). **Thrust bearing:** a tapered-roller 4-bolt flange unit forward (thrust held by clamp collars) and a UCF208-24 ball unit aft, straddling the belt pulley, on 1/2 in 6061 bearing plates (BOM line 31 now about $850). **Prop:** Warp Drive 3-blade airboat prop with HP blades, cut to 66 in, on an SAE #2 face plate and a keyed steel flange (BOM line 32 about $1,625: $1,275 prop plus face plate and flange). Its maximum rpm is not published and must be confirmed with Warp Drive before ordering; the Whirlwind CarbonMax 68 (3,150 rpm maximum) is the fallback. **New Build Guide step 2.0, Choose your prop:** the standard 3-blade, or a quieter 4-blade (about $435 more with a 52T pulley; about 3–4 dBA less prop noise at 50 ft, estimate), with the changes to make for the 4-blade. Neither is expected to meet the California 75 dB(A) shoreline limit. **Clutch:** the bike clutch stays, worked by a lever on the steering stick with a parking lock and the clutch start switch (new BOM line 47, about $90; BOM total about $12,150 with the thrust bearing and the Warp Drive prop).
- **Minimal 1448 concept study** (`reports/Minimal_1448_Study.md`, model `CAD/analysis/minimal_1448.js`). Keep the 1448's factory benches and replace the car-engine outfit with a light engine on a stand, a smaller cage, a simple cockpit and thin armor. Estimates: 365–450 lb of equipment and **375–460 lb of payload** under the 825 lb plate, against about 80 lb of driver gear on the rev8 1652 design.
  - **Rotax 582 with gearbox:** about 30 mph solo, 28 mph with a passenger, about $12,000 total at US used-engine prices (about $10,000–11,000 with a cheaper hull).
  - **1000 cc sport-bike engine with a belt reduction:** about 38 mph with any load, about $10,750 (about $9,000–10,000 with a cheaper hull).

## Known issues and open items
- **Requirements (2026-11-03, `reports/Engine_Selection_1448.md`):** driver + 150 lb gear or driver + passenger within the plate, planes easily, at least 33 mph. `CAD/analysis/minimal_1448.js` reports pounds over the plate for each load case and sweeps engine weight against power.
- **800R E-TEC figures are unverified:** the 79 lb bare weight has no cited source, and BRP does not publish its power. Weigh the engine with its pipe, and confirm the thrust on the static test. The payload margin is only 2 lb: if the engine or the stand (target 45 lb) comes out heavier, take the difference out of the outfit.
- **Requirement change (2026-11-03): the design case is the driver + 150 lb of gear; the passenger requirement is dropped.** With the full outfit the 1448 can't carry two 200 lb people under the 825 lb plate (48 lb over). Payload is about 352 lb against 350 lb needed: **only about 2 lb of margin**, so weight added as the details are designed needs an offsetting cut.
- **Electrical:** the light bar, searchlight and navigation lights draw about 15 A (about 200 W). Check the 800R's spare charging output and the battery size.
- **Cage-top lights are high** (Z about 90 in): they add a little to the roll and weathervane moments; check when the stability model is updated.
- **Crank PTO side load:** the belt puts about 1,000 lbf on the PTO end. Confirm the PTO taper and the bearing's capacity from the service manual, or add an outboard support bearing (about 5 lb).
- **Fuel:** about 10.8 gal/h at full power (estimate): a 6 gal tank is about 33 minutes flat out, or about 1.1 hours cruising.
- **Stand and shields (2026-11-03):** the stand is trimmed to 45 lb (first load check in `CAD/analysis/stand_800r.js`; joints and tested vibration still open), heat shields are added, and the stand gets cross-straps and two struts to the cage (about 2.5 lb). Itemized exhaust parts come to about 7 lb, up from 5 lb, the UHMW allowance drops from 35 to 32 lb using the modeled strips, and the passenger cushion and grab handle are removed (−4 lb): equipment about **470.5 lb**, payload about **354.5 lb**, about **+4.5 lb of margin** with driver + 150 lb of gear (`reports/Drivetrain_800R_ETEC.md` Section 9a). BOM line 17 is now the 2 x 3 bed tube, line 43 has the cage bolted to the hull and the stand, and new lines 53–56 list the stand tube, cross-straps and cage struts; BOM total about **$13,370**.
- **Hull mounts (2026-11-03, `reports/Drivetrain_800R_ETEC.md` Section 9b):** the first layout clashed with the rear bench and the rib at X 37.75. The stand now stands on four separate shoes instead of two beds, the rail is at Z 14.9, the aft shoes hang between the transom and the bench's aft panel, and the cage legs stand on the corner caps and the bench top. The bench is not cut. Stand 41.5 lb, hull fastening 7.6 lb: equipment about **474.6 lb**, payload about **350.4 lb**, only about **+0.4 lb of margin** with driver + 150 lb of gear. BOM lines 17–23 updated; BOM total about **$13,172**. Rail-to-bench and rail-to-hoop gaps are tight (0.2 and 0.25 in), the rail's load factor is 1.4, and the bench panels and corner caps must be checked on the real hull. Build Guide steps 2.2–2.7 still describe the old parts.
- **Cockpit (2026-11-03, `reports/Drivetrain_800R_ETEC.md` Section 9c):** the driver sits centered on the factory middle bench and the raised seat is removed. Added: a dry box in the bench with the lithium battery and fuse block, a steering stick to port, a throttle pedal with heel rests, a console to starboard clear above two sets of knees, and the fuel tank with a gauge sender on the front deck step. Equipment about **467.6 lb**, payload about **357.4 lb**, about **+7.4 lb of margin**; solo dock trim about 0.94°. Gear must stow between the benches: in the bow it gives −0.3° of trim and 33.25 mph. BOM lines 35, 36, 38, 44 and 45 updated, new lines 57–61; BOM total about **$13,402**.
- **Steering and throttle controls (2026-11-03, `reports/Drivetrain_800R_ETEC.md` Section 9d):** rudder shafts, supports, horns, tie bar and cable arm, plus the pedal crank and cable stops, are modeled in "Minimal controls". Stick forward turns left; about 12 lbf at the grip at full power, an estimate. No weight change: they fit inside the existing allowances, so margin stays about +7.4 lb. BOM lines 38 and 44 updated. The electrical plan waits until all features are added.
- **Dash panel (2026-11-03, `reports/Drivetrain_800R_ETEC.md` Section 9e):** USB port and gas, tach, temperature and exhaust gauges on top; lanyard kill switch, searchlight joystick and switch, rotary lights switch, key switch and 12 V / 20 A outlet below; an adjustable marine phone or tablet holder on the left side. Equipment about **470.2 lb**, payload about **354.8 lb**, about **+4.8 lb of margin**. BOM line 37 updated, new lines 62–64; BOM total about **$13,762**.
- **Electrical plan (2026-11-03, `reports/Drivetrain_800R_ETEC.md` Section 9f):** 56 wires, modeled in CAD with connector markers, and a four-sheet schematic in `electrical/Minimal_1448_Electrical_Schematic.pdf`, all generated from `electrical/wire_list.py`. The LED bar and fuel pump join the 12 V outlet on 12 AWG. Equipment about **469.5 lb**, payload about **355.5 lb**, about **+5.5 lb of margin**. BOM lines 36 and 58 updated, new lines 65–75; BOM total about **$14,460**. Engine-side wiring must be confirmed from the 800R service manual.
- Outfit weights, thrust and prices are estimates. The CAD is a provisional layout: engine, pipe and radiator are placeholder envelopes. The tab **Main assembly** in the Main workspace is the place to start; the old rev7 Assembly 1 tab was removed, and versions v1.0.0.2 and v1.0.0.3 keep their copies.
- The engine is far above the 1448 plate's 25 hp outboard rating (registration and insurance).
- Running trim is flat (1.1–1.4°) with the prop axis where the model puts it; check a lower or tilted axis.
- Two-stroke engine life: budget a top-end rebuild at the service manual's interval (top-end kit about $1,300).

## Carried forward to the next version
- **Build Guide text is out of date:** steps 2.1–2.15 still describe earlier parts. Use the v1.0.0.4 renders, CAD and BOM, not that text, until it is rewritten. Steps 1.3 and 1.4 are not in the minimal build, and their images are older. The new image `step2.11_systems_connected.png` is not yet linked from the Build Guide.
- **Wire clips the hull:** a short wire run pokes through the starboard hull side near midship in the CAD, and shows as a small dark streak in the starboard renders. Reroute it in `electrical/wire_list.py`.
- **Open engineering items** in `reports/Drivetrain_800R_ETEC.md` Section 9: PTO taper and side load, belt width, prop maximum rpm, radiator, tuned pipe routing, and the engine-side wiring from the 800R service manual.
- Decide which rev8 features, if any, come back.
