acappon/DIY-MiniAirboat/StraddleDart_rev7/Electrical/Wiring_One_Line_Diagram.pdf

# Straddle Dart rev 7 — 12 V one-line wiring diagram (power)

## Group 31 AGM

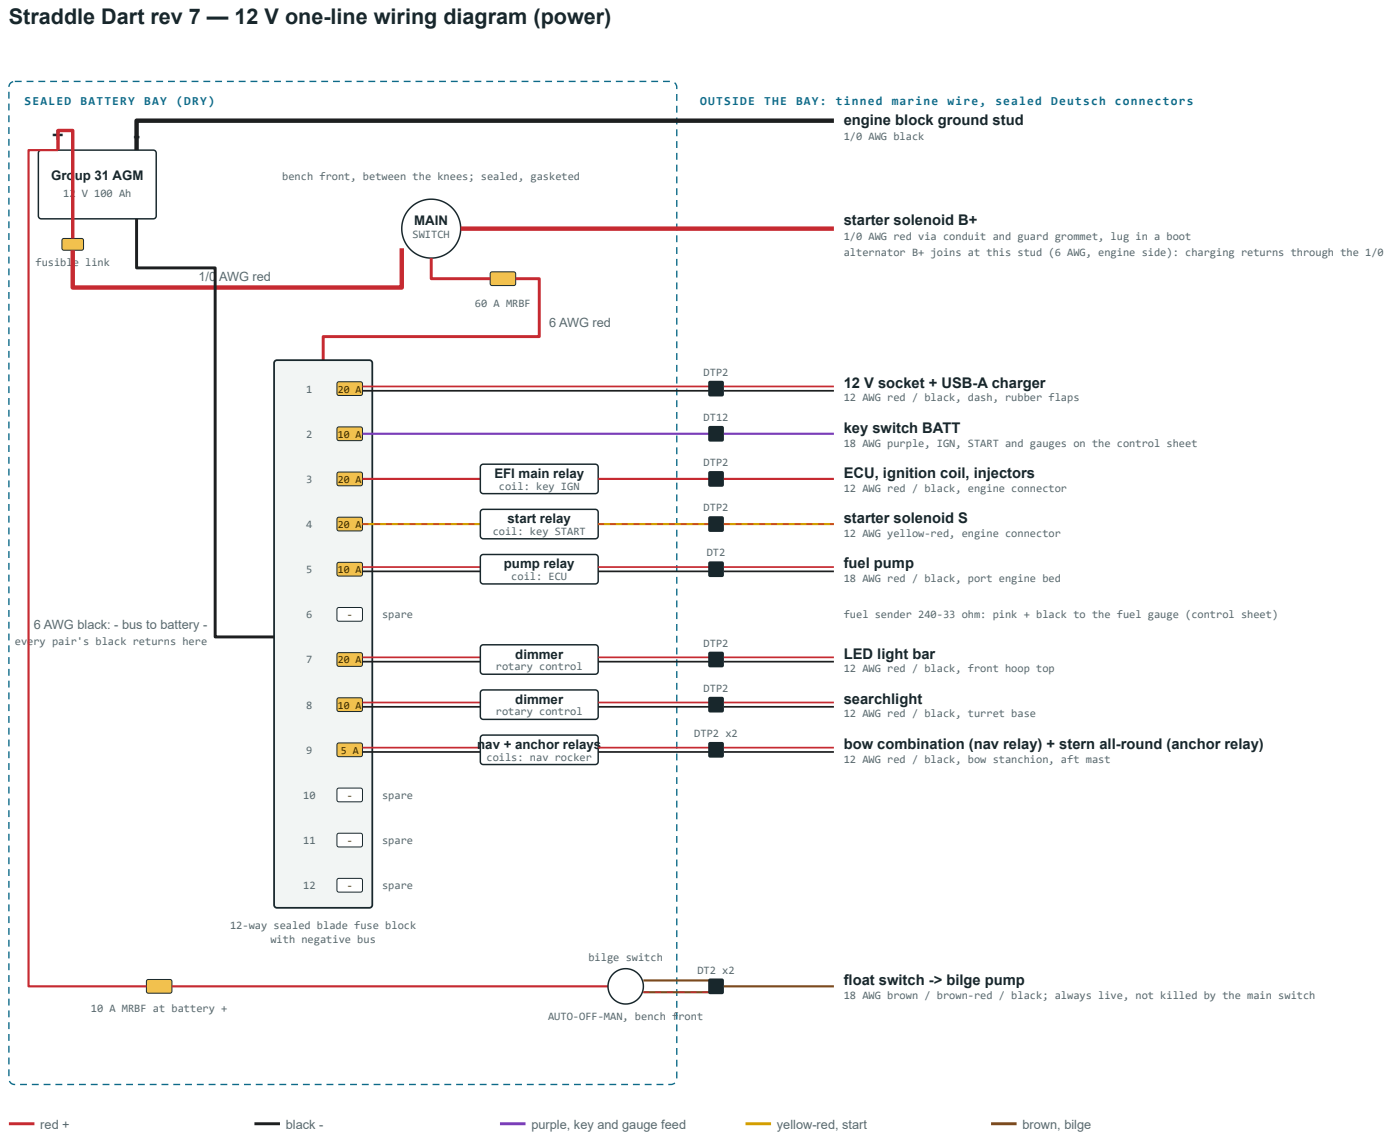
[picture p121: page 1]
SEALED BATTERY BAY (DRY); OUTSIDE THE BAY: tinned marine wire, sealed Deutsch connectors; fusible link; 1/0 AWG red; MAIN; SWITCH; 60 A MRBF; 6 AWG red; DTP2; EFI main relay; pump relay; coil: ECU; spare; dimmer; rotary control; nav + anchor relays; DTP2 x2; bilge switch; red +; black -; purple, key and gauge feed; yellow-red, start; brown, bilge

engine block ground stud
1/0 AWG black

bench front, between the knees; sealed, gasketed

starter solenoid B+
1/0 AWG red via conduit and guard grommet, lug in a boot
alternator B+ joins at this stud (6 AWG, engine side): charging returns through the 1/0

12 V socket + USB-A charger
12 AWG red / black, dash, rubber flaps
key switch BATT
18 AWG purple, IGN, START and gauges on the control sheet
ECU, ignition coil, injectors
12 AWG red / black, engine connector
starter solenoid S
12 AWG yellow-red, engine connector
fuel pump
18 AWG red / black, port engine bed

coil: key IGN

start relay
coil: key START

fuel sender 240-33 ohm: pink + black to the fuel gauge (control sheet)

6 AWG black: - bus to battery -
every pair's black returns here

LED light bar
12 AWG red / black, front hoop top
searchlight
12 AWG red / black, turret base
bow combination (nav relay) + stern all-round (anchor relay)
12 AWG red / black, bow stanchion, aft mast

coils: nav rocker

12-way sealed blade fuse block

with negative bus

float switch -> bilge pump
18 AWG brown / brown-red / black; always live, not killed by the main switch

10 A MRBF at battery +

AUTO-OFF-MAN, bench front
