acappon/DIY-MiniAirboat/(commit log)

2026-10-27 Start Git history with rev 6, after adding sufficient detail for manufacturing and assembly
    [A_frame_foot_1-4.dxf, A_frame_foot_gussets_1-4.dxf, A_frame_leg_cap_1-8.dxf, A_frame_peak_plate_3-8.dxf, DIY-Mini-Airboat_BOM_Aluminum.xlsx, DIY-Mini-Airboat_Build-Guide_Aluminum.xlsx, DIY-Mini-Airboat_COMPLETE_assembly_r6.step, DIY-Mini-Airboat_Fabrication_r6.xlsx]
2026-10-30 Archived Stitch and Glue design as rev0
    [A_frame_foot_1-4.dxf, A_frame_foot_gussets_1-4.dxf, A_frame_leg_cap_1-8.dxf, A_frame_peak_plate_3-8.dxf, DIY-Mini-Airboat_BOM_Aluminum.xlsx, DIY-Mini-Airboat_Build-Guide_Aluminum.xlsx, DIY-Mini-Airboat_COMPLETE_assembly_r6.step, DIY-Mini-Airboat_Fabrication_r6.xlsx]
2026-10-30 rev7 Aluminum Hull, Fusion project, with a LOT of help from Claude desktop Unlike the STEP files from rev0, this is a real CAD drawing with parts that can be edited. Moving parts are mated to show mo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
    [Airboat_rev7.f3d, Airboat_rev7_complete.step, BOM_rev7.xlsx, Build_Guide_rev7.xlsx, cage.step, drivetrain.step, flotation.step, hull.step]
2026-10-31 ENgineering analysis for structure, floatation, and stability
    [Airboat_rev7.f3d, Airboat_rev7_complete.step, BOM_rev7.xlsx, Build_Guide_rev7.xlsx, cage.step, drivetrain.step, flotation.step, hull.step]
2026-11-01 initial version
    [Build_Ledger_rev7.xlsx]
2026-11-01 Rename project folder to StraddleDart_rev7
    [BOM_rev7.xlsx, Build_Guide_rev7.xlsx, Build_Ledger_rev7.xlsx, cage.step, drivetrain.step, flotation.step, hull.step, layout.step]
2026-11-01 Initial version as 'Straddle Dart'
    [StraddleDart_rev7_Cage_and_rudders.f3d, StraddleDart_rev7_Drivetrain.f3d, StraddleDart_rev7_Flotation.f3d, StraddleDart_rev7_Hull.f3d, StraddleDart_rev7_Layout.f3d, StraddleDart_rev7_Render_people.f3d, StraddleDart_rev7_complete.step]
2026-11-01 Update electrical schematic to include sensors and key switch
2026-11-01 Gauge lights, Hurst T-handle grip, dash detail scripts and cost update
    - Wiring: gauge lamps lit from the NAV rocker or a second pole on the
    light bar rotary through two 1N5408 diodes, all inside the dash
    (schematic page, control SVG and PDF).
    - Grip: real Hurst 1530040 T-handle on an M16 x 1.5 stud with a 316
    nylon-insert lock nut and 1/4 in cross pin, rated 450 lb at the handle;
    four new checks in structure.py / Structural_Checks (stick and frame
    still 600 lb). BOM, build guide, ledger, README and Getting Started.
    - BOM: 2-pole light bar rotary, 13th wire colour, 4 diodes, T-handle.
    - Marketing: cost figures and calculator match the BOM.
    - Fusion scripts: WhiteGauges fixes, Gauge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
    [BOM_rev7.xlsx, Build_Guide_rev7.xlsx, Build_Ledger_rev7.xlsx]
2026-11-02 Version 1.0.0.1
    [Airboat Build Tracker v1.0.0.1.xlsx, Airboat_v1.0.0.1_Assembly.step, Airboat_v1.0.0.1_Hull_and_armor.step]
2026-11-02 Version 1.0.0.2
    [Airboat Build Tracker v1.0.0.1.xlsx, Airboat Build Tracker v1.0.0.2.xlsx, Airboat_v1.0.0.1_Assembly.step, Airboat_v1.0.0.2_Assembly.step, Airboat_v1.0.0.2_Cage_and_rudders.step, Airboat_v1.0.0.2_Drivetrain_mounts.step, Airboat_v1.0.0.2_Hull_and_armor.step]
2026-11-03 Minimal 1448 concept study; start v1.0.0.4
    Every earlier variant kept the same heavy outfit (car engine, redrive,
    A-frame, full cage and armor, cockpit boxes), about 973 lb on the 1652.
    This study keeps the 1448's benches and uses a light engine on a stand,
    a smaller cage, a simple cockpit and thin armor: 365-450 lb of equipment
    and 375-460 lb of payload under the 825 lb plate.
    - Rotax 582 + gearbox: ~30 mph solo, ~28 mph with a passenger, ~$9,500
    - 1000 cc bike engine + belt reduction: ~38 mph any load, ~$10,750
    - New minimal_1448.js (hull and planing functions from compare_hulls.js)
    - VERSION file added at 1.0.0.4; v1.0.0.4 release notes started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
2026-11-03 Minimal 1448: choose the 1000 cc bike engine; v1.0.0.4 tracker
    New tracker v1.0.0.4 from v1.0.0.2: bike engine, belt reduction, prop,
    radiator, exhaust, EFI fuel pump and small battery lines; chine angles,
    bow skin and deck ports set to qty 0; cage, rudders, seat and lights
    added. BOM about $11,100. Build Guide marks 1.3/1.4 out and notes that
    Section 2 still describes the G13 module.
    [Airboat Build Tracker v1.0.0.4.xlsx]
2026-11-03 Bike engine stand and belt reduction: first design
    Gearbox locked in 4th, 14MGT 30T/47T belt, 1-1/2 in 4140 prop shaft,
    66 in 3-blade prop at ~2,600 rpm (tip Mach 0.67), prop axis Z 52 on a
    bolted 6061 stand. Belt pull ~1,315 lbf is under the bike's own 1st-gear
    chain pull. Engine system and stand ~255 lb (+30 lb over the study), so
    payload falls to ~345 lb. Open: start-up without a clutch, primary
    ratio, belt width (Gates DesignFlex), thrust bearing, prop choice.
2026-11-03 Keep the bike clutch: hand lever on the steering stick
    Lever with a parking lock and the clutch start switch, long custom
    cable with a slack loop at the stick pivot. Start with the lever locked
    in, warm up with the prop stopped, release at idle. Side-stand switch
    jumpered, tip-over sensor kept. New BOM line 47 (about $90).
    [Airboat Build Tracker v1.0.0.4.xlsx]
2026-11-03 Prop shaft thrust bearing: tapered-roller flange unit forward
    Straddle mount: UCF208-24 ball unit aft (X 8), belt pulley (X 13),
    4-bolt tapered-roller flange unit forward (X 20, Dodge F4B-E-108R class)
    carrying the ~580 lbf thrust through heavy-duty clamp collars. L10
    ~2,500 h at full static thrust, ~9,600 h at cruise. Forward bearing
    plate 1/2 in 6061. +7 lb (payload ~338 lb); BOM line 31 ~$850.
    [Airboat Build Tracker v1.0.0.4.xlsx]
2026-11-03 Choose the prop: Whirlwind CarbonMax 68, 3-blade, 66 in
    Max 3,150 rpm (range 2,500-3,150), so the ~2,600 rpm design point has
    550 rpm of margin; tip Mach 0.67 (0.81 at max). Adjustable pitch sets
    engine rpm. 66 in keeps ~4 in over the transom top. Keyed steel 6-bolt
    4.750 in / 2.260 in pilot flange. BOM line 32 ~$2,050 (Warp Drive
    ~$800-1,000 as the budget alternative); BOM total ~$12,600.
    [Airboat Build Tracker v1.0.0.4.xlsx]
2026-11-03 Switch the prop to Warp Drive 3-blade with HP blades, 66 in
    $1,275 (the standard-blade kit is only for engines under 120 hp), plus
    an SAE #2 face plate and keyed flange: BOM line 32 ~$1,625, BOM total
    ~$12,150. Warp Drive publishes no max rpm: confirm it before ordering.
    Whirlwind CarbonMax 68 (3,150 rpm max) kept as the fallback. Corrects
    the earlier $800-1,000 Warp Drive figure.
    [Airboat Build Tracker v1.0.0.4.xlsx]
2026-11-03 Build Guide 2.0: Choose your prop (3-blade standard, 4-blade quieter)
    Keep the Warp Drive 3-blade. The new step gives builders the 4-blade
    trade-off (about $435 more, about 3-4 dBA less prop noise at 50 ft,
    same thrust) and what to change: 52T large pulley, longer belt,
    clearance and load checks, pitch setting. Neither prop is expected to
    meet the California 75 dB(A) shoreline limit (estimated 79-84 dBA).
    [Airboat Build Tracker v1.0.0.4.xlsx]
2026-11-03 Adopt the Rotax 800R E-TEC for the minimal 1448
    One-stage 8MGT belt off the crank PTO (32T/94T, 2.94:1) to the existing
    1-1/2 in prop shaft, thrust bearing and Warp Drive 66 in prop, about
    120 hp at the prop. No gearbox or clutch. UHMW trimmed to the wear
    zones (45 -> 35 lb), so payload is 402 lb and both load cases fit the
    825 lb plate at about 35 mph.
    - Drivetrain_800R_ETEC.md and etec_reduction.js: belt, PTO side load,
    shaft, bearings, fuel, systems, layout, weight
    - Tracker: engine, reduction, prop, radiator, exhaust, fuel, throttle,
    clutch lines; UHMW line and Build Guide 1.2 and 2.0
    - Study, selection report and release notes updated; the GSX-R1000
    stand note and calc moved to a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
    [Airboat Build Tracker v1.0.0.4.xlsx]
2026-11-03 Exhaust layout for the 800R E-TEC
    Stock tuned pipe and silencer, unmodified, above and beside the engine
    near the prop hub; space reserved for an optional low-restriction
    second muffler, decided by static-test sound readings; heat shields at
    the belt and bearings; tailpipe over an aft transom corner, never into
    the prop. Tracker exhaust line and a sound meter added. The extra 5 lb
    leaves driver + passenger 3 lb over the plate; offset still to choose.
    [Airboat Build Tracker v1.0.0.4.xlsx]
2026-11-03 Budget the missing outfit items and cage-top lights
    Adds about 23 lb of allowances the concept study left out (dash and
    gauges, wiring, belt guard, radiator brackets, loose fasteners, bilge
    pump, passenger cushion) and about 20 lb for an LED light bar and a
    motorized searchlight on the prop cage. Payload is now about 354 lb:
    driver + 150 lb gear fits by 4 lb, driver + passenger is 46 lb over.
    New BOM lines 48-49; BOM total about $12,990.
    [Airboat Build Tracker v1.0.0.4.xlsx]
2026-11-03 Itemize safety and regulatory gear: Florida flag, B-I extinguisher, air horn
    The 15 lb safety line becomes PFDs and lines, a B-I / 5-B extinguisher
    near the fuel tank within the driver's reach, an air horn at the
    driver, and a 10 ft Florida airboat flag on the aft side of the cage
    (+2 lb net). New BOM lines 50-52; BOM total about $13,185. Payload is
    352 lb: driver + 150 lb gear fits by 2 lb, driver + passenger is 48 lb
    over.
    [Airboat Build Tracker v1.0.0.4.xlsx]
2026-11-03 Drop the passenger requirement: design case is driver + 150 lb gear
    With the full outfit the 1448 can't carry two 200 lb people under the
    825 lb plate, so the design case is now the driver + 150 lb of gear:
    payload 352 lb against 350 lb needed (about 2 lb margin), about
    34 mph, easy planing. Requirements, design note, release notes and the
    model's engine budget sweep updated.
2026-11-04 First CAD layout of the 800R E-TEC on the minimal 1448
    Add the provisional layout built in the Onshape workspace "Minimal 1448":
    engine, belt, shaft, prop, stand, exhaust, radiator, UHMW strips, and a
    proposed cage with struts to the stand. Engine and exhaust parts are
    placeholder envelopes.
    Trim the stand to 45 lb with a first load and vibration check, add heat
    shields and stand cross-straps, and itemize the exhaust at 7 lb. Correct
    the UHMW allowance to 32 lb from the modeled strips and remove the
    passenger cushion and grab handle. Payload is about 354.5 lb, about 4.5 lb
    of margin with the driver and 150 lb of gear.
2026-11-04 Lean hull mounts: stand on four shoes, cage feet on the bench and corner caps
    The first layout clashed with the rear bench and the rib at X 37.75. The
    stand now sits on four shoes instead of two beds, with the rail raised to
    Z 14.9, so the bench is not cut. Hull fastening is counted at 7.6 lb and
    the stand drops to 41.5 lb: payload 350.4 lb, about +0.4 lb of margin.
    Update BOM lines 17-23 for the new parts (total about $13,172), add
    Section 9b to the drivetrain report, and record the Onshape merge of
    Minimal 1448 into Main and the release condition in the notes.
    [Airboat Build Tracker v1.0.0.4.xlsx]
2026-11-04 Cockpit: driver on the middle bench, dry box, stick, pedal, console, deck tank
    Seat the driver alone on the factory middle bench and remove the raised
    seat. Add a dry box in the bench with the battery and fuse block, a stick
    to port, a throttle pedal with heel rests, a console to starboard clear
    above two sets of knees, and the fuel tank with a gauge sender on the
    front deck step.
    Payload is 357.4 lb, about +7.4 lb of margin, and solo dock trim is about
    0.94 deg. Gear now stows between the benches in the design case. BOM total
    is about $13,402, with new lines 57-61. See Drivetrain report Section 9c.
    [Airboat Build Tracker v1.0.0.4.xlsx]
2026-11-04 Steering and throttle controls: rudder linkage, pedal crank, cable routes
    Add rudder shafts and supports, horns, a tie bar and a cable arm, so the
    stick drives both rudders (stick forward turns left), plus the pedal crank
    and cable stops. Reroute both push-pull cables. Add a first load check;
    about 12 lbf at the grip at full power. No change to the weight model,
    margin stays about +7.4 lb. See Drivetrain report Section 9d.
    [Airboat Build Tracker v1.0.0.4.xlsx]
2026-11-04 Name the Onshape Main assembly tab in the reports
    The tab is now "Main assembly", the place to start. Assembly 1 is gone
    from Main; versions v1.0.0.2 and v1.0.0.3 keep their copies.
2026-11-04 Refresh the controls render with the hull in Main assembly
    The hull, benches, front deck, fittings and rivets were missing from the
    assembly. They are now in, so the render shows the whole boat.
2026-11-04 Bring the minimal 1448 study to main; v1.0.0.4 releases from main
    The minimal 1448 bike-engine work (study/minimal-1448) is now on main,
    where the 1448 hull line lives. VERSION is 1.0.0.4, so the next release
    comes from main. Release notes and the study and stand notes now name
    main as their branch.
2026-11-04 Dash panel: gauges, switches, power ports and a tablet holder
    Lay out the panel in the user's order: USB port, gas, tach and temperature
    on top; kill switch, searchlight joystick and switch, lights switch, key
    switch and 12 V outlet below; a marine tablet holder on the left side.
    Move the pod from the cockpit source to Minimal_dash.fs and drop the
    exhaust temperature gauge.
    Payload is 355.1 lb, about +5.1 lb of margin. BOM total is about $13,692,
    with new lines 62-64. See Drivetrain report Section 9e.
    [Airboat Build Tracker v1.0.0.4.xlsx]
2026-11-04 Move earlier designs and the v1.0.0.2 tracker to archive/
    rev0_StitchAndGlue, StraddleDart_rev7 and the superseded v1.0.0.2
    build tracker are not part of the v1.0.0.4 release, so they move to
    archive/ with a README. The v1.0.0.2 CAD, renders and release notes
    stay as the baseline. The tracker and release notes now say the work
    is on main.
    [A_frame_foot_1-4.dxf, A_frame_foot_gussets_1-4.dxf, A_frame_leg_cap_1-8.dxf, A_frame_peak_plate_3-8.dxf, Airboat Build Tracker v1.0.0.2.xlsx, Airboat Build Tracker v1.0.0.4.xlsx, BOM_rev7.xlsx, Build_Guide_rev7.xlsx]
2026-11-04 Reopen the 1448 engine choice: requirements and engine budget
    New requirements: driver + 150 lb gear or driver + passenger within the
    825 lb plate, planes easily, at least 33 mph. The GSX-R1000 build is
    62 lb over with a passenger. The model now reports pounds over the
    plate and sweeps engine weight against power: about 110 hp at the prop
    from an engine system of 160 lb or less. Engine_Selection_1448.md lists
    the candidates; snowmobile two-strokes lead, pending real weights.
2026-11-04 Engine research: Rotax 800R E-TEC leads for the minimal 1448
    Bare snowmobile engine weights (unverified) and used prices, run
    through the model with the same belt, shaft and bearing allowance as
    the bike design. The 800R E-TEC (about 168 lb installed, 120 hp at the
    prop) gives about 35 mph in both load cases and 392 lb of payload, so
    it needs an 8 lb outfit trim. The 600s fall short on speed, the 850 on
    payload. Added to minimal_1448.js; report and release notes updated.
2026-11-04 Electrical plan: wire list, schematic PDF and wires in CAD
    Generate the schematic, wire table and CAD wiring from one file,
    electrical/wire_list.py: 56 wires, with chassis ground only inside the
    engine and red/black pairs from the hub. The LED bar and fuel pump join
    the 12 V outlet on 12 AWG. Engine-side items are marked to confirm from
    the service manual.
    Also finish the dash: exhaust gauge, lanyard kill, rotary lights switch,
    key marks, weather flaps and an adjustable phone or tablet holder.
    Payload is 355.5 lb, about +5.5 lb of margin. BOM total is about $14,460,
    with new lines 65-75. See Drivetrain report Sections 9e and 9f.
    [Airboat Build Tracker v1.0.0.4.xlsx, Wire_List.csv]
2026-11-04 Fresh v1.0.0.4 renders and partial STEP export
    Re-render the build steps stage by stage on white backgrounds and add
    step 2.11. Replace the v1.0.0.2 scenes with dock, underway and snake
    hunt, each with and without crew, plus two shots with a passenger.
    Refresh the studio and transparent views and add the driver's-eye dash.
    Add the STEP exports done so far. The wiring STEP is still to come.
    [Airboat_v1.0.0.4_Assembly.step, Airboat_v1.0.0.4_Cockpit.step, Airboat_v1.0.0.4_Controls.step, Airboat_v1.0.0.4_Dash.step, Airboat_v1.0.0.4_Stand_engine_cage.step]
2026-11-04 Release v1.0.0.4
    Add the wiring STEP, date the tracker and release notes, list the
    package contents, and move the open items to a carried-forward list.
    [Airboat Build Tracker v1.0.0.4.xlsx, Airboat_v1.0.0.4_Wiring.step]
2026-11-04 Start v1.0.0.5: bump VERSION, new tracker and release notes
    [Airboat Build Tracker v1.0.0.5.xlsx]
2026-11-04 Release v1.0.1.0: first beta
    Minimal 1448 with the Rotax 800R E-TEC on a belt reduction, not yet
    built or tested.
    - Removable grab rail and sling backrest, petal bearing plates
    - Electrical plan brought to ABYC E-11, with E-11 wire colors
    - Build Guide rewritten for this build, with new step images
    - Capsize flotation foam: bow wedge and two aft corner blocks
    - Structural review: stronger stick, pedal and console frame
    - New structural, stability, flotation and electrical reports
    - Older reports, tracker and STEP files moved to reports/archive
    [Airboat Build Tracker v1.0.0.4.xlsx, Airboat Build Tracker v1.0.0.5.xlsx, Airboat Build Tracker v1.0.1.0.xlsx, Airboat_v1.0.0.2_Assembly.step, Airboat_v1.0.0.2_Cage_and_rudders.step, Airboat_v1.0.0.2_Drivetrain_mounts.step, Airboat_v1.0.0.2_Hull_and_armor.step, Airboat_v1.0.0.4_Assembly.step]
2026-11-04 Remove superseded trackers and STEP files
    Keep only what is still useful: previous release notes and the two
    early design studies stay in reports/archive, and the earlier boats
    stay in archive.
    [Airboat Build Tracker v1.0.0.2.xlsx, Airboat Build Tracker v1.0.0.4.xlsx, Airboat_v1.0.0.2_Assembly.step, Airboat_v1.0.0.2_Cage_and_rudders.step, Airboat_v1.0.0.2_Drivetrain_mounts.step, Airboat_v1.0.0.2_Hull_and_armor.step, Airboat_v1.0.0.4_Assembly.step, Airboat_v1.0.0.4_Cockpit.step]
2026-11-04 Release v1.0.1.1: second beta
    Bubble level and 395 lb load label on the dash. UHMW is now 1/8 in over
    the whole bottom in place of the 3/16 in strips. Build steps, renders,
    scenes, reports and tracker updated. Steps 1.3 and 1.4 cleared. Equipment
    is 471.9 lb, margin +3.1 lb with driver and 150 lb of gear.
    [Airboat Build Tracker v1.0.1.0.xlsx, Airboat Build Tracker v1.0.1.1.xlsx, Airboat_v1.0.1.0_Assembly.step, Airboat_v1.0.1.0_Dash.step, Airboat_v1.0.1.0_Stand_engine_cage.step, Airboat_v1.0.1.1_Assembly.step, Airboat_v1.0.1.1_Cockpit.step, Airboat_v1.0.1.1_Controls.step]
2026-11-04 Release v1.0.1.2: third beta
    Tracker lines now split into material and labor, with names for who
    pledged, paid or did the work. BOM gains a pledged / paid by column.
    Build Guide steps open with a one-row cost and hours table, with section
    totals and a summary in the intro. No CAD change from v1.0.1.1.
    [Airboat Build Tracker v1.0.1.1.xlsx, Airboat Build Tracker v1.0.1.2.xlsx, Airboat_v1.0.1.2_Assembly.step, Airboat_v1.0.1.2_Cockpit.step, Airboat_v1.0.1.2_Controls.step, Airboat_v1.0.1.2_Dash.step, Airboat_v1.0.1.2_Stand_engine_cage.step, Airboat_v1.0.1.2_Wiring.step]
2026-11-10 Start v1.0.1.3; seating redesign step 1: remove grab rail and sling
    Bump VERSION to 1.0.1.3 with a new tracker and release notes.
    Remove the removable grab rail and sling backrest and its four rib
    mounts: cockpit FeatureScript, weight model, structural check,
    grab_rail.js and its step image. Tracker: BOM line 79 and Build Guide
    step 2.16 deleted, later lines and the flotation step renumbered,
    formulas re-pointed. Equipment 471.9 -> 465.1 lb, payload margin
    +3.1 -> +9.9 lb, BOM $15,755 -> $15,280.
    [Airboat Build Tracker v1.0.1.3.xlsx]
2026-11-10 Seating redesign step 2: remove the middle bench (tracker)
    Build Guide 2.5 becomes "Remove the middle bench": measure fastenings and
    beam, temporary gunwale spreader until the new struts are in, drill out
    rivets, lift the bench out with its foam, seal every hole with closed-end
    rivets. 2.1 no longer relies on the middle bench foam. New BOM line 83
    (closed-end rivets and spreader, ~$25). Dry box, battery switch and
    harness sleeve left for step 3. CAD change to follow with the Onshape
    update.
    [Airboat Build Tracker v1.0.1.3.xlsx]
2026-11-11 Seating redesign steps 3-4: seat module, footwell flotation, load label
    Seat module where the middle bench was (Minimal_cockpit.fs): two 1x2x1/8
    struts hull side to hull side at the old bench-top level, a 0.063 5052
    electrical dry box hung between them (fuses under the lid), battery
    switch on the forward strut, dry storage each side with foam floors and
    aft-hinged lids, 3/8 ply + closed-cell foam seat for two bolted over the
    box, folding padded seatback at 12 deg on the aft strut.
    Flotation: the middle bench foam was most of the capsized lift; seat
    pad, compartment floors and 6 in footwell side blocks restore a level
    float (3.0 in clear, 169 lb reserve). Extinguisher onto the starboard
    bloc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
    [Airboat Build Tracker v1.0.1.3.xlsx]
2026-11-11 Seat module in Onshape; driver hip point X 83.5, Z 14
    Onshape Main workspace: cockpit FeatureScript uploaded (87 parts), middle
    bench deleted from the reference mesh, mannequin hip point moved so the
    back meets the seatback, Main assembly cockpit re-inserted and the 71
    old instances (18 dangling) deleted. Battery switch body kept in front
    of its plate; loop variables renamed. Models: driver at X 83.5 (dock
    trim 0.63 deg, GM 43.3 in). Dash label upload still pending.
2026-11-11 Oars: oarlocks on 4 in risers at X 66, oars shipped in the locks along the rails
    Rowing facing aft on the folded seatback with 7 ft oars; shipped blade forward on
    strapped rests at X 118, clear above the console arm. Clearance check in
    CAD/analysis/oars.js, weight/flotation/structural updated, load label 360/315,
    BOM lines 88-89, Build Guide step 2.18.
    [Airboat Build Tracker v1.0.1.3.xlsx]
2026-11-11 Weight pass: carbon seat struts and fiberglass/foam sandwich seat base
    Struts 8.7 -> 5.6 lb (glass-isolated, sleeved stainless fasteners, no
    aluminum rivets into carbon), seat base 4.3 -> 2.3 lb. Payload 323 lb,
    27 lb short; load label 365/320. Structural, flotation, BOM lines 84/86
    and step 2.17 updated.
    [Airboat Build Tracker v1.0.1.3.xlsx]
2026-11-11 Oars are operator gear, not boat equipment
    The oarlock hardware stays in equipment (4.0 lb); the 7.2 lb oars come out
    of the people-and-gear load. Payload 330 lb (20 lb short), load label 375/330.
    [Airboat Build Tracker v1.0.1.3.xlsx]
2026-11-11 Honeycomb rudder blades; rudder and controls allowances cut to 8.5 lb each
    Blades 4.4 -> 2.8 lb the pair. Allowances 12 -> 8.5 and 10 -> 8.5 lb (5 lb
    off, margin kept over 7.8 and 6.1 lb itemized); step 2.13 weighs both sets.
    Payload 335 lb (15 lb short), load label 380/335.
    [Airboat Build Tracker v1.0.1.3.xlsx]
2026-11-11 Flotation: count the folding seatback foam (SG 0.14, was 0.5)
    Capsized hull bottom 3.9 in clear (was 3.0), reserve 190 lb.
    [Airboat Build Tracker v1.0.1.3.xlsx]
2026-11-11 Design load: 200 lb operator + 135 lb gear (was 150 lb gear)
    Payload 335.1 lb meets it with 0.1 lb margin. Weight and stability models use
    135 lb of gear; capsize check keeps 200 lb as a conservative case.
2026-11-11 Close group-1 open items: wiring pass, Onshape uploads, assemblies, v1.0.1.3 reports
    Wiring rerouted for the seat-module dry box (forward gland, runs under the strut
    and seat base, switch on the strut plate); harness 12.4 lb, payload 334.9 lb,
    label 375/330. Cockpit, dash and wiring uploaded; Main assembly re-inserted
    (543 instances, none dangling); 20 dangling instances removed from Build steps.
    New stability, flotation, structural and electrical reports for v1.0.1.3.
    [Airboat Build Tracker v1.0.1.3.xlsx, Wire_List.csv]
2026-11-11 Dock lines are operator gear: payload 336.9 lb, label 380/335
    PFD line 6 -> 4 lb; reports, tracker and dash label updated; dash uploaded and
    re-inserted in the Main assembly.
    [Airboat Build Tracker v1.0.1.3.xlsx]
2026-11-11 Release v1.0.1.3: fourth beta
    Seat module (carbon struts, sandwich seat base, folding seatback), oarlocks with
    oars as operator gear, honeycomb rudders, wiring pass for the new dry box,
    design load 200 lb operator + 135 lb gear (payload 336.9 lb, label 380/335).
    Onshape version v1.0.1.3, STEP exports, five new concept scenes from a new
    Scene props studio, step images for 2.11/2.17/2.18, Build Guide and schematic
    PDFs regenerated, v1.0.1.2 reports archived.
    [Airboat Build Tracker v1.0.1.2.xlsx, Airboat Build Tracker v1.0.1.3.xlsx, Airboat_v1.0.1.2_Assembly.step, Airboat_v1.0.1.2_Cockpit.step, Airboat_v1.0.1.2_Dash.step, Airboat_v1.0.1.2_Wiring.step, Airboat_v1.0.1.3_Assembly.step, Airboat_v1.0.1.3_Cockpit.step]
